HB9GZE/PhasorRadio/Hilbert Filter Calculator/IowaHills/RunTime Files/Hilbert Filter Help.rtf

Note: This program has many Up Down Arrow buttons to modify the various input values, such as Omega and BandWidth. To increase the speed of these buttons, hold down the Control button.

This program uses the root solver code from www.akiti.ca who translated it to C from the Fortran code on www.netlib.org/toms/493. Thanks to both!

Introduction
The Hilbert filter program is essentially a program for designing specialty band pass filters. Band pass filters are different from low pass, high pass, and notch filters, in that the phase of a band pass isn't predetermined at zero and pi. The phase must be zero at 0 Hz for a low pass and notch, and the phase must be zero at pi for a high pass and notch (180 deg if these filters invert the signal). Only the band pass, which has a magnitude of zero at DC and pi, allows us to set its phase to any value in the pass band.

The key to using this program is to understand the phase plots. This program displays phase in two ways, the traditional phase, and Hilbert phase. Hilbert phase is discussed in more detail below, but the diagram here shows the essence of it. Hilbert Phase is the phase of the filter's output as compared to the output of a shift register with the same delay as the filter. For a constant group delay filter, the Hilbert phase will always be a flat line in the filter's pass band.

The Hilbert Phase of a Hilbert Transform filter will be a flat 90 degrees because it has 90 degrees more phase shift than the shift register at all frequencies within its pass band.

The types of band pass filters synthesized by this program are as follows:

Standard BPF
These are the same band pass filters as generated by the Iowa Hills FIR program. Note that the Hilbert phase of these filters is zero.

The user should take note of the zeros in the coefficients for odd tap counts when the center frequency is 0.125, 0.25, 0.5, 0.75 and similar such values. Note the zeros for even tap counts when the center frequency is 0.2 and 0.6.

Phase Added Band Pass
These filters are standard band pass filters, with additional phase added. When the user selects this filter type, the program automatically switches the phase display in the Options menu to Hilbert Phase. Use the Phase Adder to set the phase to the desired value.

If the user sets the Added Phase to 90 degrees, the filter is essentially a Hilbert Transform filter. The Classic Hilbert Transform filter is a full bandwidth filter, but these filters can be any bandwidth.

For example, to create a narrow band single side band filter, set the number of taps to an odd number, and the added phase to 90 degrees. Go to the Test Bench and select Single 90 Degree SSB. The filter will suppress a narrow band in the negative frequency spectrum.

Alternatively, the user can select Matched Pair SSB on the test bench. Then the filter is used as shown here. The program is automatically generating two filters when this test is run. One with the phase shown on the main screen, and another with 90 degrees less phase. The filters used in this scheme can have any absolute phase, as long as they have a 90 degree phase difference.

You should also notice that, because the filter gains are matched, the gain of the filter (or its pass band ripple) doesn't affect the SSB performance.

Classic Hilbert Filters
The Classic Hilbert transforms synthesized by this program are the usual full bandwidth filters with a 90 degree phase shift (Hilbert Phase = 90). This filter uses a rectangular window as its prototype, where as the rest of the filters use the Raised Cosine prototype.

Differentiator Filters
The Differentiator filter also has a 90 degree phase shift, but the slope of the filter increases with frequency at 6 dB per octave. If the user wants to see the linearity of this slope, go to the options menu and select Linear Magnitude.

Mixed Band Pass Filters
An easy way to generate a dual band pass response is to simply mix a set of band pass coefficients with a local oscillator. Use the Mixer Frequency to set the separation of the two responses.

Half and 3/4 Zeros Band Pass Filters.
Another way to generate multiple band pass responses is to simply insert zeros into the coefficients. As the name implies, Half Zeros makes every other coefficient zero to generate a dual response centered at pi/2.

Frequency Domain Prototype
Like all FIR filters, these filters are based on a frequency domain prototype. This program uses the Raised Cosine prototype for all filters except the Classic Hilbert, which uses a rectangular window.

Time Domain Windows
This program has two time domain windows, the Sinc and Kaiser. The Kaiser is well documented and well known to engineers. Surprisingly however, little is said in textbooks of the Sinc window. The Sinc function would, at least intuitively, seem like the perfect window shape, and you will see that it works very well.

Hilbert Phase
This program has two ways to display phase, the traditional phase, and Hilbert Phase. Hilbert phase has nothing to do with the Hilbert Transform. It is the phase, adjusted for delay, which is the method typically used to display the phase characteristics of a Hilbert transform filter.

We have all seen the usual phase plots, and then ignored them, simply because it is virtually impossible to glean any useful information from them. As a result, we have been paying more attention to group delay plots which tell us how linear the phase is, and how long it takes for a signal to get through the device. Unfortunately however, group delay has units of time, not phase.

The Hilbert phase has units of phase. It is useful for showing us how many degrees the phase is varying from perfect linear phase across the band of interest. Like the gain of a device, we typically want the Hilbert phase to be flat in the pass band. It needs to be stressed that the Hilbert phase is not an absolute value, it is a relative value referenced to a specific phase at some point in the pass band. Then, any change in the linearity of the phase can be readily seen, and the deviation from perfect linearity is measured in units of phase.

When working with a traditional FIR filter, which is to say, a filter with a constant group delay, the Hilbert Phase will be a flat line at 0 degrees, indicating zero deviation from linear phase.

Hilbert filters also have linear phase, which explains why their Hilbert Phase is a flat line. Hilbert filters however, have an additional amount of phase shift in their pass band. Which is to say, they have more or less phase shift than a shift register of length equal to the filter's group delay. This additional amount of phase shift explains the level of Hilbert Phase.

To calculate Hilbert Phase we multiply H(s) by a time delay, as defined by this Laplace transform.

We set '-a' to the minimum group delay value in the filter's pass band. For a low pass filter, this is the group delay at 0. For a band pass filter, it is typically the group delay at band center. Removing this amount of delay has the effect of moving the filter's impulse backwards in time, and flattening the phase, as shown here. Or said a bit differently, it sets the filter's group delay to zero in the pass band.

In this first example, we show the impulse response and phase for an FIR filter. Applying the Laplace time delay to H(z) with '-a' equal to the filters group delay centers the impulse response around t = 0. Since this filter's phase is linear, the filter's Hilbert phase is a flat line.

In this example we use an Inverse Chebyshev low pass filter. Its group delay is much less than the FIR filter shown above, so the impulse response moves backwards in time less. The original phase is not linear and the Hilbert phase shows us the amount of non linearity.

As an alternative to the Hilbert phase, we can show this filter's unwrapped phase and draw a straight line to determine the amount of non linearity. The difference between the straight line and the unwrapped phase is the same as the Hilbert Phase plot.

Markers and Limit Lines
Frequency markers can be added to the plot by using the right mouse or by entering the frequency value under "Plot Options | Marker Menu" The marker can also be dragged to a new location with the mouse.

Limit Lines can also be plotted. Each line segment requires 4 values to be plotted. As such, the line segment may be defined in any order, and the upper and lower frequency values may be reversed.

The dB levels are restricted to the range of the plot; -90 dB to +10 dB.

The Marker and Limit Line definitions are saved with the design file. Also note that these definitions are swapped when doing an "Exchange Reference".
