HB9GZE/PhasorRadio/CustomSTM32H735Board/KiCADFiles/CustomSTM32H735_V2_1_Board/CustomSTM32H735_V2_1_Board/NetReport.csv

Net Code | Net Name | Pad Count | Via Count | Via Length (mm) | Track Length (mm) | Die Length (mm) | Net Length (mm) | F.Cu (mm) | In1.Cu (mm) | In2.Cu (mm) | In3.Cu (mm) | In4.Cu (mm) | B.Cu (mm)
001 | Net-(PS1-REF) | 2 | 0 | 0.0000 | 6.7280 | 0.0000 | 6.7280 | 6.7280 | 0.0000 | 0.0000 | 0.0000 | 0.0000 | 0.0000
002 | Net-(PS1-COMP) | 2 | 0 | 0.0000 | 4.4959 | 0.0000 | 4.4959 | 4.4959 | 0.0000 | 0.0000 | 0.0000 | 0.0000 | 0.0000
003 | /PG6 | 3 | 2 | 1.6290 | 26.3761 | 0.0000 | 28.0051 | 0.0000 | 0.0000 | 15.8914 | 0.0000 | 0.0000 | 10.4847
004 | Net-(IC1-BYP) | 2 | 0 | 0.0000 | 3.0452 | 0.0000 | 3.0452 | 3.0452 | 0.0000 | 0.0000 | 0.0000 | 0.0000 | 0.0000
005 | Net-(C23-Pad2) | 2 | 0 | 0.0000 | 5.9836 | 0.0000 | 5.9836 | 5.9836 | 0.0000 | 0.0000 | 0.0000 | 0.0000 | 0.0000
006 | Net-(U2A-OUT) | 4 | 0 | 0.0000 | 19.4786 | 0.0000 | 19.4786 | 19.4786 | 0.0000 | 0.0000 | 0.0000 | 0.0000 | 0.0000
007 | Net-(JDAC1-Pin_2) | 2 | 0 | 0.0000 | 9.3643 | 0.0000 | 9.3643 | 9.3643 | 0.0000 | 0.0000 | 0.0000 | 0.0000 | 0.0000
008 | /NRST | 10 | 5 | 3.8025 | 181.3871 | 0.0000 | 185.1896 | 1.0272 | 0.0000 | 22.6133 | 23.9160 | 62.2607 | 71.5699
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
