HB9GZE/PhasorRadio/CustomSTM32H735Board/CustomSTM32H735TestCode/CustomBoardSTM32H735Test/STM32H735G-DK.pdf

13/08/2024

STM32H735G-DK Project
Configuration Report

## 1. Description

### 1.1. Project

Project Name | STM32H735G-DK
Board Name | custom
Generated with: | STM32CubeMX 6.12.0
Date | 08/13/2024

### 1.2. MCU

MCU Series | STM32H7
MCU Line | STM32H725/735
MCU name | STM32H735IGKx
MCU Package | UFBGA176
MCU Pin number | 201

### 1.3. Core(s) information

Core(s) | Arm Cortex-M7

## 2. Pinout Configuration

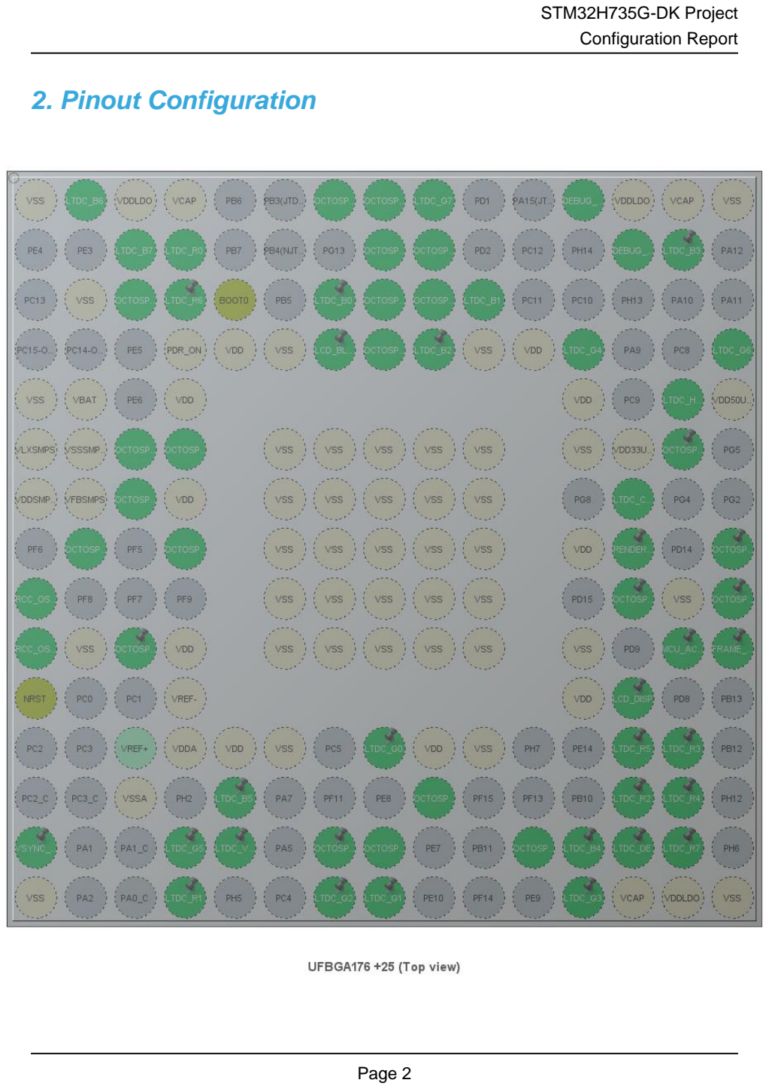
[picture p6: page 3]

## 3. Pins Configuration

Pin Number UFBGA176 | Pin Name (function after reset) | Pin Type | Alternate Function(s) | Label
A1 | VSS | Power
A2 | PB8 | I/O | LTDC_B6
A3 | VDDLDO | Power
A4 | VCAP | Power
A7 | PG11 | I/O | OCTOSPIM_P2_IO7
A8 | PG9 | I/O | OCTOSPIM_P1_IO6
A9 | PD3 | I/O | LTDC_G7
A12 | PA14(JTCK/SWCLK) | I/O | DEBUG_JTCK-SWCLK
A13 | VDDLDO | Power
A14 | VCAP | Power
A15 | VSS | Power
B3 | PB9 | I/O | LTDC_B7
B4 | PE0 | I/O | LTDC_R0
B8 | PD7 | I/O | OCTOSPIM_P1_IO7
B9 | PD5 | I/O | OCTOSPIM_P1_IO5
B13 | PA13(JTMS/SWDIO) | I/O | DEBUG_JTMS-SWDIO
B14 | PA8 | I/O | LTDC_B3
C2 | VSS | Power
C3 | PE2 | I/O | OCTOSPIM_P1_IO2
C4 | PE1 | I/O | LTDC_R6
C5 | BOOT0 | Boot
C7 | PG14 | I/O | LTDC_B0
C8 | PG10 | I/O | OCTOSPIM_P2_IO6
C9 | PD4 | I/O | OCTOSPIM_P1_IO4
C10 | PD0 | I/O | LTDC_B1
D4 | PDR_ON | Power
D5 | VDD | Power
D6 | VSS | Power
D7 | PG15 * | I/O | GPIO_Output | LCD_BL_CTRL
D8 | PG12 | I/O | OCTOSPIM_P2_NCS
D9 | PD6 | I/O | LTDC_B2
D10 | VSS | Power
D11 | VDD | Power
D12 | PH15 | I/O | LTDC_G4
D15 | PC7 | I/O | LTDC_G6
E1 | VSS | Power

Pin Number UFBGA176 | Pin Name (function after reset) | Pin Type | Alternate Function(s) | Label
E2 | VBAT | Power
E4 | VDD | Power
E12 | VDD | Power
E14 | PC6 | I/O | LTDC_HSYNC
E15 | VDD50USB | Power
F1 | VLXSMPS | Power
F2 | VSSSMPS | Power
F3 | PF1 | I/O | OCTOSPIM_P2_IO1
F4 | PF0 | I/O | OCTOSPIM_P2_IO0
F6 | VSS | Power
F7 | VSS | Power
F8 | VSS | Power
F9 | VSS | Power
F10 | VSS | Power
F12 | VSS | Power
F13 | VDD33USB | Power
F14 | PG6 | I/O | OCTOSPIM_P1_NCS
G1 | VDDSMPS | Power
G2 | VFBSMPS | Power
G3 | PF2 | I/O | OCTOSPIM_P2_IO2
G4 | VDD | Power
G6 | VSS | Power
G7 | VSS | Power
G8 | VSS | Power
G9 | VSS | Power
G10 | VSS | Power
G13 | PG7 | I/O | LTDC_CLK
H2 | PF4 | I/O | OCTOSPIM_P2_CLK
H4 | PF3 | I/O | OCTOSPIM_P2_IO3
H6 | VSS | Power
H7 | VSS | Power
H8 | VSS | Power
H9 | VSS | Power
H10 | VSS | Power
H12 | VDD | Power
H13 | PG3 * | I/O | GPIO_Output | RENDER_TIME
H15 | PD13 | I/O | OCTOSPIM_P1_IO3
J1 | PH0-OSC_IN | I/O | RCC_OSC_IN
J6 | VSS | Power

Pin Number UFBGA176 | Pin Name (function after reset) | Pin Type | Alternate Function(s) | Label
J7 | VSS | Power
J8 | VSS | Power
J9 | VSS | Power
J10 | VSS | Power
J13 | PD11 | I/O | OCTOSPIM_P1_IO0
J14 | VSS | Power
J15 | PD12 | I/O | OCTOSPIM_P1_IO1
K1 | PH1-OSC_OUT | I/O | RCC_OSC_OUT
K2 | VSS | Power
K3 | PF10 | I/O | OCTOSPIM_P1_CLK
K4 | VDD | Power
K6 | VSS | Power
K7 | VSS | Power
K8 | VSS | Power
K9 | VSS | Power
K10 | VSS | Power
K12 | VSS | Power
K14 | PB15 * | I/O | GPIO_Output | MCU_ACTIVE
K15 | PB14 * | I/O | GPIO_Output | FRAME_RATE
L1 | NRST | Reset
L4 | VREF- | Power
L12 | VDD | Power
L13 | PD10 * | I/O | GPIO_Output | LCD_DISP
M4 | VDDA | Power
M5 | VDD | Power
M6 | VSS | Power
M8 | PB1 | I/O | LTDC_G0
M9 | VDD | Power
M10 | VSS | Power
M13 | PH11 | I/O | LTDC_R5
M14 | PH9 | I/O | LTDC_R3
N3 | VSSA | Power
N5 | PA3 | I/O | LTDC_B5
N9 | PG1 | I/O | OCTOSPIM_P2_IO5
N13 | PH8 | I/O | LTDC_R2
N14 | PH10 | I/O | LTDC_R4
P1 | PA0 * | I/O | GPIO_Output | VSYNC_FREQ
P4 | PH4 | I/O | LTDC_G5
P5 | PA4 | I/O | LTDC_VSYNC

Pin Number UFBGA176 | Pin Name (function after reset) | Pin Type | Alternate Function(s) | Label
P7 | PB2 | I/O | OCTOSPIM_P1_DQS
P8 | PG0 | I/O | OCTOSPIM_P2_IO4
P11 | PF12 | I/O | OCTOSPIM_P2_DQS
P12 | PE12 | I/O | LTDC_B4
P13 | PE13 | I/O | LTDC_DE
P14 | PE15 | I/O | LTDC_R7
R1 | VSS | Power
R4 | PH3 | I/O | LTDC_R1
R7 | PA6 | I/O | LTDC_G2
R8 | PB0 | I/O | LTDC_G1
R12 | PE11 | I/O | LTDC_G3
R13 | VCAP | Power
R14 | VDDLDO | Power
R15 | VSS | Power

* The pin is affected with an I/O function

## 4. Clock Tree Configuration

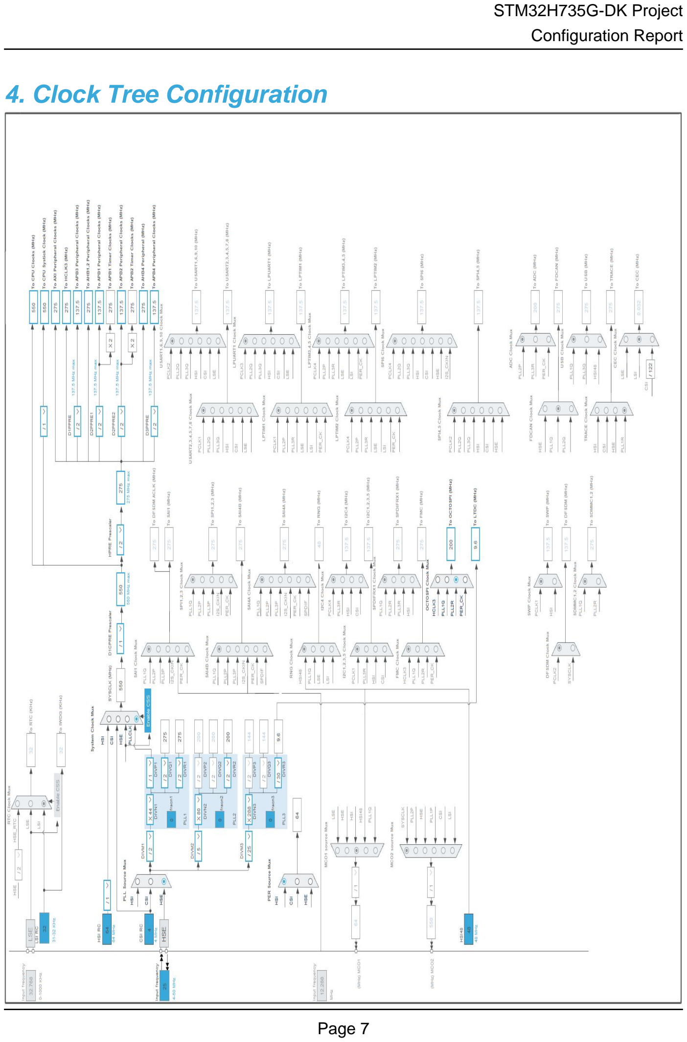
[picture p7: page 8]

## 1. Power Consumption Calculator report

### 1.1. Microcontroller Selection

Series | STM32H7
Line | STM32H725/735
MCU | STM32H735IGKx
Datasheet | DS13312_Rev1

### 1.2. Parameter Selection

Temperature | 25
Vdd | 3.0

### 1.3. Battery Selection

Battery | Alkaline(9V)
Capacity | 625.0 mAh
Self Discharge | 0.3 %/month
Nominal Voltage | 9.0 V
Max Cont Current | 200.0 mA
Max Pulse Current | 0.0 mA
Cells in series | 1
Cells in parallel | 1

### 1.4. Sequence

Step | Step1 | Step2
Mode | RUN | STOP
Vdd | 3.0 | 3.0
Voltage Source | Battery | Battery
Range | VOS0: Scale0/Boost | SVOS3: System-Scale3/SMPS-LDO
D1 Mode | DRUN | DSTANDBY
D2 Mode | DRUN | DSTANDBY
D3 Mode | DRUN | DSTOP
Fetch Type | SRAM1/FlashMode-ON/Cache | NA
CPU Frequency | 550 MHz | 0 Hz
Clock Configuration | HSE BYP PLL | LSE LowDrive RTC
Clock Source Frequency | 8 MHz | 32.768 kHz
Peripherals
Additional Cons. | 0 mA | 0 mA
Average Current | 150 mA | 2.5 µA
Duration | 0.1 ms | 0.9 ms
DMIPS | 1177.0 | 0.0
Ta Max | 107.9 | 125
Category | In DS Table | In DS Table

### 1.5. Results

Sequence Time | 1 ms | Average Current | 15 mA
Battery Life | 1 day, 17 hours | Average DMIPS | 1177.0 DMIPS

### 1.6. Chart


## 2. Software Project

### 2.1. Project Settings

Name | Value
Project Name | STM32H735G-DK
Project Folder | C:\ProjectsOnC\PhasorRadio\CustomSTM32H735Board\CustomSTM32H735Tes
Toolchain / IDE | STM32CubeIDE
Firmware Package Name and Version | STM32Cube FW_H7 V1.11.2
Application Structure | Advanced
Generate Under Root | No
Do not generate the main() | No
Minimum Heap Size | 0x1000
Minimum Stack Size | 0x1000

### 2.2. Code Generation Settings

Name | Value
STM32Cube MCU packages and embedded software | Copy only the necessary library files
Generate peripheral initialization as a pair of '.c/.h' files | No
Backup previously generated files when re-generating | No
Keep User Code when re-generating | Yes
Delete previously generated files when not re-generated | Yes
Set all free pins as analog (to optimize the power consumption) | No
Enable Full Assert | No

### 2.3. Advanced Settings - Generated Function Calls

Rank | Function Name | Peripheral Instance Name
1 | MX_GPIO_Init | GPIO
2 | SystemClock_Config | RCC
3 | MX_CRC_Init | CRC
4 | MX_DMA2D_Init | DMA2D
5 | MX_LTDC_Init | LTDC
6 | MX_OCTOSPI1_Init | OCTOSPI1
7 | MX_OCTOSPI2_Init | OCTOSPI2
8 | MX_LIBJPEG_Init | LIBJPEG
10 | MX_TouchGFX_Init | STMicroelectronics.X-CUBE-TOUCHGFX.4.23.0
11 | MX_TouchGFX_Process | STMicroelectronics.X-CUBE-TOUCHGFX.4.23.0

## 3. Peripherals and Middlewares Configuration

### 3.1. CORTEX_M7

3.1.1. Parameter Settings:

Speculation default mode Settings:

Speculation default mode | Disabled
Cortex Interface Settings:
CPU ICache | Enabled *
CPU DCache | Enabled *
Cortex Memory Protection Unit Control Settings:
MPU Control Mode | Background Region Privileged accesses only + MPU Disabled during hard fault, NMI and FAULTMASK handlers *

Cortex Memory Protection Unit Region 0 Settings:

MPU Region | Enabled *
MPU Region Base Address | 0x24000000 *
MPU Region Size | 512KB *
MPU SubRegion Disable | 0x0 *
MPU TEX field level | level 0
MPU Access Permission | ALL ACCESS PERMITTED *
MPU Instruction Access | DISABLE *
MPU Shareability Permission | DISABLE
MPU Cacheable Permission | ENABLE *
MPU Bufferable Permission | ENABLE *
Cortex Memory Protection Unit Region 1 Settings:
MPU Region | Enabled *
MPU Region Base Address | 0x70000000 *
MPU Region Size | 512MB *
MPU SubRegion Disable | 0x0 *
MPU TEX field level | level 0
MPU Access Permission | ALL ACCESS NOT PERMITTED
MPU Instruction Access | DISABLE *
MPU Shareability Permission | DISABLE
MPU Cacheable Permission | DISABLE
MPU Bufferable Permission | DISABLE
Cortex Memory Protection Unit Region 2 Settings:
MPU Region | Enabled *
MPU Region Base Address | 0x70000000 *

MPU Region Size | 8MB *
MPU SubRegion Disable | 0x0 *
MPU TEX field level | level 0
MPU Access Permission | ALL ACCESS PERMITTED *
MPU Instruction Access | DISABLE *
MPU Shareability Permission | DISABLE
MPU Cacheable Permission | ENABLE *
MPU Bufferable Permission | ENABLE *
Cortex Memory Protection Unit Region 3 Settings:
MPU Region | Enabled *
MPU Region Base Address | 0x90000000 *
MPU Region Size | 512MB *
MPU SubRegion Disable | 0x0 *
MPU TEX field level | level 0
MPU Access Permission | ALL ACCESS NOT PERMITTED
MPU Instruction Access | DISABLE *
MPU Shareability Permission | DISABLE
MPU Cacheable Permission | DISABLE
MPU Bufferable Permission | DISABLE
Cortex Memory Protection Unit Region 4 Settings:
MPU Region | Enabled *
MPU Region Base Address | 0x90000000 *
MPU Region Size | 64MB *
MPU SubRegion Disable | 0x0 *
MPU TEX field level | level 0
MPU Access Permission | ALL ACCESS PERMITTED *
MPU Instruction Access | DISABLE *
MPU Shareability Permission | DISABLE
MPU Cacheable Permission | ENABLE *
MPU Bufferable Permission | DISABLE
Cortex Memory Protection Unit Region 5 Settings:
MPU Region | Disabled
Cortex Memory Protection Unit Region 6 Settings:
MPU Region | Disabled
Cortex Memory Protection Unit Region 7 Settings:
MPU Region | Disabled
Cortex Memory Protection Unit Region 8 Settings:
MPU Region | Disabled

Cortex Memory Protection Unit Region 9 Settings:

MPU Region | Disabled
Cortex Memory Protection Unit Region 10 Settings:
MPU Region | Disabled
Cortex Memory Protection Unit Region 11 Settings:
MPU Region | Disabled
Cortex Memory Protection Unit Region 12 Settings:
MPU Region | Disabled
Cortex Memory Protection Unit Region 13 Settings:
MPU Region | Disabled
Cortex Memory Protection Unit Region 14 Settings:
MPU Region | Disabled
Cortex Memory Protection Unit Region 15 Settings:
MPU Region | Disabled

### 3.2. CRC

mode: Activated
3.2.1. Parameter Settings:

Basic Parameters:

Default Polynomial State | Enable
Default Init Value State | Enable
Advanced Parameters:
Input Data Inversion Mode | None
Output Data Inversion Mode | Disable
Input Data Format | Bytes

### 3.3. DEBUG

Debug: Serial Wire

### 3.4. DMA2D

mode: Activated
3.4.1. Parameter Settings:

Basic Parameters:
Transfer Mode | Register to Memory *

Color Mode | RGB888 *
Output Offset | 0

### 3.5. LTDC

Display Type: RGB888 (24 bits)
3.5.1. Parameter Settings:

Synchronization for Width:

Horizontal Synchronization Width | 41 *
Horizontal Back Porch | 13 *
Active Width | 480 *
Horizontal Front Porch | 32 *
HSync Width | 40
Accumulated Horizontal Back Porch Width | 53
Accumulated Active Width | 533
Total Width | 565
Synchronization for Height:
Vertical Synchronization Height | 10 *
Vertical Back Porch | 2
Active Height | 272 *
Vertical Front Porch | 2
VSync Height | 9
Accumulated Vertical Back Porch Height | 11
Accumulated Active Height | 283
Total Height | 285
Signal Polarity:
Horizontal Synchronization Polarity | Active Low
Vertical Synchronization Polarity | Active Low
Data Enable Polarity | Active Low
Pixel Clock Polarity | Normal Input
Layer Default Color:
Red | 0
Green | 0
Blue | 0
3.5.2. Layer Settings:

Layer Default Color:

Layer 0 - Alpha | 0
Layer 0 - Blue | 0
Layer 0 - Green | 0
Layer 0 - Red | 0
Number of Layers:
Number of Layers | 1 layer *
Windows Position:
Layer 0 - Window Horizontal Start | 0
Layer 0 - Window Horizontal Stop | 480 *
Layer 0 - Window Vertical Start | 0
Layer 0 - Window Vertical Stop | 272 *
Pixel Parameters:
Layer 0 - Pixel Format | RGB888 *
Blending:
Layer 0 - Alpha constant for blending | 255 *
Layer 0 - Blending Factor1 | Alpha constant
Layer 0 - Blending Factor2 | Alpha constant
Frame Buffer:
Layer 0 - Color Frame Buffer Start Adress | 0x70000000 *
Layer 0 - Color Frame Buffer Line Length (Image Width) | 480 *
Layer 0 - Color Frame Buffer Number of Lines (Image Height) | 272 *

### 3.6. MEMORYMAP

mode: Activated

### 3.7. OCTOSPI1

Mode: Octo SPI
Clock: Port1 CLK
Chip Select: Port1 NCS
Data Strobe: Port1 DQS (RWDS) Data [3:0]: Port1 IO[3:0]
Data [7:4]: Port1 IO[7:4]
3.7.1. Parameter Settings:

Generic:

Fifo Threshold | 4 *
Dual Quad mode | Disable
Memory Type | Macronix *
Device Size | 32
Device Type | Not defined
Chip Select High Time | 2 *
Free Running Clock | Disable
Clock Mode | Low
Wrap Size | Not Supported
Clock Prescaler | 2 *
Sample Shifting | None
Delay Hold Quarter Cycle | Disable
Chip Select Boundary | 0
Delay Block | Disable
Maximum Transfer | 0
Refresh Rate | 0

### 3.8. OCTOSPI2

Mode: HyperBus(TM)
Clock: Port2 CLK
Chip Select: Port2 NCS
Data Strobe: Port2 DQS (RWDS) Data [3:0]: Port2 IO[3:0]
Data [7:4]: Port2 IO[7:4]
3.8.1. Parameter Settings:

Generic:

Fifo Threshold | 4 *
Dual Quad mode | Disable
Memory Type | HyperBus(TM)
Device Size | 24 *
Device Type | Not defined
Chip Select High Time | 4 *
Free Running Clock | Disable
Clock Mode | Low
Wrap Size | Not Supported
Clock Prescaler | 2 *
Sample Shifting | None

Delay Hold Quarter Cycle | Enable *
Chip Select Boundary | 23 *
Delay Block | Enable *
Maximum Transfer | 0
Refresh Rate | 400 *
HyperBus(TM):
RW Recovery Time | 3 *
Access Time | 6 *
Write Access Latency | Enable *
Latency Mode | Fixed *

### 3.9. RCC

High Speed Clock (HSE): Crystal/Ceramic Resonator
3.9.1. Parameter Settings:

Power Parameters:

SupplySource | PWR_DIRECT_SMPS_SUPPLY
Power Regulator Voltage Scale | Power Regulator Voltage Scale 0
RCC Parameters:
TIM Prescaler Selection | Disabled
HSE Startup Timout Value (ms) | 100
LSE Startup Timout Value (ms) | 5000
CSI Calibration Value | 16
HSI Calibration Value | 64
System Parameters:
VDD voltage (V) | 3.3
Flash Latency(WS) | 3 WS (4 CPU cycle)
PLL range Parameters:
PLL1 input frequency range | Between 8 and 16 MHz
PLL2 input frequency range | Between 4 and 8 MHz
PLL3 input frequency range | Between 1 and 2 MHz
PLL1 clock Output range | Wide VCO range
PLL2 clock Output range | Wide VCO range
PLL3 clock Output range | MEDIUM VCO range

### 3.10. SYS

Timebase Source: TIM6

### 3.11. FREERTOS

Interface: CMSIS_V2
3.11.1. Config parameters:

API:

FreeRTOS API | CMSIS v2
Versions:
FreeRTOS version | 10.3.1
CMSIS-RTOS version | 2.00
MPU/FPU:
ENABLE_MPU | Disabled
ENABLE_FPU | Disabled
Kernel settings:
USE_PREEMPTION | Enabled
CPU_CLOCK_HZ | SystemCoreClock
TICK_RATE_HZ | 1000
MAX_PRIORITIES | 56
MINIMAL_STACK_SIZE | 128
MAX_TASK_NAME_LEN | 16
USE_16_BIT_TICKS | Disabled
IDLE_SHOULD_YIELD | Enabled
USE_MUTEXES | Enabled
USE_RECURSIVE_MUTEXES | Enabled
USE_COUNTING_SEMAPHORES | Enabled
QUEUE_REGISTRY_SIZE | 8
USE_APPLICATION_TASK_TAG | Enabled *
ENABLE_BACKWARD_COMPATIBILITY | Enabled
USE_PORT_OPTIMISED_TASK_SELECTION | Disabled
USE_TICKLESS_IDLE | Disabled
USE_TASK_NOTIFICATIONS | Enabled
RECORD_STACK_HIGH_ADDRESS | Disabled
Memory management settings:
Memory Allocation | Dynamic / Static
TOTAL_HEAP_SIZE | 75000 *
Memory Management scheme | heap_4
Hook function related definitions:
USE_IDLE_HOOK | Enabled *

USE_TICK_HOOK | Disabled
USE_MALLOC_FAILED_HOOK | Disabled
USE_DAEMON_TASK_STARTUP_HOOK | Disabled
CHECK_FOR_STACK_OVERFLOW | Disabled
Run time and task stats gathering related definitions:
GENERATE_RUN_TIME_STATS | Disabled
USE_TRACE_FACILITY | Enabled
USE_STATS_FORMATTING_FUNCTIONS | Disabled
Co-routine related definitions:
USE_CO_ROUTINES | Disabled
MAX_CO_ROUTINE_PRIORITIES | 2
Software timer definitions:
USE_TIMERS | Enabled
TIMER_TASK_PRIORITY | 2
TIMER_QUEUE_LENGTH | 10
TIMER_TASK_STACK_DEPTH | 256
Interrupt nesting behaviour configuration:
LIBRARY_LOWEST_INTERRUPT_PRIORITY | 15
LIBRARY_MAX_SYSCALL_INTERRUPT_PRIORITY | 5
Added with 10.2.1 support:
MESSAGE_BUFFER_LENGTH_TYPE | size_t
USE_POSIX_ERRNO | Disabled
CMSIS-RTOS V2 flags:
USE_OS2_THREAD_SUSPEND_RESUME | Enabled
USE_OS2_THREAD_ENUMERATE | Enabled
USE_OS2_EVENTFLAGS_FROM_ISR | Enabled
USE_OS2_THREAD_FLAGS | Enabled
USE_OS2_TIMER | Enabled
USE_OS2_MUTEX | Enabled
3.11.2. Include parameters:

Include definitions:

vTaskPrioritySet | Enabled
uxTaskPriorityGet | Enabled
vTaskDelete | Enabled
vTaskCleanUpResources | Disabled
vTaskSuspend | Enabled
vTaskDelayUntil | Enabled
vTaskDelay | Enabled
xTaskGetSchedulerState | Enabled

xTaskResumeFromISR | Enabled
xQueueGetMutexHolder | Enabled
xSemaphoreGetMutexHolder | Disabled
pcTaskGetTaskName | Disabled
uxTaskGetStackHighWaterMark | Enabled
xTaskGetCurrentTaskHandle | Enabled
eTaskGetState | Enabled
xEventGroupSetBitFromISR | Disabled
xTimerPendFunctionCall | Enabled
xTaskAbortDelay | Disabled
xTaskGetHandle | Disabled
uxTaskGetStackHighWaterMark2 | Disabled
3.11.3. Advanced settings:

Newlib settings (see parameter description first):

USE_NEWLIB_REENTRANT | Enabled *
Project settings (see parameter description first):
Use FW pack heap file | Enabled

### 3.12. LIBJPEG

mode: Enabled
3.12.1. Config parameters:

Version:

LIBJPEG version | 8d
MW configuration:
Data Stream management type | Stdio
FREERTOS | Enabled
HAVE_BOOLEAN | Undefined
General Settings:
Use FREERTOS Memory Allocator | Enabled
RGB scanline format:
RGB_ORDERING | BGR *

### 3.13. STMicroelectronics.X-CUBE-TOUCHGFX.4.23.0

mode: GraphicsJjApplication
3.13.1. TouchGFX Generator:

Display:
Interface | Parallel RGB (LTDC) *
Framebuffer Pixel Format (LTDC) | RGB888
Width (LTDC) | 480
Height (LTDC) | 272
Framebuffer Strategy | Double Buffer *
Buffer Location | By Allocation
Driver:
Application Tick Source | LTDC *
Use DMA2D Accelerator (ChromART) | Yes *
Real-Time Operating System | CMSIS_RTOS_V2
Additional Features:
Vector Rendering | Software *
Vector Font Rendering | Enabled *
Video Decoding:
Type | Software *
Concurrent videos | 1
Strategy | Single buffer *
Decode Format | RGB888 *
Buffer Width | 480 *
Buffer Height | 272 *

* User modified value

## 4. System Configuration

### 4.1. GPIO configuration

IP | Pin | Signal | GPIO mode | GPIO pull/up pull down | Max Speed | User Label
DEBUG | PA14(JTCK/ SWCLK) | DEBUG_JTCK-SWCLK | n/a | n/a | n/a
| PA13(JTMS/ SWDIO) | DEBUG_JTMS-SWDIO | n/a | n/a | n/a
| | | | | *
| PD3 | LTDC_G7 | Alternate Function Push Pull | No pull-up and no pull-down | Very High *
| PB9 | LTDC_B7 | Alternate Function Push Pull | No pull-up and no pull-down | Very High *
| PE0 | LTDC_R0 | Alternate Function Push Pull | No pull-up and no pull-down | Very High *
| PA8 | LTDC_B3 | Alternate Function Push Pull | No pull-up and no pull-down | Very High *
| PE1 | LTDC_R6 | Alternate Function Push Pull | No pull-up and no pull-down | Very High *
| PG14 | LTDC_B0 | Alternate Function Push Pull | No pull-up and no pull-down | Very High *
| PD0 | LTDC_B1 | Alternate Function Push Pull | No pull-up and no pull-down | Very High *
| PD6 | LTDC_B2 | Alternate Function Push Pull | No pull-up and no pull-down | Very High *
| PH15 | LTDC_G4 | Alternate Function Push Pull | No pull-up and no pull-down | Very High *
| PC7 | LTDC_G6 | Alternate Function Push Pull | No pull-up and no pull-down | Very High *
| PC6 | LTDC_HSYNC | Alternate Function Push Pull | No pull-up and no pull-down | Very High *
| PG7 | LTDC_CLK | Alternate Function Push Pull | No pull-up and no pull-down | Very High *
| PB1 | LTDC_G0 | Alternate Function Push Pull | No pull-up and no pull-down | Very High *
| PH11 | LTDC_R5 | Alternate Function Push Pull | No pull-up and no pull-down | Very High *
LTDC | PB8 | LTDC_B6 | Alternate Function Push Pull | No pull-up and no pull-down | Very High

IP | Pin | Signal | GPIO mode | GPIO pull/up pull down

Max
Speed

User Label

PH9 | LTDC_R3 | Alternate Function Push Pull | No pull-up and no pull-down | Very High
*
PA3 | LTDC_B5 | Alternate Function Push Pull | No pull-up and no pull-down | Very High
*
PH8 | LTDC_R2 | Alternate Function Push Pull | No pull-up and no pull-down | Very High
*
PH10 | LTDC_R4 | Alternate Function Push Pull | No pull-up and no pull-down | Very High
*
PH4 | LTDC_G5 | Alternate Function Push Pull | No pull-up and no pull-down | Very High
*
PA4 | LTDC_VSYNC Alternate Function Push Pull | No pull-up and no pull-down | Very High
*
PE12 | LTDC_B4 | Alternate Function Push Pull | No pull-up and no pull-down | Very High
*
PE13 | LTDC_DE | Alternate Function Push Pull | No pull-up and no pull-down | Very High
*
PE15 | LTDC_R7 | Alternate Function Push Pull | No pull-up and no pull-down | Very High
*
PH3 | LTDC_R1 | Alternate Function Push Pull | No pull-up and no pull-down | Very High
*
PA6 | LTDC_G2 | Alternate Function Push Pull | No pull-up and no pull-down | Very High
*
PB0 | LTDC_G1 | Alternate Function Push Pull | No pull-up and no pull-down | Very High
*
PE11 | LTDC_G3 | Alternate Function Push Pull | No pull-up and no pull-down | Very High
*
OCTOSPI1 | PG9 | OCTOSPIM_P1_
| IO6 | Alternate Function Push Pull | No pull-up and no pull-down | Very High
PD7 | OCTOSPIM_P1_ IO7 | Alternate Function Push Pull | No pull-up and no pull-down | Very High
PD5 | OCTOSPIM_P1_ IO5 | Alternate Function Push Pull | No pull-up and no pull-down | Very High
PE2 | OCTOSPIM_P1_ IO2 | Alternate Function Push Pull | No pull-up and no pull-down | Very High
PD4 | OCTOSPIM_P1_ IO4 | Alternate Function Push Pull | No pull-up and no pull-down | Very High
PG6 | OCTOSPIM_P1_ NCS | Alternate Function Push Pull | No pull-up and no pull-down | Very High
PD13 | OCTOSPIM_P1_ | Alternate Function Push Pull | No pull-up and no pull-down | Very High

IP | Pin | Signal | GPIO mode | GPIO pull/up pull down

Max
Speed

User Label

IO3
| PD11 | OCTOSPIM_P1_ IO0 | Alternate Function Push Pull | No pull-up and no pull-down | Very High
| PD12 | OCTOSPIM_P1_ IO1 | Alternate Function Push Pull | No pull-up and no pull-down | Very High
| PF10 | OCTOSPIM_P1_ CLK | Alternate Function Push Pull | No pull-up and no pull-down | Very High
| PB2 | OCTOSPIM_P1_ DQS | Alternate Function Push Pull | No pull-up and no pull-down | Very High
OCTOSPI2 | PG11 | OCTOSPIM_P2_ IO7 | Alternate Function Push Pull | No pull-up and no pull-down | Very High
| PG10 | OCTOSPIM_P2_ IO6 | Alternate Function Push Pull | No pull-up and no pull-down | Very High
| PG12 | OCTOSPIM_P2_ NCS | Alternate Function Push Pull | No pull-up and no pull-down | Very High
| PF1 | OCTOSPIM_P2_ IO1 | Alternate Function Push Pull | No pull-up and no pull-down | Very High
| PF0 | OCTOSPIM_P2_ IO0 | Alternate Function Push Pull | No pull-up and no pull-down | Very High
| PF2 | OCTOSPIM_P2_ IO2 | Alternate Function Push Pull | No pull-up and no pull-down | Very High
| PF4 | OCTOSPIM_P2_ CLK | Alternate Function Push Pull | No pull-up and no pull-down | Very High
| PF3 | OCTOSPIM_P2_ IO3 | Alternate Function Push Pull | No pull-up and no pull-down | Very High
| PG1 | OCTOSPIM_P2_ IO5 | Alternate Function Push Pull | No pull-up and no pull-down | Very High
| PG0 | OCTOSPIM_P2_ IO4 | Alternate Function Push Pull | No pull-up and no pull-down | Very High
| PF12 | OCTOSPIM_P2_ DQS | Alternate Function Push Pull | No pull-up and no pull-down | Very High
RCC | PH0- OSC_IN | RCC_OSC_IN | n/a | n/a | n/a
| PH1- OSC_OUT | RCC_OSC_OUT | n/a | n/a | n/a
GPIO | PG15 | GPIO_Output | Output Push Pull | No pull-up and no pull-down | Low | LCD_BL_CTRL
| PG3 | GPIO_Output | Output Push Pull | No pull-up and no pull-down | Very High
*
| | | | | | RENDER_TIME
| PB15 | GPIO_Output | Output Push Pull | No pull-up and no pull-down | Very High
*
| | | | | | MCU_ACTIVE
| PB14 | GPIO_Output | Output Push Pull | No pull-up and no pull-down | Very High
*
| | | | | | FRAME_RATE
| PD10 | GPIO_Output | Output Push Pull | No pull-up and no pull-down | Low | LCD_DISP

IP | Pin | Signal | GPIO mode | GPIO pull/up pull down | Max Speed | User Label
| PA0 | GPIO_Output | Output Push Pull | No pull-up and no pull-down | Very High * | VSYNC_FREQ

### 4.2. DMA configuration

nothing configured in DMA service

### 4.3. BDMA configuration

nothing configured in DMA service

### 4.4. MDMA configuration

nothing configured in DMA service

### 4.5. NVIC configuration

4.5.1. NVIC
Interrupt Table | Enable | Preenmption Priority | SubPriority
Non maskable interrupt | true | 0 | 0
Hard fault interrupt | true | 0 | 0
Memory management fault | true | 0 | 0
Pre-fetch fault, memory access fault | true | 0 | 0
Undefined instruction or illegal state | true | 0 | 0
System service call via SWI instruction | true | 0 | 0
Debug monitor | true | 0 | 0
Pendable request for system service | true | 15 | 0
System tick timer | true | 15 | 0
TIM6 global interrupt, DAC1_CH1 and DAC1_CH2 underrun error interrupts | true | 0 | 0
LTDC global interrupt | true | 5 | 0
DMA2D global interrupt | true | 5 | 0
PVD/AVD through EXTI Line detection Interrupt | | unused
Flash global interrupt | | unused
RCC global interrupt | | unused
FPU global interrupt | | unused
LTDC Error global Interrupt | | unused
OCTOSPI1 global interrupt | | unused
HSEM1 global interrupt | | unused
OCTOSPI2 global interrupt | | unused
4.5.2. NVIC Code generation

Enabled interrupt Table Select for init
sequence ordering
| | Generate IRQ
| | handler | Call HAL handler
Non maskable interrupt | false | true | false
Hard fault interrupt | false | true | false
Memory management fault | false | true | false
Pre-fetch fault, memory access fault | false | true | false
Undefined instruction or illegal state | false | true | false
System service call via SWI instruction | false | false | false
Debug monitor | false | true | false
Pendable request for system service | false | false | false
System tick timer | false | false | true
TIM6 global interrupt, DAC1_CH1 and DAC1_CH2 underrun error interrupts | false | true | true
LTDC global interrupt | false | true | true

Enabled interrupt Table | Select for init sequence ordering | Generate IRQ handler | Call HAL handler
DMA2D global interrupt | false | true | true

* User modified value

## 5. System Views

5.1. Category view
5.1.1. Current

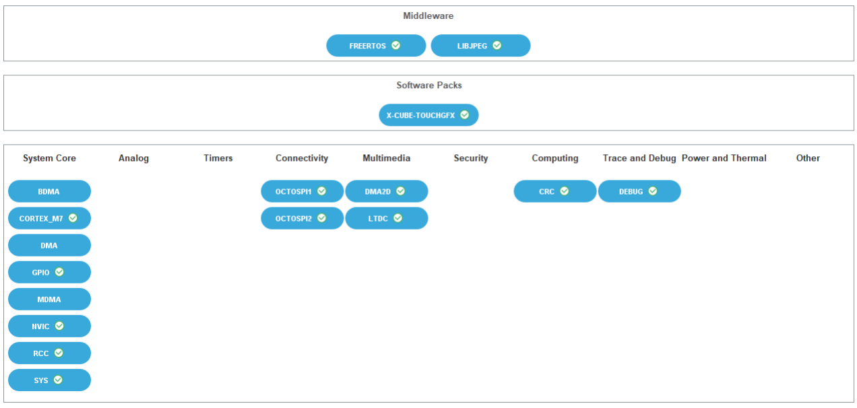
[picture p8: figure]

## 6. Software Pack Report

### 6.1. Software Pack selected

Vendor | Name | Version | Component
STMicroelectronic s | X-CUBE-TOUCHGFX | 4.23.0 | Class : Graphics Group : Application Variant : TouchGFX Generator Version : 4.23.0

## 7. Docs & Resources

Type | Link
BSDL files | https://www.st.com/resource/en/bsdl_model/stm32h7_bsdl.zip
IBIS models | https://www.st.com/resource/en/ibis_model/stm32h7_ibis.zip
System View Description | https://www.st.com/resource/en/svd/stm32h7-svd.zip
System View Description | https://www.st.com/resource/en/svd/stm32h7rs-svd.zip
Presentations | https://www.st.com/resource/en/product_presentation/microcontrollers_stm32h7_series_product_overview.pdf
Presentations | https://www.st.com/resource/en/product_presentation/stm32-stm8_embedded_software_solutions.pdf
Presentations | https://www.st.com/resource/en/product_presentation/stm32_eval-tools_portfolio.pdf
Presentations | https://www.st.com/resource/en/product_presentation/stm32_stm8_functi onal-safety-packages.pdf
Presentations | https://www.st.com/resource/en/product_presentation/stm32-stm8_software_development_tools.pdf
Presentations | https://www.st.com/resource/en/product_presentation/microcontrollers_stm32h72x-3x_line_product-overview.pdf
Presentations | https://www.st.com/resource/en/product_presentation/microcontrollers-stm32-family-overview.pdf
Presentations | https://www.st.com/resource/en/product_presentation/microcontrollers-stm32h7rs-lines-overview.pdf
Brochures | https://www.st.com/resource/en/brochure/brstm32h7.pdf
Brochures | https://www.st.com/resource/en/brochure/products-and-solutions-for-plcs-and-smart-i-os.pdf
Flyers | https://www.st.com/resource/en/flyer/flstm32nucleo.pdf
Flyers | https://www.st.com/resource/en/flyer/flstm32trust.pdf
Flyers | https://www.st.com/resource/en/flyer/flstm32h7rs.pdf
Application Notes | https://www.st.com/resource/en/application_note/an1709-emc-design-

| guide-for-stm8-stm32-and-legacy-mcus-stmicroelectronics.pdf
Application Notes | https://www.st.com/resource/en/application_note/an2606-stm32-microcontroller-system-memory-boot-mode-stmicroelectronics.pdf
Application Notes | https://www.st.com/resource/en/application_note/an2639-soldering-recommendations-and-package-information-for-leadfree-ecopack-mcus-and-mpus-stmicroelectronics.pdf
Application Notes | https://www.st.com/resource/en/application_note/an3126-audio-and-waveform-generation-using-the-dac-in-stm32-products-stmicroelectronics.pdf
Application Notes | https://www.st.com/resource/en/application_note/an3155-usart-protocol-used-in-the-stm32-bootloader-stmicroelectronics.pdf
Application Notes | https://www.st.com/resource/en/application_note/an3156-usb-dfu-protocol-used-in-the-stm32-bootloader-stmicroelectronics.pdf
Application Notes | https://www.st.com/resource/en/application_note/an4221-i2c-protocol-used-in-the-stm32-bootloader-stmicroelectronics.pdf
Application Notes | https://www.st.com/resource/en/application_note/an4229-how-to-implement-a-vocoder-solution-using-stm32-microcontrollers-stmicroelectronics.pdf
Application Notes | https://www.st.com/resource/en/application_note/an4286-spi-protocol-used-in-the-stm32-bootloader-stmicroelectronics.pdf
Application Notes | https://www.st.com/resource/en/application_note/an4566-extending-the-dac-performance-of-stm32-microcontrollers-stmicroelectronics.pdf
Application Notes | https://www.st.com/resource/en/application_note/an4655-virtually-increasing-the-number-of-serial-communication-peripherals-in-stm32-applications-stmicroelectronics.p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
Application Notes | https://www.st.com/resource/en/application_note/an4750-handling-of-soft-errors-in-stm32-applications-stmicroelectronics.pdf
Application Notes | https://www.st.com/resource/en/application_note/an4776-generalpurpose-timer-cookbook-for-stm32-microcontrollers-stmicroelectronics.pdf
Application Notes | https://www.st.com/resource/en/application_note/an4803-highspeed-si-simulations-using-ibis-and-boardlevel-simulations-using-hyperlynx-si-on-stm32-mcus-and-mpus-stmic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
Application Notes | https://www.st.com/resource/en/application_note/an4839-level-1-cache-

| on-stm32f7-series-and-stm32h7-series-stmicroelectronics.pdf
Application Notes | https://www.st.com/resource/en/application_note/an4891-stm32h72x-stm32h73x-and-singlecore-stm32h74x75x-system-architecture-and-performance-stmicroelectronics.pdf
Application Notes | https://www.st.com/resource/en/application_note/an4989-stm32-microcontroller-debug-toolbox-stmicroelectronics.pdf
Application Notes | https://www.st.com/resource/en/application_note/an4990-getting-started-with-sigmadelta-digital-interface-on-applicable-stm32-microcontrollers-stmicroelectronics.pdf
Application Notes | https://www.st.com/resource/en/application_note/an5020-digital-camera-interface-dcmi-on-stm32-mcus-stmicroelectronics.pdf
Application Notes | https://www.st.com/resource/en/application_note/an5027-interfacing-pdm-digital-microphones-using-stm32-mcus-and-mpus-stmicroelectronics.pdf
Application Notes | https://www.st.com/resource/en/application_note/an5033-stm32cube-mcu-package-examples-for-stm32h7-series-stmicroelectronics.pdf
Application Notes | https://www.st.com/resource/en/application_note/an5073-receiving-spdif-audio-stream-with-the-stm32f4f7h7-series-stmicroelectronics.pdf
Application Notes | https://www.st.com/resource/en/application_note/an5281-how-to-use-otfdec-for-encryptiondecryption-in-trusted-environment-on-stm32h7bxxx-and-stm32h73xx-microcontrolle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
Application Notes | https://www.st.com/resource/en/application_note/an5337-stm32h7-series-lifetime-estimates-stmicroelectronics.pdf
Application Notes | https://www.st.com/resource/en/application_note/an5419-getting-started-with-stm32h723733-stm32h725735-and-stm32h730-value-line-hardware-development-stmicroelectronic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
Application Notes | https://www.st.com/resource/en/application_note/an4899-stm32-microcontroller-gpio-hardware-settings-and-lowpower-consumption-stmicroelectronics.pdf
Application Notes | https://www.st.com/resource/en/application_note/an5612-esd-protection-of-stm32-mcus-and-mpus-stmicroelectronics.pdf
Application Notes | https://www.st.com/resource/en/application_note/an5293-migration-guide-from-stm32f7-series-to-stmh74x75x-stm32h72x73x-and-stmh7a37bx-devices-stmicroelectronics.pdf

Application Notes | https://www.st.com/resource/en/application_note/an4838-introduction-to-memory-protection-unit-management-on-stm32-mcus-stmicroelectronics.pdf
Application Notes | https://www.st.com/resource/en/application_note/an5325-how-to-use-the-cordic-to-perform-mathematical-functions-on-stm32-mcus-stmicroelectronics.pdf
Application Notes | https://www.st.com/resource/en/application_note/an5348-introduction-to-fdcan-peripherals-for-stm32-product-classes-stmicroelectronics.pdf
Application Notes | https://www.st.com/resource/en/application_note/an5927-i3c-protocol-used-in-the-stm32-bootloader-stmicroelectronics.pdf
Application Notes | https://www.st.com/resource/en/application_note/an5225-introduction-to-usb-typec-power-delivery-for-stm32-mcus-and-mpus-stmicroelectronics.pdf
Application Notes | https://www.st.com/resource/en/application_note/an5342--how-to-use-error-correction-code-ecc-management-for-internal-memories-protection-on-stm32-mcus-stmicroelectro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
Application Notes | https://www.st.com/resource/en/application_note/an2834-how-to-optimize-the-adc-accuracy-in-the-stm32-mcus-stmicroelectronics.pdf
Application Notes | https://www.st.com/resource/en/application_note/an5537-how-to-use-adc-oversampling-techniques-to-improve-signaltonoise-ratio-on-stm32-mcus-stmicroelectronics.pdf
Application Notes | https://www.st.com/resource/en/application_note/an5036-guidelines-for-thermal-management-on-stm32-applications-stmicroelectronics.pdf
Application Notes | https://www.st.com/resource/en/application_note/an4992-introduction-to-secure-firmware-install-sfi-for-stm32-mcus-stmicroelectronics.pdf
Application Notes | https://www.st.com/resource/en/application_note/an5405-how-to-use-fdcan-bootloader-protocol-on-stm32-mcus-stmicroelectronics.pdf
Application Notes | https://www.st.com/resource/en/application_note/an5690-how-to-use-vrefbuf-peripheral-on-stm32-mcus-and-mpus-stmicroelectronics.pdf
Application Notes | https://www.st.com/resource/en/application_note/an4230-introduction-to-random-number-generation-validation-using-the-nist-statistical-test-suite-for-stm32-mcus-and-m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
Application Notes | https://www.st.com/resource/en/application_note/an2867-guidelines-for-

| oscillator-design-on-stm8afals-and-stm32-mcusmpus-stmicroelectronics.pdf
Application Notes | https://www.st.com/resource/en/application_note/an4013-introduction-to-timers-for-stm32-mcus-stmicroelectronics.pdf
Application Notes | https://www.st.com/resource/en/application_note/an4277-how-to-use-pwm-shutdown-for-motor-control-and-digital-power-conversion-on-stm32-mcus-stmicroelectronics.pdf
Application Notes | https://www.st.com/resource/en/application_note/an4635-how-to-optimize-lpuart-power-consumption-on-stm32-mcus-stmicroelectronics.pdf
Application Notes | https://www.st.com/resource/en/application_note/an4759-introduction-to-using-the-hardware-realtime-clock-rtc-and-the-tamper-management-unit-tamp-with-stm32-mcus-stmi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
Application Notes | https://www.st.com/resource/en/application_note/an4861-introduction-to-lcdtft-display-controller-ltdc-on-stm32-mcus-stmicroelectronics.pdf
Application Notes | https://www.st.com/resource/en/application_note/an4908-getting-started-with-usart-automatic-baud-rater-detection-for-stm32-mcus-stmicroelectronics.pdf
Application Notes | https://www.st.com/resource/en/application_note/an4943-how-to-use-chromart-accelerator-to-refresh-an-lcdtft-display-on-stm32-mcus-stmicroelectronics.pdf
Application Notes | https://www.st.com/resource/en/application_note/an5156-introduction-to-security-for-stm32-mcus-stmicroelectronics.pdf
Application Notes | https://www.st.com/resource/en/application_note/an5200-getting-started-with-stm32h7-mcus-sdmmc-host-controller-stmicroelectronics.pdf
Application Notes | https://www.st.com/resource/en/application_note/an5224-introduction-to-dmamux-for-stm32-mcus-stmicroelectronics.pdf
Application Notes | https://www.st.com/resource/en/application_note/an5507-how-to-use-crc-to-check-the-integrity-of-the-internal-flash-memory-on-stm32h7-mcus-stmicroelectronics.pdf
Application Notes | https://www.st.com/resource/en/application_note/an5543-guidelines-for-enhanced-spi-communication-on-stm32-mcus-and-mpus-stmicroelectronics.pdf

Application Notes | https://www.st.com/resource/en/application_note/an5050-getting-started-with-octospi-hexadecaspi-and-xspi-interface-on-stm32-mcus-stmicroelectronics.pdf
Application Notes for related Tools & Software | https://www.st.com/resource/en/application_note/an1202_freertos_guide-freertos-guide-stmicroelectronics.pdf
Application Notes for related Tools & Software | https://www.st.com/resource/en/application_note/an1602_semihosting_in_truestudio-how-to-do-semihosting-in-truestudio-stmicroelectronics.pdf
Application Notes for related Tools & Software | https://www.st.com/resource/en/application_note/an1801_stm32cubeprogrammer_in_truestudio-installing-stm32cubeprogrammer-in-truestudio-stmicroelectronics.pdf
Application Notes for related Tools & Software | https://www.st.com/resource/en/application_note/atollic_editing_keyboard_shortcuts-atollic-editing-keyboard-shortcuts-stmicroelectronics.pdf
Application Notes for related Tools & Software | https://www.st.com/resource/en/application_note/iar_to_atollic_truestudio_migration_guide-truestudio-for-arm-migration-guide-iar-embedded-workbench-to-truestudio-stm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
Application Notes for related Tools & Software | https://www.st.com/resource/en/application_note/stm32cubemx_installation_in_truestudio-stm32cubemx-installation-in-truestudio-stmicroelectronics.pdf
Application Notes for related Tools & Software | https://www.st.com/resource/en/application_note/an4323-getting-started-with-stemwin-library-stmicroelectronics.pdf
Application Notes for related Tools & Software | https://www.st.com/resource/en/application_note/an4435-guidelines-for-obtaining-ulcsaiec-607301603351-class-b-certification-in-any-stm32-application-stmicroelectroni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
Application Notes for related Tools & Software | https://www.st.com/resource/en/application_note/an4657-stm32-inapplication-programming-iap-using-the-usart-stmicroelectronics.pdf
Application Notes for related Tools & Software | https://www.st.com/resource/en/application_note/an4841-digital-signal-processing-for-stm32-microcontrollers-using-cmsis-stmicroelectronics.pdf
Application Notes | https://www.st.com/resource/en/application_note/an4891-stm32h72x-

for related Tools & Software | stm32h73x-and-singlecore-stm32h74x75x-system-architecture-and-performance-stmicroelectronics.pdf
Application Notes for related Tools & Software | https://www.st.com/resource/en/application_note/an5001-stm32cube-expansion-package-for-stm32h7-series-mdma-stmicroelectronics.pdf
Application Notes for related Tools & Software | https://www.st.com/resource/en/application_note/an5014-stm32h7x3-smart-power-management-expansion-package-for-stm32cube-stmicroelectronics.pdf
Application Notes for related Tools & Software | https://www.st.com/resource/en/application_note/an5033-stm32cube-mcu-package-examples-for-stm32h7-series-stmicroelectronics.pdf
Application Notes for related Tools & Software | https://www.st.com/resource/en/application_note/an5056-integration-guide-for-the-xcubesbsfu-stm32cube-expansion-package-stmicroelectronics.pdf
Application Notes for related Tools & Software | https://www.st.com/resource/en/application_note/an5360-getting-started-with-projects-based-on-the-stm32mp1-series-in-stm32cubeide-stmicroelectronics.pdf
Application Notes for related Tools & Software | https://www.st.com/resource/en/application_note/an5361-getting-started-with-projects-based-on-dualcore-stm32h7-microcontrollers-in-stm32cubeide-stmicroelectronics.pd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
Application Notes for related Tools & Software | https://www.st.com/resource/en/application_note/an5394-getting-started-with-projects-based-on-the-stm32l5-series-in-stm32cubeide-stmicroelectronics.pdf
Application Notes for related Tools & Software | https://www.st.com/resource/en/application_note/an5418-how-to-build-a-simple-usbpd-sink-application-with-stm32cubemx-stmicroelectronics.pdf
Application Notes for related Tools & Software | https://www.st.com/resource/en/application_note/an5426-migrating-graphics-middleware-projects-from-stm32cubemx-540-to-stm32cubemx-550-stmicroelectronics.pdf
Application Notes for related Tools & Software | https://www.st.com/resource/en/application_note/an5534-stm32h735gdk-firmware-upgrade-for-atbased-emw3080-wifi-module-stmicroelectronics.pdf

Application Notes
for related Tools

https://www.st.com/resource/en/application_note/an5564-getting-startedwith-projects-based-on-dualcore-stm32wl-microcontrollers-in-

& Software | stm32cubeide-stmicroelectronics.pdf
Application Notes for related Tools & Software | https://www.st.com/resource/en/application_note/an4865-lowpower-timer-lptim-applicative-use-cases-on-stm32-mcus-and-mpus-stmicroelectronics.pdf
Application Notes for related Tools & Software | https://www.st.com/resource/en/application_note/an5698-adapting-the-xcubestl-functional-safety-package-for-stm32-iec-61508-compliant-to-other-safety-standards-stmicr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
Application Notes for related Tools & Software | https://www.st.com/resource/en/application_note/an5731-stm32cubemx-and-stm32cubeide-threadsafe-solution-stmicroelectronics.pdf
Application Notes for related Tools & Software | https://www.st.com/resource/en/application_note/an5450-stm32h7a37b3-lines-and-stm32h7b0-value-line-smart-power-management-expansion-package-for-stm32cube-stmicroelec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
Application Notes for related Tools & Software | https://www.st.com/resource/en/application_note/an4502-stm32-smbuspmbus-expansion-package-for-stm32cube-stmicroelectronics.pdf
Application Notes for related Tools & Software | https://www.st.com/resource/en/application_note/an5952-how-to-use-cmake-in-stm32cubeide-stmicroelectronics.pdf
Application Notes for related Tools & Software | https://www.st.com/resource/en/application_note/an4635-how-to-optimize-lpuart-power-consumption-on-stm32-mcus-stmicroelectronics.pdf
Application Notes for related Tools & Software | https://www.st.com/resource/en/application_note/an5054-how-to-perform-secure-programming-using-stm32cubeprogrammer-stmicroelectronics.pdf
Application Notes for related Tools & Software | https://www.st.com/resource/en/application_note/an6088-how-to-use-mce-for-encryptiondecryption-on-stm32-mcus-stmicroelectronics.pdf
Design Notes & Tips | https://www.st.com/resource/en/design_tip/dt0117-microphone-array-beamforming-in-the-pcm-and-pdm-domain-stmicroelectronics.pdf
Errata Sheets | https://www.st.com/resource/en/errata_sheet/es0491-stm32h72xx73xx-device-errata-stmicroelectronics.pdf
Datasheet | https://www.st.com/resource/en/datasheet/dm00701023.pdf

Programming Manuals | https://www.st.com/resource/en/programming_manual/pm0253-stm32f7-series-and-stm32h7-series-cortexm7-processor-programming-manual-stmicroelectronics.pdf
Reference Manuals | https://www.st.com/resource/en/reference_manual/rm0468-stm32h723733-stm32h725735-and-stm32h730-value-line-advanced-armbased-32bit-mcus-stmicroelectronics.pdf
Technical Notes & Articles | https://www.st.com/resource/en/technical_note/tn1163-description-of-wlcsp-for-microcontrollers-and-recommendations-for-its-use-stmicroelectronics.pdf
Technical Notes & Articles | https://www.st.com/resource/en/technical_note/tn1204-tape-and-reel-shipping-media-for-stm32-microcontrollers-in-bga-packages-stmicroelectronics.pdf
Technical Notes & Articles | https://www.st.com/resource/en/technical_note/tn1205-tape-and-reel-shipping-media-for-stm8-and-stm32-microcontrollers-in-fpn-packages-stmicroelectronics.pdf
Technical Notes & Articles | https://www.st.com/resource/en/technical_note/tn1206-tape-and-reel-shipping-media-for-stm8-and-stm32-microcontrollers-in-qfp-packages-stmicroelectronics.pdf
Technical Notes & Articles | https://www.st.com/resource/en/technical_note/tn1207-tape-and-reel-shipping-media-for-stm8-and-stm32-microcontrollers-in-so-packages-stmicroelectronics.pdf
Technical Notes & Articles | https://www.st.com/resource/en/technical_note/tn1208-tape-and-reel-shipping-media-for-stm8-and-stm32-microcontrollers-in-tssop-and-ssop-packages-stmicroelectronics.p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
Technical Notes & Articles | https://www.st.com/resource/en/technical_note/tn1433-reference-device-marking-schematics-for-stm32-microcontrollers-and-microprocessors-stmicroelectronics.pdf
Technical Notes & Articles | https://www.st.com/resource/en/technical_note/tn1489-security-bulletin-tn1489stpsirt-physical-attacks-on-stm32-and-stm32cube-firmware-stmicroelectronics.pdf
User Manuals | https://www.st.com/resource/en/user_manual/um2840-stm32h7-dualcore-series-safety-manual-stmicroelectronics.pdf
User Manuals | https://www.st.com/resource/en/user_manual/um2331-stm32h7-singlecore-series-safety-manual-stmicroelectronics.pdf

User Manuals https://www.st.com/resource/en/user_manual/um3252-stm32h7-series- ulcsaiec-607301603351-selftest-library-user-guide-stmicroelectronics.pdf
