HB9GZE/PhasorRadio/SM32H735Discovery/Schematic/en.MB1520-H735I-B02_Schematic.pdf

Title: Project overview

Size:

Reference:
A4 | Sheet: | of

Revision:

Project: STM32H735G-DK

B 02 | MB1520
02-APR-20

H735I

Date:

Variant:

Table of contents | Legend

General comment such as function title, configuration, ...

Sheet 2: TOP | Text to be added to silkscreen.

Sheet 1: Project overview (this page)

# STM32H735G-DK

MB1520

Sheet 4: STM32 microcontroller Power

Sheet 6: PoE

Sheet 5: Ethernet

Sheet 3: STM32 microcontroller IOs | Warning text.

# OPEN PLATFORM LICENSE AGREEMENT

Top
TOP.SchDoc

The Open Platform License Agreement (“Agreement”) is a binding legal contract between you ("You")

and STMicroelectronics International N.V. (“ST”), a company incorporated under the laws of the

Netherlands acting for the purpose of this Agreement through its Swiss branch 39, Chemin du

Champ des Filles, 1228 Plan-les-Ouates, Geneva, Switzerland.

By using the enclosed reference designs, schematics, PC board layouts, and documentation, in hardcopy

or CAD tool file format (collectively, the “Reference Material”), You are agreeing to be bound by

the terms and conditions of this Agreement. Do not use the Reference Material until You have read

and agreed to this Agreement terms and conditions. The use of the Reference Material automatically

implies the acceptance of the Agreement terms and conditions.

The complete Open Platform License Agreement can be found on www.st.com/opla.

Sheet 8: FDCAN

Sheet 7: USB OTG FS

Sheet 10: HyperRAM

Sheet 12: LCD

Sheet 11: microSD CARD

Sheet 9: OCSPI

Sheet 14: STMod+

Sheet 13: Audio

Sheet 16: Arduino Connector

Sheet 18: STLINK-V3E Power

Sheet 17: STLINK-V3E SWD Module

Sheet 15: TAG

Notes to generate the
board layout.

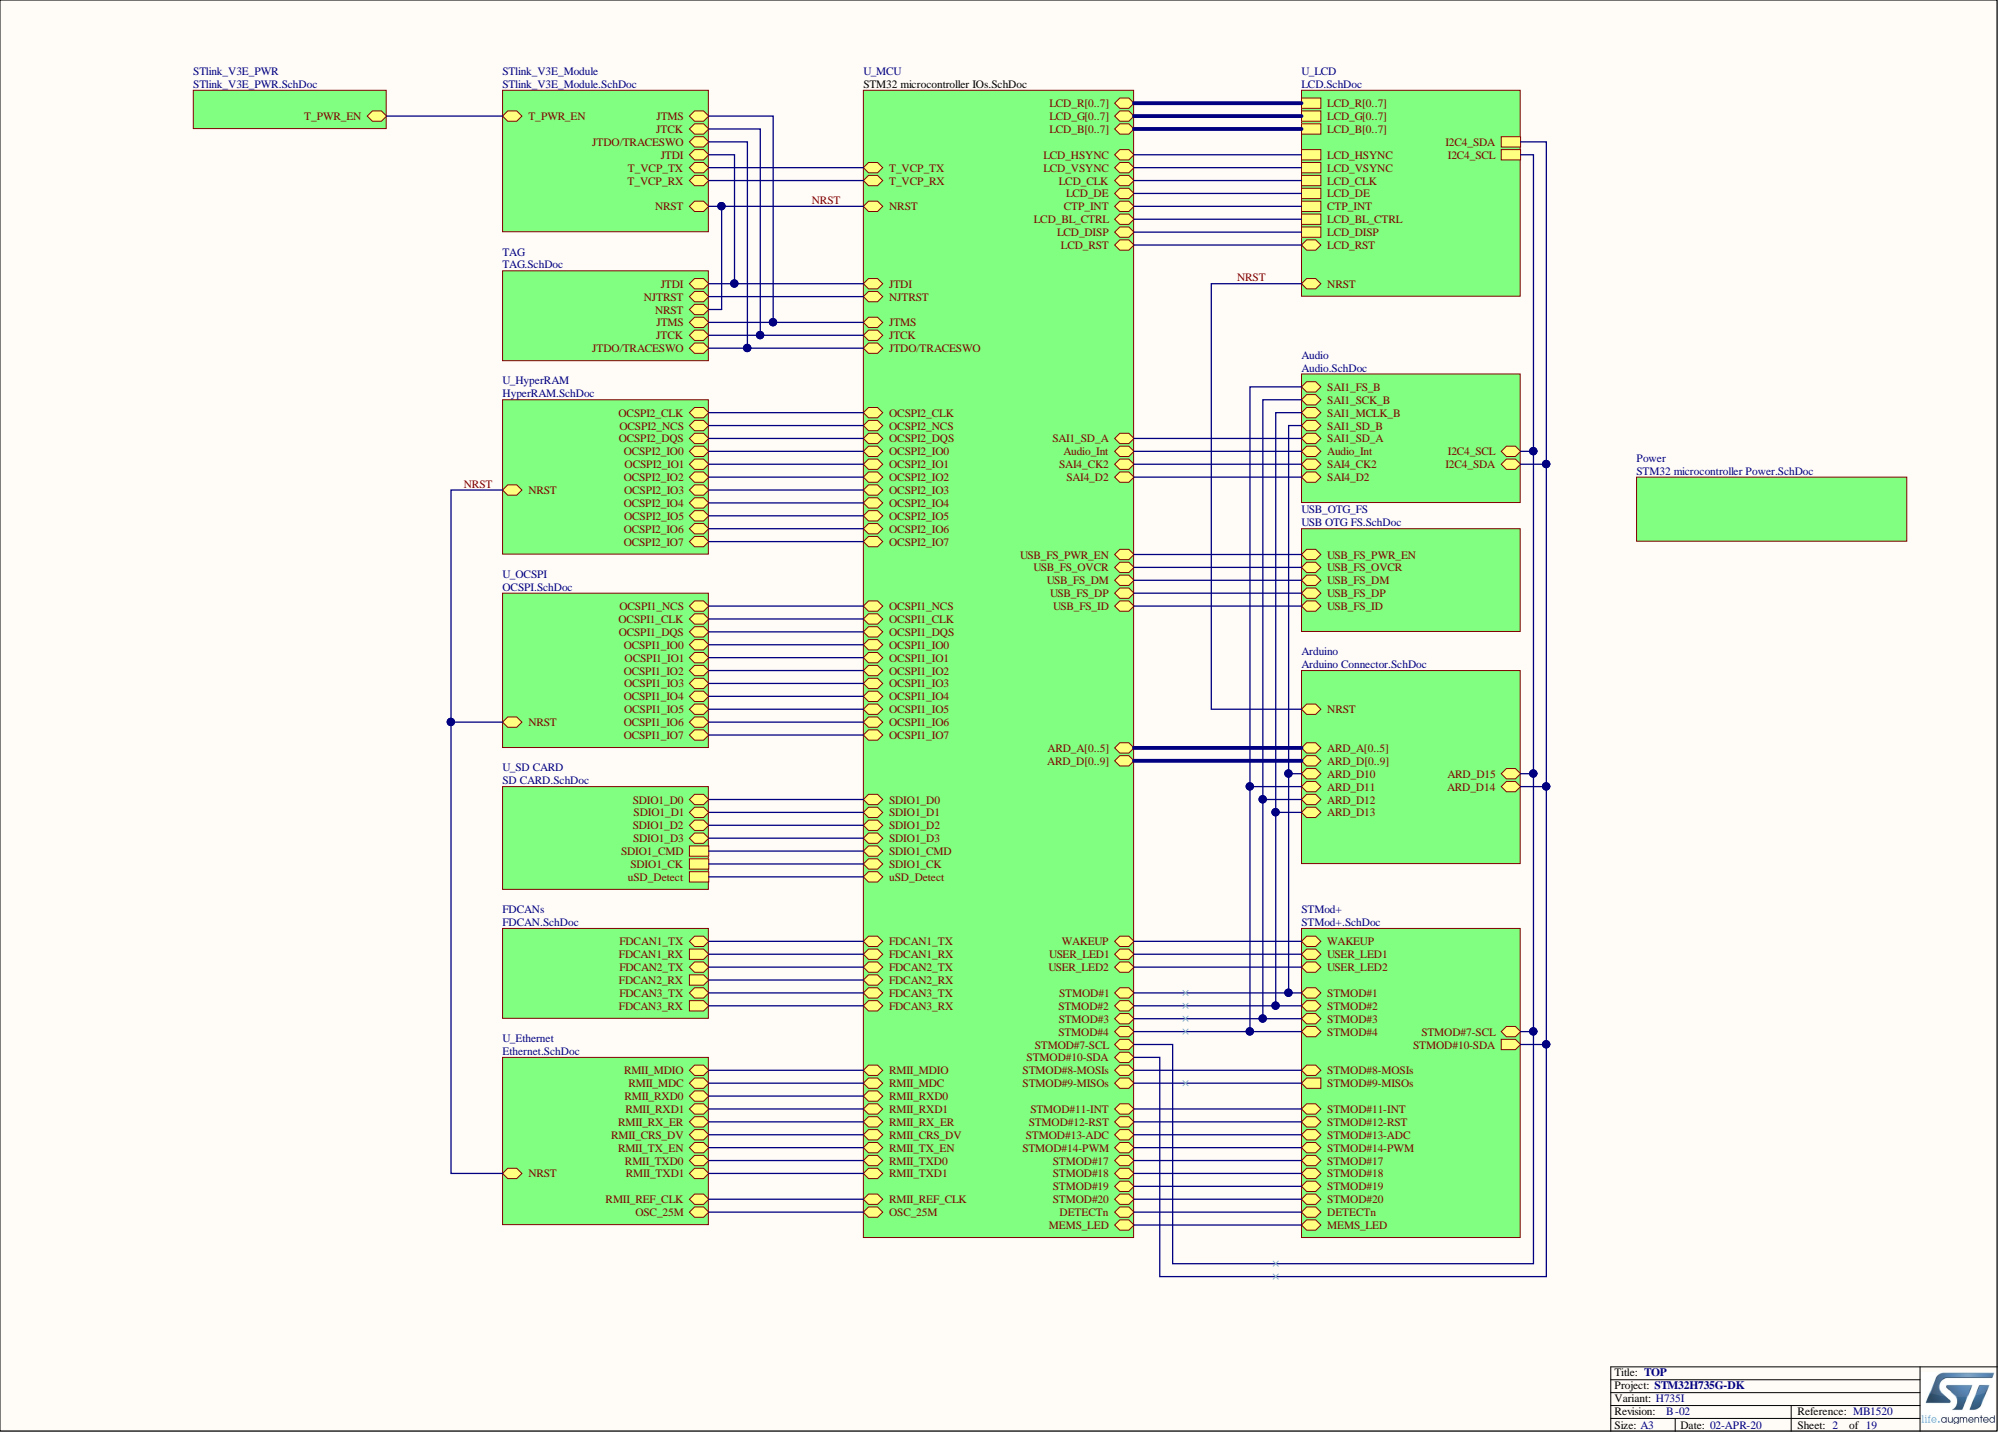
[picture p9: page 2]

USB_OTG_FS
USB OTG FS.SchDoc

STMOD#10-SDA

STMOD#8-MOSIs STMOD#9-MISOs STMOD#11-INT STMOD#12-RST STMOD#13-ADC STMOD#14-PWM STMOD#17 STMOD#18 STMOD#19 STMOD#20 DETECTn MEMS_LED

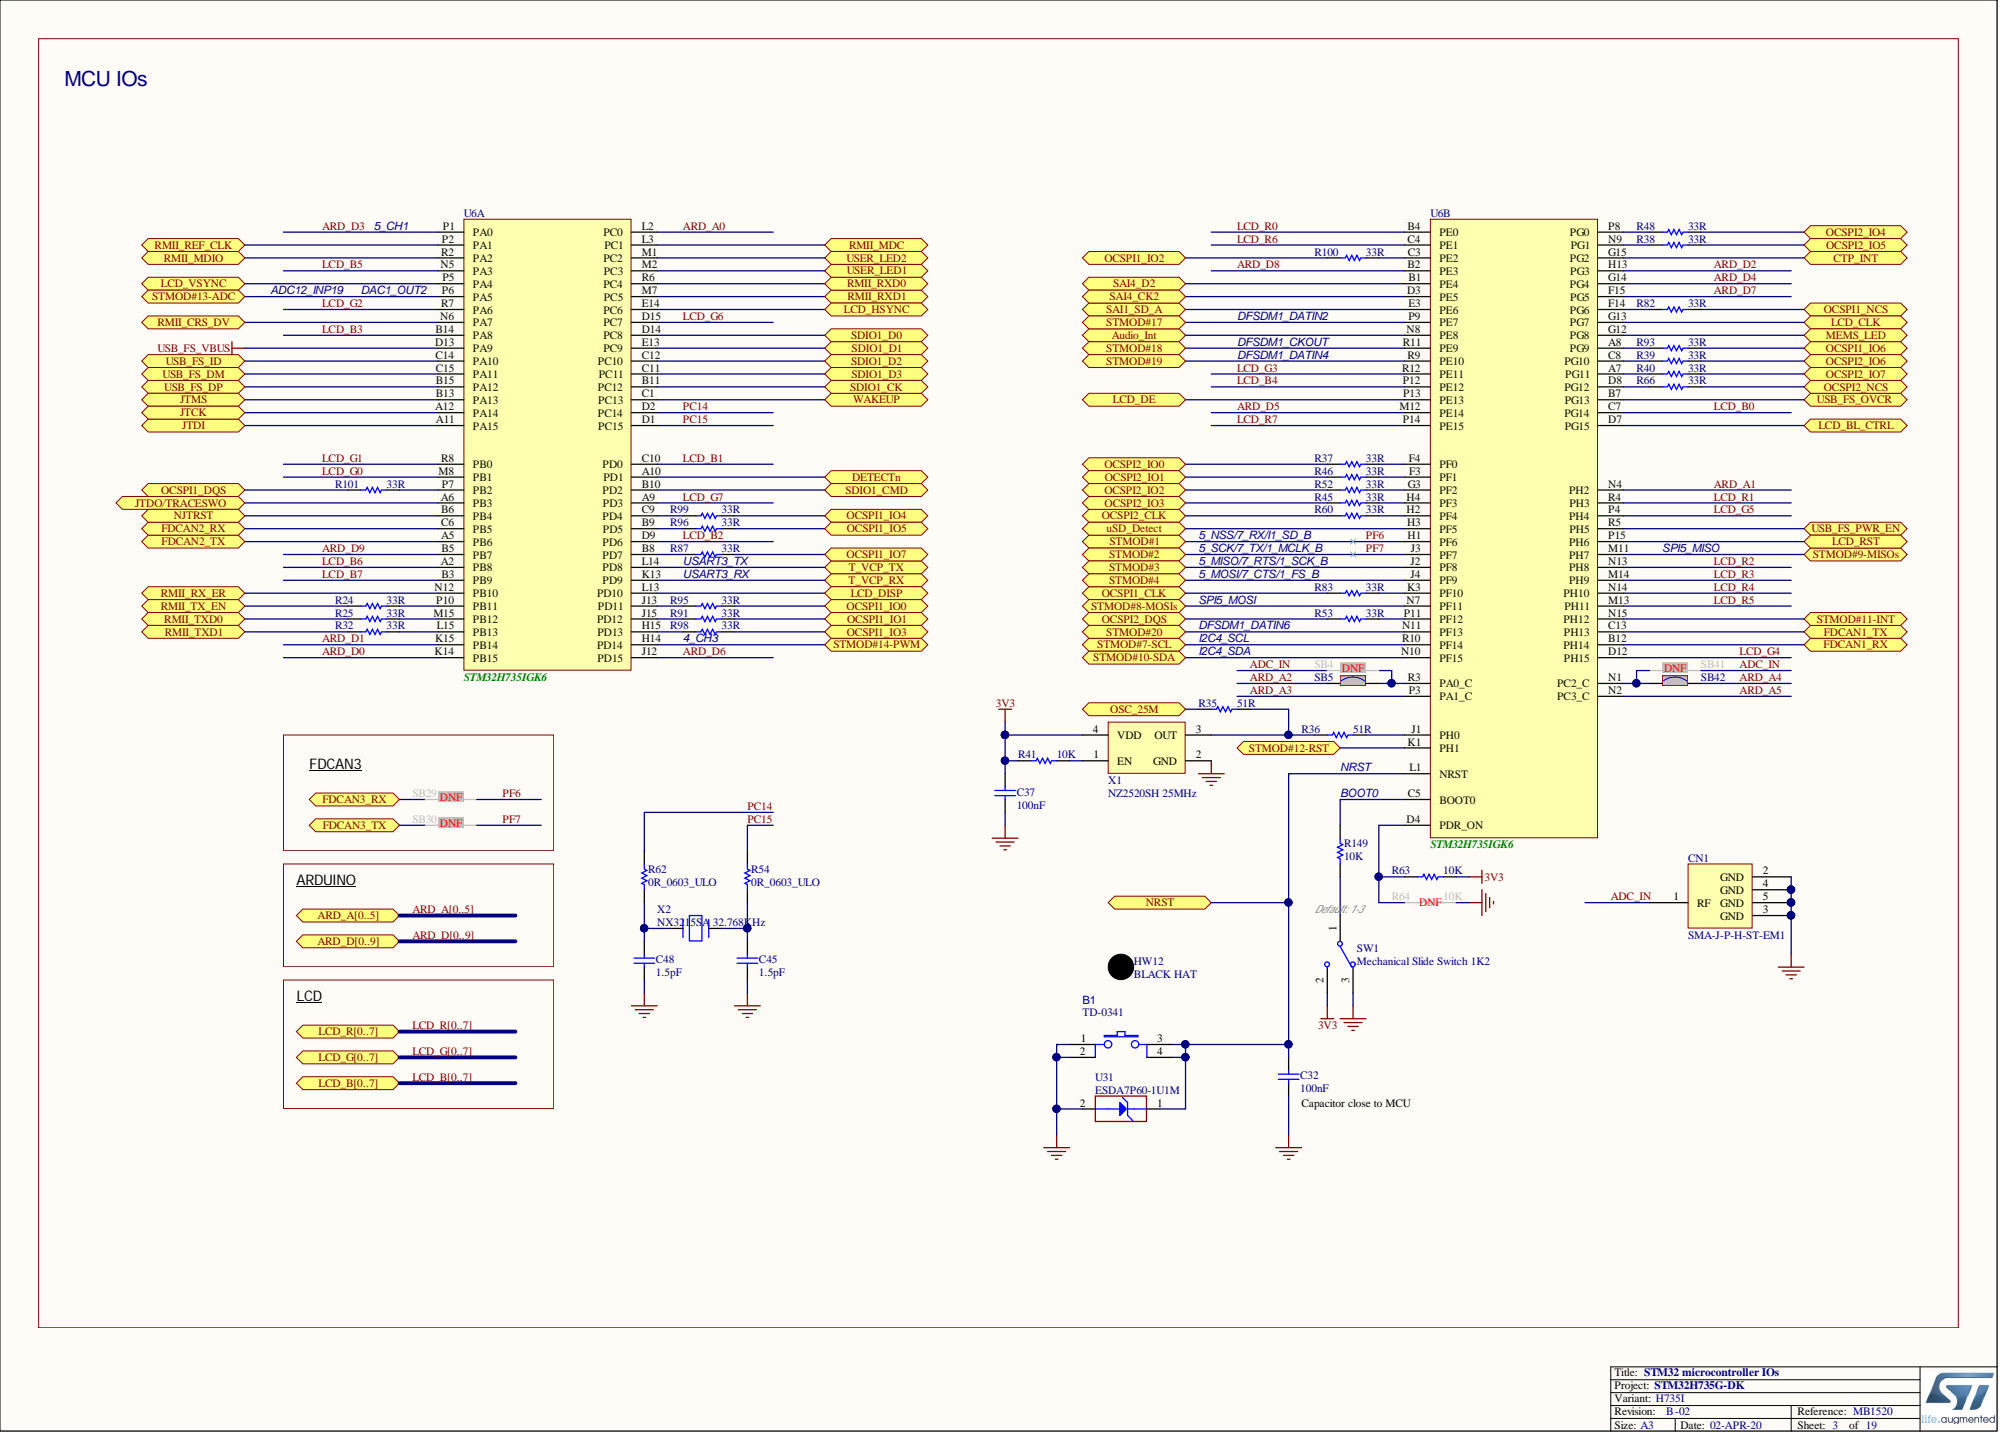
[picture p10: page 3]

STMOD#1 STMOD#2 STMOD#3 STMOD#4

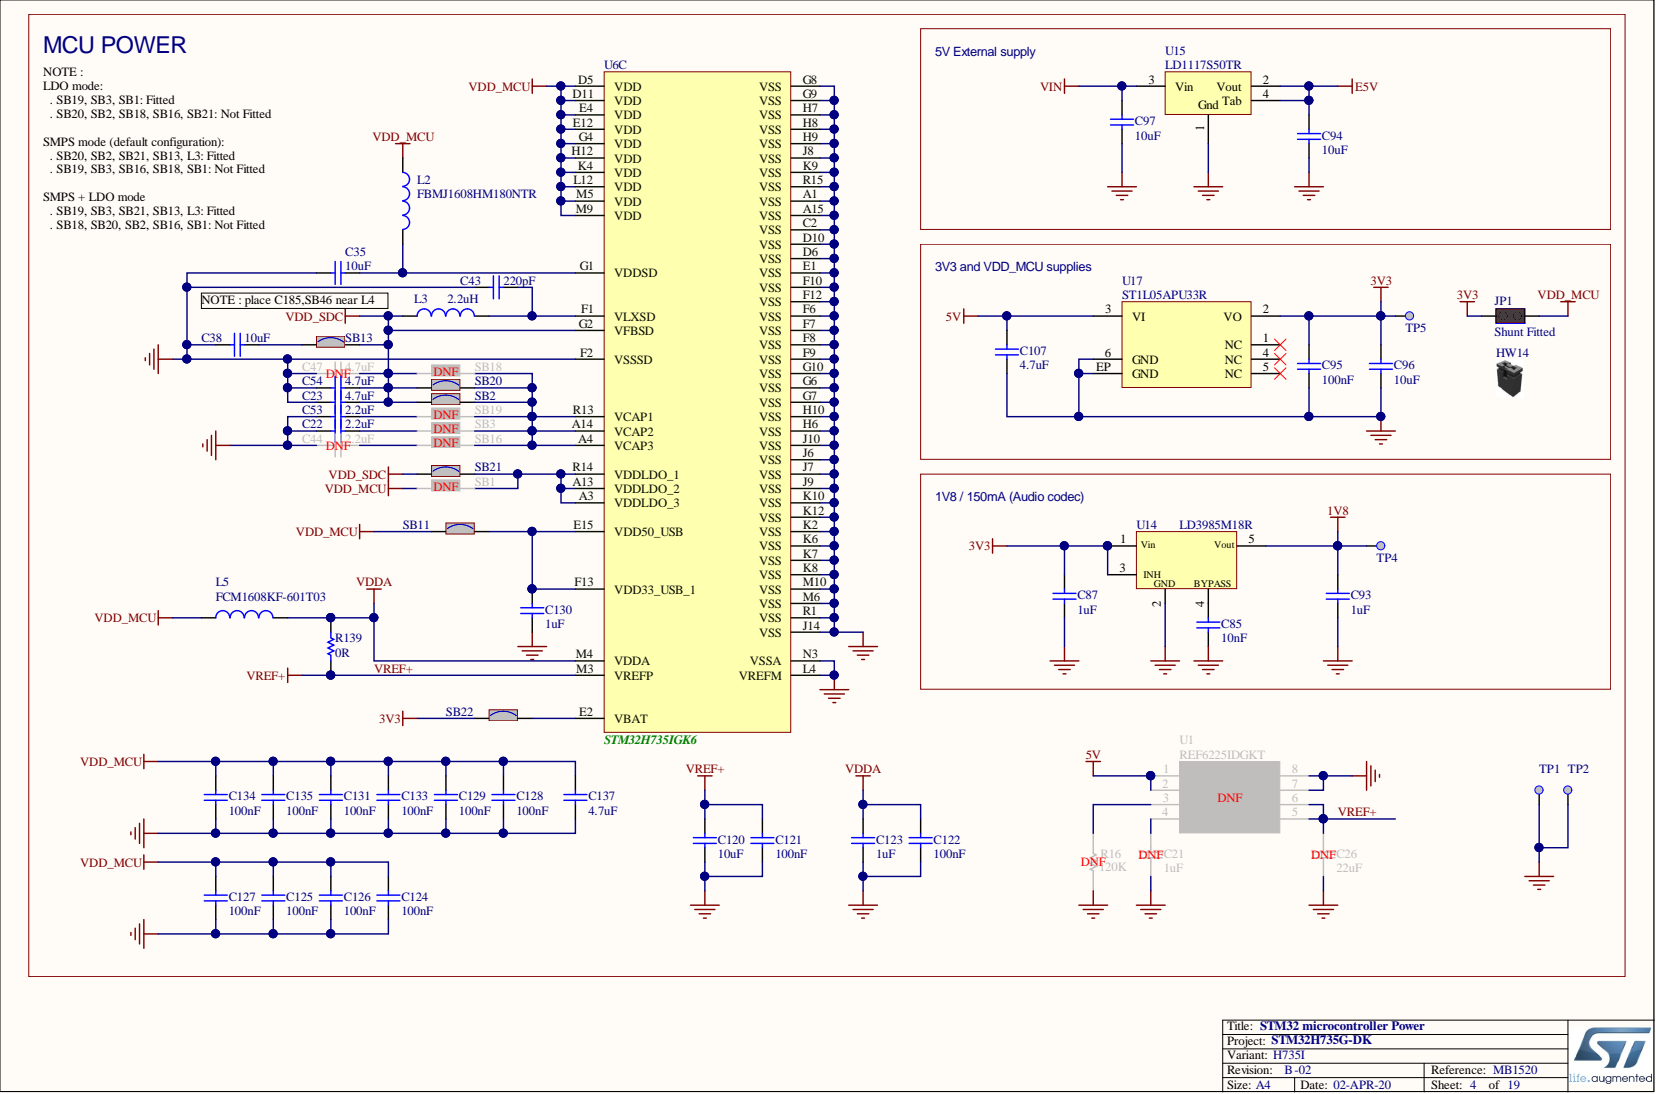
[picture p11: page 4]

SMPS mode (default configuration):
. SB20, SB2, SB21, SB13, L3: Fitted
. SB19, SB3, SB16, SB18, SB1: Not Fitted

C43 | 220pF | VLXSD F1

NOTE : place C185,SB46 near L4

VSSSD F2

SB18 DNF | VCAP1 R13

C23 | 4.7uF | SB2
C22 | 2.2uF | SB19 DNF SB3 DNF SB16 DNF | VCAP2 A14

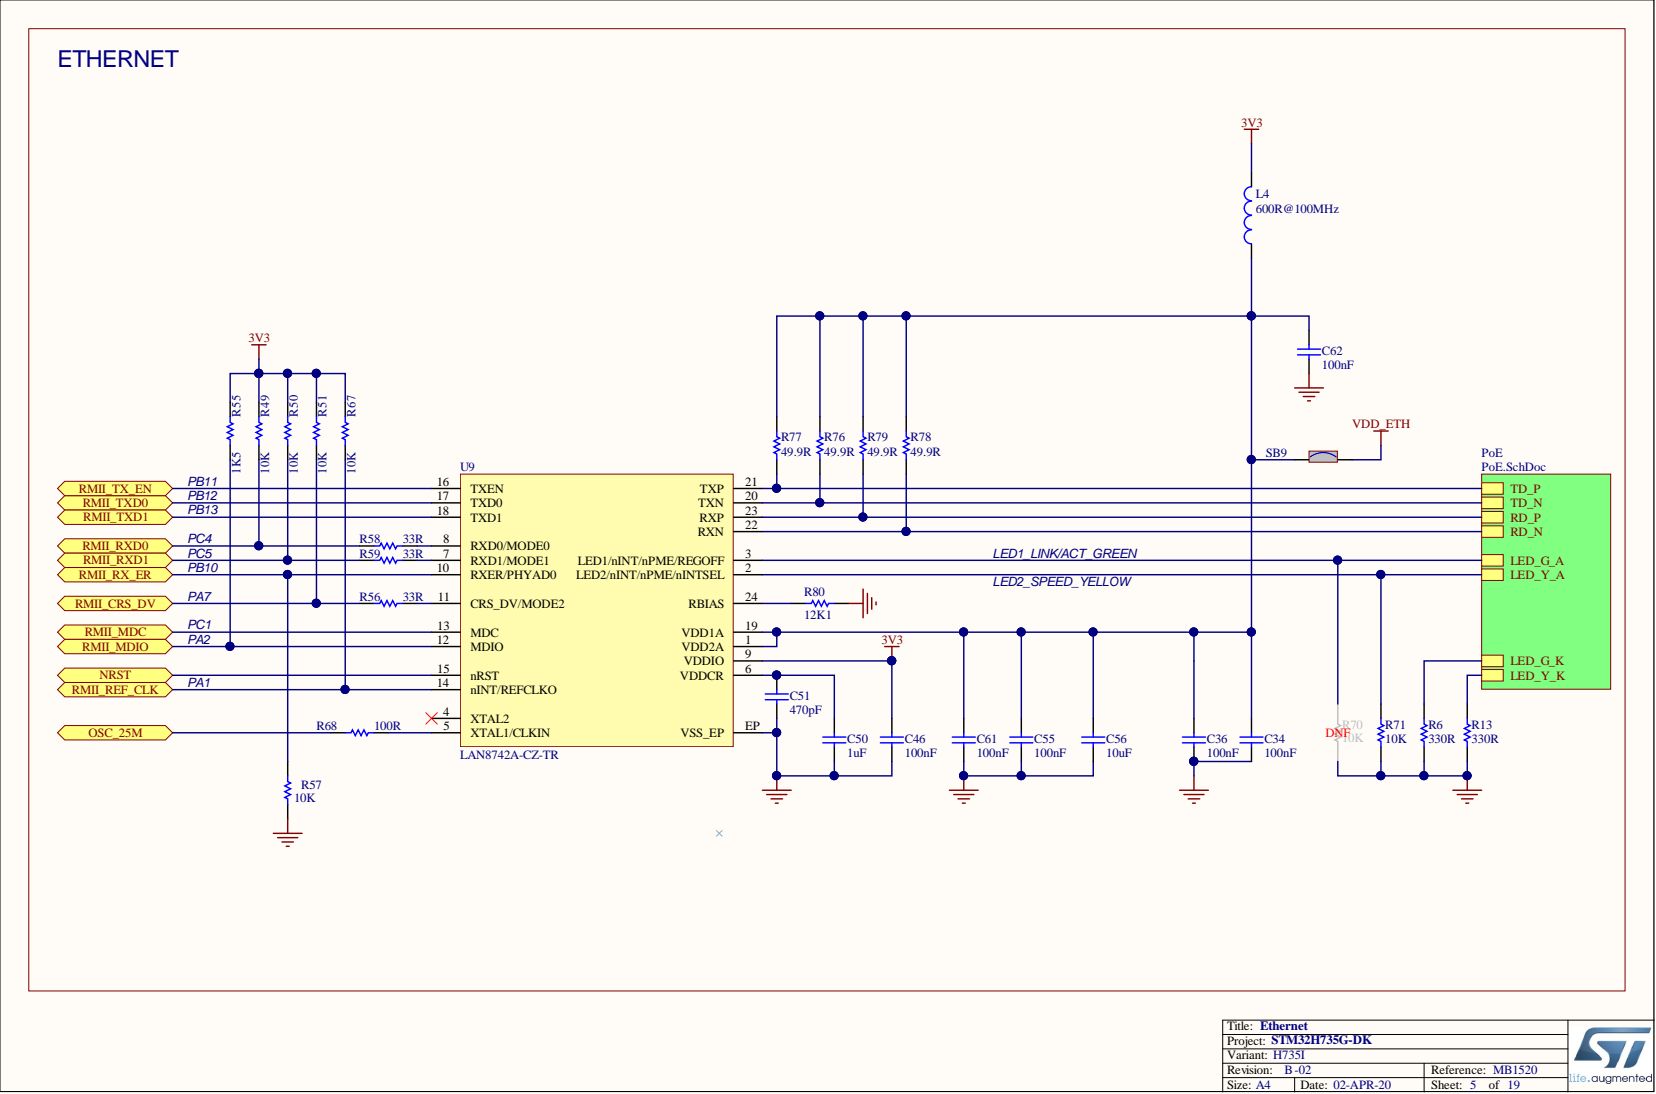
[picture p12: page 5]

2 3
2 2

3 L ED1 _ L INK/A C T_ G R EEN
1 9 | L ED2_ S PEED_ YEL L O W

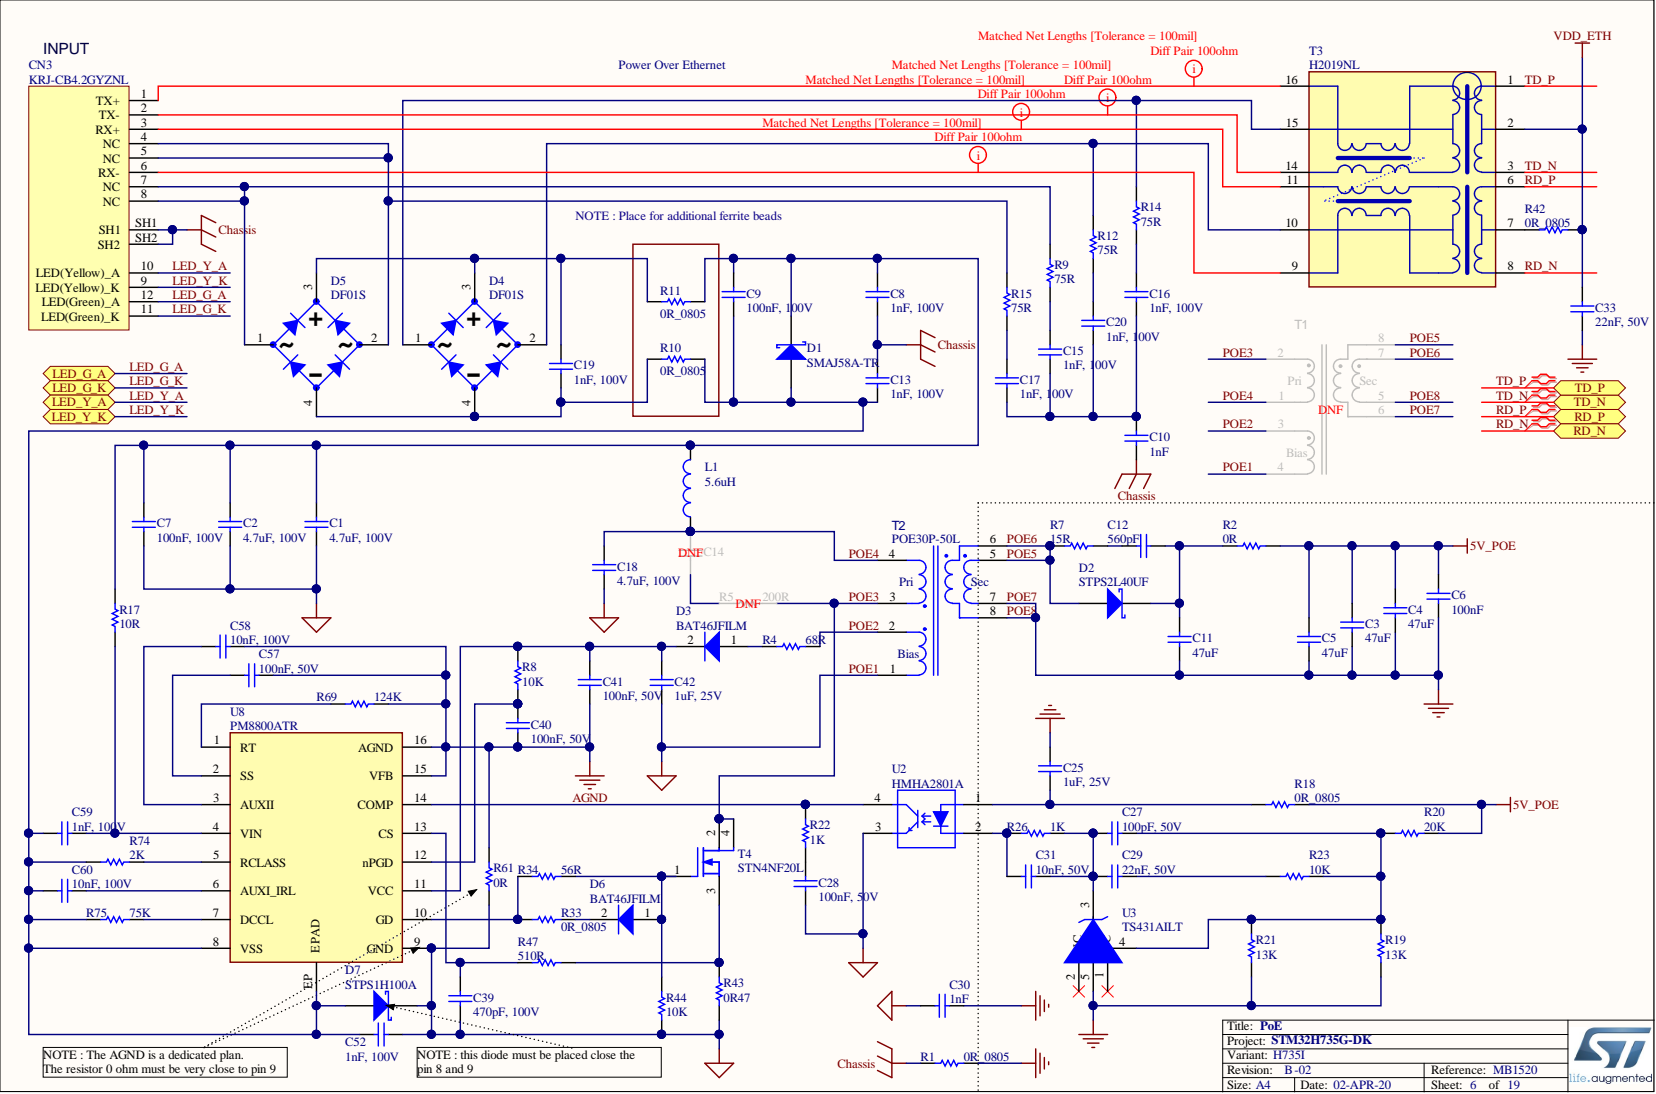
[picture p13: page 6]

Matched Net Lengths [Tolerance = 100mil]

NOTE : Place for additional ferrite beads

NOTE : The AGND is a dedicated plan.
The resistor 0 ohm must be very close to pin 9

NOTE : this diode must be placed close the
pin 8 and 9

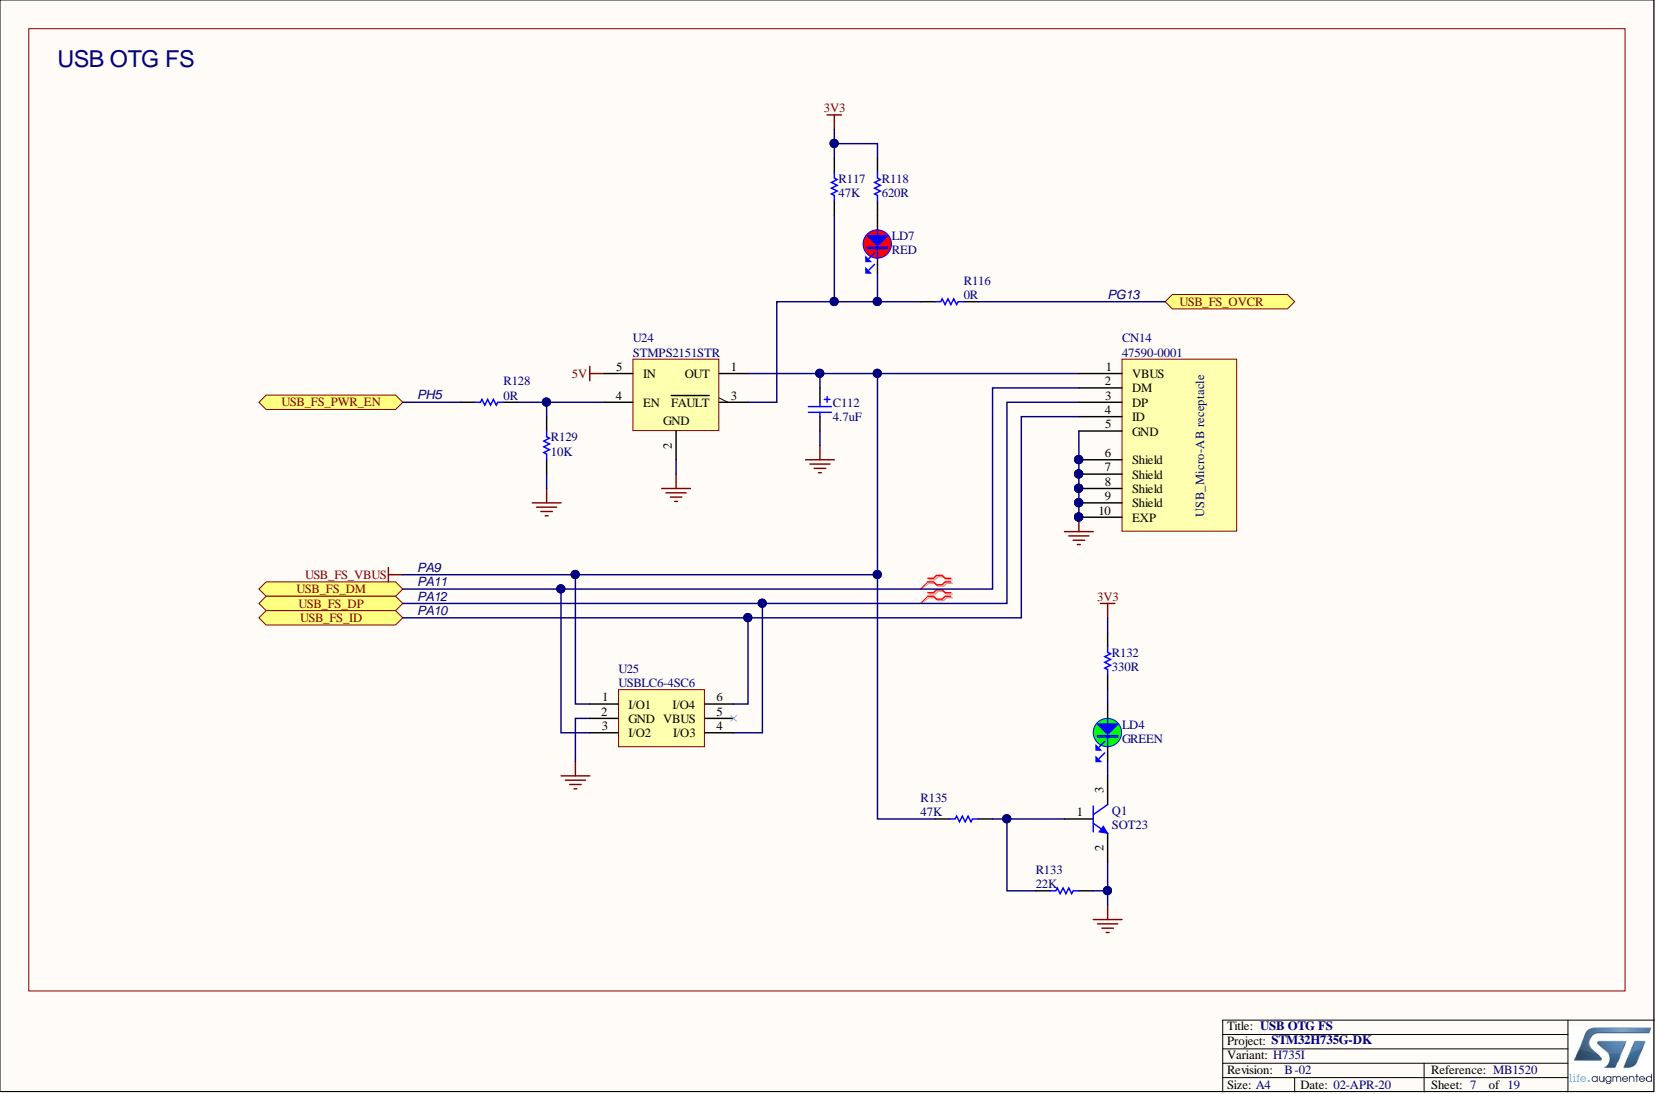
[picture p14: page 7]

PA9 | GND | GND 5

U25 USBLC6-4SC6

Title: USB OTG FS

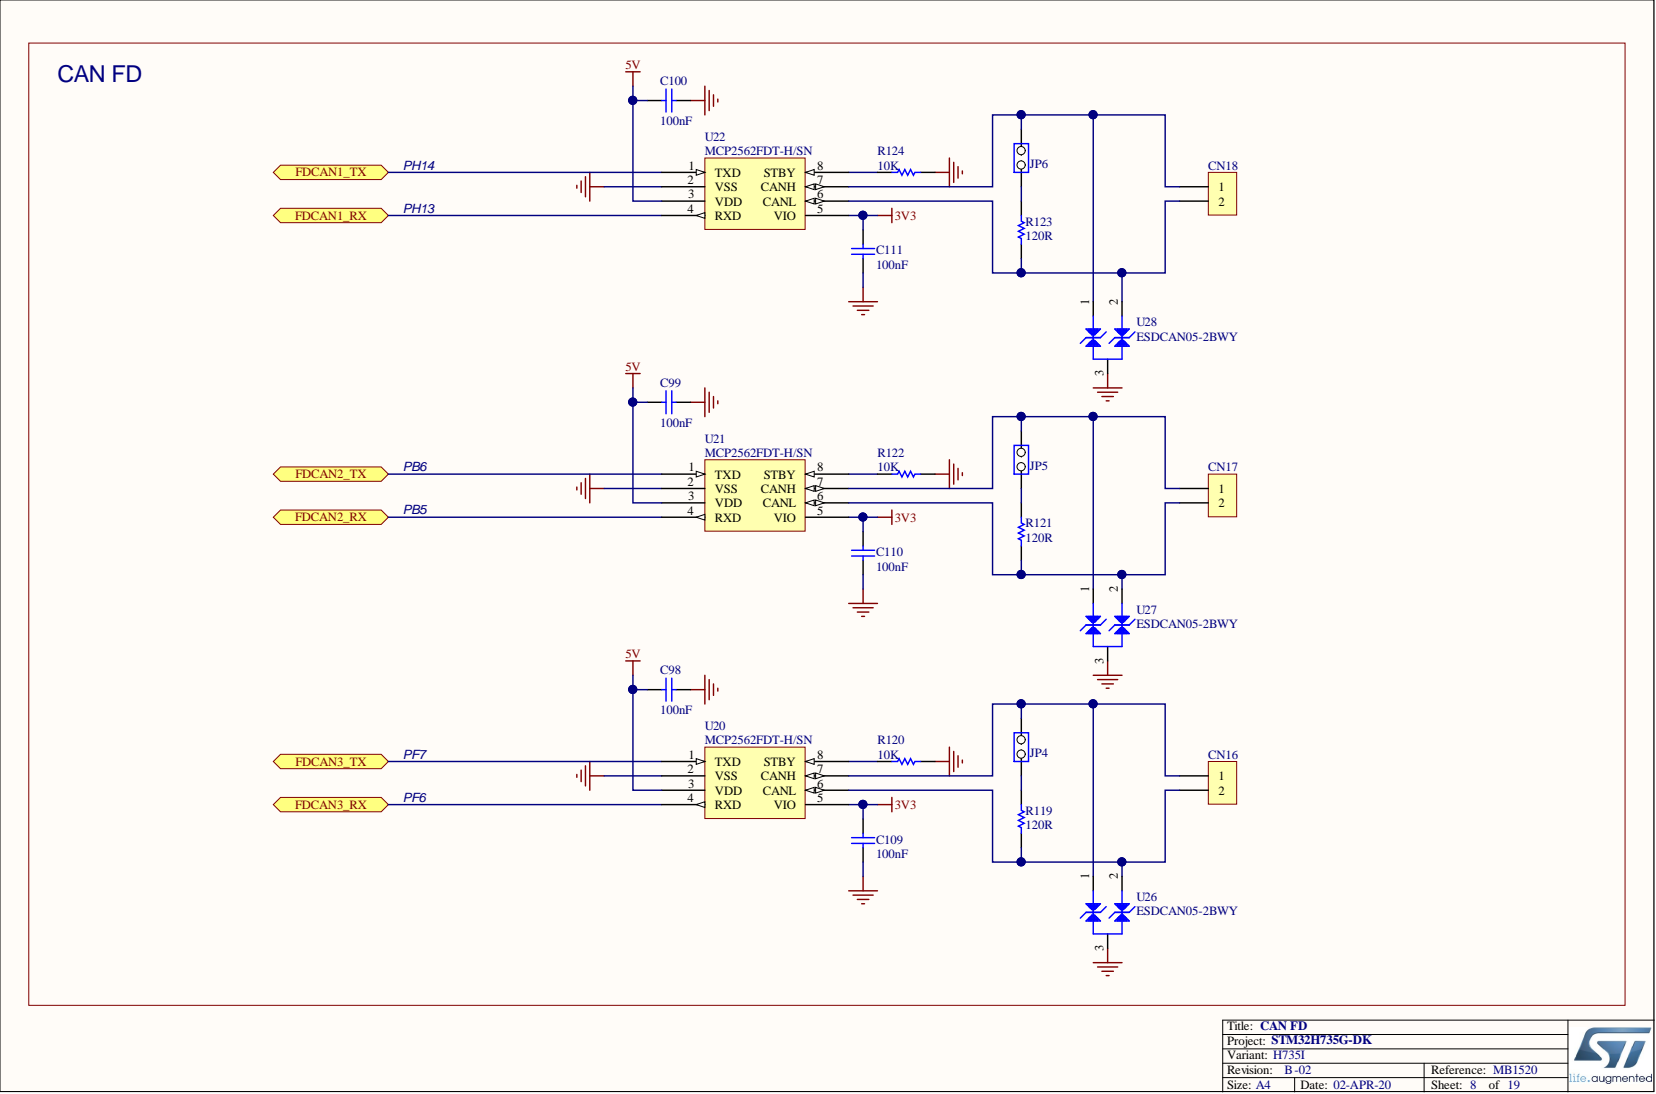
[picture p15: page 8]

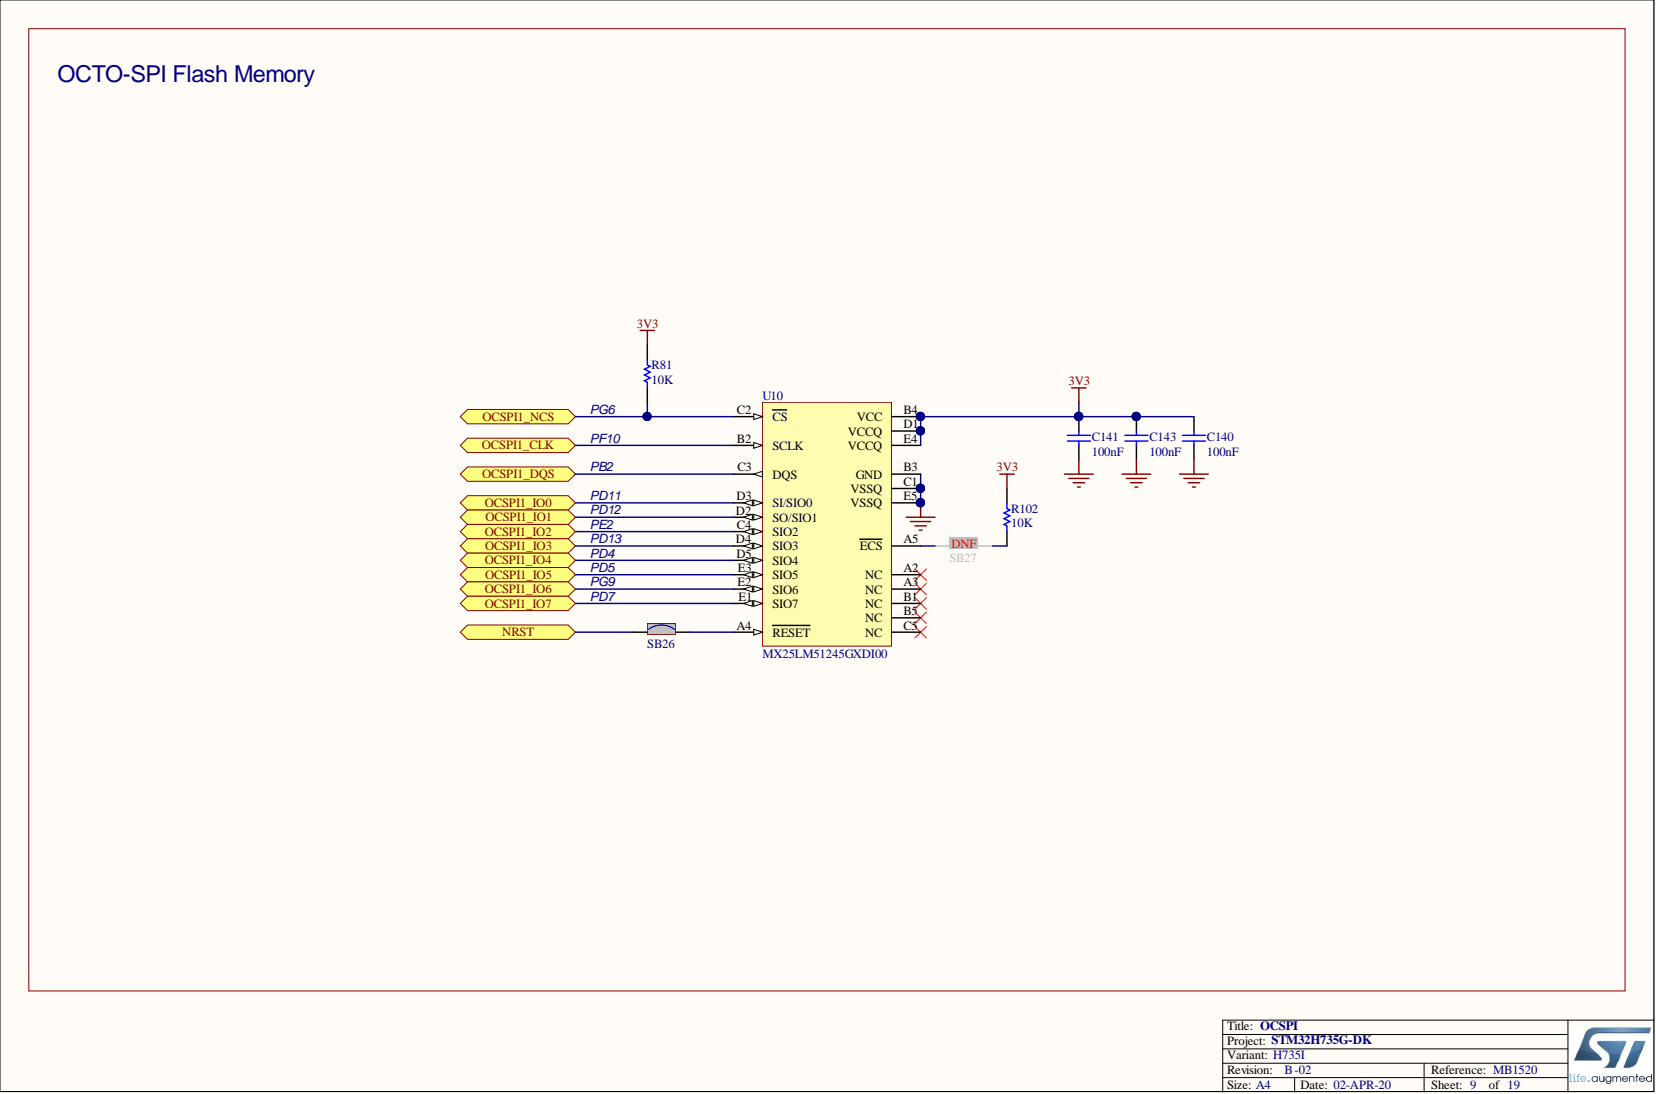
[picture p16: page 9]

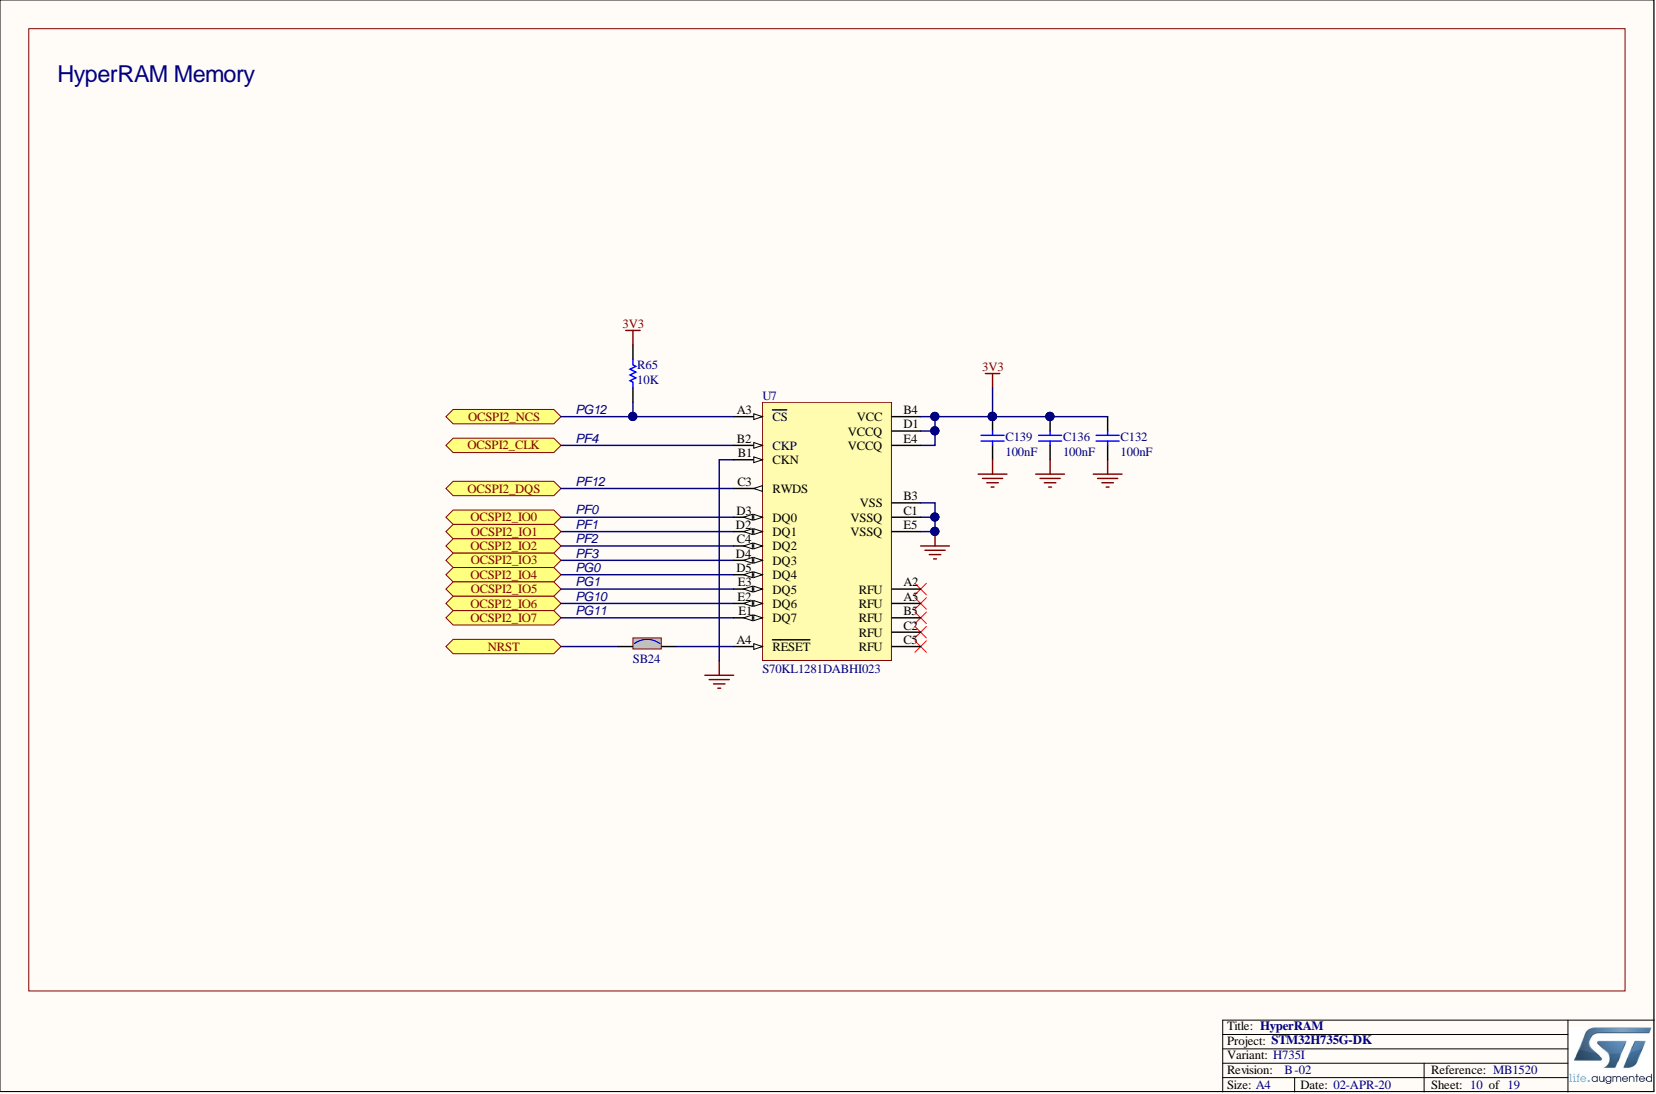
[picture p17: page 10]

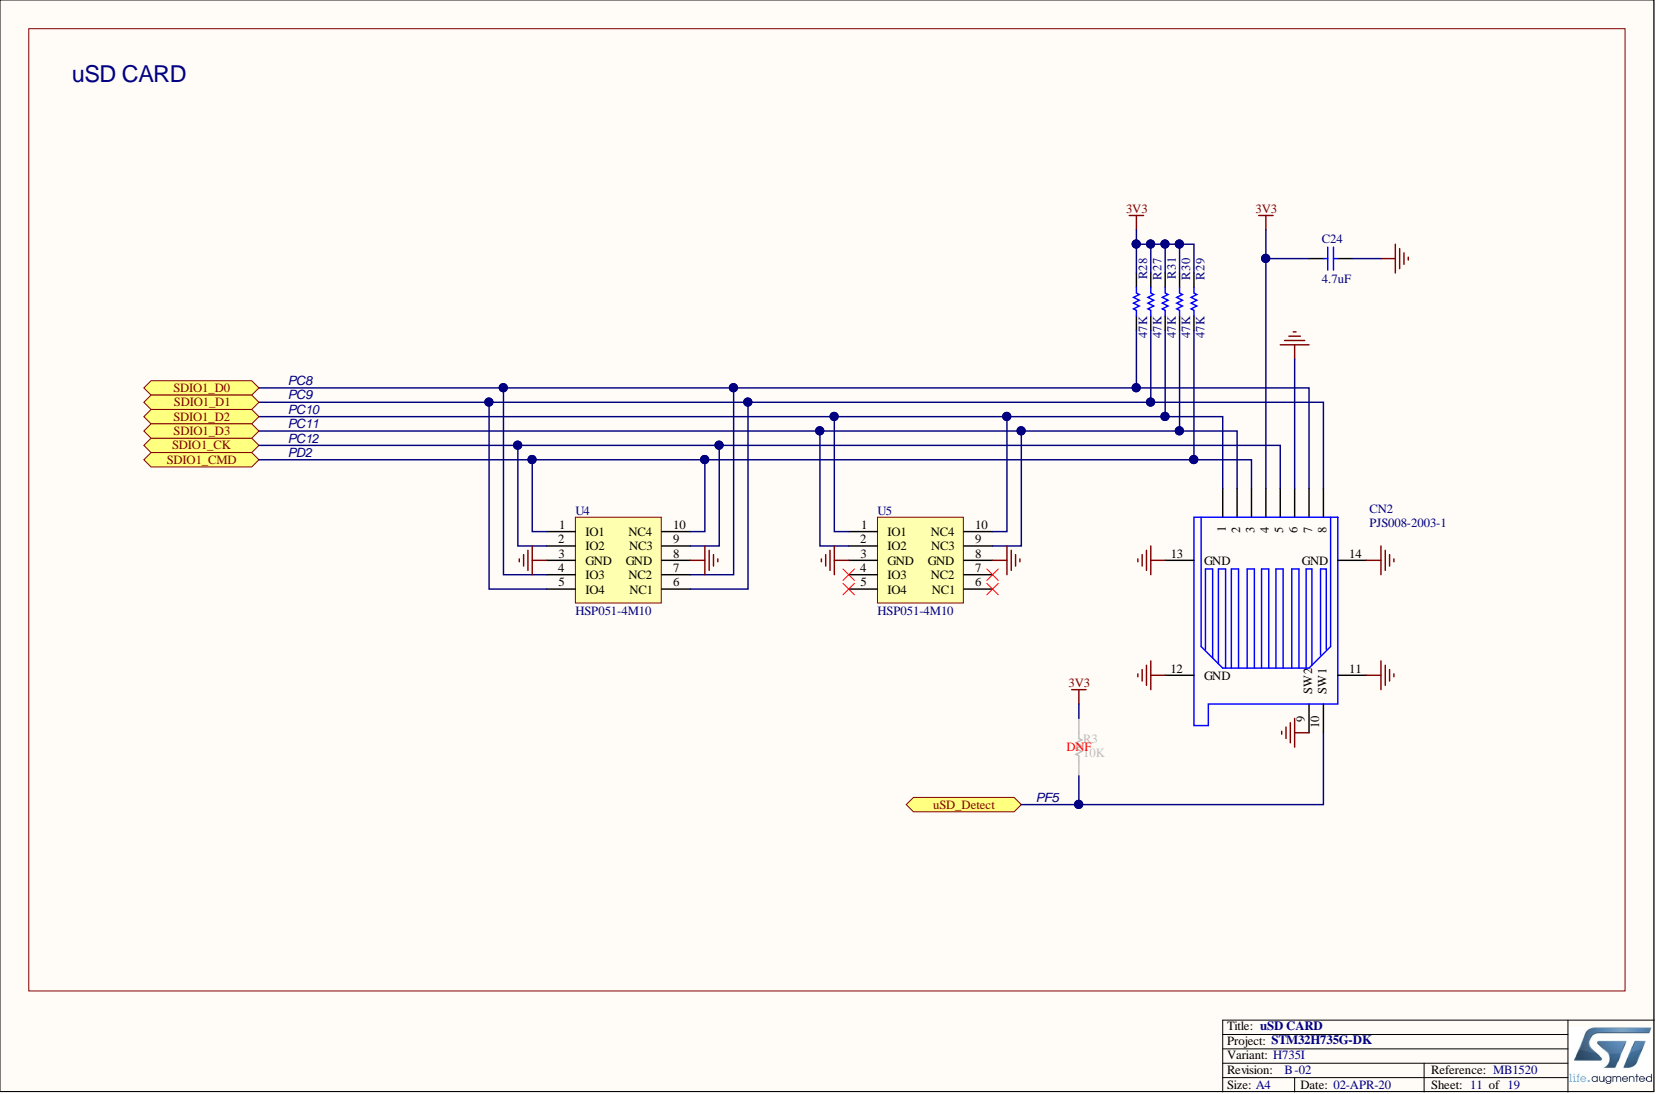
[picture p18: page 11]

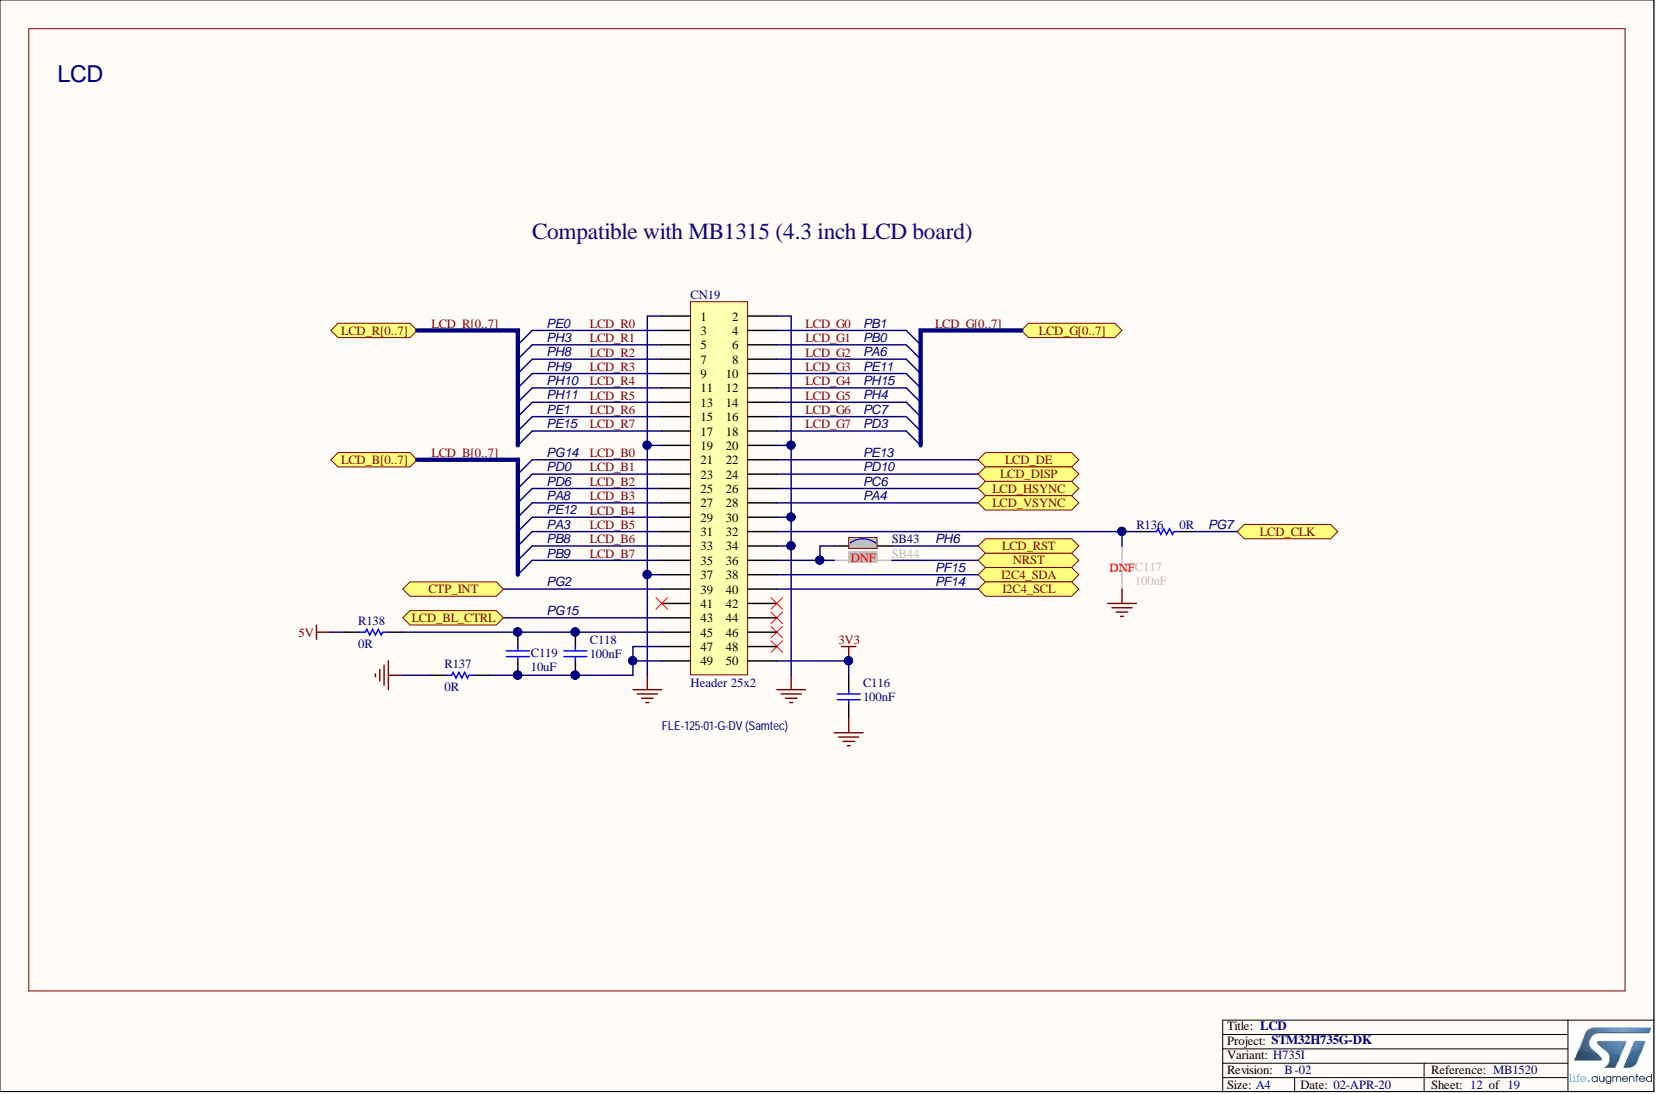
[picture p19: page 12]

Compatible with MB1315 (4.3 inch LCD board)

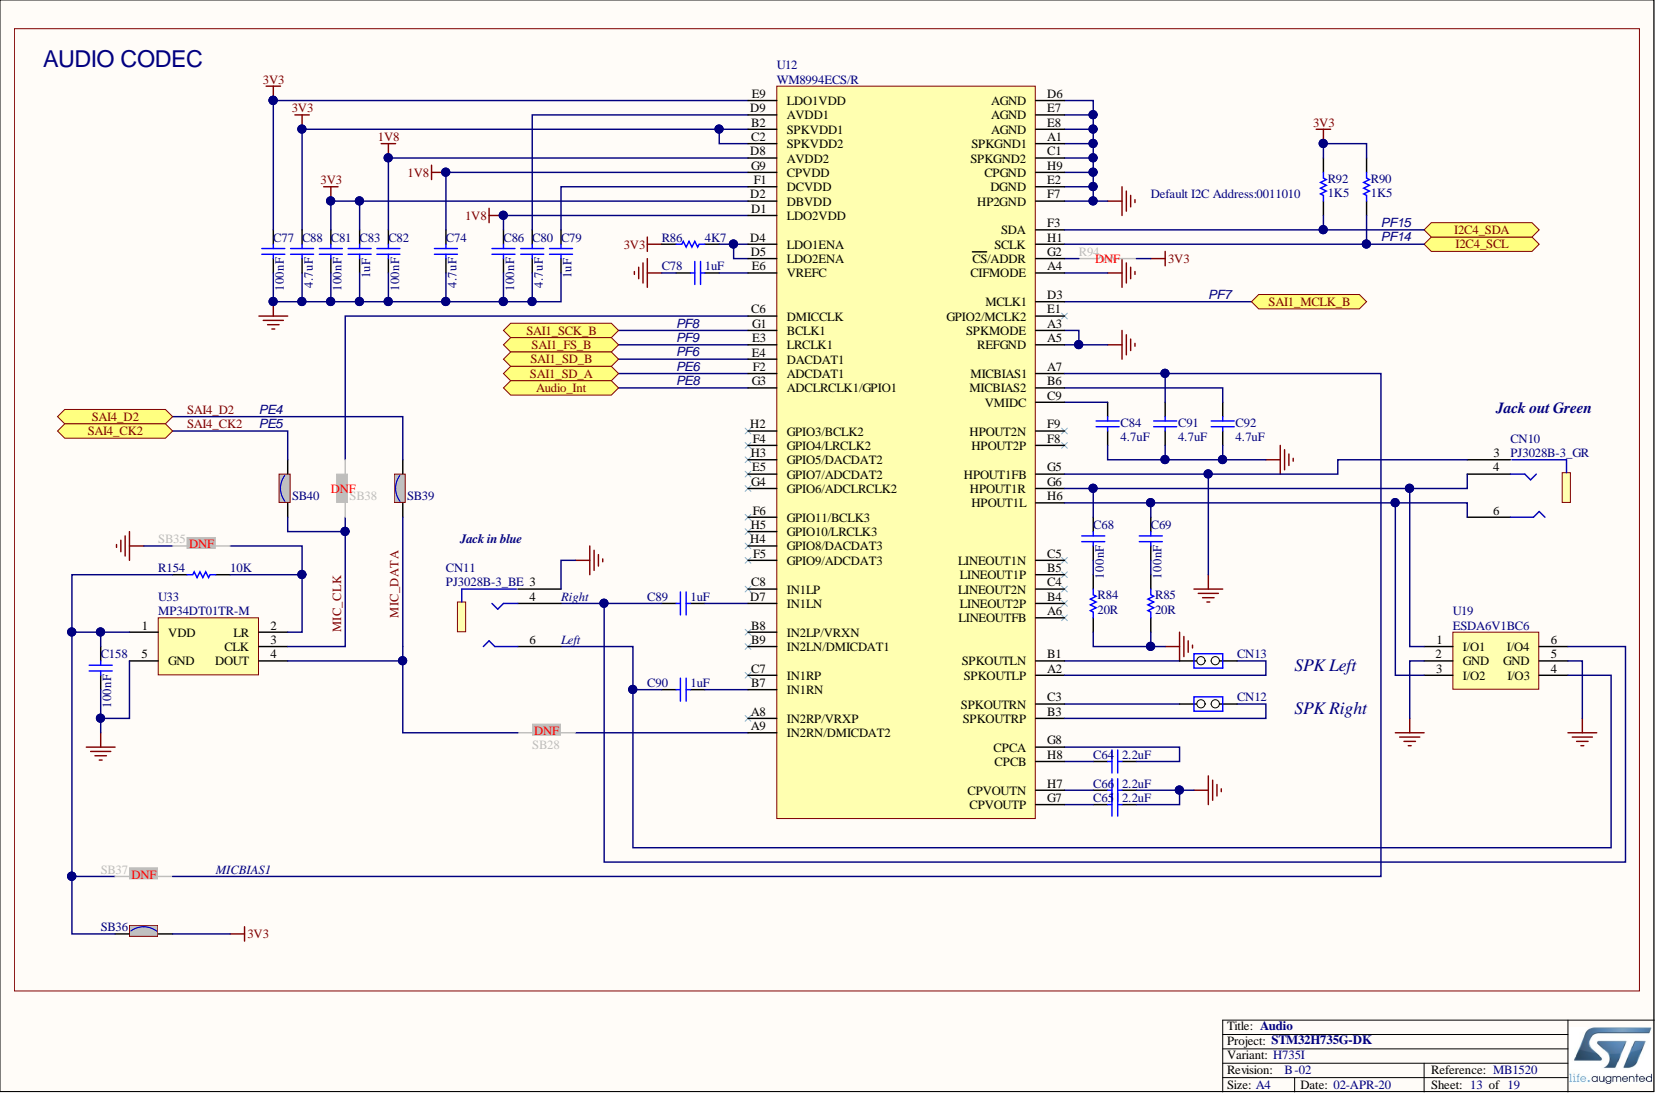
[picture p20: page 13]

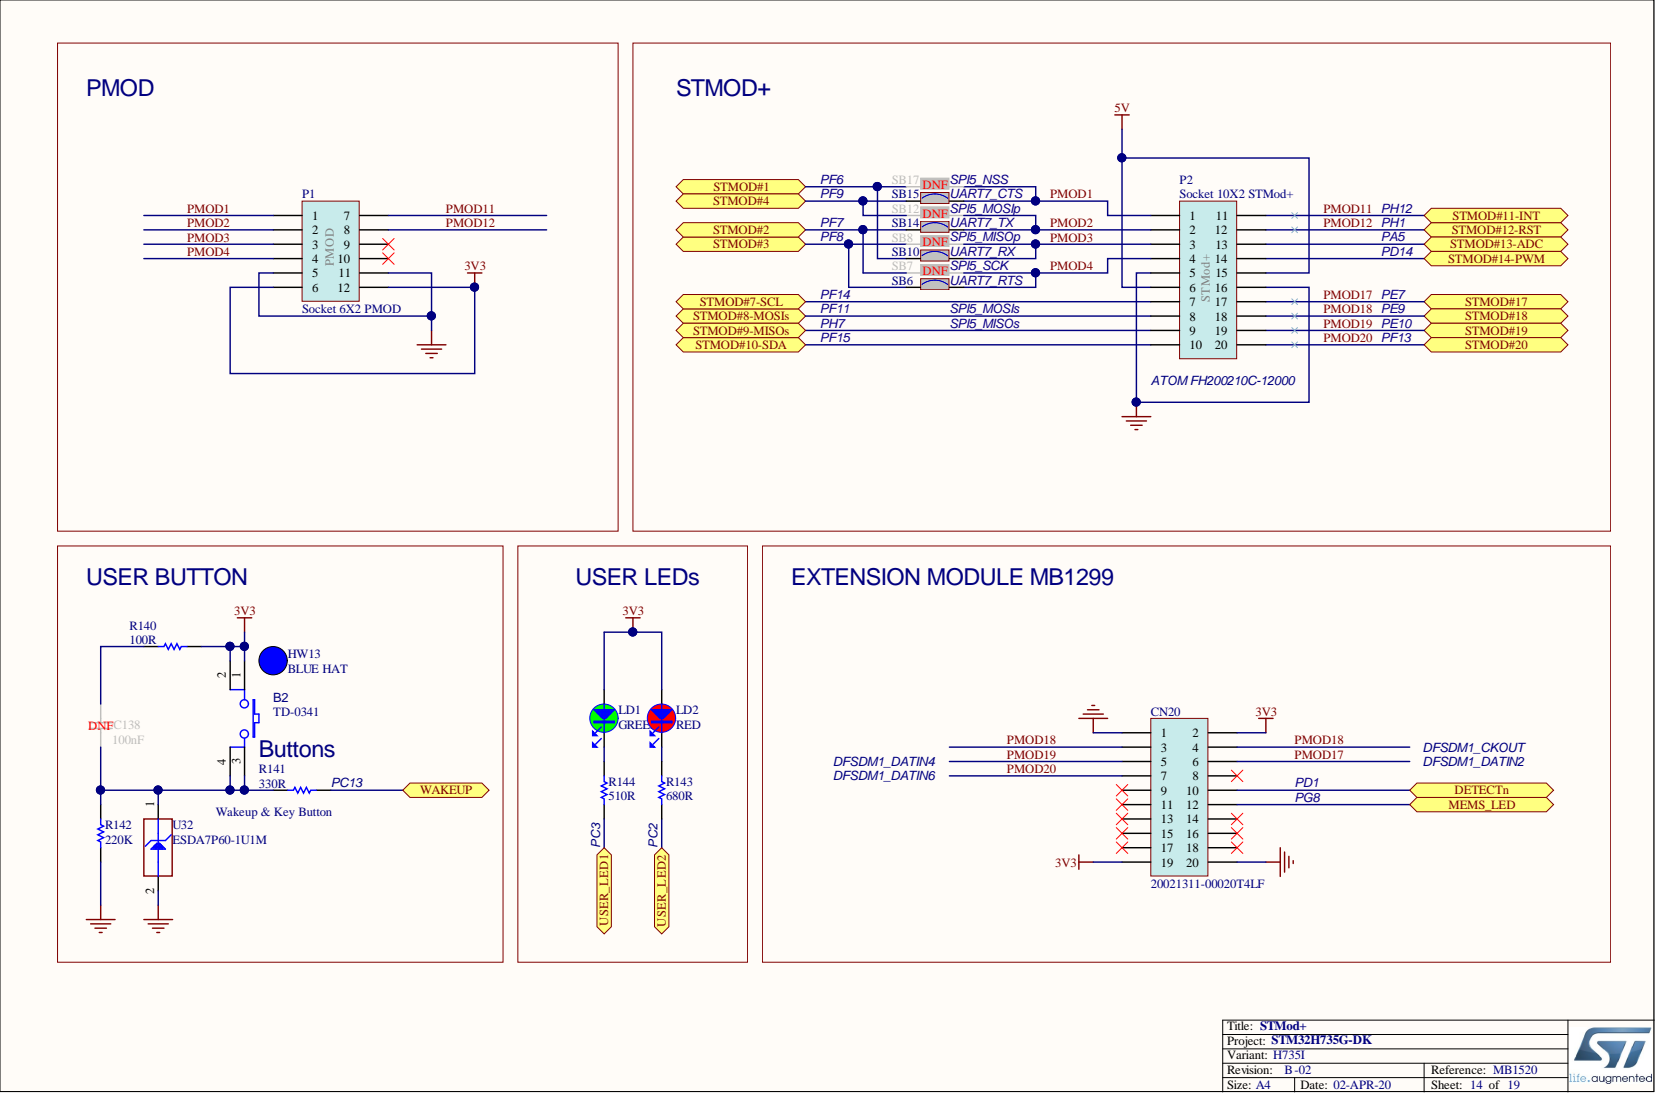
[picture p21: page 14]

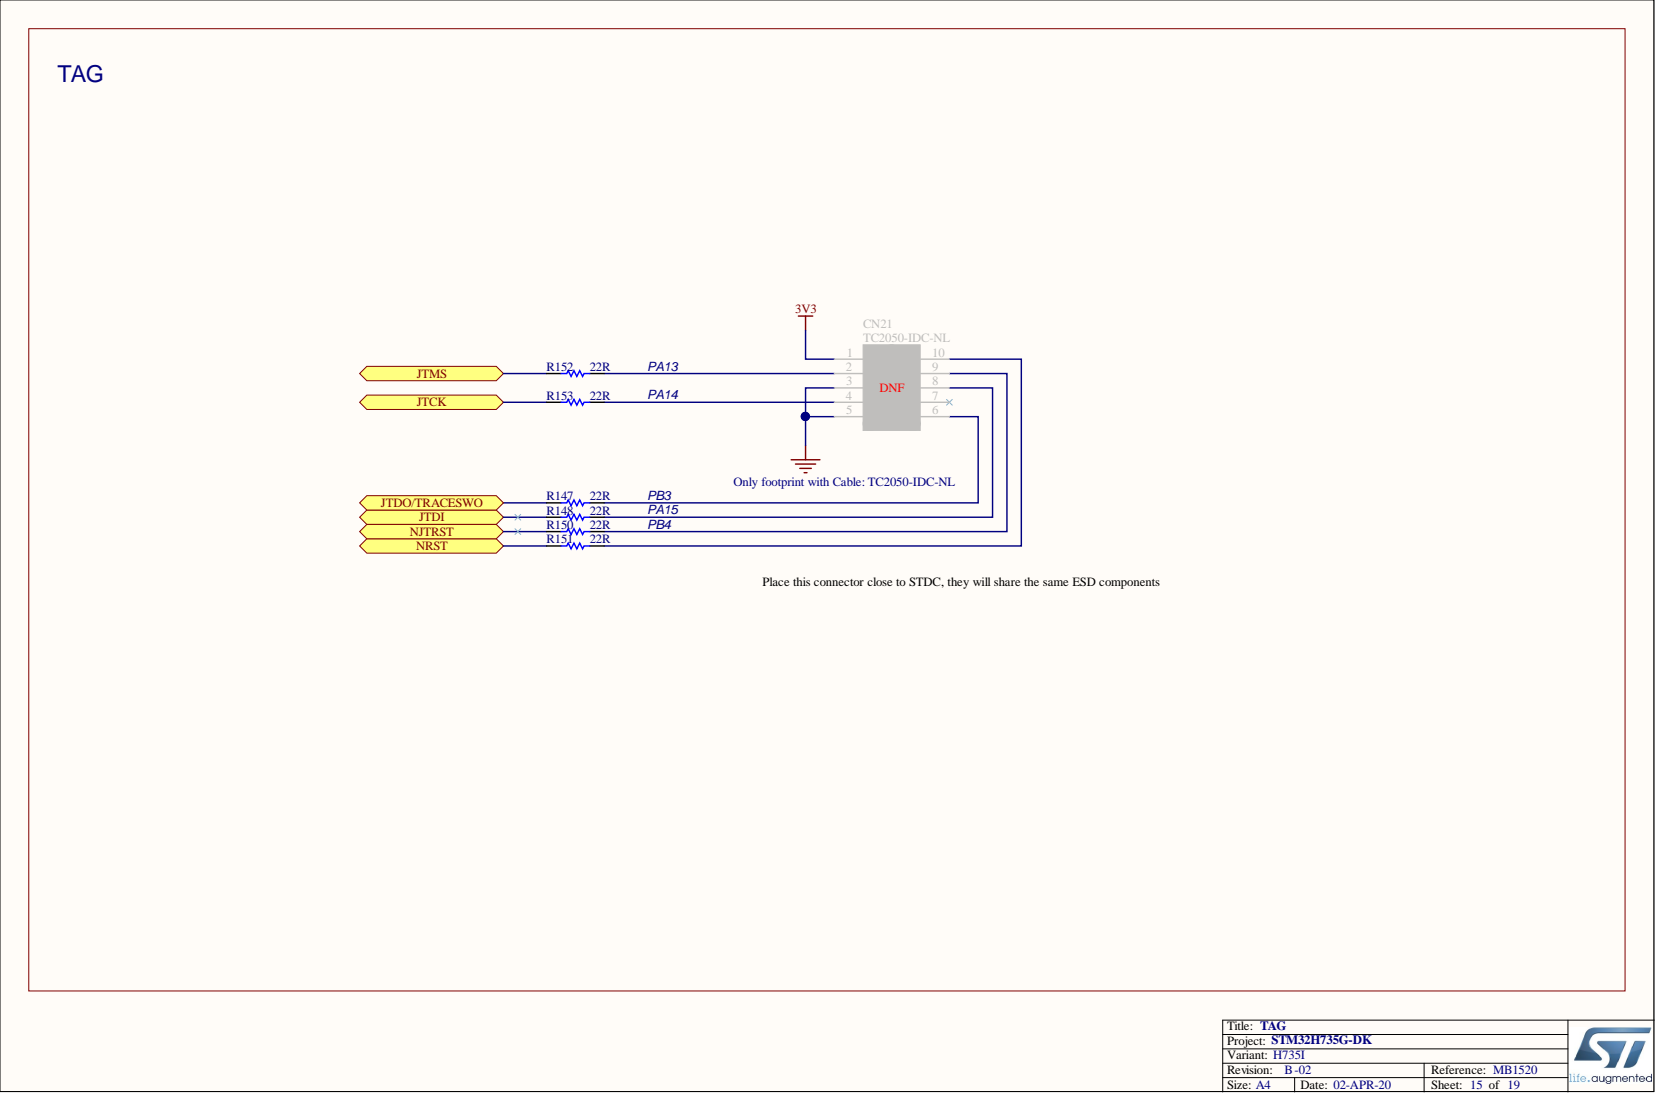
[picture p22: page 15]

PA13 2 | DNF | 9

Only footprint with Cable: TC2050-IDC-NL

Place this connector close to STDC, they will share the same ESD components

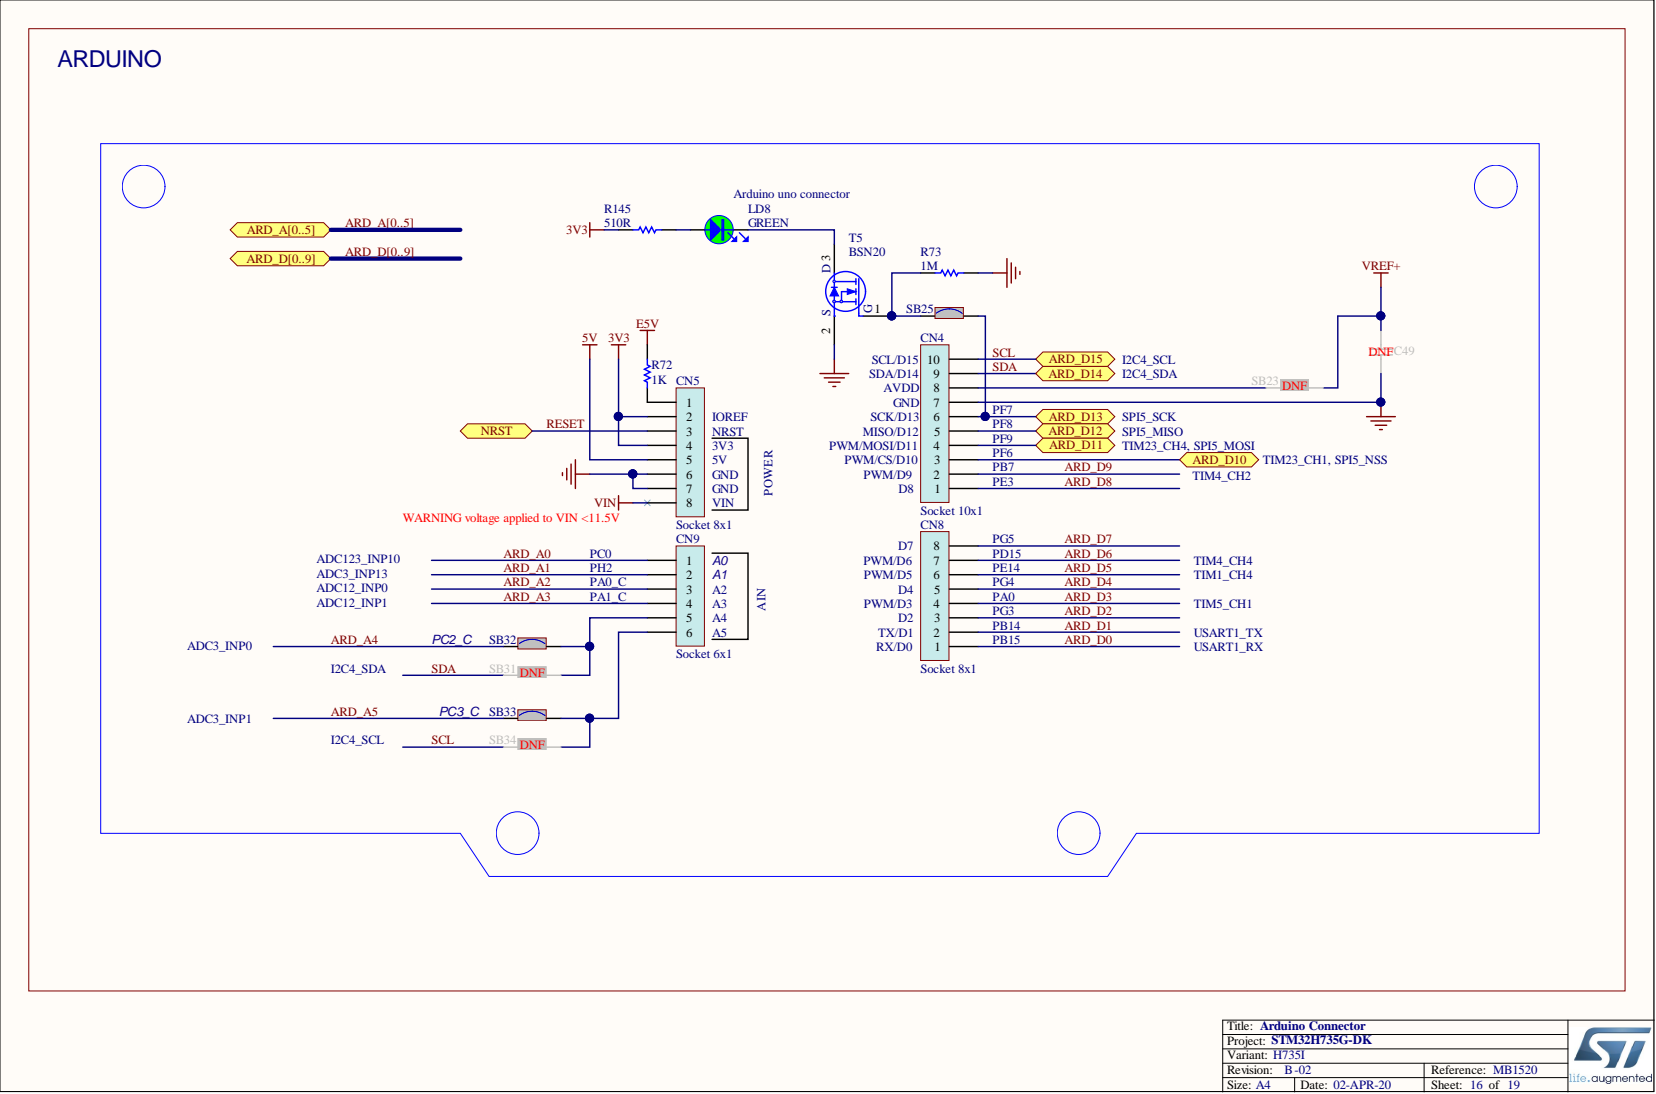
[picture p23: page 16]

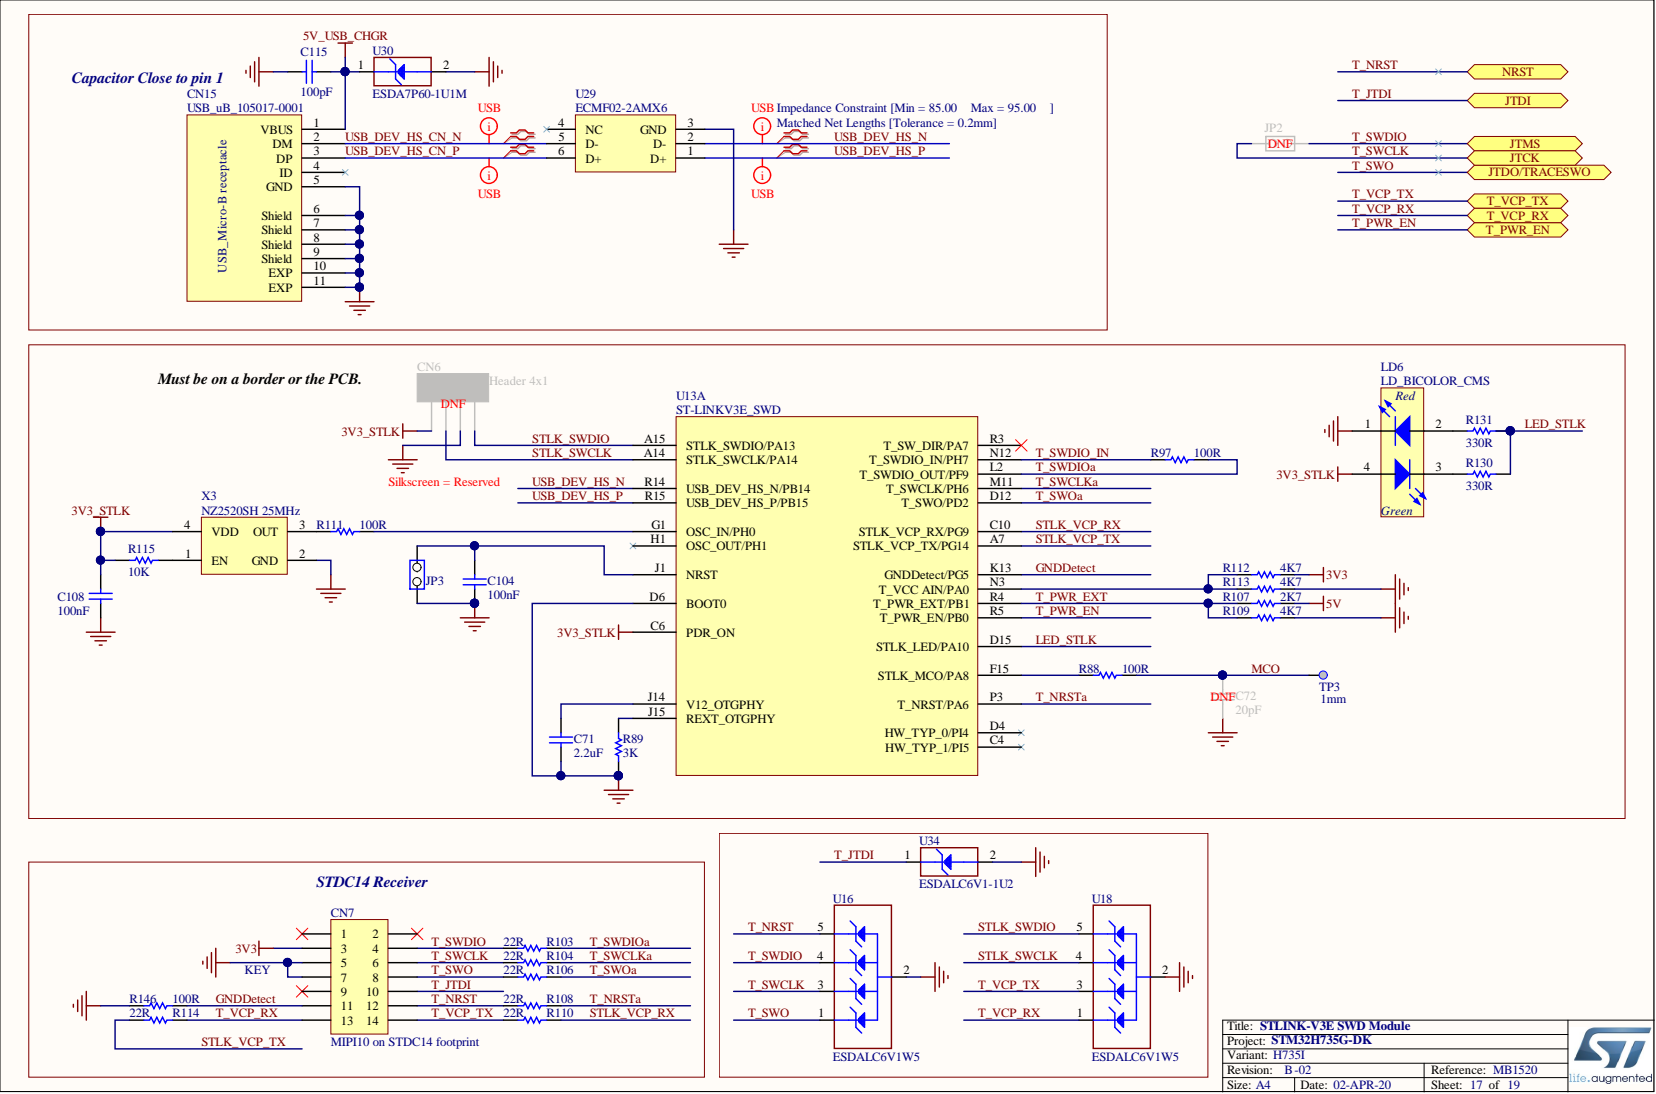
[picture p24: page 17]

Impedance Constraint [Min = 85.00 Max = 95.00 ]

Must be on a border or the PCB.

DNF

STLK_SWDIO

Title: STLINK-V3E SWD Module

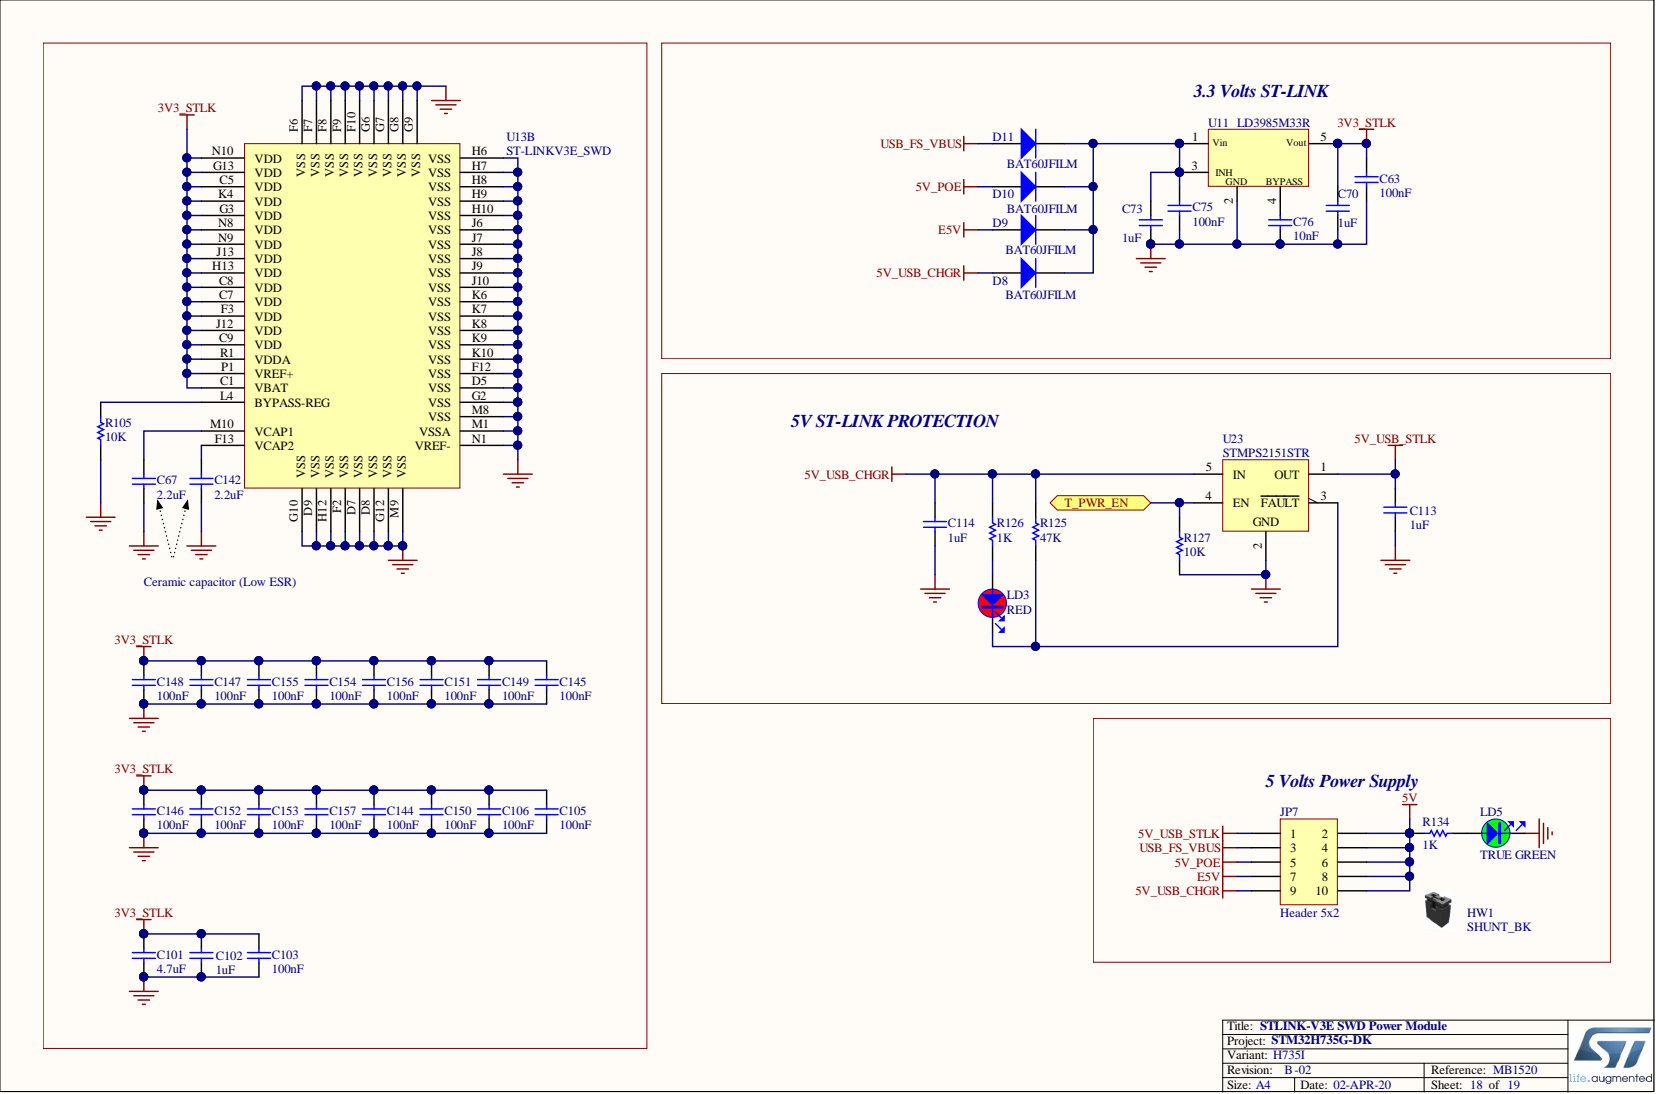
[picture p25: page 18]

VSS M9 VSS G12 VSS D8 VSS D7 VSS F2 VSS H12 VSS D9 VSS F6

VDD C9

VREF+ P1

Ceramic capacitor (Low ESR)

Title: STLINK-V3E SWD Power Module
