HB9GZE/PhasorRadio/KiCAD Files/BandpassFilter/BandpassFilter/plots/BandpassFilter__Assembly.pdf

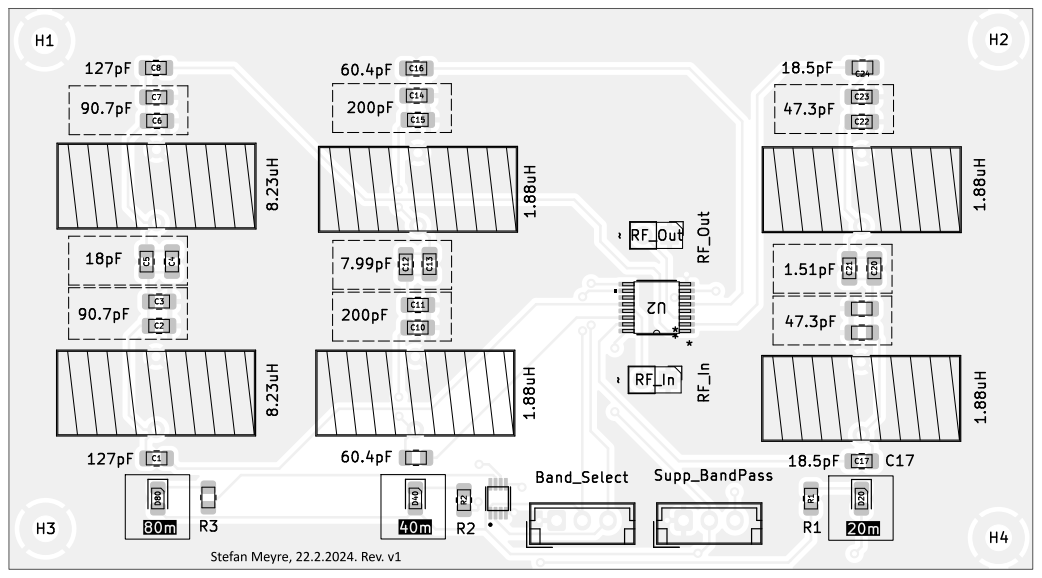
[picture p26: page 1]

Id: 1/1 Title: File: BandpassFilter.kicad_pcb Sheet:

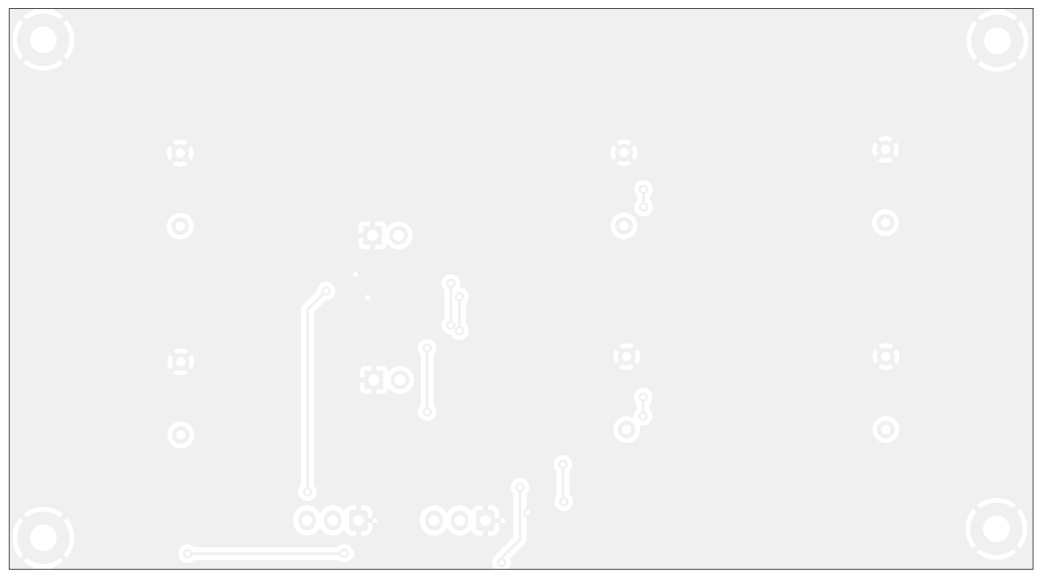
[picture p27: page 2]
D Date: KiCad; kicad; 7.0.9 Size: A4; Rev:

Id: 1/1 Title: File: BandpassFilter.kicad_pcb Sheet:
