HB9GZE/PhasorRadio/CustomSTM32H735Board/KiCADFiles/CustomSTM32H735_V2_Board/CustomSTM32H735_V2_Board/CustomSTM32H735_V2_Board.pdf

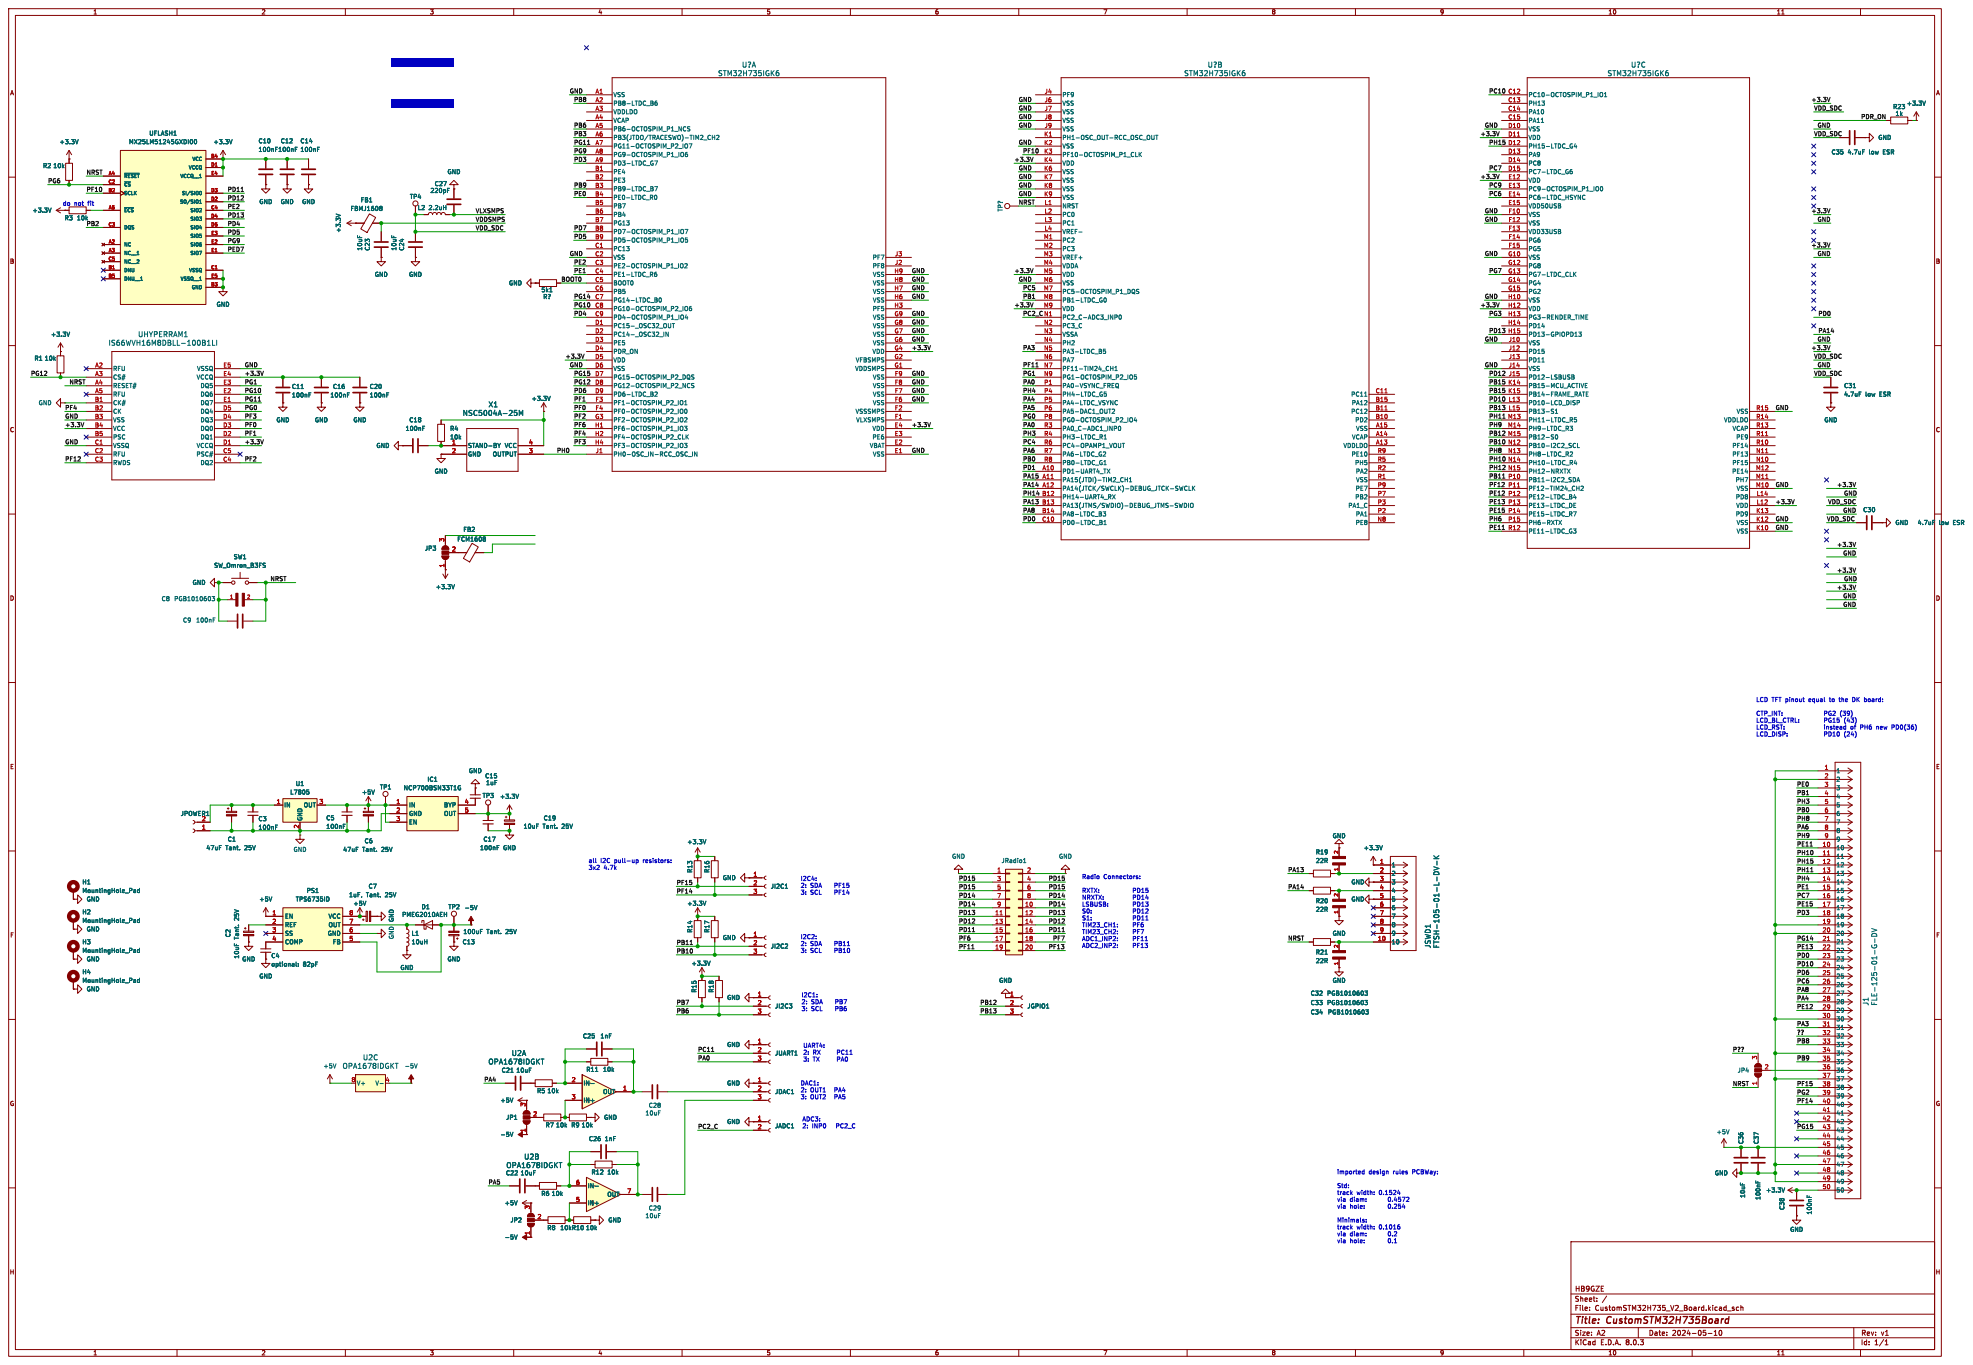
[picture p28: page 1]

Radio Connectors: RXTX: PD15 NRXTX: PD14

1 2 GND GND JSWD1 FTSH-105-01-L-DV-K

imported design rules PCBWay: Std:
