HB9GZE/PhasorRadio/(list of files, drawings)

Other design files:
CustomSTM32H735Board/KiCADFiles/CustomSTM32H735_V2_Board/CustomSTM32H735_V2_Board/freerouting.dsn
CustomSTM32H735Board/KiCADFiles/CustomSTM32H735_V2_Board/CustomSTM32H735_V2_Board/temp-freerouting.dsn
KiCAD Files/PhaseShifter/PhaseShifter/freerouting.dsn
KiCAD Files/PhaseShifter/PhaseShifter/temp-freerouting.dsn
