HB9GZE/PhasorRadio/KiCAD Files/Mixer/Mixer/Mixer.kicad_pcb

## KiCad design KiCAD Files/Mixer/Mixer/Mixer.kicad_pcb (2024-11-11)

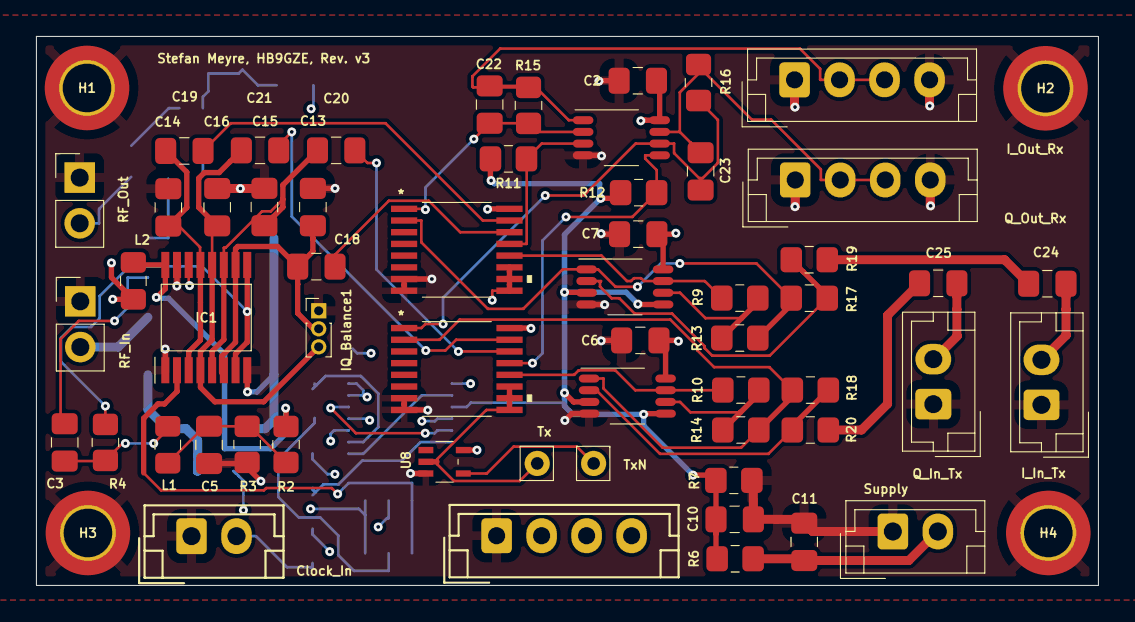
[picture p29: board Mixer.kicad_pcb from above]

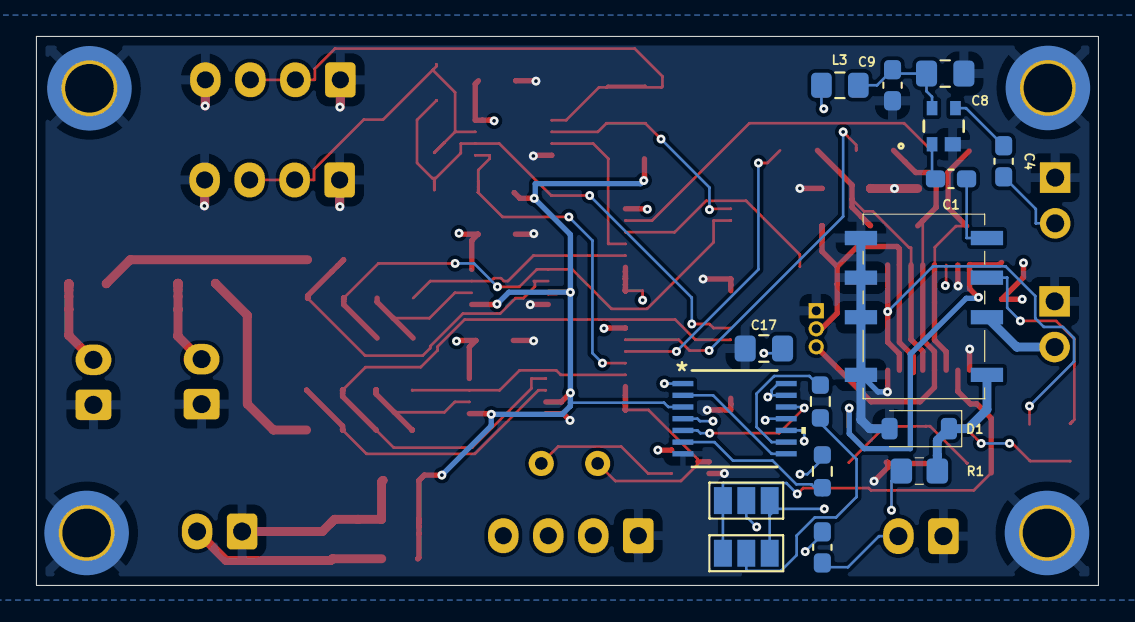
[picture p30: board Mixer.kicad_pcb from below]

Board: 4 copper layers, 59.0 x 30.5 mm, 77 parts (16 on the bottom side), 52 nets.

Parts:
C1, C4, C9, C12: 100nF; C_0603_1608Metric_Pad1.08x0.95mm_HandSolder
C2, C3, C5, C6, C7, C10, C11: 100nF; C_0805_2012Metric_Pad1.18x1.45mm_HandSolder
C8, C18, C19, C20, C21, C24, C25: 1uF; C_0805_2012Metric_Pad1.18x1.45mm_HandSolder
C13, C14, C15, C16: 47nF; C_0805_2012Metric_Pad1.18x1.45mm_HandSolder
C17: 10uF; C_0805_2012Metric_Pad1.18x1.45mm_HandSolder
C22, C23: 1.5nF; C_0805_2012Metric_Pad1.18x1.45mm_HandSolder
Clock_In: Conn_01x02_Socket; JST_EH_B2B-EH-A_1x02_P2.50mm_Vertical
D1: 1N4148W; D_SOD-123
H1, H2, H3, H4: MountingHole_Pad; MountingHole_2.7mm_M2.5_DIN965_Pad_TopBottom
IC1: FST3253MTCX; SOP65P640X110-16N
IQ_Balance1: Conn_01x03; PinHeader_1x03_P1.00mm_Vertical
I_In_Tx: Conn_01x02; JST_EH_B2B-EH-A_1x02_P2.50mm_Vertical
I_Out_Rx: Conn_01x04_Socket; JST_EH_B4B-EH-A_1x04_P2.50mm_Vertical
J1: Conn_01x04_Socket; JST_EH_B4B-EH-A_1x04_P2.50mm_Vertical
JP1, JP2: SolderJumper_3_Open; SolderJumper-3_P1.3mm_Open_Pad1.0x1.5mm_NumberLabels
K1: G6K-2F-Y DC3; G6K-2F-Y DC3_OMR
L1, L2, L3: 100u; L_0805_2012Metric_Pad1.15x1.40mm_HandSolder
Q_In_Tx: Conn_01x02; JST_EH_B2B-EH-A_1x02_P2.50mm_Vertical
Q_Out_Rx: Conn_01x04_Socket; JST_EH_B4B-EH-A_1x04_P2.50mm_Vertical
R1: 0R; R_0805_2012Metric_Pad1.20x1.40mm_HandSolder
R2, R3: 10k; R_0805_2012Metric_Pad1.20x1.40mm_HandSolder
R4: 47R; R_0805_2012Metric_Pad1.20x1.40mm_HandSolder
R5, R8: 100R; R_0603_1608Metric_Pad0.98x0.95mm_HandSolder
R6, R7: 1k; R_0805_2012Metric_Pad1.20x1.40mm_HandSolder
R9, R10, R11, R12, R13, R14, R15, R16, R17, R18, R19, R20: 10k 1%; R_0805_2012Metric_Pad1.20x1.40mm_HandSolder
RF_In: Conn_01x02; PinHeader_1x02_P2.54mm_Vertical
RF_Out: Conn_01x02; PinHeader_1x02_P2.54mm_Vertical
Supply: Conn_01x02_Socket; JST_EH_B2B-EH-A_1x02_P2.50mm_Vertical
Tx: TestPoint; Pin_D0.7mm_L6.5mm_W1.8mm_FlatFork
TxN: TestPoint; Pin_D0.7mm_L6.5mm_W1.8mm_FlatFork
U1: BGA420H6327XTSA1; PG-SOT343-4-1_INF
U2, U3, U4: OPA1678IDGKT; OPA1678_L
U5: SN74AC74PWR; 74AC74-L
U6, U7: 4053; TSSOP16_5P1X4P5_NEX
U8: NC7SZ04P5X; SC-88A-5_1P35X2P2_ONS

Connections:
+5V: C2.2, C6.2, C7.2, C11.2, C17.2, L2.1, L3.1, R6.2, Supply.2, U2.8 (V+), U3.8 (V+), U4.8 (V+), U5.1 (*1CLR), U5.4 (*1PRE), U5.10 (*2PRE), U5.13 (*2CLR), U5.14 (VCC), U6.16 (VDD), U7.16 (VDD), U8.5 (VCC)
/1: C13.2, C18.2, IC1.6 (1B1), IC1.10 (2B1), IQ_Balance1.2
/2: C15.2, C20.2, IC1.5 (1B2), IC1.11 (2B2)
/3: C16.2, C21.2, IC1.4 (1B3), IC1.12 (2B3), IQ_Balance1.3
/4: C14.2, C19.2, IC1.3 (1B4), IC1.13 (2B4)
/+2.5V: C10.2, C12.2, R6.1, R7.1, R11.2, R12.2, U3.3 (IN+), U3.5 (IN+), U4.3 (IN+), U4.5 (IN+), U5.3 (1CLK), U5.11 (2CLK)
/Clk_S0: JP2.2 (C), R8.1
/Clk_S1: JP1.2 (C), R5.2
/RF_IN_OUT: C3.1, K1.3
/RF_In: K1.2, RF_In.2
/RF_Out: C4.2, RF_Out.2
/S0: IC1.14 (S0), JP1.1 (A), JP2.1 (A)
/S1: IC1.2 (S1), JP1.3 (B), JP2.3 (B)
/Tx: J1.2, J1.3, Tx.1, U6.9 (C), U6.10 (B), U6.11 (A), U7.9 (C), U7.10 (B), U7.11 (A), U8.2 (A)
/TxN: J1.4, R1.2, TxN.1, U8.4 (Y)
GND: C2.1, C5.1, C6.1, C7.1, C8.1, C9.1, C10.1, C11.1, C13.1, C14.1, C15.1, C16.1, C17.1, Clock_In.1, D1.2 (A), H1.1, H2.1, H3.1, H4.1, IC1.1 (~OE1), IC1.8 (GND), IC1.15 (~OE2), IQ_Balance1.1, I_In_Tx.1, I_Out_Rx.1, I_Out_Rx.4, J1.1, K1.5, K1.6, K1.7, K1.8, Q_In_Tx.1, Q_Out_Rx.1, Q_Out_Rx.4, R3.2, R7.2, RF_In.1, RF_Out.1, Supply.1, U1.2 (GND), U2.4 (V-), U3.4 (V-), U4.4 (V-), U5.7 (GND), U6.7 (VEE), U6.8 (VSS), U7.7 (VEE), U7.8 (VSS), U8.3 (GND)
unnamed: C1.1, K1.4
unnamed: C3.2, L1.2, R4.1
unnamed: C5.2, L1.1, R2.2, R3.1
unnamed: C24.2, R19.2
unnamed: C25.2, R20.2
unnamed: C12.1, Clock_In.2
unnamed: D1.1 (K), K1.1, R1.1
unnamed: IC1.7 (1A), IC1.9 (2A), R4.2
unnamed: IC1.16 (VCC), L2.2, R2.1
unnamed: C24.1, I_In_Tx.2
unnamed: C22.1, I_Out_Rx.2, I_Out_Rx.3, R15.2, U2.1 (OUT)
unnamed: C25.1, Q_In_Tx.2
unnamed: C23.1, Q_Out_Rx.2, Q_Out_Rx.3, R16.2, U2.7 (OUT)
unnamed: C1.2, U1.1 (IN)
unnamed: C4.1, U1.3 (OUT)
unnamed: C8.2, C9.2, L3.2, U1.4 (VD)
unnamed: R11.1, U2.3 (IN+), U6.13 (X1)
unnamed: C22.2, R15.1, U2.2 (IN-), U6.1 (Y1)
unnamed: R12.1, U2.5 (IN+), U7.13 (X1)
unnamed: C23.2, R16.1, U2.6 (IN-), U7.1 (Y1)
unnamed: R17.2, R19.1, U3.2 (IN-)
unnamed: R13.2, R17.1, U3.1 (OUT), U6.2 (Y0)
unnamed: R9.2, R13.1, U3.6 (IN-)
unnamed: R9.1, U3.7 (OUT), U6.12 (X0)
unnamed: R18.2, R20.1, U4.2 (IN-)
unnamed: R14.2, R18.1, U4.1 (OUT), U7.2 (Y0)
unnamed: R10.2, R14.1, U4.6 (IN-)
unnamed: R10.1, U4.7 (OUT), U7.12 (X0)
unnamed: U5.5 (1Q), U5.12 (2D)
unnamed: R8.2, U5.9 (2Q)
unnamed: R5.1, U5.6 (*1Q)
unnamed: U5.2 (1D), U5.8 (*2Q)
unnamed: C18.1, U6.14 (X)
unnamed: C19.1, U6.15 (Y)
unnamed: C20.1, U7.14 (X)
unnamed: C21.1, U7.15 (Y)
