HB9GZE/PhasorRadio/KiCAD Files/Mixer2/Mixer2/Mixer2.kicad_pcb

## KiCad design KiCAD Files/Mixer2/Mixer2/Mixer2.kicad_pcb (2024-11-22)

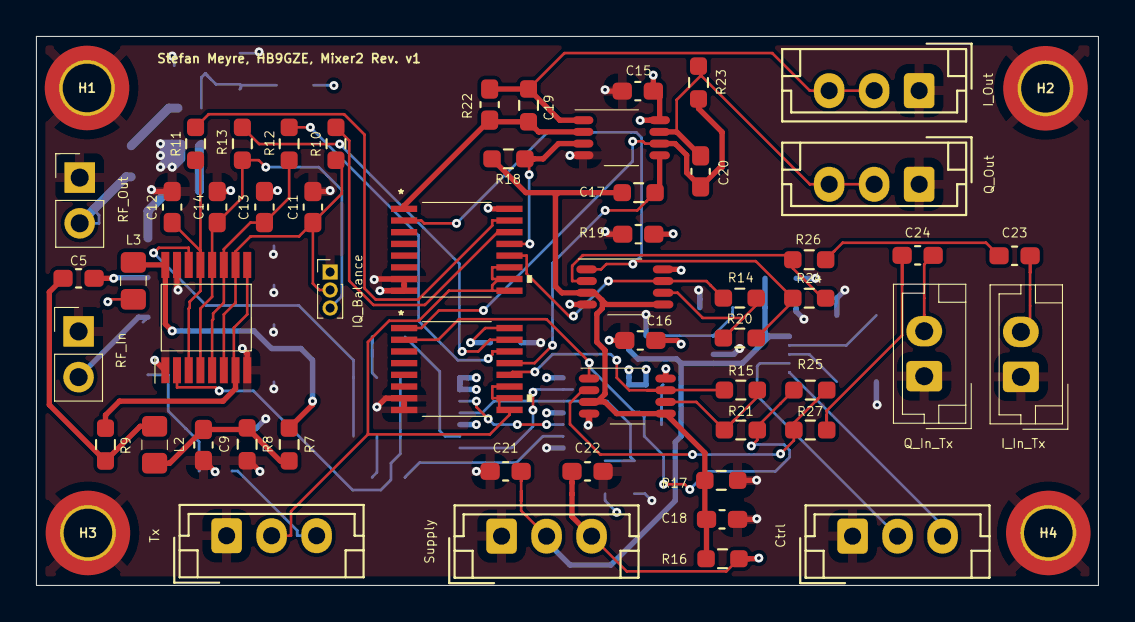
[picture p31: board Mixer2.kicad_pcb from above]

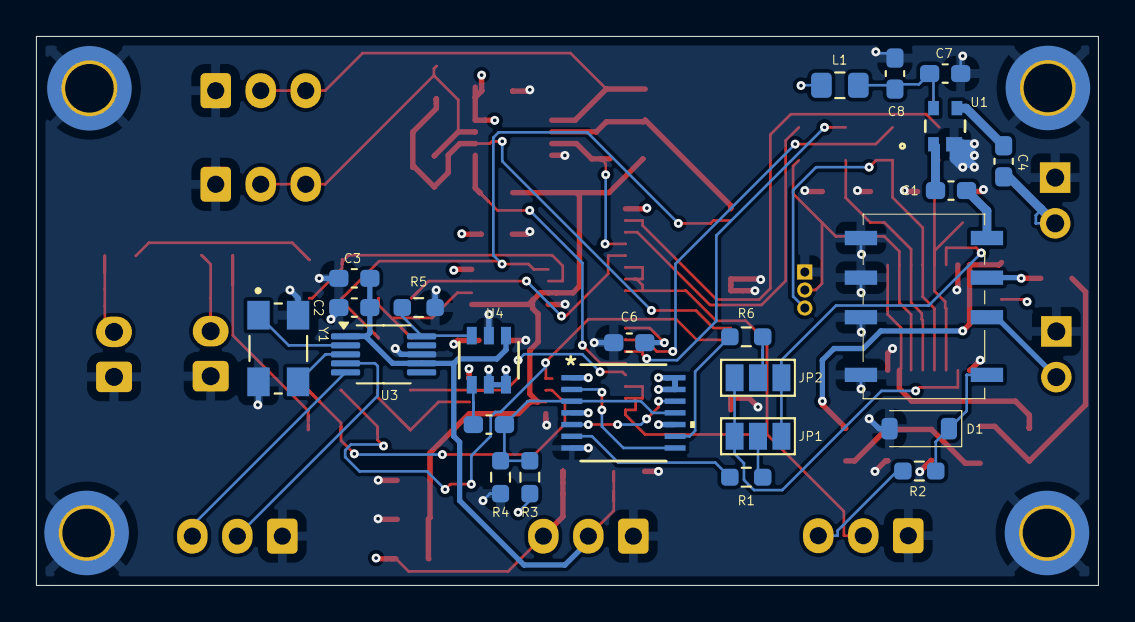
[picture p32: board Mixer2.kicad_pcb from below]

Board: 4 copper layers, 59.0 x 30.5 mm, 83 parts (24 on the bottom side), 59 nets.

Parts:
C1, C2, C3, C4, C5, C8, C9, C10, C15, C16, C17, C18, C21, C22: 100nF; C_0603_1608Metric_Pad1.08x0.95mm_HandSolder
C6: 10uF; C_0603_1608Metric_Pad1.08x0.95mm_HandSolder
C7, C23, C24: 1uF; C_0603_1608Metric_Pad1.08x0.95mm_HandSolder
C11, C12, C13, C14: 47nF; C_0603_1608Metric_Pad1.08x0.95mm_HandSolder
C19, C20: 1.5nF; C_0603_1608Metric_Pad1.08x0.95mm_HandSolder
Ctrl: Conn_01x03_Socket; JST_EH_B3B-EH-A_1x03_P2.50mm_Vertical
D1: 1N4148W; D_SOD-123
H1, H2, H3, H4: MountingHole_Pad; MountingHole_2.7mm_M2.5_DIN965_Pad_TopBottom
IC1: FST3253MTCX; SOP65P640X110-16N
IQ_Balance: Conn_01x03; PinHeader_1x03_P1.00mm_Vertical
I_In_Tx: Conn_01x02; JST_EH_B2B-EH-A_1x02_P2.50mm_Vertical
I_Out: I_Out; JST_EH_B3B-EH-A_1x03_P2.50mm_Vertical
JP1, JP2: SolderJumper_3_Open; SolderJumper-3_P1.3mm_Open_Pad1.0x1.5mm_NumberLabels
K1: G6K-2F-Y DC3; G6K-2F-Y DC3_OMR
L1, L2, L3: 100u; L_0805_2012Metric_Pad1.15x1.40mm_HandSolder
Q_In_Tx: Conn_01x02; JST_EH_B2B-EH-A_1x02_P2.50mm_Vertical
Q_Out: Q_Out; JST_EH_B3B-EH-A_1x03_P2.50mm_Vertical
R1, R6: 100R; R_0603_1608Metric_Pad0.98x0.95mm_HandSolder
R2: 0R; R_0603_1608Metric_Pad0.98x0.95mm_HandSolder
R3, R4, R7, R8, R16, R17: 10k; R_0603_1608Metric_Pad0.98x0.95mm_HandSolder
R5: DNF; R_0603_1608Metric_Pad0.98x0.95mm_HandSolder
R9, R10, R11, R12, R13: 47R; R_0603_1608Metric_Pad0.98x0.95mm_HandSolder
R14, R15, R18, R19, R20, R21, R22, R23, R24, R25, R26, R27: 10k 1%; R_0603_1608Metric_Pad0.98x0.95mm_HandSolder
RF_In: Conn_01x02; PinHeader_1x02_P2.54mm_Vertical
RF_Out: Conn_01x02; PinHeader_1x02_P2.54mm_Vertical
Supply: Supply; JST_EH_B3B-EH-A_1x03_P2.50mm_Vertical
Tx: Q_Out; JST_EH_B3B-EH-A_1x03_P2.50mm_Vertical
U1: BGA420H6327XTSA1; PG-SOT343-4-1_INF
U2: SN74AC74PWR; 74AC74-L
U3: Si5351A-B-GT; MSOP-10_3x3mm_P0.5mm
U4: TXU0101DBVR; SOT-23-6-DBV_TEX
U5, U6: 4053; TSSOP16_5P1X4P5_NEX
U7, U8, U9: OPA1678IDGKT; OPA1678_L
Y1: ECS-250-8-30B-CKM; XTAL_ECS-250-8-30B-CKM

Connections:
+3.3V: C2.2, C3.2, C21.2, Supply.2, U3.1 (VDD), U3.7 (VDDO), U4.1 (VCCA)
+5V: C6.2, C15.2, C16.2, C17.2, C22.2, L1.1, L3.1, R4.1, R16.2, Supply.3, U2.1 (*1CLR), U2.4 (*1PRE), U2.10 (*2PRE), U2.13 (*2CLR), U2.14 (VCC), U4.5 (OE), U4.6 (VCCB), U5.16 (VDD), U6.16 (VDD), U7.8 (V+), U8.8 (V+), U9.8 (V+)
/1: C11.2, IC1.6 (1B1), IC1.10 (2B1), IQ_Balance.2, R10.1
/2: C13.2, IC1.5 (1B2), IC1.11 (2B2), R12.1
/3: C14.2, IC1.4 (1B3), IC1.12 (2B3), IQ_Balance.3, R13.1
/4: C12.2, IC1.3 (1B4), IC1.13 (2B4), R11.1
/+2.5V: C18.2, R16.1, R17.1, R18.2, R19.2, U8.3 (IN+), U8.5 (IN+), U9.3 (IN+), U9.5 (IN+)
/Clk_S0: JP2.2 (C), R6.1
/Clk_S1: JP1.2 (C), R1.2
/RF_IN_OUT: C5.1, K1.3
/RF_In: K1.2, RF_In.2
/RF_Out: C4.2, RF_Out.2
/RawClk: R5.1, U3.10 (CLK0), U4.3 (A)
/S0: IC1.14 (S0), JP1.1 (A), JP2.1 (A)
/S1: IC1.2 (S1), JP1.3 (B), JP2.3 (B)
/SCL: Ctrl.2, U3.4 (SCL)
/SDA: Ctrl.3, U3.5 (SDA)
/SI5351CLK: C10.2, R3.1, R4.2, U2.3 (1CLK), U2.11 (2CLK)
/Tx: Tx.2, U5.9 (C), U5.10 (B), U5.11 (A), U6.9 (C), U6.10 (B), U6.11 (A)
/TxN: R2.2, Tx.3
GND: C2.1, C3.1, C6.1, C7.1, C8.1, C9.1, C11.1, C12.1, C13.1, C14.1, C15.1, C16.1, C17.1, C18.1, C21.1, C22.1, Ctrl.1, D1.2 (A), H1.1, H2.1, H3.1, H4.1, IC1.1 (~OE1), IC1.8 (GND), IC1.15 (~OE2), IQ_Balance.1, I_In_Tx.1, I_Out.1, K1.5, K1.6, K1.7, K1.8, Q_In_Tx.1, Q_Out.1, R3.2, R5.2, R8.2, R17.2, RF_In.1, RF_Out.1, Supply.1, Tx.1, U1.2 (GND), U2.7 (GND), U3.8 (GND), U4.2 (GND), U5.7 (VEE), U5.8 (VSS), U6.7 (VEE), U6.8 (VSS), U7.4 (V-), U8.4 (V-), U9.4 (V-), Y1.2 (GND), Y1.4 (GND__1)
unnamed: C1.1, K1.4
unnamed: C5.2, L2.2, R9.1
unnamed: C9.2, L2.1, R7.2, R8.1
unnamed: C23.2, R26.2
unnamed: C24.2, R27.2
unnamed: D1.1 (K), K1.1, R2.1
unnamed: IC1.7 (1A), IC1.9 (2A), R9.2
unnamed: IC1.16 (VCC), L3.2, R7.1
unnamed: C23.1, I_In_Tx.2
unnamed: C19.1, I_Out.2, I_Out.3, R22.2, U7.1 (OUT)
unnamed: C24.1, Q_In_Tx.2
unnamed: C20.1, Q_Out.2, Q_Out.3, R23.2, U7.7 (OUT)
unnamed: C1.2, U1.1 (IN)
unnamed: C4.1, U1.3 (OUT)
unnamed: C7.2, C8.2, L1.2, U1.4 (VD)
unnamed: U2.5 (1Q), U2.12 (2D)
unnamed: R6.2, U2.9 (2Q)
unnamed: R1.1, U2.6 (*1Q)
unnamed: U2.2 (1D), U2.8 (*2Q)
unnamed: U3.2 (XA), Y1.1 (IN/OUT)
unnamed: U3.3 (XB), Y1.3 (OUT/IN)
unnamed: C10.1, U4.4 (BY)
unnamed: R14.1, U5.12 (X0), U8.7 (OUT)
unnamed: R18.1, U5.13 (X1), U7.3 (IN+)
unnamed: R10.2, U5.14 (X)
unnamed: R20.2, R24.1, U5.2 (Y0), U8.1 (OUT)
unnamed: C19.2, R22.1, U5.1 (Y1), U7.2 (IN-)
unnamed: R11.2, U5.15 (Y)
unnamed: R15.1, U6.12 (X0), U9.7 (OUT)
unnamed: R19.1, U6.13 (X1), U7.5 (IN+)
unnamed: R12.2, U6.14 (X)
unnamed: R21.2, R25.1, U6.2 (Y0), U9.1 (OUT)
unnamed: C20.2, R23.1, U6.1 (Y1), U7.6 (IN-)
unnamed: R13.2, U6.15 (Y)
unnamed: R24.2, R26.1, U8.2 (IN-)
unnamed: R14.2, R20.1, U8.6 (IN-)
unnamed: R25.2, R27.1, U9.2 (IN-)
unnamed: R15.2, R21.1, U9.6 (IN-)
