HB9GZE/PhasorRadio/KiCAD Files/DigiAudio/DigiAudio.kicad_pcb

## KiCad design KiCAD Files/DigiAudio/DigiAudio.kicad_pcb (2024-05-30)

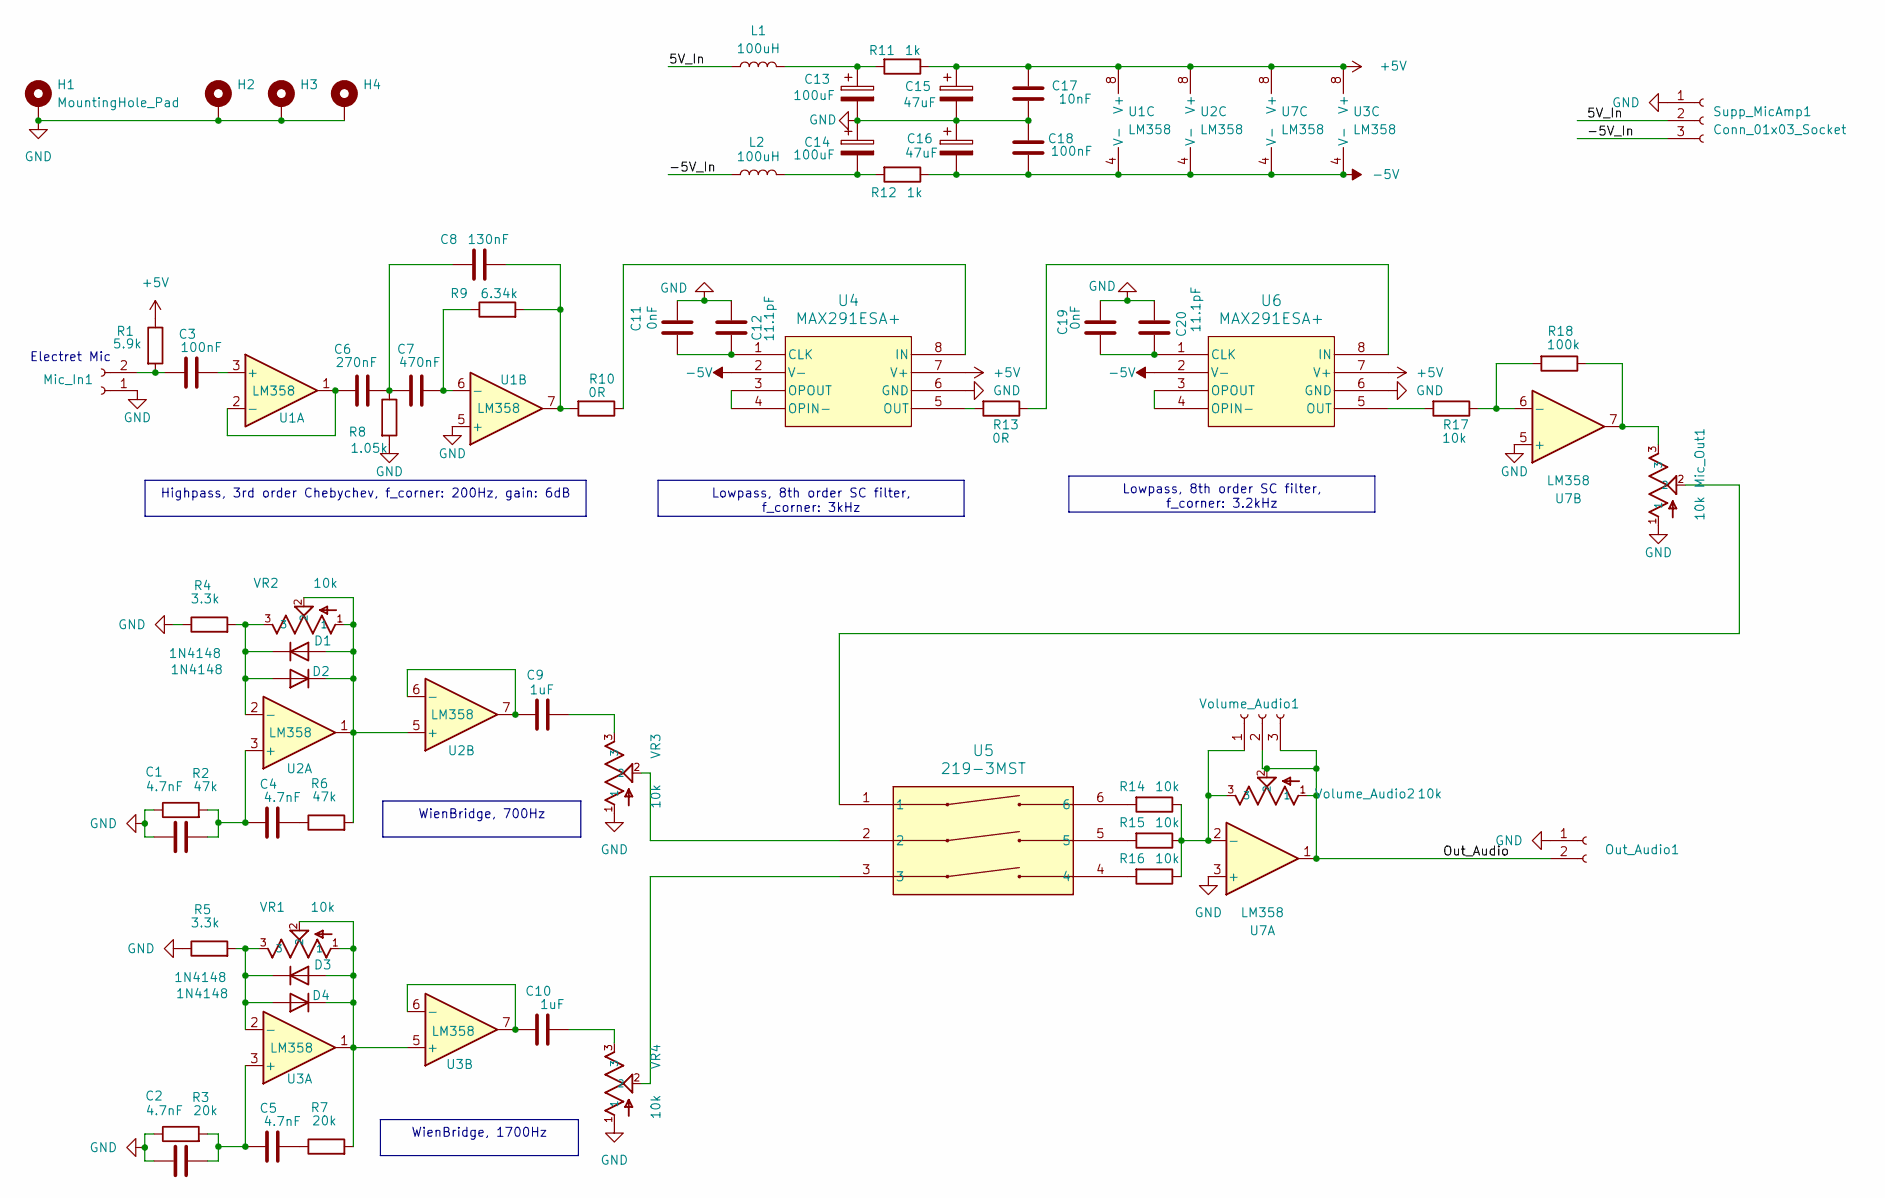
[picture p33: schematic DigiAudio.kicad_sch, Phasor Radio: Digital Audio]

Parts:
C1, C2, C4, C5: 4.7nF; C_0805_2012Metric_Pad1.18x1.45mm_HandSolder
C3, C18: 100nF; C_0805_2012Metric_Pad1.18x1.45mm_HandSolder
C6: 270nF; C_0805_2012Metric_Pad1.18x1.45mm_HandSolder
C7: 470nF; C_0805_2012Metric_Pad1.18x1.45mm_HandSolder
C8: 130nF; C_0805_2012Metric_Pad1.18x1.45mm_HandSolder
C9, C10: 1uF; C_0805_2012Metric_Pad1.18x1.45mm_HandSolder
C11, C19: 0nF; C_0805_2012Metric_Pad1.18x1.45mm_HandSolder
C12, C20: 11.1pF; C_0805_2012Metric_Pad1.18x1.45mm_HandSolder
C13, C14: 100uF; CP_EIA-3216-12_Kemet-S_Pad1.58x1.35mm_HandSolder
C15, C16: 47uF; CP_EIA-3216-12_Kemet-S_Pad1.58x1.35mm_HandSolder
C17: 10nF; C_0805_2012Metric_Pad1.18x1.45mm_HandSolder
D1, D2, D3, D4: 1N4148; D_SOD-123
H1, H2, H3, H4: MountingHole_Pad; MountingHole_2.5mm_Pad_TopBottom
L1, L2: 100uH; L_0805_2012Metric_Pad1.15x1.40mm_HandSolder
Mic_In1: Conn_01x02_Socket; JST_EH_B2B-EH-A_1x02_P2.50mm_Vertical
Mic_Out1: 10k; TRIM_35WR10KLFTR
Out_Audio1: Conn_01x02_Socket; JST_EH_B2B-EH-A_1x02_P2.50mm_Vertical
R1: 5.9k; R_0805_2012Metric_Pad1.20x1.40mm_HandSolder
R2, R6: 47k; R_0805_2012Metric_Pad1.20x1.40mm_HandSolder
R3, R7: 20k; R_0805_2012Metric_Pad1.20x1.40mm_HandSolder
R4, R5: 3.3k; R_0805_2012Metric_Pad1.20x1.40mm_HandSolder
R8: 1.05k; R_0805_2012Metric_Pad1.20x1.40mm_HandSolder
R9: 6.34k; R_0805_2012Metric_Pad1.20x1.40mm_HandSolder
R10, R13: 0R; R_0805_2012Metric_Pad1.20x1.40mm_HandSolder
R11, R12: 1k; R_0805_2012Metric_Pad1.20x1.40mm_HandSolder
R14, R15, R16, R17: 10k; R_0805_2012Metric_Pad1.20x1.40mm_HandSolder
R18: 100k; R_0805_2012Metric_Pad1.20x1.40mm_HandSolder
Supp_MicAmp1: Conn_01x03_Socket; JST_EH_B3B-EH-A_1x03_P2.50mm_Vertical
U1, U2, U3, U7: LM358; SOIC-8_3.9x4.9mm_P1.27mm
U4, U6: MAX291ESA+; MAX291
U5: 219-3MST; SW3_219-3MST_CTS
VR1, VR2, VR3, VR4: 10k; TRIM_35WR10KLFTR
Volume_Audio1: Conn_01x03_Socket; JST_EH_B3B-EH-A_1x03_P2.50mm_Vertical
Volume_Audio2: 10k; TRIM_35WR10KLFTR

Connections:
+5V: C15.1, C17.2, R1.1, R11.1, U1.8 (V+), U2.8 (V+), U3.8 (V+), U4.7 (V+), U6.7 (V+), U7.8 (V+)
-5V: C16.2, C18.1, R12.1, U1.4 (V-), U2.4 (V-), U3.4 (V-), U4.2 (V-), U6.2 (V-), U7.4 (V-)
/5V_In: L1.1, Supp_MicAmp1.2
/-5V_In: L2.1, Supp_MicAmp1.3
/Out_Audio: Out_Audio1.2, U7.1, Volume_Audio1.2, Volume_Audio1.3, Volume_Audio2.1, Volume_Audio2.2; also elsewhere on the board
GND: C1.1, C2.1, C11.2, C12.2, C13.2, C14.1, C15.2, C16.1, C17.1, C18.2, C19.2, C20.2, H1.1, H2.1, H3.1, H4.1, Mic_In1.1, Mic_Out1.1, Out_Audio1.1, R2.1, R3.1, R4.1, R5.1, R8.2, Supp_MicAmp1.1, U1.5 (+), U4.6 (GND), U6.6 (GND), U7.3 (+), U7.5 (+), VR3.1, VR4.1; also elsewhere on the board
unnamed: C4.2, R6.1
unnamed: C5.2, R7.1
unnamed: C6.2, C7.1, C8.1, R8.1
unnamed: C8.2, R9.2, R10.2, U1.7
unnamed: C9.2, VR3.3
unnamed: C10.2, VR4.3
unnamed: C13.1, L1.2, R11.2
unnamed: C14.2, L2.2, R12.2
unnamed: D1.2 (A), D2.1 (K), R6.2, U2.1, U2.5 (+), VR2.1, VR2.2
unnamed: D1.1 (K), D2.2 (A), R4.2, U2.2 (-), VR2.3
unnamed: D3.2 (A), D4.1 (K), R7.2, U3.1, U3.5 (+), VR1.1, VR1.2
unnamed: D3.1 (K), D4.2 (A), R5.2, U3.2 (-), VR1.3
unnamed 18: C3.1, Mic_In1.2, R1.2; also elsewhere on the board
unnamed 19: Mic_Out1.2, U5.1; also elsewhere on the board
unnamed 20: Mic_Out1.3, R18.1, U7.7; also elsewhere on the board
unnamed: R14.2, U5.6
unnamed: R15.2, U5.5
unnamed: R16.2, U5.4
unnamed: C3.2, U1.3 (+)
unnamed: C6.1, U1.1, U1.2 (-)
unnamed: C7.2, R9.1, U1.6 (-)
unnamed: C1.2, C4.1, R2.2, U2.3 (+)
unnamed: C9.1, U2.6 (-), U2.7
unnamed: C2.2, C5.1, R3.2, U3.3 (+)
unnamed: C10.1, U3.6 (-), U3.7
unnamed: C11.1, C12.1, U4.1 (CLK)
unnamed: R10.1, U4.8 (IN)
unnamed: U4.3 (OPOUT), U4.4 (OPIN-)
unnamed: R13.2, U4.5 (OUT)
unnamed: U5.2, VR3.2
unnamed: U5.3, VR4.2
unnamed: C19.1, C20.1, U6.1 (CLK)
unnamed: R13.1, U6.8 (IN)
unnamed: U6.3 (OPOUT), U6.4 (OPIN-)
unnamed: R17.2, U6.5 (OUT)
unnamed 41: R14.1, R15.1, R16.1, U7.2 (-), Volume_Audio1.1, Volume_Audio2.3; also elsewhere on the board
unnamed: R17.1, R18.2, U7.6 (-)

Notes on the sheet:
Lowpass, 8th order SC filter, f_corner: 3kHz
WienBridge, 1700Hz
Highpass, 3rd order Chebychev, f_corner: 200Hz, gain: 6dB
WienBridge, 700Hz
Lowpass, 8th order SC filter, f_corner: 3.2kHz
Electret Mic

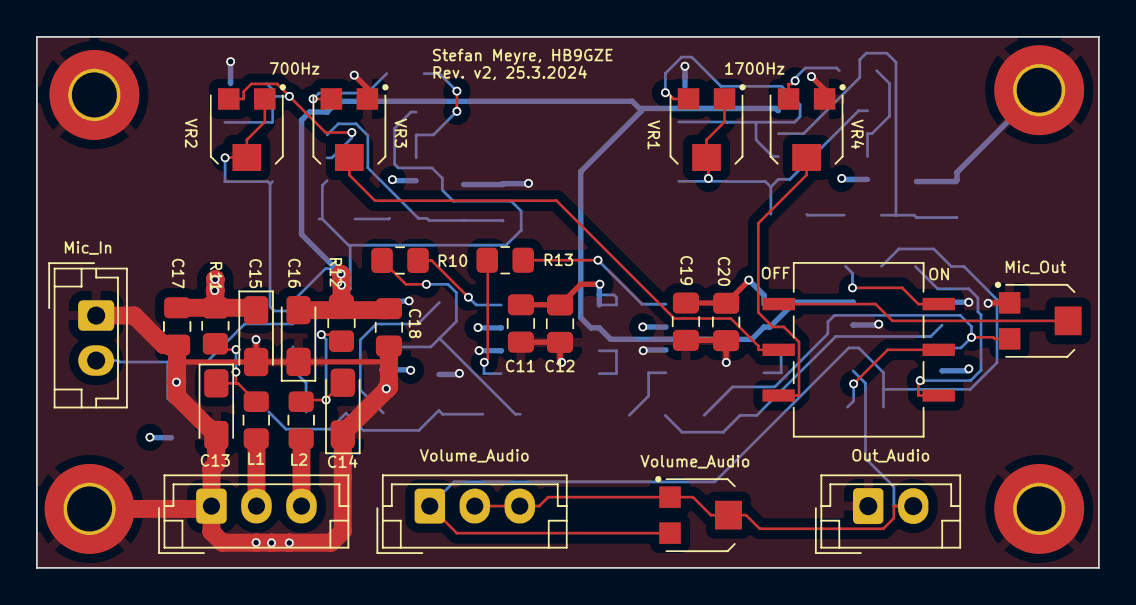
[picture p34: board DigiAudio.kicad_pcb from above]

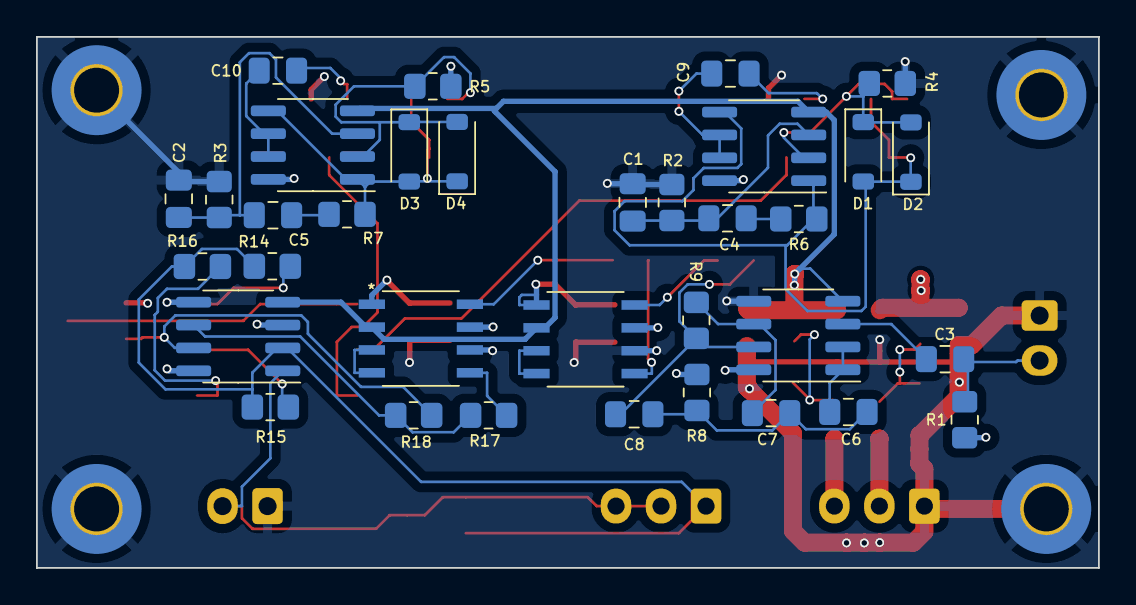
[picture p35: board DigiAudio.kicad_pcb from below]

Board: 4 copper layers, 59.0 x 29.5 mm, 65 parts (34 on the bottom side), 43 nets.

Other parts of the board:
Mic_In: Conn_01x02_Socket; JST_EH_B2B-EH-A_1x02_P2.50mm_Vertical
Mic_Out: 10k; TRIM_35WR10KLFTR
Out_Audio: Conn_01x02_Socket; JST_EH_B2B-EH-A_1x02_P2.50mm_Vertical
Volume_Audio: 10k; TRIM_35WR10KLFTR
Volume_Audio#2: Conn_01x03_Socket; JST_EH_B3B-EH-A_1x03_P2.50mm_Vertical

Their connections:
/Out_Audio: Out_Audio.2, Volume_Audio.1, Volume_Audio.2, Volume_Audio#2.2, Volume_Audio#2.3; also elsewhere on the board
GND: Mic_In.1, Mic_Out.1, Out_Audio.1; also elsewhere on the board
unnamed 18: Mic_In.2; also elsewhere on the board
unnamed 19: Mic_Out.2; also elsewhere on the board
unnamed 20: Mic_Out.3; also elsewhere on the board
unnamed 41: Volume_Audio.3, Volume_Audio#2.1; also elsewhere on the board
