HB9GZE/PhasorRadio/CustomSTM32H735Board/KiCADFiles/CustomSTM32H735_V2_Board/CustomSTM32H735_V2_Board/CustomSTM32H735_V2_Board.kicad_pcb

## KiCad design CustomSTM32H735Board/KiCADFiles/CustomSTM32H735_V2_Board/CustomSTM32H735_V2_Board/CustomSTM32H735_V2_Board.kicad_pcb (2024-11-03, an earlier design)

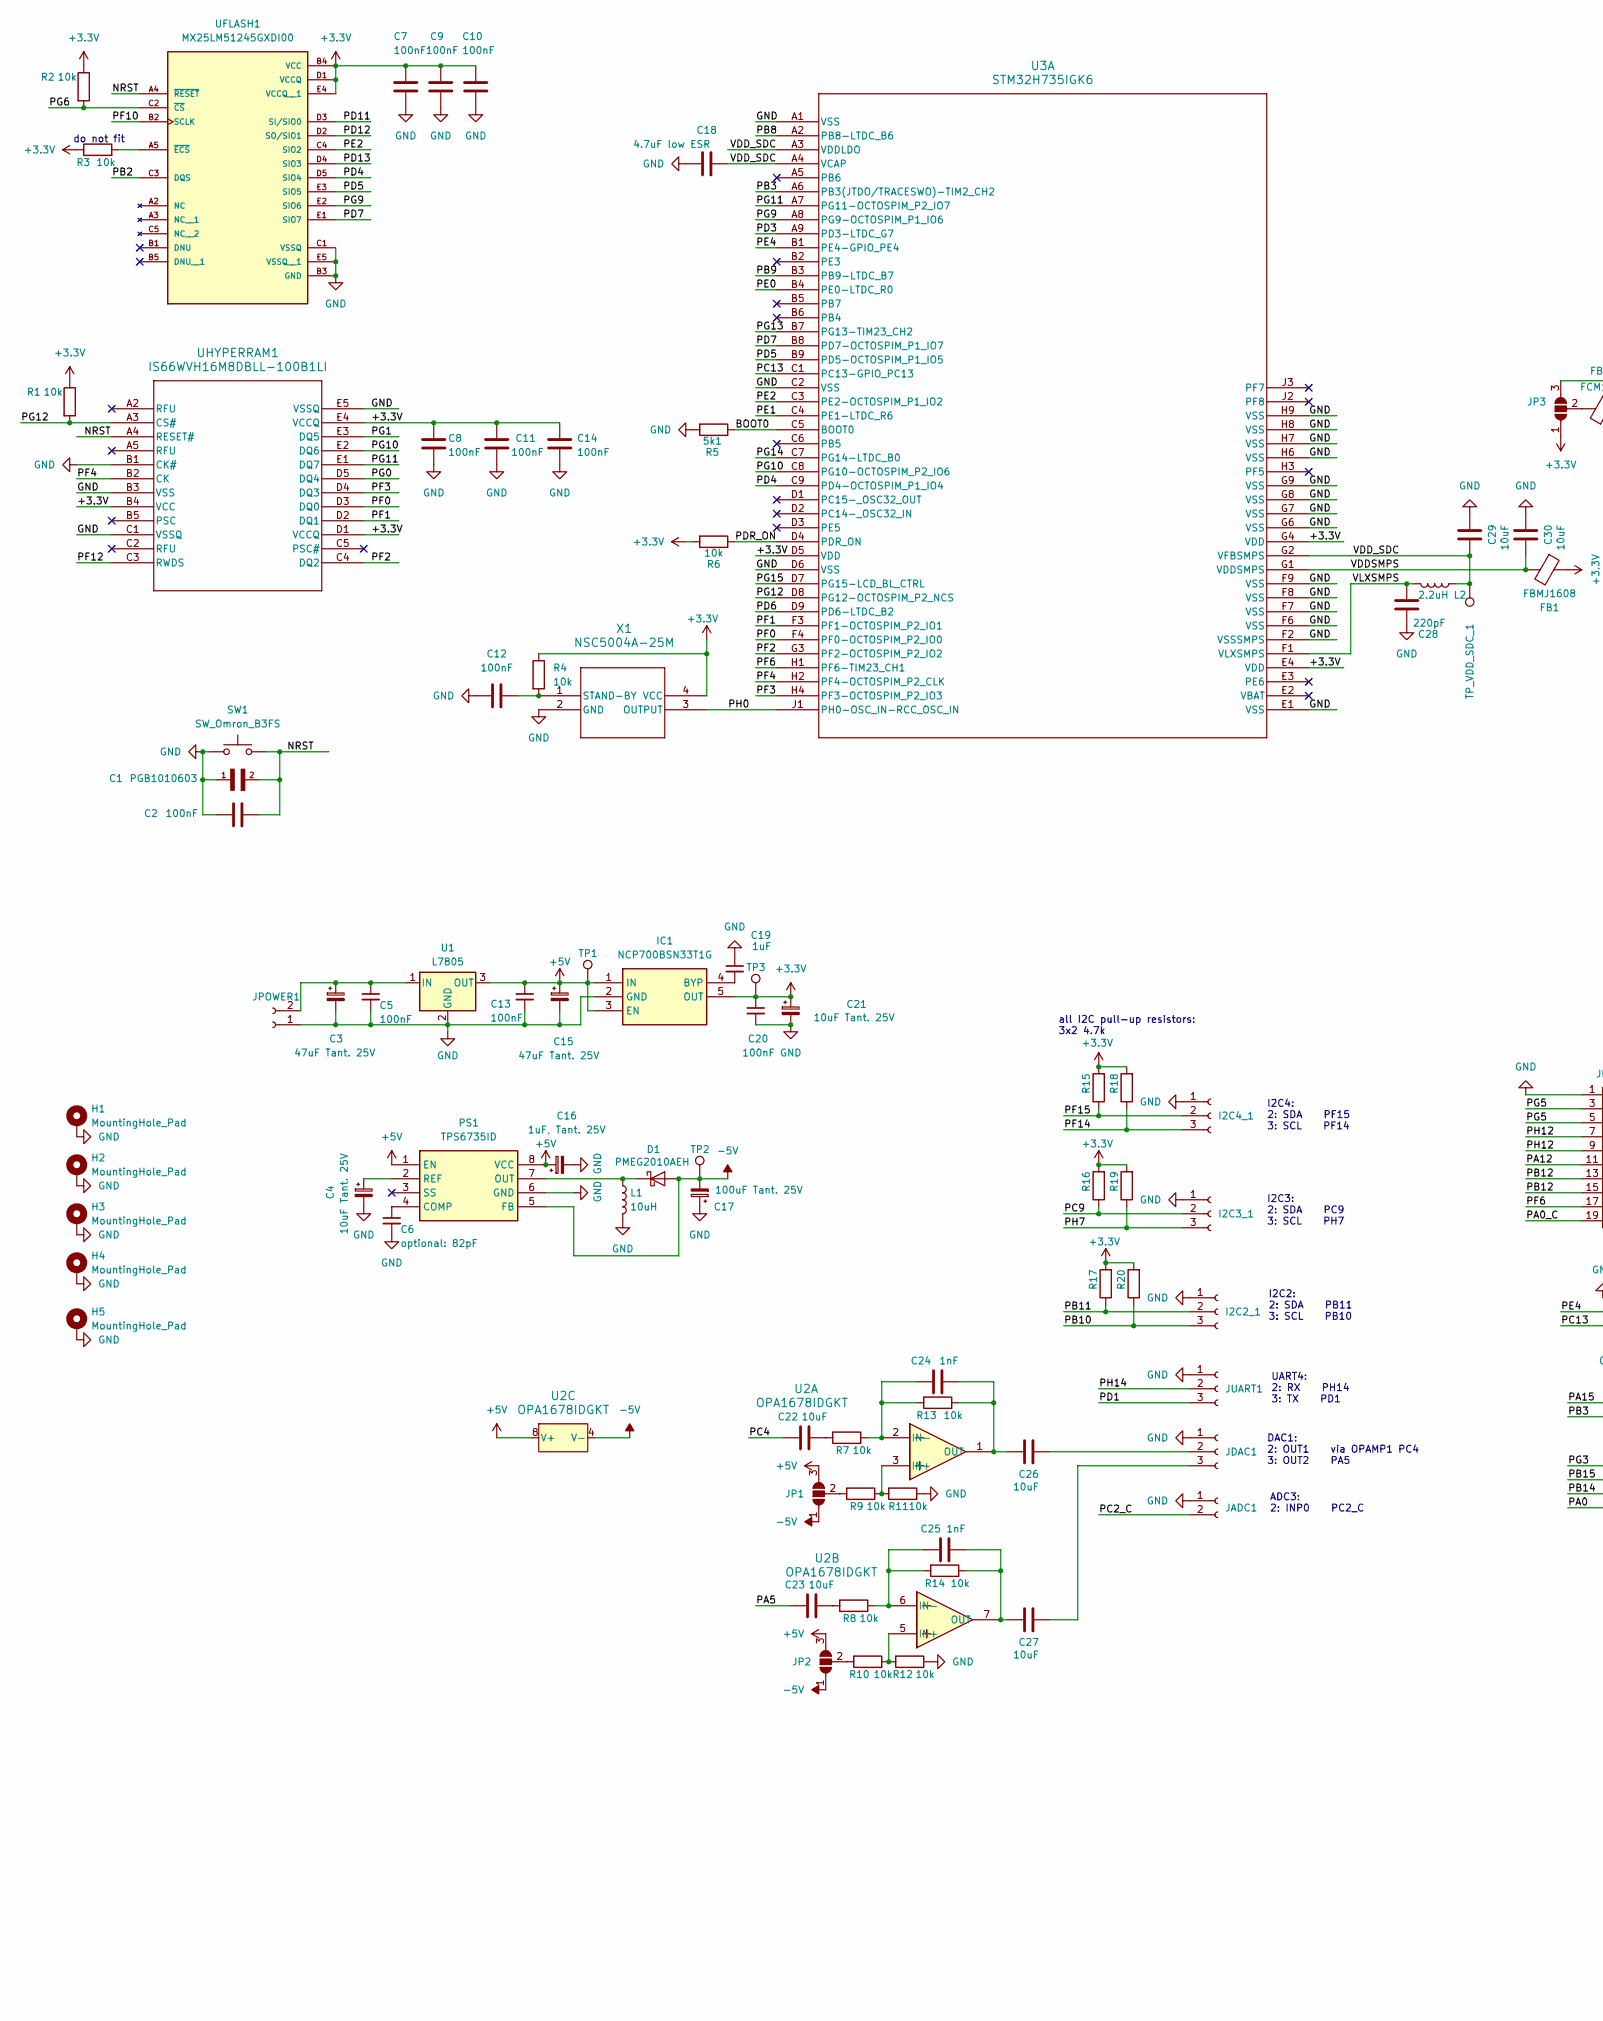
[picture p36: schematic CustomSTM32H735_V2_Board.kicad_sch, CustomSTM32H735Board, part in row 1, column 1]

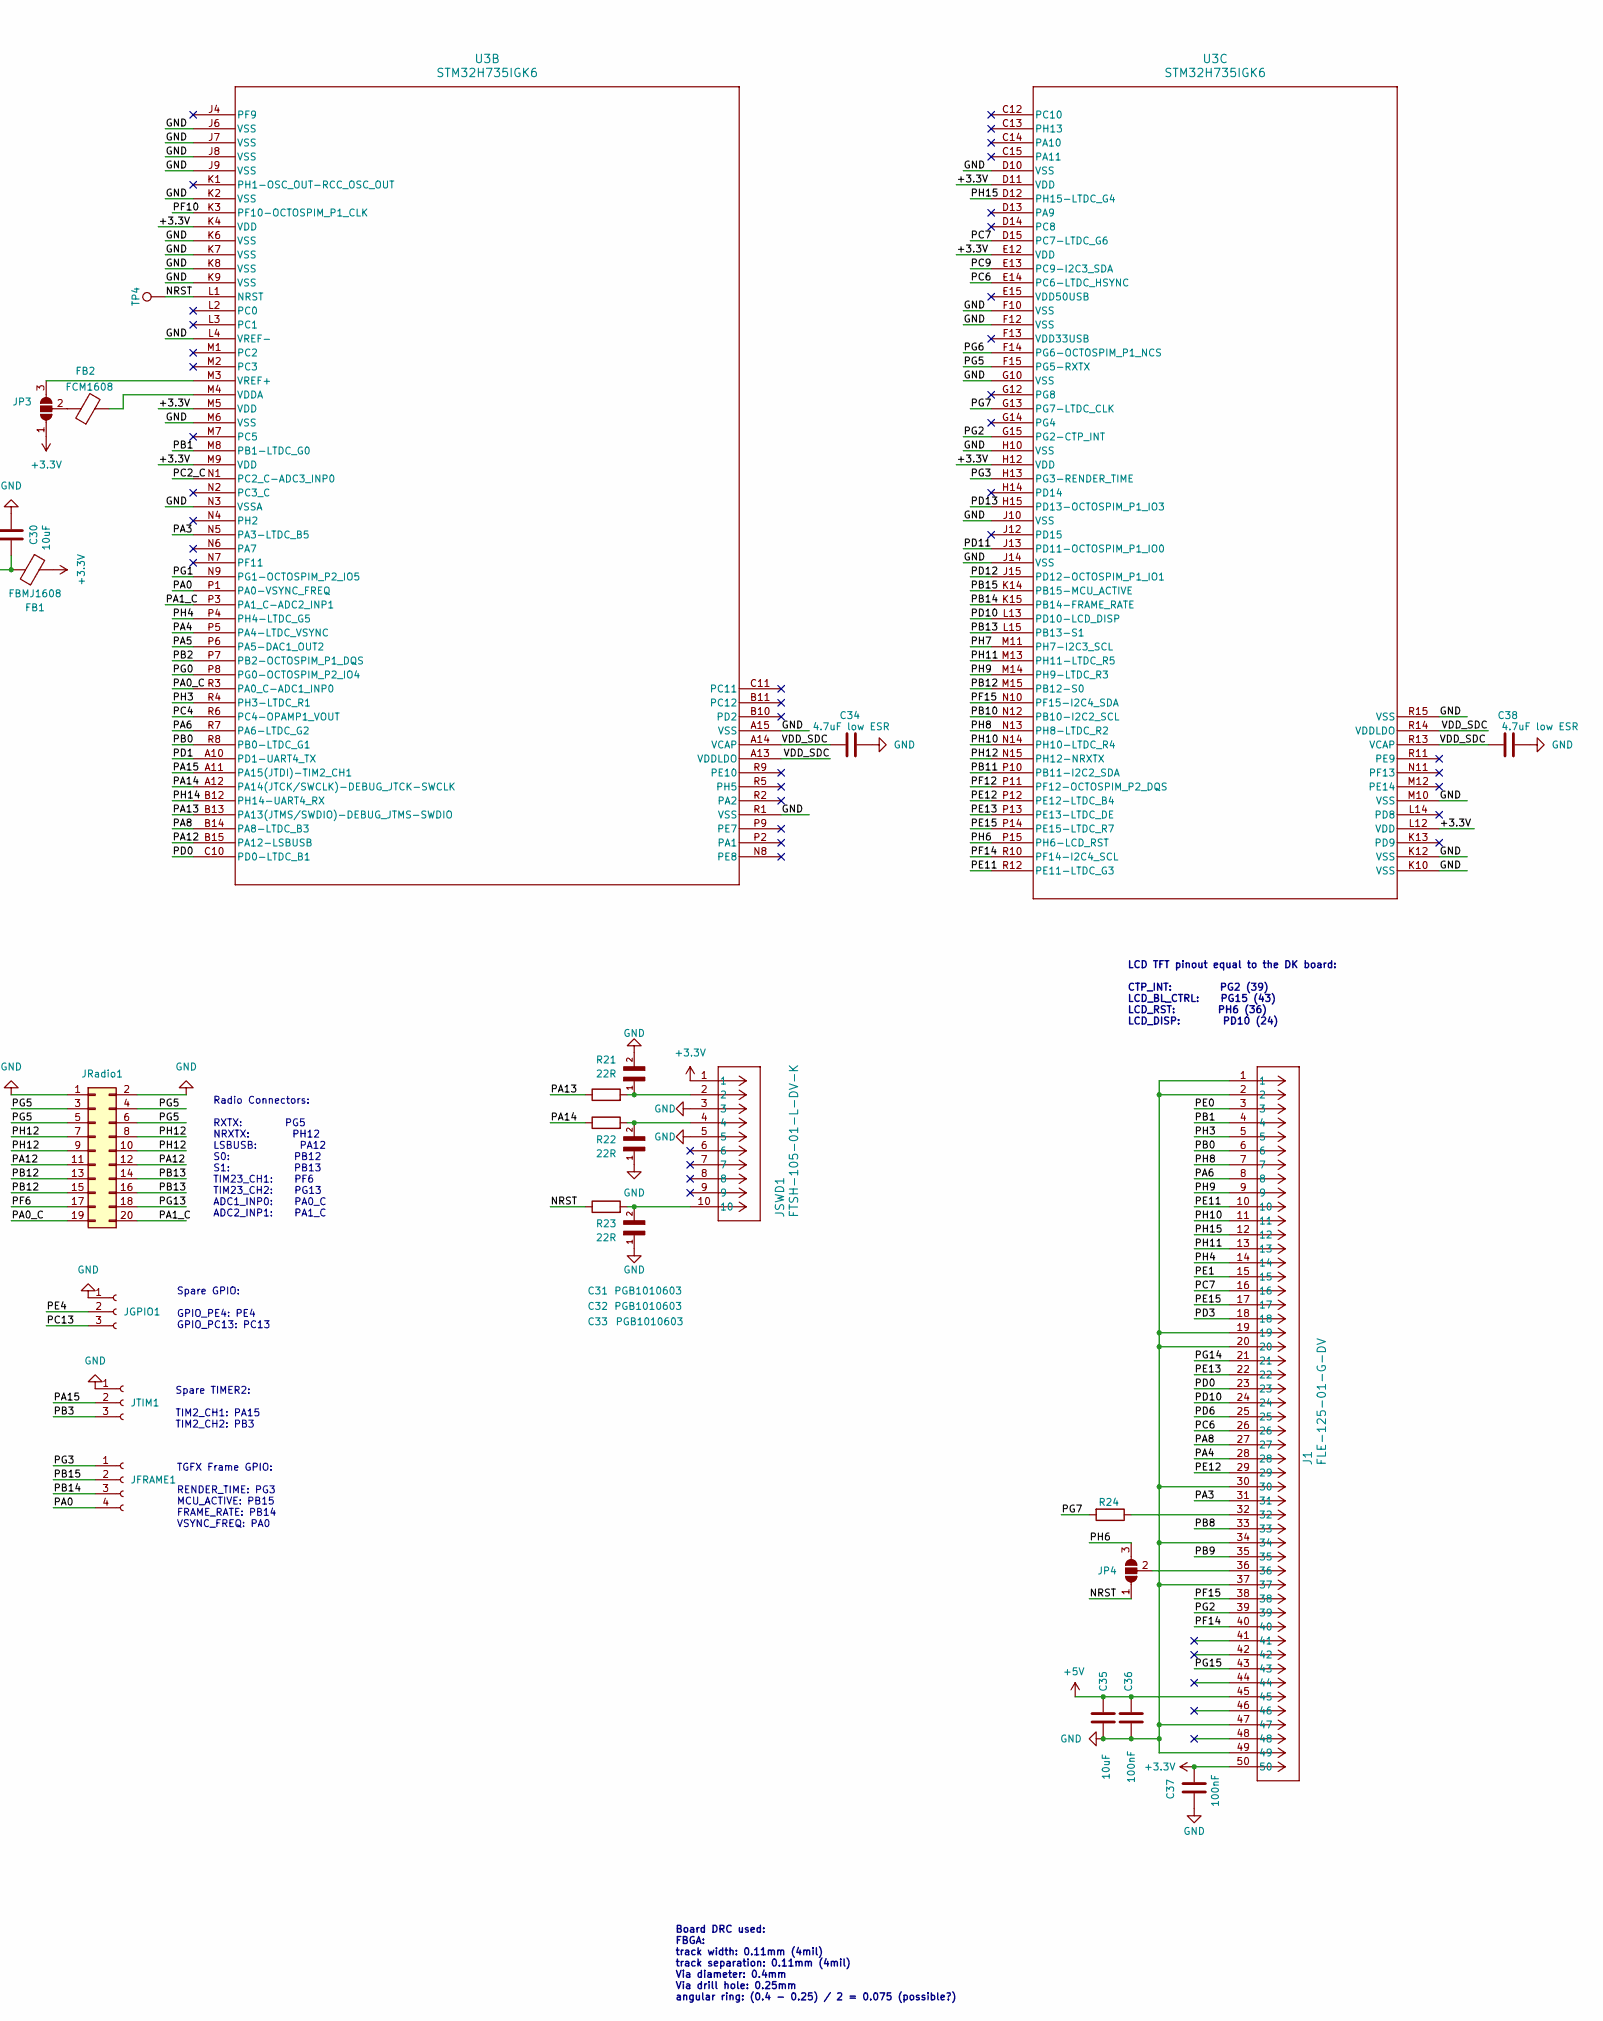
[picture p37: schematic CustomSTM32H735_V2_Board.kicad_sch, CustomSTM32H735Board, part in row 1, column 2]

Parts:
C1, C31, C32, C33: PGB1010603; C_0603_1608Metric
C2, C5, C7, C8, C9, C10, C11, C12, C13, C14, C20, C36, C37: 100nF; C_0805_2012Metric_Pad1.18x1.45mm_HandSolder
C3, C15: 47uF Tant. 25V; CP_EIA-6032-20_AVX-F_Pad2.25x2.35mm_HandSolder
C4, C21: 10uF Tant. 25V; CP_EIA-6032-20_AVX-F_Pad2.25x2.35mm_HandSolder
C6: optional: 82pF; C_0805_2012Metric_Pad1.18x1.45mm_HandSolder
C16: 1uF, Tant. 25V; CP_EIA-6032-20_AVX-F_Pad2.25x2.35mm_HandSolder
C17: 100uF Tant. 25V; CP_EIA-6032-20_AVX-F_Pad2.25x2.35mm_HandSolder
C18, C34, C38: 4.7uF low ESR; C_0805_2012Metric_Pad1.18x1.45mm_HandSolder
C19: 1uF; C_0805_2012Metric_Pad1.18x1.45mm_HandSolder
C22, C23, C26, C27, C29, C30, C35: 10uF; C_0805_2012Metric_Pad1.18x1.45mm_HandSolder
C24, C25: 1nF; C_0805_2012Metric_Pad1.18x1.45mm_HandSolder
C28: 220pF; C_0805_2012Metric_Pad1.18x1.45mm_HandSolder
D1: PMEG2010AEH; D_SOD-123F
FB1: FBMJ1608; L_0603_1608Metric_Pad1.05x0.95mm_HandSolder
FB2: FCM1608; L_0603_1608Metric_Pad1.05x0.95mm_HandSolder
H1, H2, H3, H4, H5: MountingHole_Pad; MountingHole_3.2mm_M3_Pad_TopBottom
I2C2_1, I2C3_1, I2C4_1: Conn_01x03_Socket; JST_XH_B3B-XH-A_1x03_P2.50mm_Vertical
IC1: NCP700BSN33T1G; SOT95P275X120-5N; Manufacturer_Part_Number NCP700BSN33T1G; Mouser Part Number 863-NCP700BSN33T1G
J1: FLE-125-01-G-DV; CON50_2X25_UF_FLE_SAI
JADC1: Conn_01x02_Socket; JST_XH_B2B-XH-A_1x02_P2.50mm_Vertical
JDAC1: Conn_01x03_Socket; JST_XH_B3B-XH-A_1x03_P2.50mm_Vertical
JFRAME1: Conn_01x04_Socket; JST_XH_B4B-XH-A_1x04_P2.50mm_Vertical
JGPIO1: Conn_01x03_Socket; JST_XH_B3B-XH-A_1x03_P2.50mm_Vertical
JP1, JP2, JP3, JP4: SolderJumper_3_Open; SolderJumper-3_P1.3mm_Open_Pad1.0x1.5mm_NumberLabels
JPOWER1: Conn_01x02_Socket; JST_XH_B2B-XH-A_1x02_P2.50mm_Vertical
JRadio1: Conn_02x10_Odd_Even; IDC-Header_2x10_P2.54mm_Vertical
JSWD1: FTSH-105-01-L-DV-K; CON10_2X5_DUK_FTSH_SAI-M
JTIM1: Conn_01x03_Socket; JST_XH_B3B-XH-A_1x03_P2.50mm_Vertical
JUART1: Conn_01x03_Socket; JST_XH_B3B-XH-A_1x03_P2.50mm_Vertical
L1: 10uH; L_1812_4532Metric_Pad1.30x3.40mm_HandSolder
L2: 2.2uH; L_Murata_DFE201610P
PS1: TPS6735ID; SOIC127P600X175-8N; Manufacturer_Part_Number TPS6735ID; Mouser Part Number 595-TPS6735ID
R1, R2, R3, R4, R6, R7, R8, R9, R10, R11, R12, R13, R14: 10k; R_0805_2012Metric_Pad1.20x1.40mm_HandSolder
R5: 5k1; R_0805_2012Metric_Pad1.20x1.40mm_HandSolder
R15, R16, R17, R18, R19, R20: 4.7k; R_0805_2012Metric_Pad1.20x1.40mm_HandSolder
R21, R22, R23: 22R; R_0805_2012Metric_Pad1.20x1.40mm_HandSolder
R24: 0R; R_0805_2012Metric_Pad1.20x1.40mm_HandSolder
SW1: SW_Omron_B3FS; SW_SPST_Omron_B3FS-100xP
TP1, TP2, TP3, TP4: TestPoint; Pin_D0.7mm_L6.5mm_W1.8mm_FlatFork
TP_VDD_SDC_1: TestPoint; Pin_D0.7mm_L6.5mm_W1.8mm_FlatFork
U1: L7805; TO-220-3_Horizontal_TabDown_GND_Pad
U2: OPA1678IDGKT; OPA1678_L
U3: STM32H735IGK6; BGA_735IGK6_STM
UFLASH1: MX25LM51245GXDI00; BGA24C100P5X5_600X800X120; PARTREV 1.1
UHYPERRAM1: IS66WVH16M8DBLL-100B1LI; TFBGA24_6X8_ISI
X1: NSC5004A-25M; NSC5004_NDK

Connections:
+3.3V: C7.1, C8.1, C9.1, C10.1, C11.1, C14.1, C20.1, C21.1, C37.1, FB1.1, IC1.5 (OUT), J1.50, JP3.1 (A), JSWD1.1, R1.1, R2.1, R3.1, R4.1, R6.2, R15.2, R16.2, R17.2, R18.2, R19.2, R20.2, TP3.1, U3.D5 (VDD), U3.D11 (VDD), U3.E4 (VDD), U3.E12 (VDD), U3.G4 (VDD), U3.H12 (VDD), U3.K4 (VDD), U3.L12 (VDD), U3.M5 (VDD), U3.M9 (VDD), UFLASH1.B4 (VCC), UFLASH1.D1 (VCCQ), UFLASH1.E4 (VCCQ__1), UHYPERRAM1.B4 (VCC), UHYPERRAM1.D1 (VCCQ), UHYPERRAM1.E4 (VCCQ), X1.4 (VCC)
+5V: C13.1, C15.1, C16.1, C35.1, C36.1, IC1.1 (IN), IC1.3 (EN), J1.45, JP1.3 (B), JP2.3 (B), PS1.1 (EN), PS1.8 (VCC), TP1.1, U1.3 (OUT), U2.8 (V+)
-5V: C17.2, D1.2 (A), JP1.1 (A), JP2.1 (A), PS1.5 (FB), TP2.1, U2.4 (V-)
/BOOT0: R5.1, U3.C5 (BOOT0)
/NRST: C1.2, C2.1, JP4.1 (A), R23.1, SW1.2, TP4.1, U3.L1 (NRST), UFLASH1.A4 (~RESET), UHYPERRAM1.A4 (RESET#)
/PA0: JFRAME1.4, U3.P1 (PA0-VSYNC_FREQ)
/PA0_C: JRadio1.19, U3.R3 (PA0_C-ADC1_INP0)
/PA1_C: JRadio1.20, U3.P3 (PA1_C-ADC2_INP1)
/PA3: J1.31, U3.N5 (PA3-LTDC_B5)
/PA4: J1.28, U3.P5 (PA4-LTDC_VSYNC)
/PA5: C23.1, U3.P6 (PA5-DAC1_OUT2)
/PA6: J1.8, U3.R7 (PA6-LTDC_G2)
/PA8: J1.27, U3.B14 (PA8-LTDC_B3)
/PA12: JRadio1.11, JRadio1.12, U3.B15 (PA12-LSBUSB)
/PA13: R21.1, U3.B13 (PA13(JTMS/SWDIO)-DEBUG_JTMS-SWDIO)
/PA14: R22.1, U3.A12 (PA14(JTCK/SWCLK)-DEBUG_JTCK-SWCLK)
/PA15: JTIM1.2, U3.A11 (PA15(JTDI)-TIM2_CH1)
/PB0: J1.6, U3.R8 (PB0-LTDC_G1)
/PB1: J1.4, U3.M8 (PB1-LTDC_G0)
/PB2: U3.P7 (PB2-OCTOSPIM_P1_DQS), UFLASH1.C3 (DQS)
/PB3: JTIM1.3, U3.A6 (PB3(JTDO/TRACESWO)-TIM2_CH2)
/PB8: J1.33, U3.A2 (PB8-LTDC_B6)
/PB9: J1.35, U3.B3 (PB9-LTDC_B7)
/PB10: I2C2_1.3, R20.1, U3.N12 (PB10-I2C2_SCL)
/PB11: I2C2_1.2, R17.1, U3.P10 (PB11-I2C2_SDA)
/PB12: JRadio1.13, JRadio1.15, U3.M15 (PB12-S0)
/PB13: JRadio1.14, JRadio1.16, U3.L15 (PB13-S1)
/PB14: JFRAME1.3, U3.K15 (PB14-FRAME_RATE)
/PB15: JFRAME1.2, U3.K14 (PB15-MCU_ACTIVE)
/PC2_C: JADC1.2, U3.N1 (PC2_C-ADC3_INP0)
/PC4: C22.1, U3.R6 (PC4-OPAMP1_VOUT)
/PC6: J1.26, U3.E14 (PC6-LTDC_HSYNC)
/PC7: J1.16, U3.D15 (PC7-LTDC_G6)
/PC9: I2C3_1.2, R16.1, U3.E13 (PC9-I2C3_SDA)
/PC13: JGPIO1.3, U3.C1 (PC13-GPIO_PC13)
/PD0: J1.23, U3.C10 (PD0-LTDC_B1)
/PD1: JUART1.3, U3.A10 (PD1-UART4_TX)
/PD3: J1.18, U3.A9 (PD3-LTDC_G7)
/PD4: U3.C9 (PD4-OCTOSPIM_P1_IO4), UFLASH1.D5 (SIO4)
/PD5: U3.B9 (PD5-OCTOSPIM_P1_IO5), UFLASH1.E3 (SIO5)
/PD6: J1.25, U3.D9 (PD6-LTDC_B2)
/PD7: U3.B8 (PD7-OCTOSPIM_P1_IO7), UFLASH1.E1 (SIO7)
/PD10: J1.24, U3.L13 (PD10-LCD_DISP)
/PD11: U3.J13 (PD11-OCTOSPIM_P1_IO0), UFLASH1.D3 (SI/SIO0)
/PD12: U3.J15 (PD12-OCTOSPIM_P1_IO1), UFLASH1.D2 (SO/SIO1)
/PD13: U3.H15 (PD13-OCTOSPIM_P1_IO3), UFLASH1.D4 (SIO3)
/PDR_ON: R6.1, U3.D4 (PDR_ON)
/PE0: J1.3, U3.B4 (PE0-LTDC_R0)
/PE1: J1.15, U3.C4 (PE1-LTDC_R6)
/PE2: U3.C3 (PE2-OCTOSPIM_P1_IO2), UFLASH1.C4 (SIO2)
/PE4: JGPIO1.2, U3.B1 (PE4-GPIO_PE4)
/PE11: J1.10, U3.R12 (PE11-LTDC_G3)
/PE12: J1.29, U3.P12 (PE12-LTDC_B4)
/PE13: J1.22, U3.P13 (PE13-LTDC_DE)
/PE15: J1.17, U3.P14 (PE15-LTDC_R7)
/PF0: U3.F4 (PF0-OCTOSPIM_P2_IO0), UHYPERRAM1.D3 (DQ0)
/PF1: U3.F3 (PF1-OCTOSPIM_P2_IO1), UHYPERRAM1.D2 (DQ1)
/PF2: U3.G3 (PF2-OCTOSPIM_P2_IO2), UHYPERRAM1.C4 (DQ2)
/PF3: U3.H4 (PF3-OCTOSPIM_P2_IO3), UHYPERRAM1.D4 (DQ3)
/PF4: U3.H2 (PF4-OCTOSPIM_P2_CLK), UHYPERRAM1.B2 (CK)
/PF6: JRadio1.17, U3.H1 (PF6-TIM23_CH1)
/PF10: U3.K3 (PF10-OCTOSPIM_P1_CLK), UFLASH1.B2 (SCLK)
/PF12: U3.P11 (PF12-OCTOSPIM_P2_DQS), UHYPERRAM1.C3 (RWDS)
/PF14: I2C4_1.3, J1.40, R18.1, U3.R10 (PF14-I2C4_SCL)
/PF15: I2C4_1.2, J1.38, R15.1, U3.N10 (PF15-I2C4_SDA)
/PG0: U3.P8 (PG0-OCTOSPIM_P2_IO4), UHYPERRAM1.D5 (DQ4)
/PG1: U3.N9 (PG1-OCTOSPIM_P2_IO5), UHYPERRAM1.E3 (DQ5)
/PG2: J1.39, U3.G15 (PG2-CTP_INT)
/PG3: JFRAME1.1, U3.H13 (PG3-RENDER_TIME)
/PG5: JRadio1.3, JRadio1.4, JRadio1.5, JRadio1.6, U3.F15 (PG5-RXTX)
/PG6: R2.2, U3.F14 (PG6-OCTOSPIM_P1_NCS), UFLASH1.C2 (~CS)
/PG7: R24.2, U3.G13 (PG7-LTDC_CLK)
/PG9: U3.A8 (PG9-OCTOSPIM_P1_IO6), UFLASH1.E2 (SIO6)
/PG10: U3.C8 (PG10-OCTOSPIM_P2_IO6), UHYPERRAM1.E2 (DQ6)
/PG11: U3.A7 (PG11-OCTOSPIM_P2_IO7), UHYPERRAM1.E1 (DQ7)
/PG12: R1.2, U3.D8 (PG12-OCTOSPIM_P2_NCS), UHYPERRAM1.A3 (CS#)
/PG13: JRadio1.18, U3.B7 (PG13-TIM23_CH2)
/PG14: J1.21, U3.C7 (PG14-LTDC_B0)
/PG15: J1.43, U3.D7 (PG15-LCD_BL_CTRL)
/PH0: U3.J1 (PH0-OSC_IN-RCC_OSC_IN), X1.3 (OUTPUT)
/PH3: J1.5, U3.R4 (PH3-LTDC_R1)
/PH4: J1.14, U3.P4 (PH4-LTDC_G5)
/PH6: JP4.3 (B), U3.P15 (PH6-LCD_RST)
/PH7: I2C3_1.3, R19.1, U3.M11 (PH7-I2C3_SCL)
/PH8: J1.7, U3.N13 (PH8-LTDC_R2)
/PH9: J1.9, U3.M14 (PH9-LTDC_R3)
/PH10: J1.11, U3.N14 (PH10-LTDC_R4)
/PH11: J1.13, U3.M13 (PH11-LTDC_R5)
/PH12: JRadio1.7, JRadio1.8, JRadio1.9, JRadio1.10, U3.N15 (PH12-NRXTX)
/PH14: JUART1.2, U3.B12 (PH14-UART4_RX)
/PH15: J1.12, U3.D12 (PH15-LTDC_G4)
/VDDSMPS: C30.1, FB1.2, U3.G1 (VDDSMPS)
/VDD_SDC: C18.2, C29.1, C34.2, C38.2, L2.1, TP_VDD_SDC_1.1, U3.A3 (VDDLDO), U3.A4 (VCAP), U3.A13 (VDDLDO), U3.A14 (VCAP), U3.G2 (VFBSMPS), U3.R13 (VCAP), U3.R14 (VDDLDO)
/VLXSMPS: C28.2, L2.2, U3.F1 (VLXSMPS)
GND: C1.1, C2.2, C3.2, C4.2, C5.2, C6.2, C7.2, C8.2, C9.2, C10.2, C11.2, C12.1, C13.2, C14.2, C15.2, C16.2, C17.1, C18.1, C19.1, C20.2, C21.2, C28.1, C29.2, C30.2, C31.2, C32.1, C33.1, C34.1, C35.2, C36.2, C37.2, C38.1, H1.1, H2.1, H3.1, H4.1, H5.1, I2C2_1.1, I2C3_1.1, I2C4_1.1, IC1.2 (GND), J1.1, J1.2, J1.19, J1.20, J1.30, J1.34, J1.37, J1.47, J1.49, JADC1.1, JDAC1.1, JGPIO1.1, JPOWER1.1, JRadio1.1, JRadio1.2, JSWD1.3, JSWD1.5, JTIM1.1, JUART1.1, L1.2, PS1.6 (GND), R5.2, R11.1, R12.1, SW1.1, U1.2 (GND), U1.4, U3.A1 (VSS), U3.A15 (VSS), U3.C2 (VSS), U3.D6 (VSS), U3.D10 (VSS), U3.E1 (VSS), U3.F2 (VSSSMPS), U3.F6 (VSS), U3.F7 (VSS), U3.F8 (VSS), U3.F9 (VSS), U3.F10 (VSS), U3.F12 (VSS), U3.G6 (VSS), U3.G7 (VSS), U3.G8 (VSS), U3.G9 (VSS), U3.G10 (VSS), U3.H6 (VSS), U3.H7 (VSS), U3.H8 (VSS), U3.H9 (VSS), U3.H10 (VSS), U3.J6 (VSS), U3.J7 (VSS), U3.J8 (VSS), U3.J9 (VSS), U3.J10 (VSS), U3.J14 (VSS), U3.K2 (VSS), U3.K6 (VSS), U3.K7 (VSS), U3.K8 (VSS), U3.K9 (VSS), U3.K10 (VSS), U3.K12 (VSS), U3.L4 (VREF-), U3.M6 (VSS), U3.M10 (VSS), U3.N3 (VSSA), U3.R1 (VSS), U3.R15 (VSS), UFLASH1.B3 (GND), UFLASH1.C1 (VSSQ), UFLASH1.E5 (VSSQ__1), UHYPERRAM1.B1 (CK#), UHYPERRAM1.B3 (VSS), UHYPERRAM1.C1 (VSSQ), UHYPERRAM1.E5 (VSSQ), X1.2 (GND)
unnamed: C22.2, R7.2
unnamed: C23.2, R8.2
unnamed: C31.1, JSWD1.2, R21.2
unnamed: C32.2, JSWD1.4, R22.2
unnamed: C33.2, JSWD1.10, R23.2
unnamed: D1.1 (K), L1.1, PS1.7 (OUT)
unnamed: C19.2, IC1.4 (BYP)
unnamed: J1.32, R24.1
unnamed: C26.2, JDAC1.2
unnamed: C27.2, JDAC1.3
unnamed: JP1.2 (C), R9.2
unnamed: JP2.2 (C), R10.2
unnamed: JP3.3 (B), U3.M3 (VREF+)
unnamed: FB2.1, JP3.2 (C)
unnamed: J1.36, JP4.2 (C)
unnamed: C3.1, C5.1, JPOWER1.2, U1.1 (IN)
unnamed: C6.1, PS1.4 (COMP)
unnamed: C4.1, PS1.2 (REF)
unnamed: R9.1, R11.2, U2.3 (IN+)
unnamed: C24.1, R7.1, R13.2, U2.2 (IN-)
unnamed: C24.2, C26.1, R13.1, U2.1 (OUT)
unnamed: R10.1, R12.2, U2.5 (IN+)
unnamed: C25.1, R8.1, R14.2, U2.6 (IN-)
unnamed: C25.2, C27.1, R14.1, U2.7 (OUT)
unnamed: FB2.2, U3.M4 (VDDA)
unnamed: R3.2, UFLASH1.A5 (~ECS)
unnamed: C12.2, R4.2, X1.1 (STAND-BY)

Notes on the sheet:
TGFX Frame GPIO: RENDER_TIME: PG3 MCU_ACTIVE: PB15 FRAME_RATE: PB14 VSYNC_FREQ: PA0
Spare TIMER2: TIM2_CH1: PA15 TIM2_CH2: PB3
DAC1: 2: OUT1 via OPAMP1 PC4 3: OUT2 PA5
Radio Connectors: RXTX: PG5 NRXTX: PH12 LSBUSB: PA12 S0: PB12 S1: PB13 TIM23_CH1: PF6 TIM23_CH2: PG13 ADC1_INP0: PA0_C ADC2_INP1: PA1_C
LCD TFT pinout equal to the DK board: CTP_INT: PG2 (39) LCD_BL_CTRL: PG15 (43) LCD_RST: PH6 (36) LCD_DISP: PD10 (24)
I2C2: 2: SDA PB11 3: SCL PB10
Spare GPIO: GPIO_PE4: PE4 GPIO_PC13: PC13
do not fit
UART4: 2: RX PH14 3: TX PD1
ADC3: 2: INP0 PC2_C
Board DRC used: FBGA: track width: 0.11mm (4mil) track separation: 0.11mm (4mil) Via diameter: 0.4mm Via drill hole: 0.25mm angular ring: (0.4 - 0.25) / 2 = 0.075 (possible?)
I2C3: 2: SDA PC9 3: SCL PH7
all I2C pull-up resistors: 3x2 4.7k
I2C4: 2: SDA PF15 3: SCL PF14

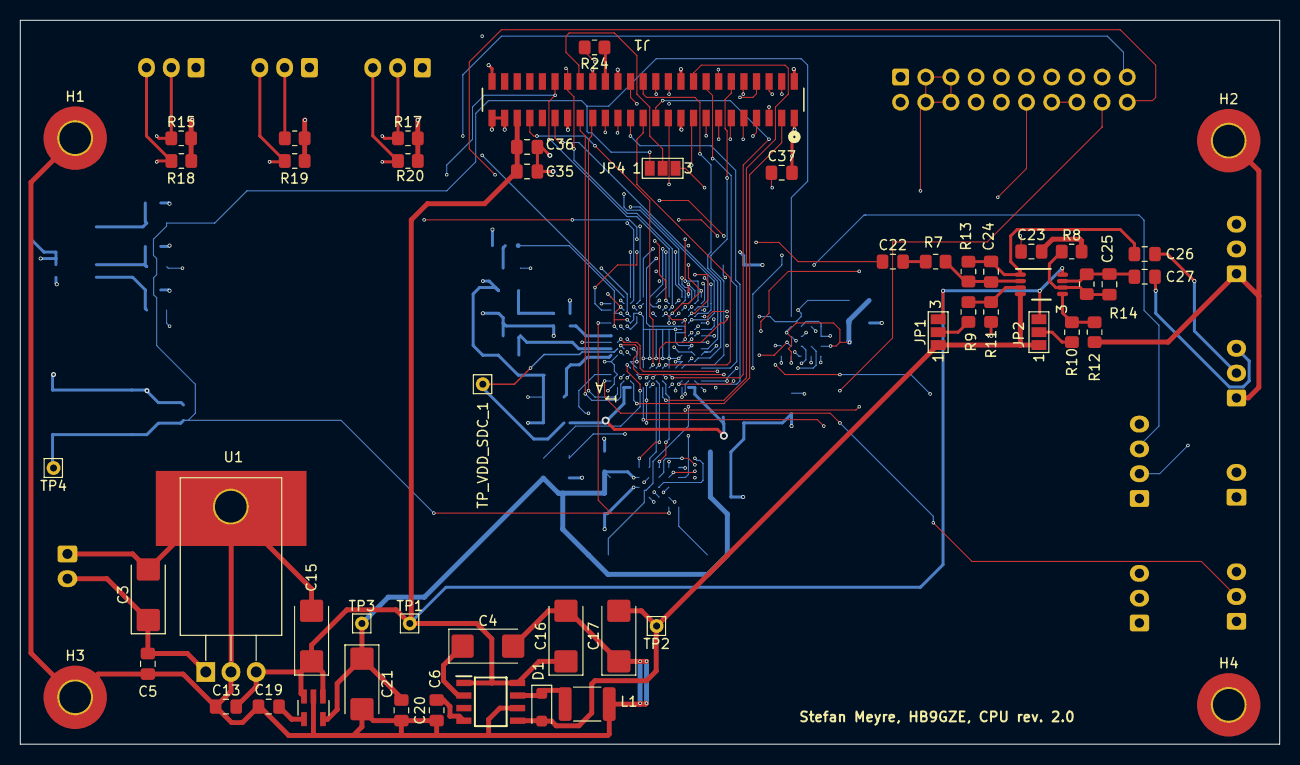
[picture p38: board CustomSTM32H735_V2_Board.kicad_pcb from above]

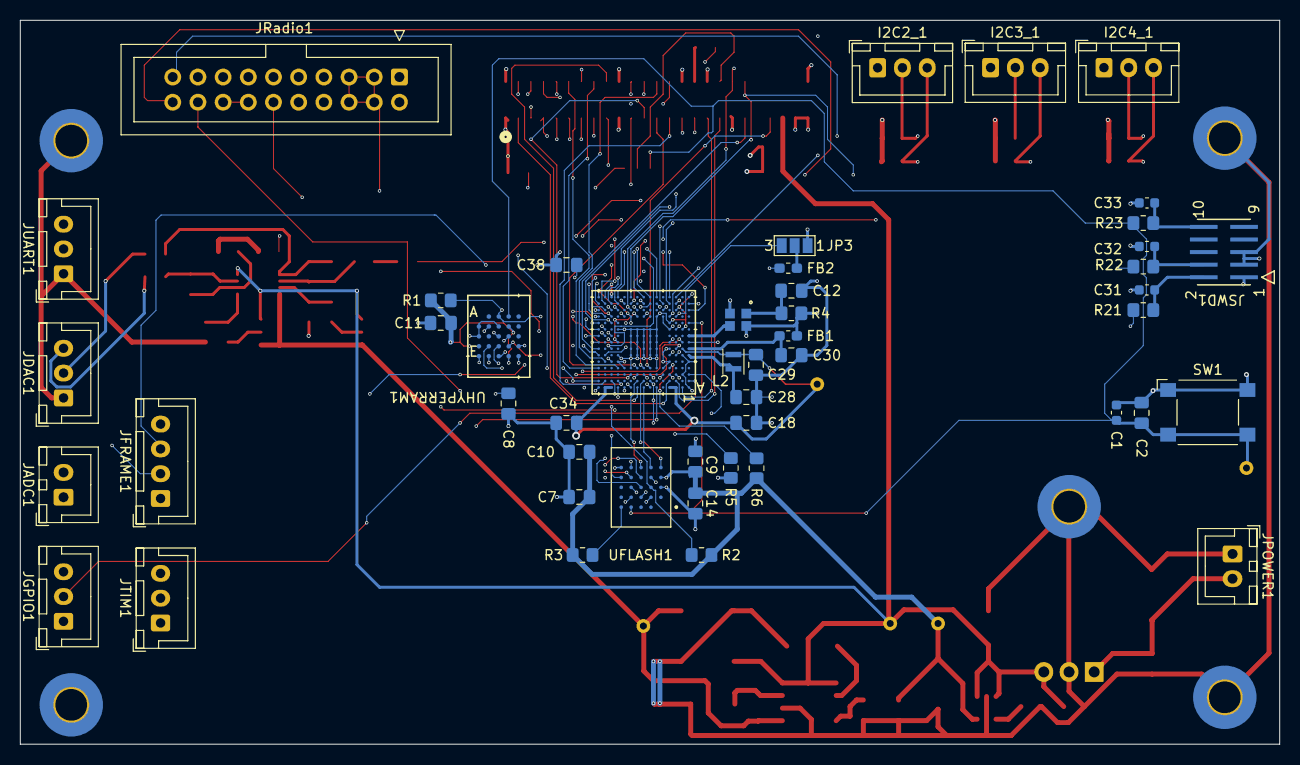
[picture p39: board CustomSTM32H735_V2_Board.kicad_pcb from below]

Board: 4 copper layers, 127.0 x 73.0 mm, 103 parts (48 on the bottom side), 122 nets.
