HB9GZE/PhasorRadio/KiCAD Files/FreqSynth/FreqSynth5351/FreqSynth5351.kicad_pcb

## KiCad design KiCAD Files/FreqSynth/FreqSynth5351/FreqSynth5351.kicad_pcb (2024-05-30)

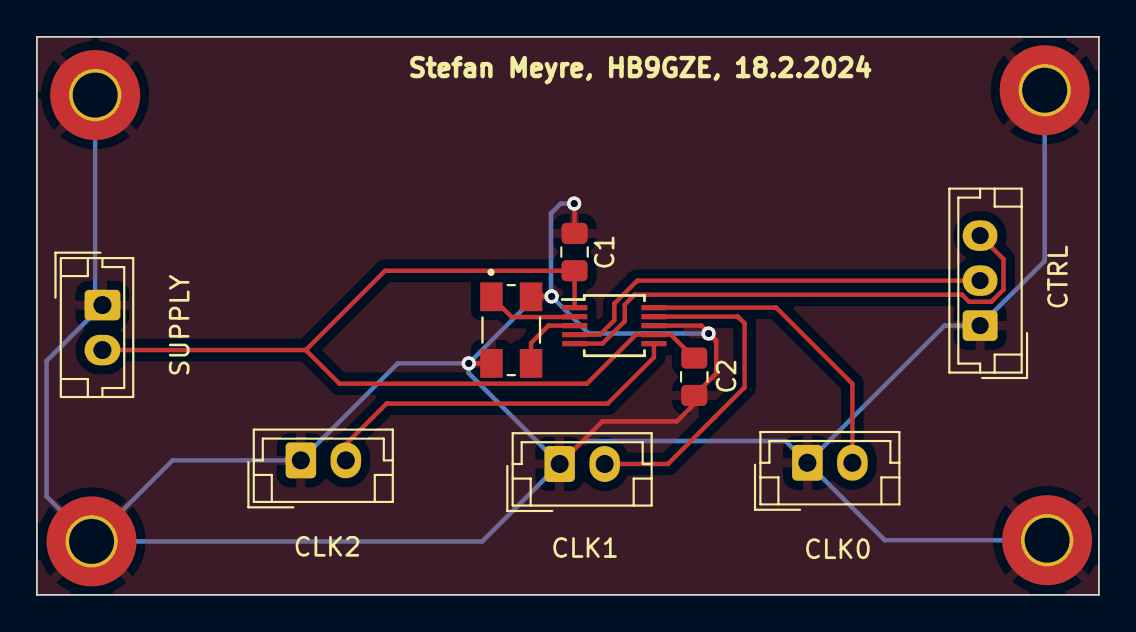
[picture p40: board FreqSynth5351.kicad_pcb from above]

Board: 2 copper layers, 59.0 x 31.0 mm, 13 parts (0 on the bottom side), 9 nets.

Parts:
C1, C2: 100nF; C_0805_2012Metric_Pad1.18x1.45mm_HandSolder
CLK0, CLK1, CLK2: Conn_01x02_Socket; JST_EH_B2B-EH-A_1x02_P2.50mm_Vertical
CTRL: Conn_01x03_Socket; JST_EH_B3B-EH-A_1x03_P2.50mm_Vertical
H1, H2, H3, H4: MountingHole_Pad; MountingHole_2.5mm_Pad_TopBottom
SUPPLY: Conn_01x02_Socket; JST_EH_B2B-EH-A_1x02_P2.50mm_Vertical
U1: Si5351A-B-GT; MSOP-10_3x3mm_P0.5mm
Y1: ECS-250-8-30B-CKM; XTAL_ECS-250-8-30B-CKM

Connections:
+3.3V: C1.2, C2.2, SUPPLY.2, U1.1 (VDD), U1.7 (VDDO)
/SCL: CTRL.2, U1.4 (SCL)
/SDA: CTRL.3, U1.5 (SDA)
GND: C1.1, C2.1, CLK0.1, CLK1.1, CLK2.1, CTRL.1, H1.1, H2.1, H3.1, H4.1, SUPPLY.1, U1.8 (GND), Y1.2 (GND), Y1.4 (GND__1)
unnamed: CLK0.2, U1.10 (CLK0)
unnamed: CLK1.2, U1.9 (CLK1)
unnamed: CLK2.2, U1.6 (CLK2)
unnamed: U1.2 (XA), Y1.1 (IN/OUT)
unnamed: U1.3 (XB), Y1.3 (OUT/IN)
