HB9GZE/PhasorRadio/KiCAD Files/MixerTest/MixerTest/MixerTest.kicad_pcb

## KiCad design KiCAD Files/MixerTest/MixerTest/MixerTest.kicad_pcb (2024-05-30)

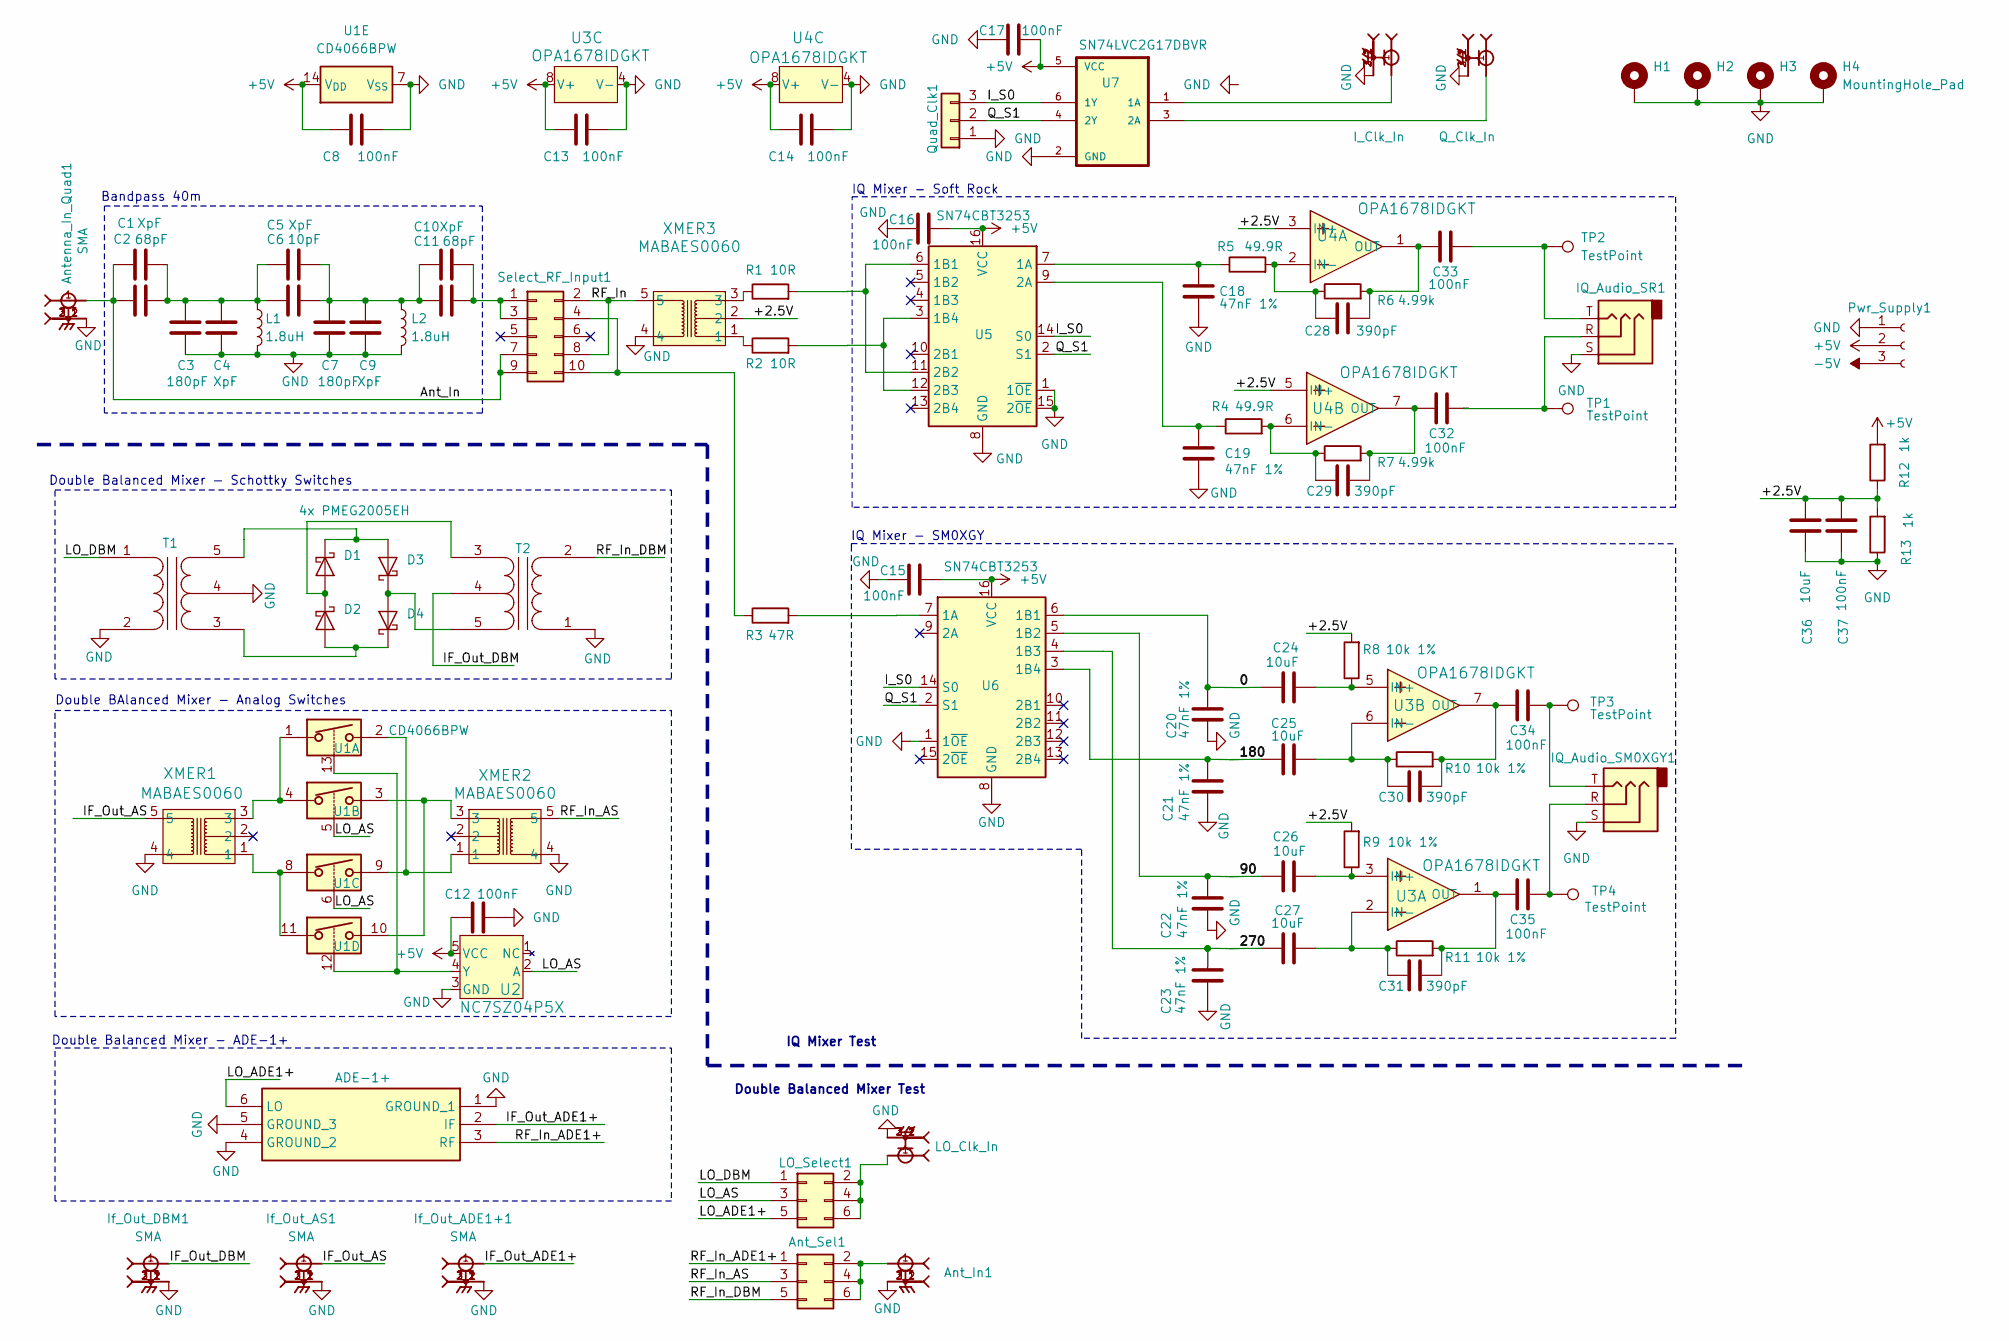
[picture p41: schematic MixerTest.kicad_sch, Phasor Radio: MixerTest]

Parts:
Ant_In1: SMA; SAMTEC_SMA-J-P-H-ST-EM1
Ant_Sel1: Conn_02x03_Odd_Even; PinHeader_2x03_P2.54mm_Vertical
Antenna_In_Quad1: SMA; SAMTEC_SMA-J-P-H-ST-EM1
C1, C4, C5, C9, C10: XpF; C_0805_2012Metric_Pad1.18x1.45mm_HandSolder
C2, C11: 68pF; C_0805_2012Metric_Pad1.18x1.45mm_HandSolder
C3, C7: 180pF; C_0805_2012Metric_Pad1.18x1.45mm_HandSolder
C6: 10pF; C_0805_2012Metric_Pad1.18x1.45mm_HandSolder
C8, C12, C13, C14, C15, C16, C17, C32, C33, C34, C35, C37: 100nF; C_0805_2012Metric_Pad1.18x1.45mm_HandSolder
C18, C19, C20, C21, C22, C23: 47nF 1%; C_0805_2012Metric_Pad1.18x1.45mm_HandSolder
C24, C25, C26, C27, C36: 10uF; C_0805_2012Metric_Pad1.18x1.45mm_HandSolder
C28, C29, C30, C31: 390pF; C_0805_2012Metric_Pad1.18x1.45mm_HandSolder
D1: 4x PMEG2005EH; D_SOD-123F
D2, D3, D4: PMEG2005EH; D_SOD-123F
H1, H2, H3, H4: MountingHole_Pad; MountingHole_2.5mm_Pad_TopBottom
IC1: ADE-1+; ADE1Mix; Manufacturer_Part_Number ADE-1+; Mouser Part Number 139-ADE-1
IQ_Audio_SM0XGY1: AudioJack3; Jack_3.5mm_CUI_SJ-3523-SMT_Horizontal
IQ_Audio_SR1: AudioJack3; Jack_3.5mm_CUI_SJ-3523-SMT_Horizontal
I_Clk_In: SMA; SAMTEC_SMA-J-P-H-ST-EM1
If_Out_ADE1+1: SMA; SAMTEC_SMA-J-P-H-ST-EM1
If_Out_AS1: SMA; SAMTEC_SMA-J-P-H-ST-EM1
If_Out_DBM1: SMA; SAMTEC_SMA-J-P-H-ST-EM1
L1, L2: 1.8uH; L_Toroid_Vertical_L19.1mm_W8.1mm_P7.10mm_Bourns_5700
LO_Clk_In: SMA; SAMTEC_SMA-J-P-H-ST-EM1
LO_Select1: Conn_02x03_Odd_Even; PinSocket_2x03_P2.54mm_Vertical
Pwr_Supply1: Conn_01x03_Socket; JST_EH_B3B-EH-A_1x03_P2.50mm_Vertical
Q_Clk_In: SMA; SAMTEC_SMA-J-P-H-ST-EM1
Quad_Clk1: Conn_01x03; PinHeader_1x03_P2.54mm_Vertical
R1, R2: 10R; R_0805_2012Metric_Pad1.20x1.40mm_HandSolder
R3: 47R; R_0805_2012Metric_Pad1.20x1.40mm_HandSolder
R4, R5: 49.9R; R_0805_2012Metric_Pad1.20x1.40mm_HandSolder
R6, R7: 4.99k; R_0805_2012Metric_Pad1.20x1.40mm_HandSolder
R8, R9, R10, R11: 10k 1%; R_0805_2012Metric_Pad1.20x1.40mm_HandSolder
R12, R13: 1k; R_0805_2012Metric_Pad1.20x1.40mm_HandSolder
Select_RF_Input1: Conn_02x05_Odd_Even; PinHeader_2x05_P2.54mm_Vertical
T1, T2: Transformer_1P_SS_SNM
TP1, TP2, TP3, TP4: TestPoint; TestPoint_Loop_D1.80mm_Drill1.0mm_Beaded
U1: CD4066BPW; TSSOP-14_4.4x5mm_P0.65mm
U2: NC7SZ04P5X; SC-88A-5_1P35X2P2_ONS
U3, U4: OPA1678IDGKT; OPA1678_L
U5, U6: SN74CBT3253; SOP65P640X110-16N
U7: SN74LVC2G17DBVR; SOT95P280X145-6N
XMER1, XMER2, XMER3: MABAES0060; MABAES0060_MCM

Connections:
+5V: C8.1, C12.2, C13.1, C14.1, C15.2, C16.2, C17.2, Pwr_Supply1.2, R12.2, U1.14 (V_{DD}), U2.5 (VCC), U3.8 (V+), U4.8 (V+), U5.16 (VCC), U6.16 (VCC), U7.5 (VCC)
-5V: Pwr_Supply1.3
/0: C20.1, C24.1, U6.6 (1B1)
/90: C22.1, C26.1, U6.5 (1B2)
/180: C21.1, C25.1, U6.3 (1B4)
/270: C23.1, C27.1, U6.4 (1B3)
/Ant_In: Antenna_In_Quad1.1, C1.1, C2.1, Select_RF_Input1.7, Select_RF_Input1.9
/IF_Out_ADE1+: IC1.2 (IF), If_Out_ADE1+1.1
/IF_Out_AS: If_Out_AS1.1, XMER1.5
/IF_Out_DBM: If_Out_DBM1.1, T2.4 (SC)
/I_S0: Quad_Clk1.3, U5.14 (S0), U6.14 (S0), U7.6 (1Y)
/LO_ADE1+: IC1.6 (LO), LO_Select1.5
/LO_AS: LO_Select1.3, U1.5, U1.6, U2.2 (A)
/LO_DBM: LO_Select1.1, T1.1 (AA)
/Q_S1: Quad_Clk1.2, U5.2 (S1), U6.2 (S1), U7.4 (2Y)
/RF_In: Select_RF_Input1.2, Select_RF_Input1.8, XMER3.5
/RF_In_ADE1+: Ant_Sel1.1, IC1.3 (RF)
/RF_In_AS: Ant_Sel1.3, XMER2.5
/RF_In_DBM: Ant_Sel1.5, T2.2 (AB)
unnamed: Ant_In1.1, Ant_Sel1.2, Ant_Sel1.4, Ant_Sel1.6
unnamed: C1.2, C2.2, C3.2, C4.2, C5.1, C6.2, L1.1
unnamed: C5.2, C6.1, C7.2, C9.1, C10.1, C11.1, L2.1
unnamed: C32.2, IQ_Audio_SR1.R, TP1.1
unnamed: C33.2, IQ_Audio_SR1.T, TP2.1
unnamed: C34.2, IQ_Audio_SM0XGY1.T, TP3.1
unnamed: C35.2, IQ_Audio_SM0XGY1.R, TP4.1
unnamed: D1.2 (A), D2.1 (K), T2.3 (SA)
unnamed: D1.1 (K), D3.2 (A), T1.5 (SB)
unnamed: D2.2 (A), D4.1 (K), T1.3 (SA)
unnamed: D3.1 (K), D4.2 (A), T2.5 (SB)
unnamed 30: LO_Clk_In.1, LO_Select1.2, LO_Select1.4, LO_Select1.6; also elsewhere on the board
unnamed 31: I_Clk_In.1, U7.1 (1A); also elsewhere on the board
unnamed 32: Q_Clk_In.1, U7.3 (2A); also elsewhere on the board
unnamed: R1.1, XMER3.3
unnamed: R2.1, XMER3.1
unnamed: C10.2, C11.2, Select_RF_Input1.1, Select_RF_Input1.3
unnamed: R3.1, Select_RF_Input1.4, Select_RF_Input1.10
unnamed: U1.1, U1.4, XMER1.3
unnamed: U1.2, U1.9, XMER2.1
unnamed: U1.3, U1.10, XMER2.3
unnamed: U1.8, U1.11, XMER1.1
unnamed: U1.12, U1.13, U2.4 (Y)
unnamed: C26.2, R9.1, U3.3 (IN+)
unnamed: C27.2, C31.1, R11.1, U3.2 (IN-)
unnamed: C31.2, C35.1, R11.2, U3.1 (OUT)
unnamed: C24.2, R8.1, U3.5 (IN+)
unnamed: C25.2, C30.1, R10.1, U3.6 (IN-)
unnamed: C30.2, C34.1, R10.2, U3.7 (OUT)
unnamed: C28.1, R5.2, R6.1, U4.2 (IN-)
unnamed: C29.1, R4.2, R7.1, U4.6 (IN-)
unnamed: C29.2, C32.1, R7.2, U4.7 (OUT)
unnamed: C18.1, R5.1, U5.7 (1A)
unnamed: R1.2, U5.6 (1B1), U5.11 (2B2)
unnamed: R2.2, U5.3 (1B4), U5.12 (2B3)
unnamed: C19.1, R4.1, U5.9 (2A)
unnamed: R3.2, U6.7 (1A)

Notes on the sheet:
IQ Mixer - Soft Rock
Bandpass 40m
Double Balanced Mixer - ADE-1+
Double Balanced Mixer Test
IQ Mixer Test
Double BAlanced Mixer - Analog Switches
Double Balanced Mixer - Schottky Switches
IQ Mixer - SM0XGY

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
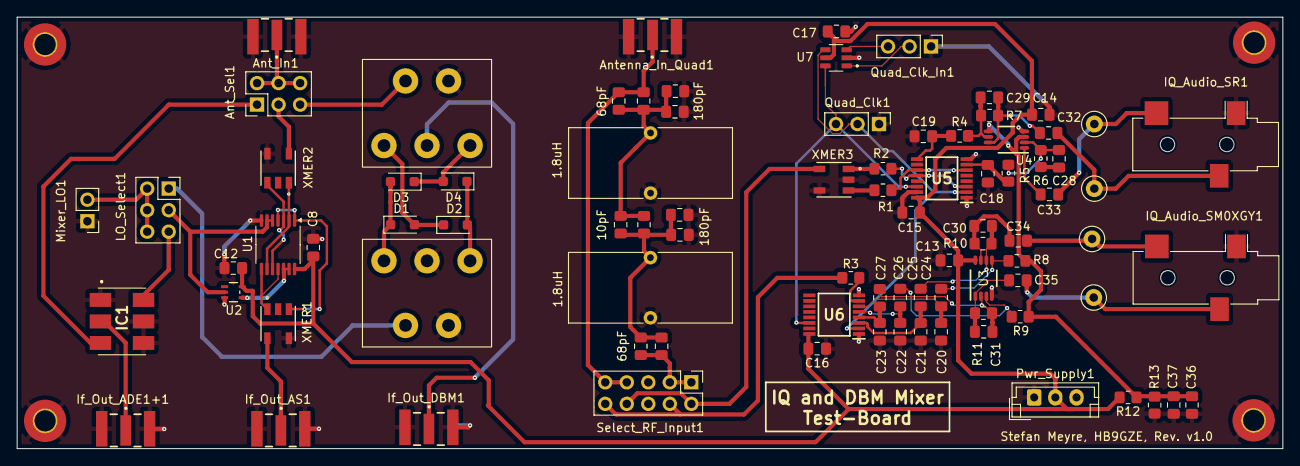
[picture p42: board MixerTest.kicad_pcb from above]

Board: 2 copper layers, 149.4 x 50.9 mm, 91 parts (0 on the bottom side), 59 nets.

Other parts of the board:
Mixer_LO1: Conn_01x02_Socket; PinHeader_1x02_P2.54mm_Vertical
Quad_Clk_In1: Conn_01x03; PinHeader_1x03_P2.54mm_Vertical

Their connections:
unnamed 30: Mixer_LO1.2; also elsewhere on the board
unnamed 31: Quad_Clk_In1.2; also elsewhere on the board
unnamed 32: Quad_Clk_In1.3; also elsewhere on the board
