HB9GZE/PhasorRadio/KiCAD Files/PowerAmp/PowerAmp/PowerAmp.kicad_pcb

## KiCad design KiCAD Files/PowerAmp/PowerAmp/PowerAmp.kicad_pcb (2024-05-30)

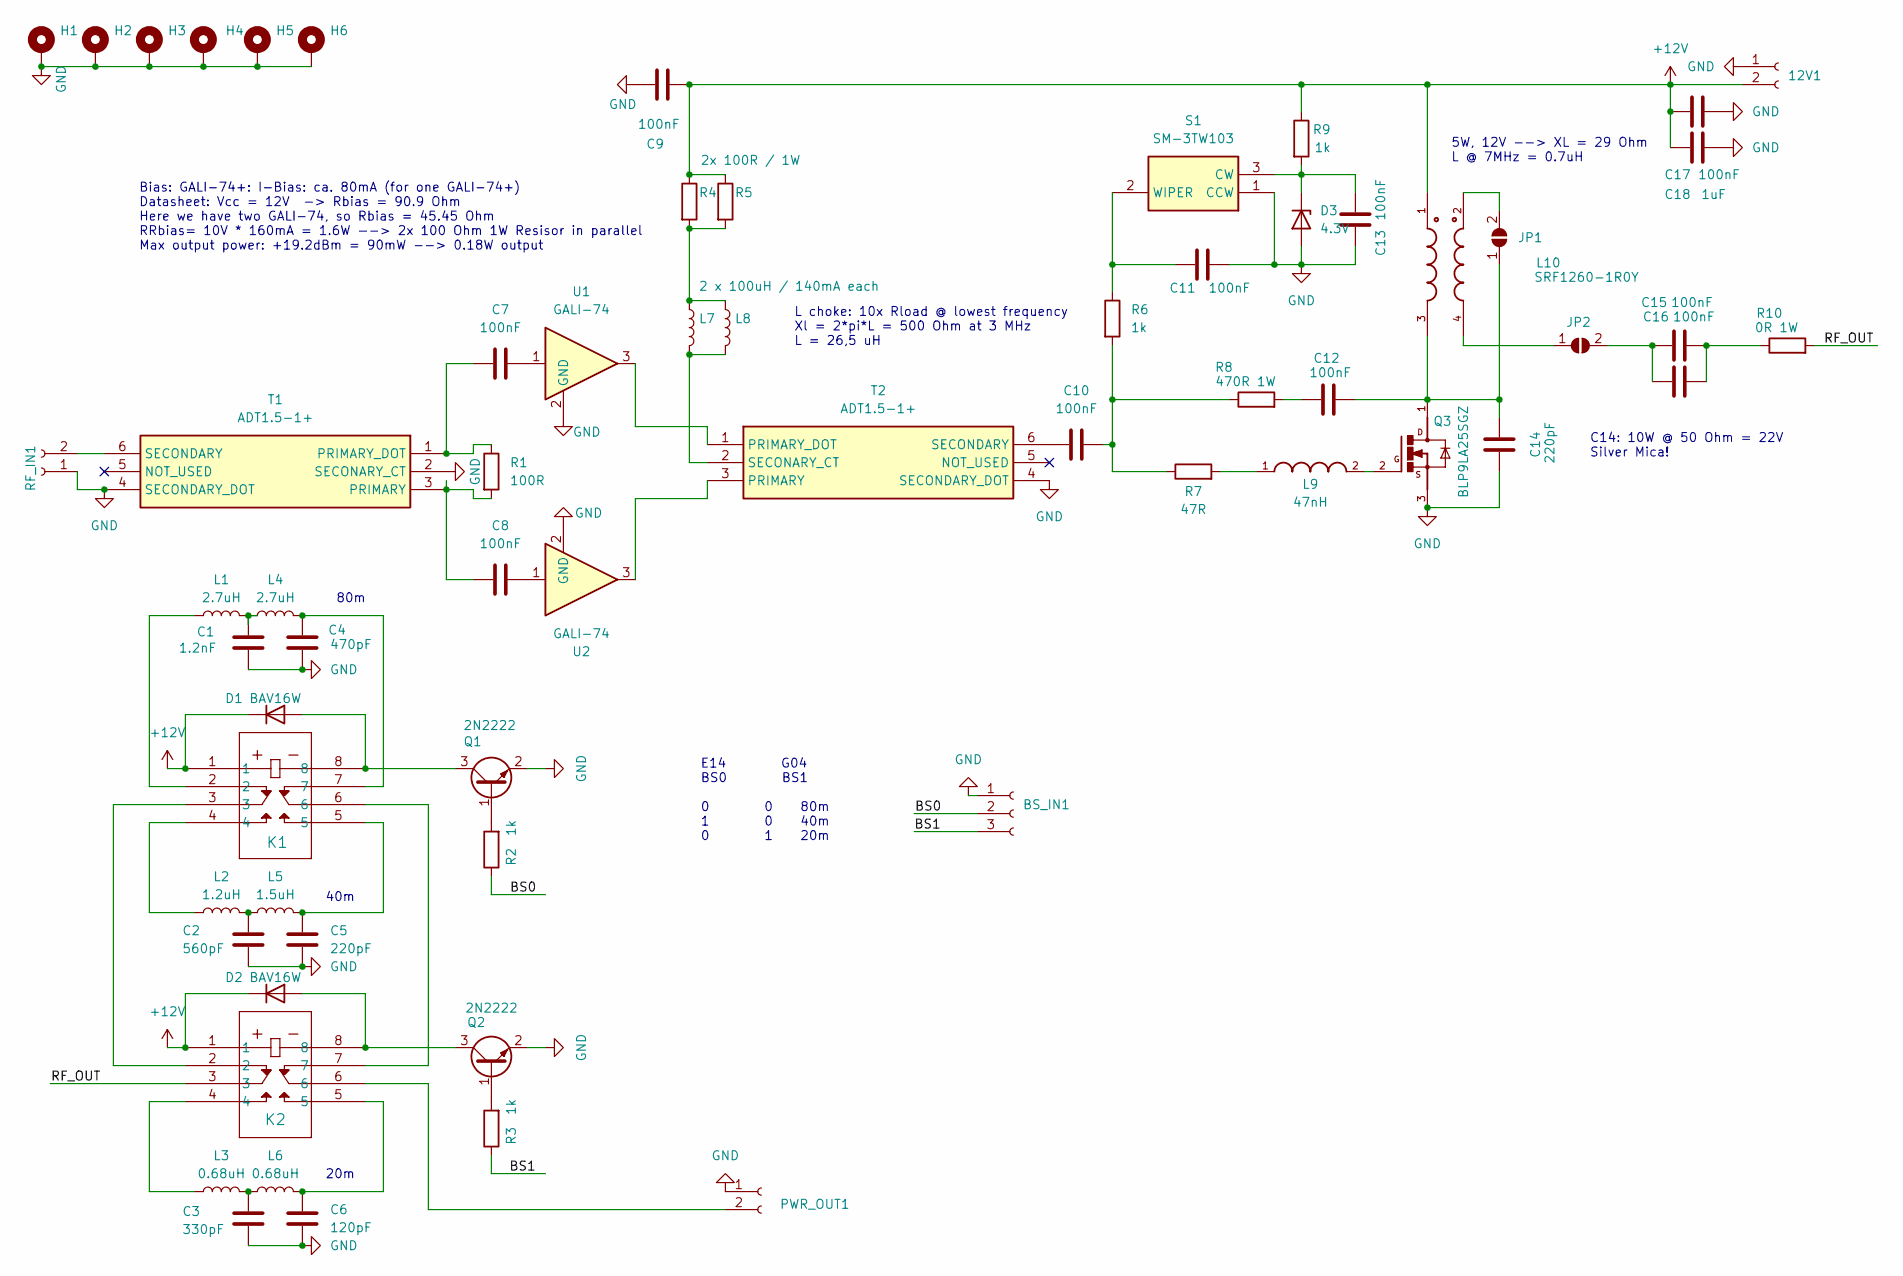
[picture p43: schematic PowerAmp.kicad_sch, Phasor Radio: 5W Power Amplifier]

Parts:
12V1: Conn_01x02_Socket; PinHeader_1x02_P1.00mm_Vertical_SMD
BS_IN1: Conn_01x03_Socket; PinHeader_1x03_P1.00mm_Vertical_SMD
C1: 1.2nF; C_0805_2012Metric_Pad1.18x1.45mm_HandSolder
C2: 560pF; C_0805_2012Metric_Pad1.18x1.45mm_HandSolder
C3: 330pF; C_0805_2012Metric_Pad1.18x1.45mm_HandSolder
C4: 470pF; C_0805_2012Metric_Pad1.18x1.45mm_HandSolder
C5: 220pF; C_0805_2012Metric_Pad1.18x1.45mm_HandSolder
C6: 120pF; C_0805_2012Metric_Pad1.18x1.45mm_HandSolder
C7, C8, C9, C10, C11, C12, C13, C15, C16, C17: 100nF; C_0805_2012Metric_Pad1.18x1.45mm_HandSolder
C14: 220pF; C_2220_5750Metric_Pad1.97x5.40mm_HandSolder
C18: 1uF; C_0805_2012Metric_Pad1.18x1.45mm_HandSolder
D1, D2: BAV16W; D_SOD-123
D3: 4.3V; D_SOD-123
H1, H2, H3, H4, H5, H6: MountingHole_Pad; MountingHole_2.7mm_M2.5_DIN965_Pad_TopBottom
JP1, JP2: SolderJumper_2_Open; SolderJumper-2_P1.3mm_Open_Pad1.0x1.5mm
K1, K2: G6K-2F-Y DC3; G6K-2F-Y DC3_OMR
L1, L4: 2.7uH; L_Toroid_Vertical_L16.3mm_W7.1mm_P7.11mm_SMD
L2: 1.2uH; L_Toroid_Vertical_L16.3mm_W7.1mm_P7.11mm_SMD
L3, L6: 0.68uH; L_Toroid_Vertical_L16.3mm_W7.1mm_P7.11mm_SMD
L5: 1.5uH; L_Toroid_Vertical_L16.3mm_W7.1mm_P7.11mm_SMD
L7: 2 x 100uH / 140mA each; L_0805_2012Metric_Pad1.15x1.40mm_HandSolder
L8: 30uH / 200mA; L_0805_2012Metric_Pad1.15x1.40mm_HandSolder
L9: 47nH; INDC2624X203N
L10: SRF1260-1R0Y; IND_SRF1260-1R0Y; DigiKey_Part_Number SRF1260-1R0YTR-ND
PWR_OUT1: Conn_01x02_Socket; PinHeader_1x02_P1.00mm_Vertical_SMD
Q1, Q2: 2N2222; SOT-23
Q3: BLP9LA25SGZ; BLP9LA25SGZ_SOT1483-1_TO270
R1: 100R; R_0805_2012Metric_Pad1.20x1.40mm_HandSolder
R2, R3, R6, R9: 1k; R_0805_2012Metric_Pad1.20x1.40mm_HandSolder
R4: 2x 100R / 1W; R_2512_6332Metric_Pad1.40x3.35mm_HandSolder
R5: 100R 1W; R_2512_6332Metric_Pad1.40x3.35mm_HandSolder
R7: 47R; R_0805_2012Metric_Pad1.20x1.40mm_HandSolder
R8: 470R 1W; R_2512_6332Metric_Pad1.40x3.35mm_HandSolder
R10: 0R 1W; R_2512_6332Metric_Pad1.40x3.35mm_HandSolder
RF_IN1: Conn_01x02_Socket; PinHeader_1x02_P1.00mm_Vertical_SMD
S1: SM-3TW103; SM3TW103; Manufacturer_Part_Number SM-3TW103; Mouser Part Number 229-SM-3TW103
T1, T2: ADT1.5-1+; ADT151; Manufacturer_Part_Number ADT1.5-1+; Mouser Part Number 139-ADT1.5-1
U1, U2: GALI-74; SOT-89-3

Connections:
+12V: 12V1.2, C9.1, C17.2, C18.2, D1.1 (K), D2.1 (K), K1.1, K2.1, L10.1, R4.1, R5.1, R9.1; also elsewhere on the board
/BS0: BS_IN1.2, R2.1; also elsewhere on the board
/BS1: BS_IN1.3, R3.1; also elsewhere on the board
/RF_OUT: K2.3, R10.2
GND: 12V1.1, BS_IN1.1, C1.2, C2.2, C3.2, C4.2, C5.2, C6.2, C9.2, C11.2, C13.1, C14.1, C17.1, C18.1, D3.2 (A), H1.1, H2.1, H3.1, H4.1, H5.1, H6.1, PWR_OUT1.1, Q1.2 (E), Q2.2 (E), Q3.3, RF_IN1.1, S1.1 (CCW), T1.2 (SECONARY_CT), T1.4 (SECONDARY_DOT), T2.4 (SECONDARY_DOT), U1.2 (GND), U2.2 (GND); also elsewhere on the board
unnamed: C1.1, L1.2, L4.1
unnamed: C2.1, L2.2, L5.1
unnamed: C3.1, L3.2, L6.1
unnamed: C4.1, K1.7, L4.2
unnamed: C5.1, K1.5, L5.2
unnamed: C6.1, K2.5, L6.2
unnamed: C7.2, U1.1
unnamed: C8.2, U2.1
unnamed: C10.2, R6.2, R7.1, R8.1
unnamed: C12.1, R8.2
unnamed: C15.2, C16.2, R10.1
unnamed: D1.2 (A), K1.8, Q1.3 (C)
unnamed: D2.2 (A), K2.8, Q2.3 (C)
unnamed: C13.2, D3.1 (K), R9.2, S1.3 (CW)
unnamed: C12.2, C14.2, JP1.1 (A), L10.3, Q3.1
unnamed: JP1.2 (B), L10.2
unnamed: JP2.1 (A), L10.4
unnamed: C15.1, C16.1, JP2.2 (B)
unnamed: K1.2, L1.1
unnamed: K1.3, K2.2
unnamed: K1.4, L2.1
unnamed: K1.6, K2.7
unnamed: K2.4, L3.1
unnamed: L7.1, L8.1, R4.2, R5.2
unnamed: L9.1, R7.2
unnamed: L9.2, Q3.2
unnamed 31: K2.6, PWR_OUT1.2; also elsewhere on the board
unnamed: Q1.1 (B), R2.2
unnamed: Q2.1 (B), R3.2
unnamed 34: RF_IN1.2, T1.6 (SECONDARY); also elsewhere on the board
unnamed: C11.1, R6.1, S1.2 (WIPER)
unnamed: C8.1, R1.2, T1.3 (PRIMARY)
unnamed: C7.1, R1.1, T1.1 (PRIMARY_DOT)
unnamed: T2.3 (PRIMARY), U2.3
unnamed: T2.1 (PRIMARY_DOT), U1.3
unnamed: L7.2, L8.2, T2.2 (SECONARY_CT)
unnamed: C10.1, T2.6 (SECONDARY)

Notes on the sheet:
40m
20m
L choke: 10x Rload @ lowest frequency Xl = 2*pi*L = 500 Ohm at 3 MHz L = 26,5 uH
80m
5W, 12V --> XL = 29 Ohm L @ 7MHz = 0.7uH
Bias: GALI-74+: I-Bias: ca. 80mA (for one GALI-74+) Datasheet: Vcc = 12V -> Rbias = 90.9 Ohm Here we have two GALI-74, so Rbias = 45.45 Ohm RRbias= 10V * 160mA = 1.6W --> 2x 100 Ohm 1W Resisor in parallel Max output power: +19.2dBm = 90mW --> 0.18W output
E14 G04 BS0 BS1 0 0 80m 1 0 40m 0 1 20m
C14: 10W @ 50 Ohm = 22V Silver Mica!

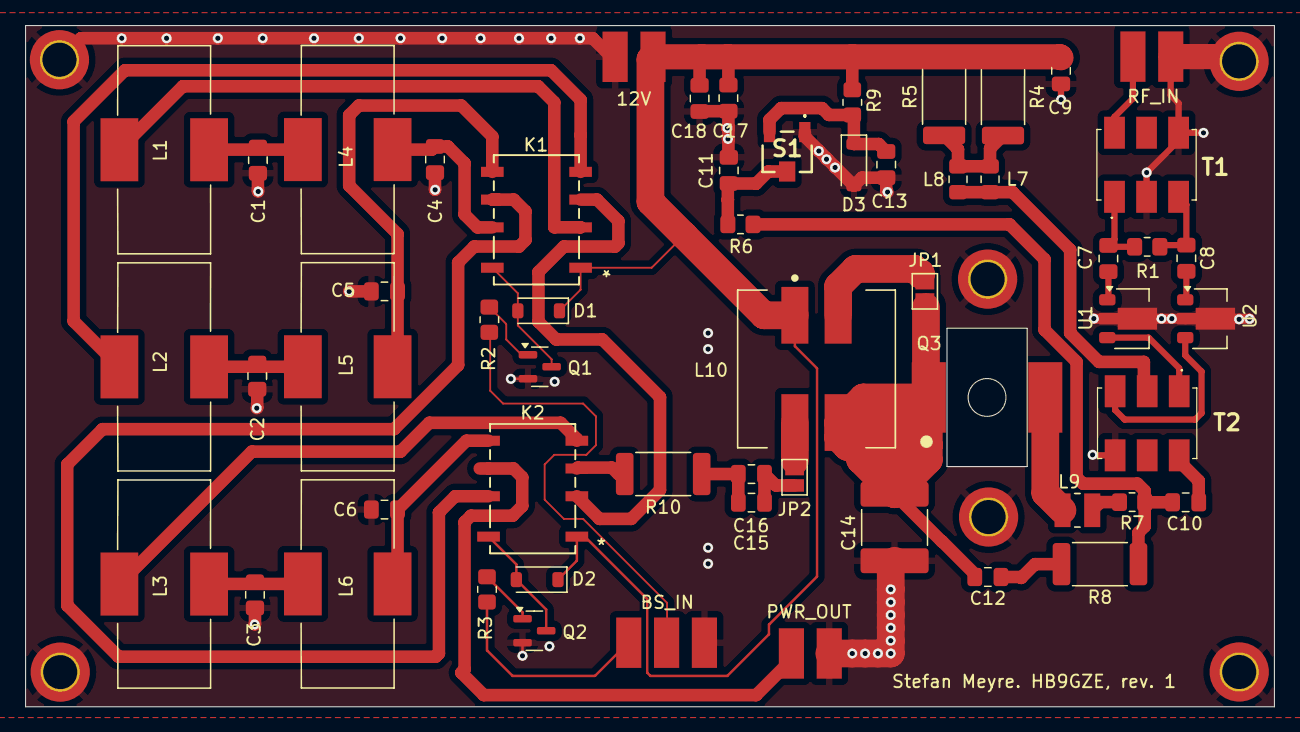
[picture p44: board PowerAmp.kicad_pcb from above]

Board: 2 copper layers, 99.0 x 54.0 mm, 63 parts (0 on the bottom side), 42 nets.

Other parts of the board:
12V: Conn_01x02_Socket; PinHeader_1x02_P1.00mm_Vertical_SMD
BS_IN: Conn_01x03_Socket; PinHeader_1x03_P1.00mm_Vertical_SMD
PWR_OUT: Conn_01x02_Socket; PinHeader_1x02_P1.00mm_Vertical_SMD
RF_IN: Conn_01x02_Socket; PinHeader_1x02_P1.00mm_Vertical_SMD

Their connections:
+12V: 12V.2; also elsewhere on the board
/BS0: BS_IN.2; also elsewhere on the board
/BS1: BS_IN.3; also elsewhere on the board
GND: 12V.1, BS_IN.1, PWR_OUT.1, RF_IN.1; also elsewhere on the board
unnamed 31: PWR_OUT.2; also elsewhere on the board
unnamed 34: RF_IN.2; also elsewhere on the board
