HB9GZE/PhasorRadio/KiCAD Files/AntennaAmp/AntennaAmp.kicad_pcb

## KiCad design KiCAD Files/AntennaAmp/AntennaAmp.kicad_pcb (2024-05-30)

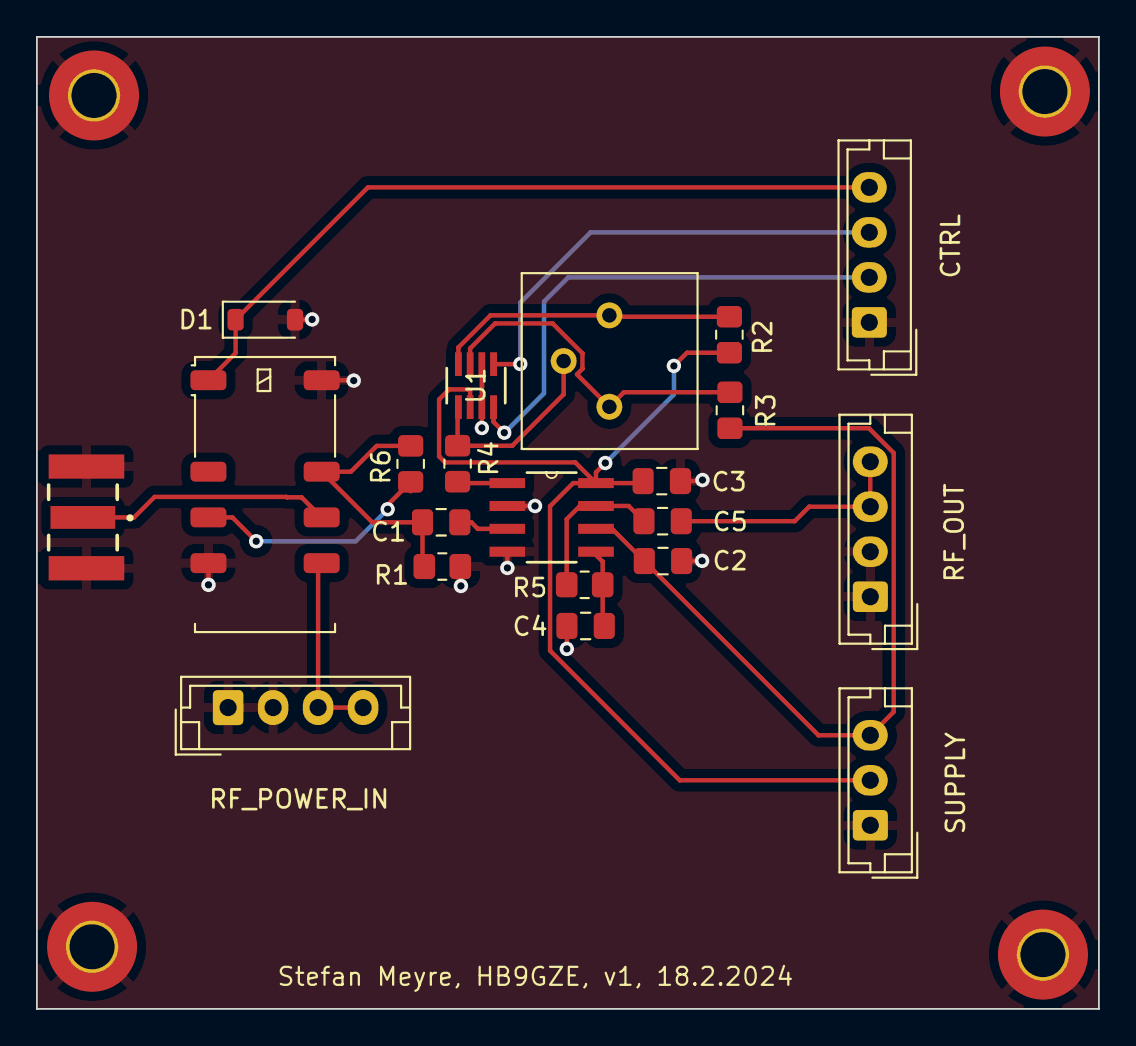
[picture p45: board AntennaAmp.kicad_pcb from above]

Board: 2 copper layers, 59.0 x 54.0 mm, 25 parts (0 on the bottom side), 18 nets.

Parts:
C1, C2, C3, C5: 100nF; C_0805_2012Metric_Pad1.18x1.45mm_HandSolder
C4: 5.6pF; C_0805_2012Metric_Pad1.18x1.45mm_HandSolder
CTRL: CTRL; JST_EH_B4B-EH-A_1x04_P2.50mm_Vertical
D1: 1N4148W; D_SOD-123
H1, H2, H3, H4: MountingHole_Pad; MountingHole_2.5mm_Pad_TopBottom
J1: SMA; SAMTEC_SMA-J-P-H-ST-EM1
K1: EE2-3NUH; Relay_DPDT_Kemet_EE2_NUH
R1, R4: 100R; R_0805_2012Metric_Pad1.20x1.40mm_HandSolder
R2, R3: 10k; R_0805_2012Metric_Pad1.20x1.40mm_HandSolder
R5, R6: 0R; R_0805_2012Metric_Pad1.20x1.40mm_HandSolder
RF_OUT: RF_OUT; JST_EH_B4B-EH-A_1x04_P2.50mm_Vertical
RF_POWER_IN: RF_POWER_IN; JST_EH_B4B-EH-A_1x04_P2.50mm_Vertical
RV1: 5k; Potentiometer_Bourns_3386P_Vertical
SUPPLY: SUPPLY; JST_EH_B3B-EH-A_1x03_P2.50mm_Vertical
U1: AD5245BRJZ5-RL7; AD5245
U2: AD603ARZ; AD603

Connections:
+5V: C3.2, R2.1, SUPPLY.2, U1.2 (VDD), U2.8 (VPOS)
-5V: C2.1, R3.1, SUPPLY.3, U2.6 (VNEG)
/A: R2.2, RV1.1, U1.8 (A)
/B: R3.2, RV1.3, U1.7 (B)
/PTT: CTRL.4, D1.1 (K), K1.1
/RF1: J1.1, K1.9
/RF2: C1.1, K1.10, R1.1, R6.1
/RF3: C1.2, U2.3 (VINP)
/RF_PWR_IN: K1.8, RF_POWER_IN.3, RF_POWER_IN.4
/SCL: CTRL.2, U1.4 (SCL)
/SDA: CTRL.3, U1.5 (SDA)
/W: R4.1, RV1.2, U1.1 (W)
GND: C2.2, C3.1, C4.1, CTRL.1, D1.2 (A), H1.1, H2.1, H3.1, H4.1, J1.2_1, J1.2_2, J1.3_1, J1.3_2, K1.5, K1.12, R1.2, RF_OUT.1, RF_OUT.2, RF_POWER_IN.1, RF_POWER_IN.2, SUPPLY.1, U1.3 (GND), U1.6 (AD0), U2.2 (GNEG), U2.4 (COMM)
unnamed: K1.4, R6.2
unnamed: C5.2, RF_OUT.3, RF_OUT.4
unnamed: C4.2, R5.1, U2.5 (FDBK)
unnamed: R4.2, U2.1 (GPOS)
unnamed: C5.1, R5.2, U2.7 (VOUT)
