HB9GZE/PhasorRadio/KiCAD Files/PwrSupply/PwrSupply/PwrSupply.kicad_pcb

## KiCad design KiCAD Files/PwrSupply/PwrSupply/PwrSupply.kicad_pcb (2024-05-30)

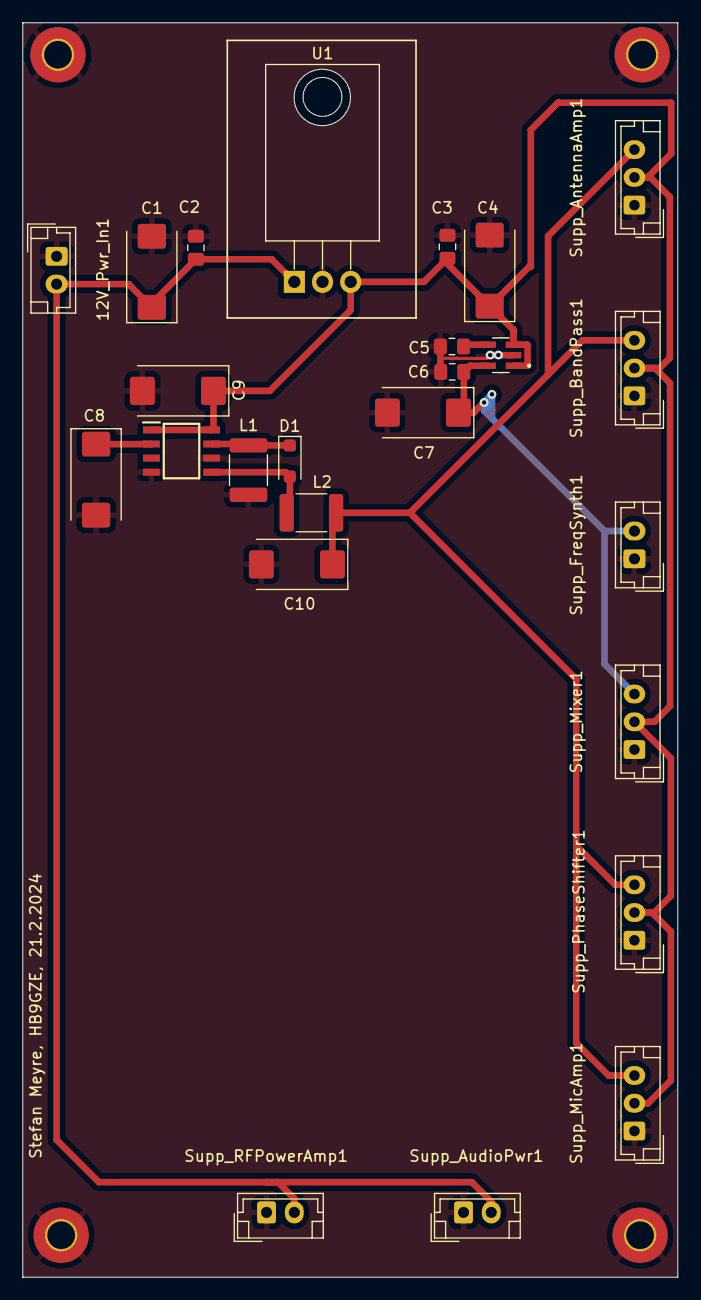
[picture p46: board PwrSupply.kicad_pcb from above]

Board: 2 copper layers, 59.0 x 113.0 mm, 28 parts (0 on the bottom side), 8 nets.

Parts:
12V_Pwr_In1: 12V_Pwr_In; JST_EH_B2B-EH-A_1x02_P2.50mm_Vertical
C1, C4: 47uF Tant. 25V; CP_EIA-7343-30_AVX-N_Pad2.25x2.55mm_HandSolder
C2, C3, C6: 100nF; C_0805_2012Metric_Pad1.18x1.45mm_HandSolder
C5: 1uF; C_0805_2012Metric_Pad1.18x1.45mm_HandSolder
C7, C8: 10uF Tant. 25V; CP_EIA-7343-30_AVX-N_Pad2.25x2.55mm_HandSolder
C9: 1uF, Tant. 25V; CP_EIA-7343-30_AVX-N_Pad2.25x2.55mm_HandSolder
C10: 100uF Tant. 25V; CP_EIA-7343-30_AVX-N_Pad2.25x2.55mm_HandSolder
D1: PMEG2010AEH; D_SOD-123F
H1, H2, H3, H4: MountingHole_Pad; MountingHole_2.5mm_Pad_TopBottom
IC1: NCP700BSN33T1G; SOT95P275X120-5N
L1, L2: 10uH; L_1812_4532Metric_Pad1.30x3.40mm_HandSolder
Supp_AntennaAmp1: Supp_AntennaAmp; JST_EH_B3B-EH-A_1x03_P2.50mm_Vertical
Supp_AudioPwr1: Supp_FreqSynth; JST_EH_B2B-EH-A_1x02_P2.50mm_Vertical
Supp_BandPass1: Supp_BandPass; JST_EH_B3B-EH-A_1x03_P2.50mm_Vertical
Supp_FreqSynth1: Supp_FreqSynth; JST_EH_B2B-EH-A_1x02_P2.50mm_Vertical
Supp_MicAmp1: Supp_MicAmp; JST_EH_B3B-EH-A_1x03_P2.50mm_Vertical
Supp_Mixer1: Supp_Mixer; JST_EH_B3B-EH-A_1x03_P2.50mm_Vertical
Supp_PhaseShifter1: Supp_PhaseShifter; JST_EH_B3B-EH-A_1x03_P2.50mm_Vertical
Supp_RFPowerAmp1: Supp_FreqSynth; JST_EH_B2B-EH-A_1x02_P2.50mm_Vertical
U1: L7805; TO-220-3_Horizontal_TabDown

Connections:
+3.3V: C6.1, C7.1, IC1.5 (OUT), Supp_FreqSynth1.2, Supp_Mixer1.3
+5V: C3.1, C4.1, C9.1, IC1.1 (IN), IC1.3 (EN), Supp_AntennaAmp1.2, Supp_BandPass1.2, Supp_MicAmp1.2, Supp_Mixer1.2, Supp_PhaseShifter1.2, U1.3 (OUT)
+12V: 12V_Pwr_In1.2, C1.1, C2.1, Supp_AudioPwr1.2, Supp_RFPowerAmp1.2, U1.1 (IN)
-5V: C10.1, L2.2, Supp_AntennaAmp1.3, Supp_BandPass1.3, Supp_MicAmp1.3, Supp_PhaseShifter1.3
GND: 12V_Pwr_In1.1, C1.2, C2.2, C3.2, C4.2, C5.1, C6.2, C7.2, C8.2, C9.2, C10.2, H1.1, H2.1, H3.1, H4.1, IC1.2 (GND), L1.2, Supp_AntennaAmp1.1, Supp_AudioPwr1.1, Supp_BandPass1.1, Supp_FreqSynth1.1, Supp_MicAmp1.1, Supp_Mixer1.1, Supp_PhaseShifter1.1, Supp_RFPowerAmp1.1, U1.2 (GND)
unnamed: D1.2 (A), L2.1
unnamed: D1.1 (K), L1.1
unnamed: C5.2, IC1.4 (BYP)
