HB9GZE/PhasorRadio/KiCAD Files/BandpassFilter/BandpassFilter/BandpassFilter.kicad_pcb

## KiCad design KiCAD Files/BandpassFilter/BandpassFilter/BandpassFilter.kicad_pcb (2024-05-30)

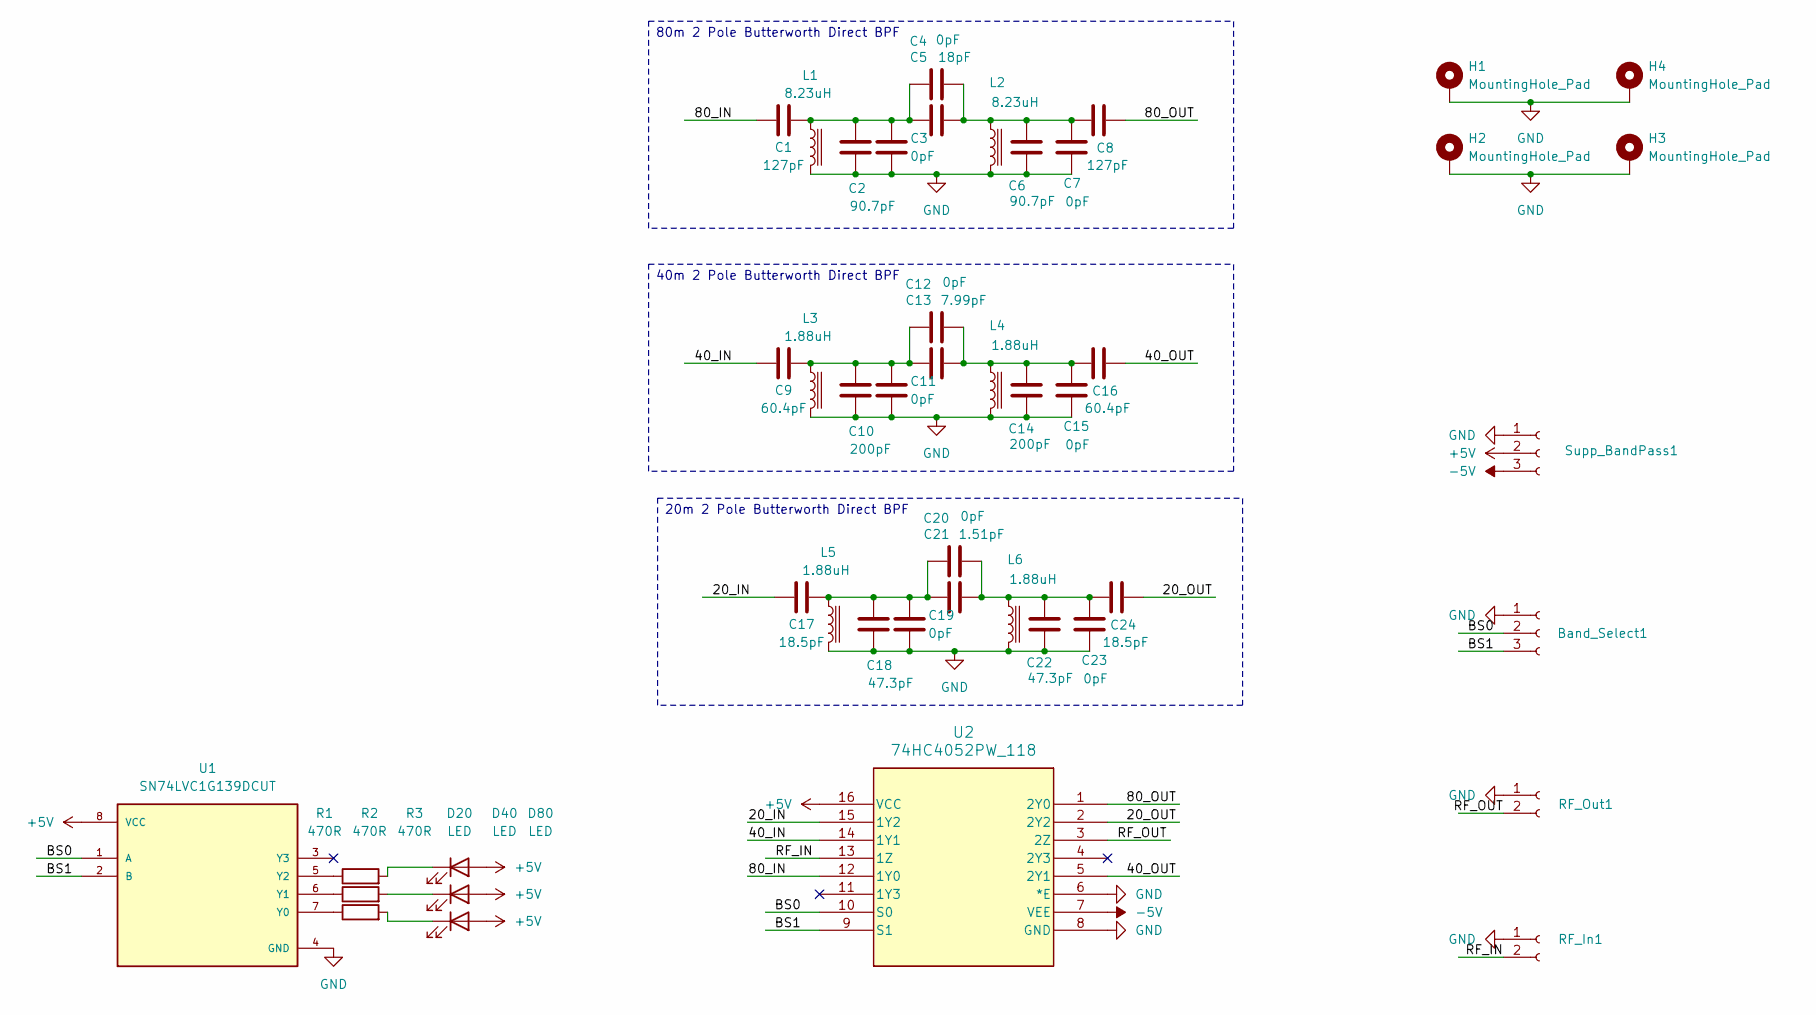
[picture p47: schematic BandpassFilter.kicad_sch, Phasor Radio: Bandpass-Filter]

Parts:
Band_Select1: JST_EH_B3B-EH-A_1x03_P2.50mm_Vertical
C1, C8: 127pF; C_0805_2012Metric_Pad1.18x1.45mm_HandSolder
C2, C6: 90.7pF; C_0805_2012Metric_Pad1.18x1.45mm_HandSolder
C3, C4, C7, C11, C12, C15, C19, C20, C23: 0pF; C_0805_2012Metric_Pad1.18x1.45mm_HandSolder
C5: 18pF; C_0805_2012Metric_Pad1.18x1.45mm_HandSolder
C9, C16: 60.4pF; C_0805_2012Metric_Pad1.18x1.45mm_HandSolder
C10, C14: 200pF; C_0805_2012Metric_Pad1.18x1.45mm_HandSolder
C13: 7.99pF; C_0805_2012Metric_Pad1.18x1.45mm_HandSolder
C17, C24: 18.5pF; C_0805_2012Metric_Pad1.18x1.45mm_HandSolder
C18, C22: 47.3pF; C_0805_2012Metric_Pad1.18x1.45mm_HandSolder
C21: 1.51pF; C_0805_2012Metric_Pad1.18x1.45mm_HandSolder
D20, D40, D80: LED; LED_0805_2012Metric_Pad1.15x1.40mm_HandSolder
H1, H2, H3, H4: MountingHole_Pad; MountingHole_2.5mm_Pad_TopBottom
L1, L2: 8.23uH; L_Toroid_Vertical_L19.1mm_W8.1mm_P7.10mm_Bourns_5700
L3, L4, L5, L6: 1.88uH; L_Toroid_Vertical_L19.1mm_W8.1mm_P7.10mm_Bourns_5700
R1, R2, R3: 470R; R_0805_2012Metric_Pad1.20x1.40mm_HandSolder
RF_In1: PinHeader_1x02_P2.54mm_Vertical
RF_Out1: PinHeader_1x02_P2.54mm_Vertical
Supp_BandPass1: JST_EH_B3B-EH-A_1x03_P2.50mm_Vertical
U1: SN74LVC1G139DCUT; SOP50P310X90-8N; PARTREV E
U2: 74HC4052PW_118; TSSOP16_5P1X4P5_NEX

Connections:
+5V: D20.2 (A), D40.2 (A), D80.2 (A), Supp_BandPass1.2, U1.8 (VCC), U2.16 (VCC); also elsewhere on the board
-5V: Supp_BandPass1.3, U2.7 (VEE); also elsewhere on the board
/20_IN: C17.1, U2.15 (1Y2)
/20_OUT: C24.2, U2.2 (2Y2)
/40_IN: C9.1, U2.14 (1Y1)
/40_OUT: C16.2, U2.5 (2Y1)
/80_IN: C1.1, U2.12 (1Y0)
/80_OUT: C8.2, U2.1 (2Y0)
/BS0: Band_Select1.2, U1.1 (A), U2.10 (S0); also elsewhere on the board
/BS1: Band_Select1.3, U1.2 (B), U2.9 (S1); also elsewhere on the board
/RF_IN: RF_In1.2, U2.13 (1Z); also elsewhere on the board
/RF_OUT: RF_Out1.2, U2.3 (2Z); also elsewhere on the board
GND: Band_Select1.1, C2.1, C3.1, C6.1, C7.1, C10.1, C11.1, C14.1, C15.1, C18.1, C19.1, C22.1, C23.1, H1.1, H2.1, H3.1, H4.1, L1.2, L2.2, L3.2, L4.2, L5.2, L6.2, RF_In1.1, RF_Out1.1, Supp_BandPass1.1, U1.4 (GND), U2.6 (*E), U2.8 (GND); also elsewhere on the board
unnamed: C1.2, C2.2, C3.2, C4.2, C5.2, L1.1
unnamed: C4.1, C5.1, C6.2, C7.2, C8.1, L2.1
unnamed: C9.2, C10.2, C11.2, C12.2, C13.2, L3.1
unnamed: C12.1, C13.1, C14.2, C15.2, C16.1, L4.1
unnamed: C17.2, C18.2, C19.2, C20.2, C21.2, L5.1
unnamed: C20.1, C21.1, C22.2, C23.2, C24.1, L6.1
unnamed: D20.1 (K), R1.2
unnamed: D40.1 (K), R2.2
unnamed: D80.1 (K), R3.2
unnamed: R3.1, U1.7 (Y0)
unnamed: R2.1, U1.6 (Y1)
unnamed: R1.1, U1.5 (Y2)

Notes on the sheet:
40m 2 Pole Butterworth Direct BPF
20m 2 Pole Butterworth Direct BPF
80m 2 Pole Butterworth Direct BPF

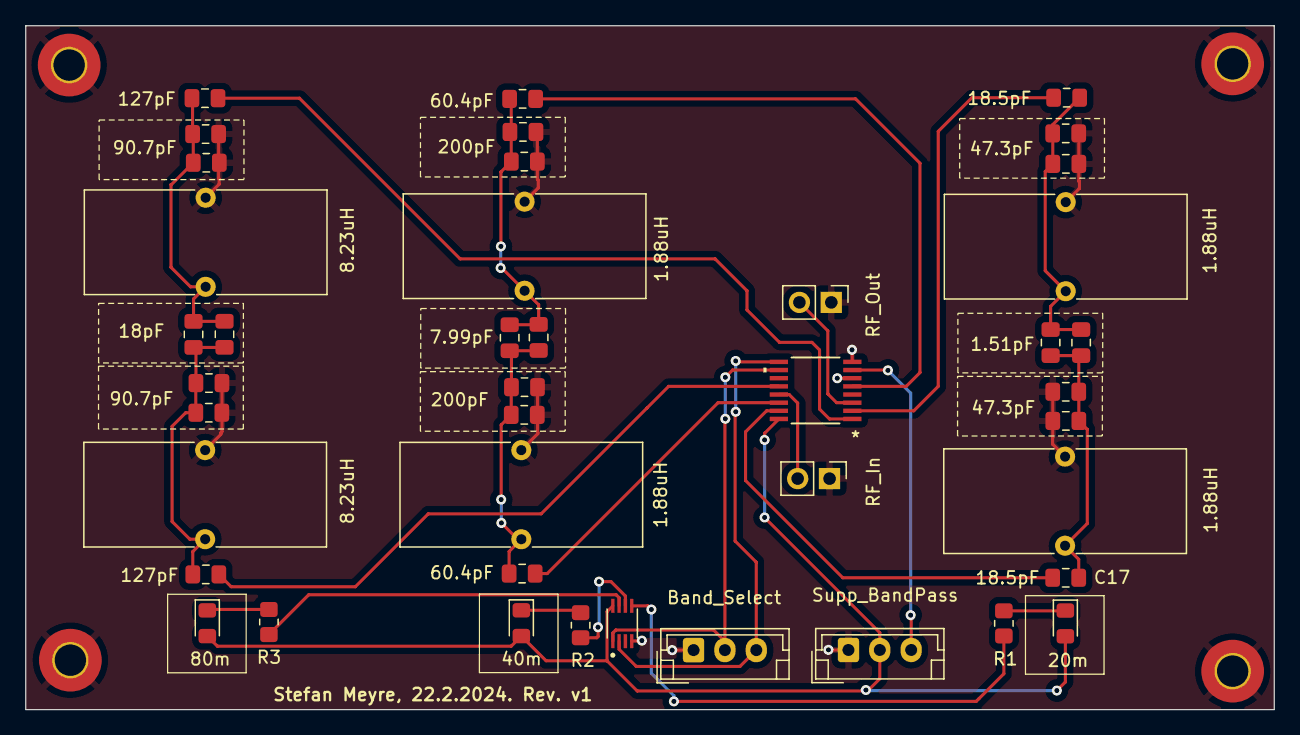
[picture p48: board BandpassFilter.kicad_pcb from above]

Board: 2 copper layers, 99.5 x 54.5 mm, 46 parts (0 on the bottom side), 25 nets.

Other parts of the board:
Band_Select: JST_EH_B3B-EH-A_1x03_P2.50mm_Vertical
RF_In: PinHeader_1x02_P2.54mm_Vertical
RF_Out: PinHeader_1x02_P2.54mm_Vertical
Supp_BandPass: JST_EH_B3B-EH-A_1x03_P2.50mm_Vertical

Their connections:
+5V: Supp_BandPass.2; also elsewhere on the board
-5V: Supp_BandPass.3; also elsewhere on the board
/BS0: Band_Select.2; also elsewhere on the board
/BS1: Band_Select.3; also elsewhere on the board
/RF_IN: RF_In.2; also elsewhere on the board
/RF_OUT: RF_Out.2; also elsewhere on the board
GND: Band_Select.1, RF_In.1, RF_Out.1, Supp_BandPass.1; also elsewhere on the board
