HB9GZE/PhasorRadio/KiCAD Files/AudioPower/AudioPower/AudioPower.kicad_pcb

## KiCad design KiCAD Files/AudioPower/AudioPower/AudioPower.kicad_pcb (2024-05-30)

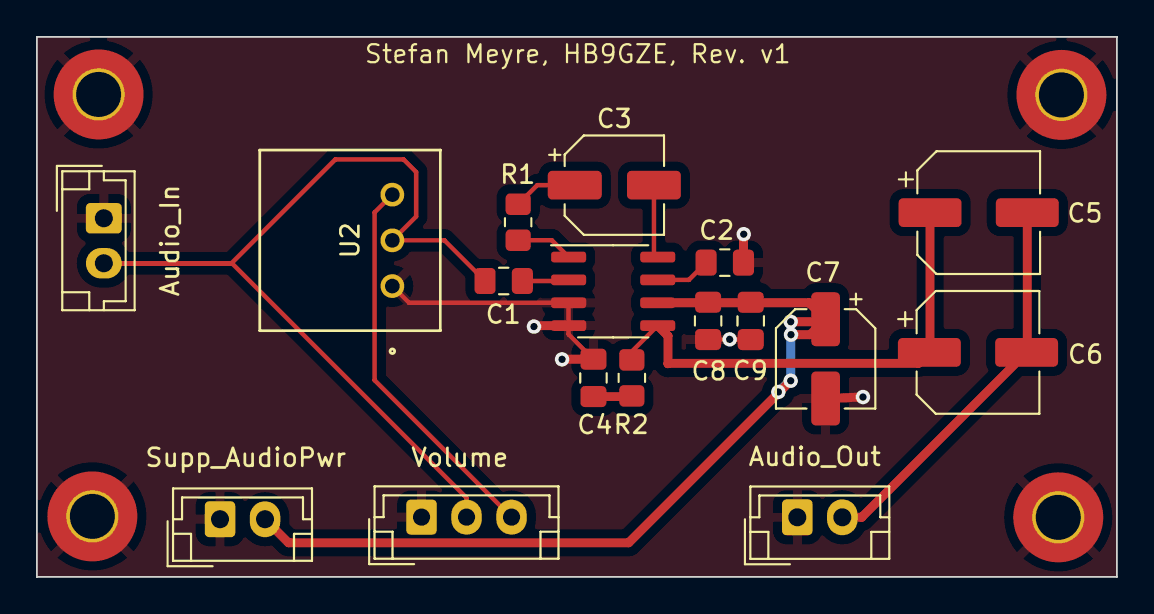
[picture p49: board AudioPower.kicad_pcb from above]

Board: 2 copper layers, 60.0 x 30.0 mm, 21 parts (0 on the bottom side), 12 nets.

Parts:
Audio_In: Conn_01x02_Socket; JST_EH_B2B-EH-A_1x02_P2.50mm_Vertical
Audio_Out: Conn_01x02_Socket; JST_EH_B2B-EH-A_1x02_P2.50mm_Vertical
C1, C2, C8: 1uF; C_0805_2012Metric_Pad1.18x1.45mm_HandSolder
C3, C7: 10uF; CP_Elec_5x3.9
C4: 50nF; C_0805_2012Metric_Pad1.18x1.45mm_HandSolder
C5, C6: 100uF; CP_Elec_6.3x5.7
C9: 100nF; C_0805_2012Metric_Pad1.18x1.45mm_HandSolder
H1, H2, H3, H4: MountingHole_Pad; MountingHole_2.5mm_Pad_TopBottom
R1: 1.2k; R_0805_2012Metric_Pad1.20x1.40mm_HandSolder
R2: 10R; R_0805_2012Metric_Pad1.20x1.40mm_HandSolder
Supp_AudioPwr: Supp_AudioPwr; JST_EH_B2B-EH-A_1x02_P2.50mm_Vertical
U1: LM386; SOIC-8_3.9x4.9mm_P1.27mm
U2: 3310R-125-103L
Volume: Volume; JST_EH_B3B-EH-A_1x03_P2.50mm_Vertical

Connections:
+12V: C7.1, C8.1, C9.1, Supp_AudioPwr.2, U1.6 (V+)
/Audio_In: Audio_In.2, C1.1, U2.2, Volume.2
/Audio_Out: Audio_Out.2, C5.2, C6.2
GND: Audio_In.1, Audio_Out.1, C2.2, C4.1, C7.2, C8.2, C9.2, H1.1, H2.1, H3.1, H4.1, Supp_AudioPwr.1, U1.3 (+), U1.4 (GND), U2.1, Volume.1
unnamed: C3.1, R1.1
unnamed: C3.2, U1.8 (GAIN)
unnamed: C4.2, R2.1
unnamed: C5.1, C6.1, R2.2, U1.5
unnamed: R1.2, U1.1 (GAIN)
unnamed: C1.2, U1.2 (-)
unnamed: C2.1, U1.7 (BYPASS)
unnamed: U2.3, Volume.3
