HB9GZE/PhasorRadio/KiCAD Files/PhaseShifter/PhaseShifter/PhaseShifter.kicad_pcb

## KiCad design KiCAD Files/PhaseShifter/PhaseShifter/PhaseShifter.kicad_pcb (2024-05-30)

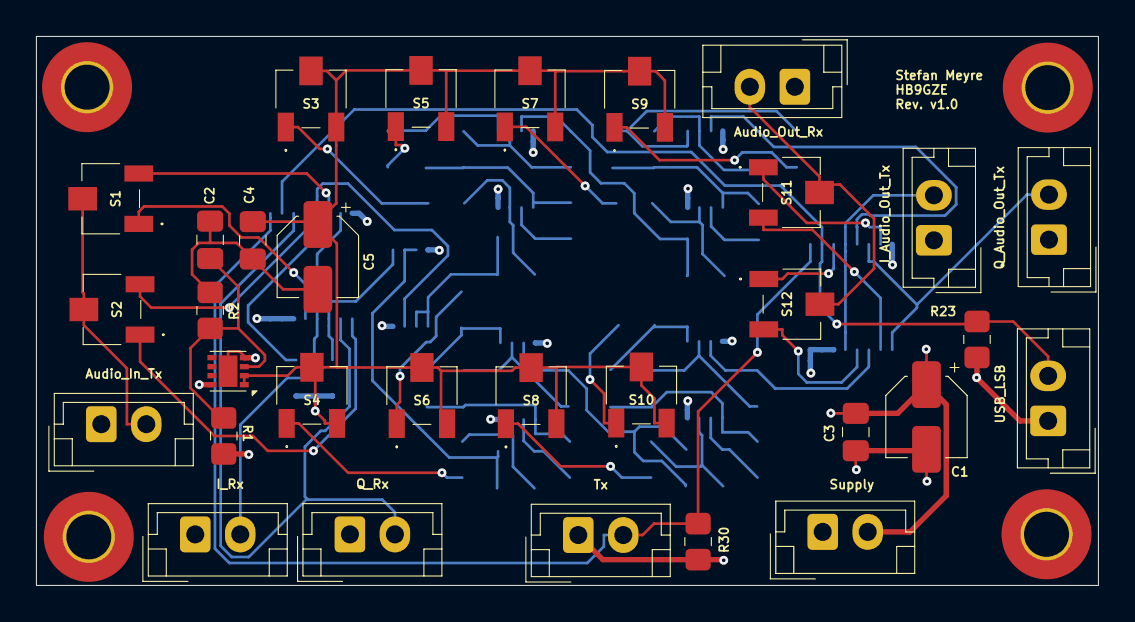
[picture p50: board PhaseShifter.kicad_pcb from above]

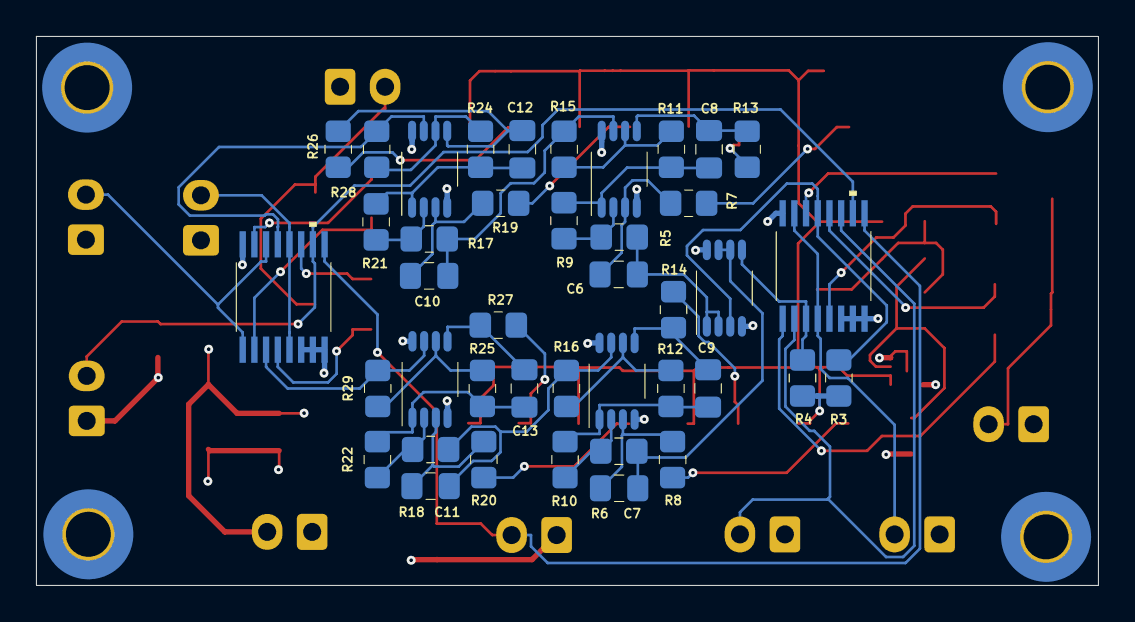
[picture p51: board PhaseShifter.kicad_pcb from below]

Board: 4 copper layers, 59.0 x 30.5 mm, 76 parts (41 on the bottom side), 57 nets.

Parts:
Audio_In_Tx: Conn_01x02_Socket; JST_EH_B2B-EH-A_1x02_P2.50mm_Vertical
Audio_Out_Rx: Conn_01x02_Socket; JST_EH_B2B-EH-A_1x02_P2.50mm_Vertical
C1: 100uF; CP_Elec_4x3.9
C2, C4, C6, C7, C8, C9, C10, C11, C12, C13: 10nF; C_0805_2012Metric_Pad1.18x1.45mm_HandSolder
C3: 100nF; C_0805_2012Metric_Pad1.18x1.45mm_HandSolder
C5: 10uF; CP_Elec_4x3.9
H1, H2, H3, H4: MountingHole_Pad; MountingHole_2.5mm_Pad_TopBottom
I_Audio_Out_Tx: Conn_01x02_Socket; JST_EH_B2B-EH-A_1x02_P2.50mm_Vertical
I_Rx: Conn_01x02_Socket; JST_EH_B2B-EH-A_1x02_P2.50mm_Vertical
Q_Audio_Out_Tx: Conn_01x02_Socket; JST_EH_B2B-EH-A_1x02_P2.50mm_Vertical
Q_Rx: Conn_01x02_Socket; JST_EH_B2B-EH-A_1x02_P2.50mm_Vertical
R1, R2: R; R_0805_2012Metric_Pad1.20x1.40mm_HandSolder
R3, R4, R5, R6, R7, R8, R9, R10, R11, R12, R13, R14, R15, R16, R17, R18, R19, R20, R21, R22, R23, R24, R25, R26, R27, R28, R29, R30: 10k; R_0805_2012Metric_Pad1.20x1.40mm_HandSolder
S1, S2, S3, S5, S6, S7, S8, S9, S10, S11, S12: SM-3TW103; SM3TW103
S4: 8x SM-3TW103; SM3TW103
Supply: Conn_01x02_Socket; JST_EH_B2B-EH-A_1x02_P2.50mm_Vertical
Tx: Conn_01x02_Socket; JST_EH_B2B-EH-A_1x02_P2.50mm_Vertical
U1: 5x OPA1678IDGKT; OPA1678_L
U2: LM358_DFN; DFN-8-1EP_2x2mm_P0.5mm_EP1.05x1.75mm
U3: 2x 74HC4052_SNM; TSSOP16_5P1X4P5_NEX
U4, U5, U6, U7: OPA1678IDGKT; OPA1678_L
U8: 74HC4052_SNM; TSSOP16_5P1X4P5_NEX
USB_LSB: Conn_01x02_Socket; JST_EH_B2B-EH-A_1x02_P2.50mm_Vertical

Connections:
+5V: C1.1, C3.2, R1.1, Supply.2, U1.8 (V+), U2.8 (V+), U3.16 (VDD), U4.8 (V+), U5.8 (V+), U6.8 (V+), U7.8 (V+), U8.16 (VDD)
/Tx: R30.2, Tx.2, U3.9 (B), U8.9 (B)
/USB_LSB: R23.2, U3.10 (A), U8.10 (A), USB_LSB.2
/Vref: C4.2, C5.1, R3.2, R4.2, S3.2 (WIPER), S3.3 (CW), S4.2 (WIPER), S4.3 (CW), S5.2 (WIPER), S5.3 (CW), S6.2 (WIPER), S6.3 (CW), S7.2 (WIPER), S7.3 (CW), S8.2 (WIPER), S8.3 (CW), S9.2 (WIPER), S9.3 (CW), S10.2 (WIPER), S10.3 (CW), U2.1, U2.2 (-)
GND: Audio_In_Tx.1, Audio_Out_Rx.1, C1.2, C3.1, H1.1, H2.1, H3.1, H4.1, I_Audio_Out_Tx.1, I_Rx.1, Q_Audio_Out_Tx.1, Q_Rx.1, R23.1, R30.1, Supply.1, Tx.1, U1.4 (V-), U2.4 (V-), U2.9 (PAD), U3.6 (INH), U3.7 (VEE), U3.8 (VSS), U4.4 (V-), U5.4 (V-), U6.4 (V-), U7.4 (V-), U8.6 (INH), U8.7 (VEE), U8.8 (VSS), USB_LSB.1
unnamed: Audio_In_Tx.2, S1.2 (WIPER), S2.2 (WIPER)
unnamed: Audio_Out_Rx.2, S11.2 (WIPER), S12.2 (WIPER)
unnamed: C2.1, C4.1, C5.2, R2.2
unnamed: I_Audio_Out_Tx.2, U8.5 (Y1), U8.12 (X0)
unnamed: I_Rx.2, U3.4 (Y3), U3.15 (X2)
unnamed: Q_Audio_Out_Tx.2, U8.1 (Y0), U8.14 (X1)
unnamed: Q_Rx.2, U3.2 (Y2), U3.11 (X3)
unnamed: S1.1 (CCW), U3.5 (Y1)
unnamed: S1.3 (CW), U3.14 (X1)
unnamed: S2.1 (CCW), U3.1 (Y0)
unnamed: S2.3 (CW), U3.12 (X0)
unnamed: R7.2, S3.1 (CCW)
unnamed: R8.2, S4.1 (CCW)
unnamed: R13.2, S5.1 (CCW)
unnamed: R14.2, S6.1 (CCW)
unnamed: R19.2, S7.1 (CCW)
unnamed: R20.2, S8.1 (CCW)
unnamed: R26.2, S9.1 (CCW)
unnamed: R27.2, S10.1 (CCW)
unnamed: S11.1 (CCW), U8.15 (X2)
unnamed: S11.3 (CW), U8.2 (Y2)
unnamed: S12.1 (CCW), U8.11 (X3)
unnamed: S12.3 (CW), U8.4 (Y3)
unnamed: R3.1, U1.3 (IN+), U3.13 (X)
unnamed: C6.1, R5.1, U1.1 (OUT), U1.2 (IN-)
unnamed: R4.1, U1.5 (IN+), U3.3 (Y)
unnamed: C7.1, R6.1, U1.6 (IN-), U1.7 (OUT)
unnamed: C2.2, R1.2, R2.1, U2.3 (+)
unnamed: C6.2, R7.1, U4.3 (IN+)
unnamed: R5.2, R9.1, U4.2 (IN-)
unnamed: C8.1, R9.2, R11.1, U4.1 (OUT)
unnamed: C8.2, R13.1, U4.5 (IN+)
unnamed: R11.2, R15.1, U4.6 (IN-)
unnamed: C10.1, R15.2, R17.1, U4.7 (OUT)
unnamed: C7.2, R8.1, U5.3 (IN+)
unnamed: R6.2, R10.1, U5.2 (IN-)
unnamed: C9.1, R10.2, R12.1, U5.1 (OUT)
unnamed: C9.2, R14.1, U5.5 (IN+)
unnamed: R12.2, R16.1, U5.6 (IN-)
unnamed: C11.1, R16.2, R18.1, U5.7 (OUT)
unnamed: C10.2, R19.1, U6.3 (IN+)
unnamed: R17.2, R21.1, U6.2 (IN-)
unnamed: C12.1, R21.2, R24.1, U6.1 (OUT)
unnamed: C12.2, R26.1, U6.5 (IN+)
unnamed: R24.2, R28.1, U6.6 (IN-)
unnamed: R28.2, U6.7 (OUT), U8.13 (X)
unnamed: C11.2, R20.1, U7.3 (IN+)
unnamed: R18.2, R22.1, U7.2 (IN-)
unnamed: C13.1, R22.2, R25.1, U7.1 (OUT)
unnamed: C13.2, R27.1, U7.5 (IN+)
unnamed: R25.2, R29.1, U7.6 (IN-)
unnamed: R29.2, U7.7 (OUT), U8.3 (Y)
