HB9GZE/PhasorRadio/Code/PhasorRadio1/Core/Src/main-DESKTOP-51J4P00.c

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
/* Includes ------------------------------------------------------------------*/
#include "main.h"
#include "cmsis_os.h"
#include "libjpeg.h"
#include "app_touchgfx.h"

/* USER CODE BEGIN Includes */
#include "stm32h735g_discovery_ospi.h"
#include "stm32h7xx_hal_ospi.h"
#include "si5351.h"

/* USER CODE END Includes */


CRC_HandleTypeDef hcrc;

DMA2D_HandleTypeDef hdma2d;

I2C_HandleTypeDef hi2c4;

LTDC_HandleTypeDef hltdc;

OSPI_HandleTypeDef hospi1;
OSPI_HandleTypeDef hospi2;

TIM_HandleTypeDef htim23;

/* Definitions for defaultTask */
osThreadId_t defaultTaskHandle;
const osThreadAttr_t defaultTask_attributes = {
  .name = "defaultTask",
  .stack_size = 128 * 4,
  .priority = (osPriority_t) osPriorityNormal,
};
/* Definitions for TouchGFXTask */
osThreadId_t TouchGFXTaskHandle;
const osThreadAttr_t TouchGFXTask_attributes = {
  .name = "TouchGFXTask",
  .stack_size = 1024 * 4,
  .priority = (osPriority_t) osPriorityNormal,
};
/* Definitions for videoTask */
osThreadId_t videoTaskHandle;
const osThreadAttr_t videoTask_attributes = {
  .name = "videoTask",
  .stack_size = 1024 * 4,
  .priority = (osPriority_t) osPriorityLow,
};
/* USER CODE BEGIN PV */
	uint8_t rotaryEncoderKey;
	int8_t rotaryEncoderStep;
	uint8_t rotaryEncoderEdgeCount;

	//defines
	#define INPUT_SAMPLES 2048
	#define BAND_80m 80
	#define BAND_40M 40
	#define BAND_20m 20

	//config SI5351
	uint8_t phaseOffset;
	const int32_t correction5351 = 116800;
	si5351PLLConfig_t pllConf;
	si5351OutputConfig_t outConf;

	//VFO settings
	float vfo_80m = 3573.0;
	float vfo_40m = 7074.0;
	float vfo_20m = 14074.0;
	float vfo_80m_dec = 0; //_dec for handling the fine tuning (with 1/10th decimal fraction)
	float vfo_40m_dec = 0; //_dec for handling the fine tuning (with 1/10th decimal fraction)
	float vfo_20m_dec = 0; //_dec for handling the fine tuning (with 1/10th decimal fraction)
	uint32_t vfo_80m_5351 = 3573000;
	uint32_t vfo_40m_5351 = 7074000;
	uint32_t vfo_20m_5351 = 14074000;
	uint8_t currentBand = BAND_40M;
	uint8_t VFOhasChanged = FALSE;

//	struct FreqBand
//	{
//		uint32_t frequencyValue;
//		uint8_t bandValue;
//	};
//	struct FreqBand queueUpdateValue;

	uint8_t swapIQ = 0;
	uint8_t swapIQhasChanged = 0;

	uint16_t rotaryEncoderStepSize = 1000;


/* USER CODE END PV */

void SystemClock_Config(void);
void PeriphCommonClock_Config(void);
static void MPU_Config(void);
static void MX_GPIO_Init(void);
static void MX_CRC_Init(void);
static void MX_DMA2D_Init(void);
static void MX_LTDC_Init(void);
static void MX_OCTOSPI1_Init(void);
static void MX_OCTOSPI2_Init(void);
static void MX_TIM23_Init(void);
static void MX_I2C4_Init(void);
void StartDefaultTask(void *argument);
extern void TouchGFX_Task(void *argument);
extern void videoTaskFunc(void *argument);

/* USER CODE BEGIN PFP */
void HAL_GPIO_EXTI_Callback(uint16_t GPIO_Pin);
void HAL_TIM_IC_CaptureCallback(TIM_HandleTypeDef *htim);
void newVFOFrequency();
/* USER CODE END PFP */

/* USER CODE BEGIN 0 */
void HAL_GPIO_EXTI_Callback(uint16_t GPIO_Pin)
{
  if(GPIO_Pin == GPIO_PIN_8)
  {
	if(rotaryEncoderStepSize == 1000)
		{
			rotaryEncoderStepSize = 100;
			vfo_80m_5351 = (vfo_80m_5351/100)*100;
			vfo_80m = (float)vfo_80m_5351/1000.0;
			vfo_40m_5351 = (vfo_40m_5351/100)*100;
			vfo_40m = (float)vfo_40m_5351/1000.0;
			vfo_20m_5351 = (vfo_20m_5351/100)*100;
			vfo_20m = (float)vfo_20m_5351/1000.0;
			VFOhasChanged = TRUE;
		}
	else if(rotaryEncoderStepSize == 100)
		{
			rotaryEncoderStepSize = 10;
			vfo_80m_5351 = (vfo_80m_5351/10)*10;
			vfo_80m = (float)vfo_80m_5351/1000.0;
			vfo_40m_5351 = (vfo_40m_5351/10)*10;
			vfo_40m = (float)vfo_40m_5351/1000.0;
			vfo_20m_5351 = (vfo_20m_5351/10)*10;
			vfo_20m = (float)vfo_20m_5351/1000.0;
			VFOhasChanged = TRUE;
		}
	else if(rotaryEncoderStepSize == 10)
		{
			rotaryEncoderStepSize = 1000;
			vfo_80m_5351 = (vfo_80m_5351/1000)*1000;
			vfo_80m = (float)vfo_80m_5351/1000.0;
			vfo_40m_5351 = (vfo_40m_5351/1000)*1000;
			vfo_40m = (float)vfo_40m_5351/1000.0;
			vfo_20m_5351 = (vfo_20m_5351/1000)*1000;
			vfo_20m = (float)vfo_20m_5351/1000.0;
			VFOhasChanged = TRUE;
		}
  }
}

void HAL_TIM_IC_CaptureCallback(TIM_HandleTypeDef *htim)
{
	if (__HAL_TIM_IS_TIM_COUNTING_DOWN(&htim23))
	{
		rotaryEncoderStep = -1;
		rotaryEncoderEdgeCount++;
	}
	else
	{
		rotaryEncoderStep = 1;
		rotaryEncoderEdgeCount++;
	}

	if(rotaryEncoderEdgeCount >= 2)
	{
		newVFOFrequency();
		rotaryEncoderEdgeCount = 0;
	}
}

void newVFOFrequency()
{
	if(currentBand == BAND_40M)
	{
		vfo_40m_5351 = vfo_40m_5351 + rotaryEncoderStepSize*rotaryEncoderStep;
		vfo_40m = (float)vfo_40m_5351/1000.0;
		VFOhasChanged = TRUE;
	}
}
/* USER CODE END 0 */

/**
  * @brief  The application entry point.
  * @retval int
  */
int main(void)
{

  /* MPU Configuration--------------------------------------------------------*/
  MPU_Config();

  /* Enable the CPU Cache */

  /* Enable I-Cache---------------------------------------------------------*/
  SCB_EnableICache();

  /* Enable D-Cache---------------------------------------------------------*/
  SCB_EnableDCache();

  /* MCU Configuration--------------------------------------------------------*/

  /* Reset of all peripherals, Initializes the Flash interface and the Systick. */
  HAL_Init();

  /* Configure the system clock */
  SystemClock_Config();

/* Configure the peripherals common clocks */
  PeriphCommonClock_Config();

  /* Initialize all configured peripherals */
  MX_GPIO_Init();
  MX_CRC_Init();
  MX_DMA2D_Init();
  MX_LTDC_Init();
  MX_OCTOSPI1_Init();
  MX_OCTOSPI2_Init();
  MX_LIBJPEG_Init();
  MX_TIM23_Init();
  MX_I2C4_Init();
  MX_TouchGFX_Init();
  /* Call PreOsInit function */
  MX_TouchGFX_PreOSInit();
  /* USER CODE BEGIN 2 */
  HAL_TIM_Encoder_Start_IT(&htim23, TIM_CHANNEL_ALL);

  //Start si5351
  vfo_40m_5351 = 7074000;
  //setup I/Q
  si5351_Init(correction5351);
  si5351_CalcIQ(vfo_40m_5351, &pllConf, &outConf);

  /*
   * `phaseOffset` is a 7bit value, calculated from Fpll, Fclk and desired phase shift.
   * To get N° phase shift the value should be round( (N/360)*(4*Fpll/Fclk) )
   * Two channels should use the same PLL to make it work. There are other restrictions.
   * Please see AN619 for more details.
   *
   * si5351_CalcIQ() chooses PLL and MS parameters so that:
   *   Fclk in [1.4..100] MHz
   *   out_conf.div in [9..127]
   *   out_conf.num = 0
   *   out_conf.denum = 1
   *   Fpll = out_conf.div * Fclk.
   * This automatically gives 90° phase shift between two channels if you pass
   *  0 and out_conf.div as a phaseOffset for these channels.
   */
  phaseOffset = (uint8_t) outConf.div;
  si5351_SetupOutput(0, SI5351_PLL_A, SI5351_DRIVE_STRENGTH_8MA, &outConf,0);
  si5351_SetupOutput(2, SI5351_PLL_A, SI5351_DRIVE_STRENGTH_8MA, &outConf,phaseOffset);
  /*
   * The order is important! Setup the channels first, then setup the PLL.
   * Alternatively you could reset the PLL after setting up PLL and channels.
   * However since _SetupPLL() always resets the PLL this would only cause
   * sending extra I2C commands.
   */
  	si5351_SetupPLL(SI5351_PLL_A, &pllConf);
  	si5351_EnableOutputs((1 << 0) | (1 << 2));


  /* USER CODE END 2 */

  /* Init scheduler */
  osKernelInitialize();

  /* USER CODE BEGIN RTOS_MUTEX */
  /* add mutexes, ... */
  /* USER CODE END RTOS_MUTEX */

  /* USER CODE BEGIN RTOS_SEMAPHORES */
  /* add semaphores, ... */
  /* USER CODE END RTOS_SEMAPHORES */

  /* USER CODE BEGIN RTOS_TIMERS */
  /* start timers, add new ones, ... */
  /* USER CODE END RTOS_TIMERS */

  /* USER CODE BEGIN RTOS_QUEUES */
  /* add queues, ... */
  /* USER CODE END RTOS_QUEUES */

  /* Create the thread(s) */
  /* creation of defaultTask */
  defaultTaskHandle = osThreadNew(StartDefaultTask, NULL, &defaultTask_attributes);

  /* creation of TouchGFXTask */
  TouchGFXTaskHandle = osThreadNew(TouchGFX_Task, NULL, &TouchGFXTask_attributes);

  /* creation of videoTask */
  videoTaskHandle = osThreadNew(videoTaskFunc, NULL, &videoTask_attributes);

  /* USER CODE BEGIN RTOS_THREADS */
  /* add threads, ... */
  /* USER CODE END RTOS_THREADS */

  /* USER CODE BEGIN RTOS_EVENTS */
  /* add events, ... */
  /* USER CODE END RTOS_EVENTS */

  /* Start scheduler */
  osKernelStart();

  /* We should never get here as control is now taken by the scheduler */

  /* Infinite loop */
  /* USER CODE BEGIN WHILE */
  while (1)
  {
    /* USER CODE END WHILE */

    /* USER CODE BEGIN 3 */
  }
  /* USER CODE END 3 */
}

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
/* USER CODE BEGIN Header_StartDefaultTask */
/**
  * @brief  Function implementing the defaultTask thread.
  * @param  argument: Not used
  * @retval None
  */
/* USER CODE END Header_StartDefaultTask */
void StartDefaultTask(void *argument)
{
  /* USER CODE BEGIN 5 */
  /* Infinite loop */
  for(;;)
  {
    osDelay(100);
  }
  /* USER CODE END 5 */
}

 /* MPU Configuration */

void MPU_Config(void)
{
  MPU_Region_InitTypeDef MPU_InitStruct = {0};

  /* Disables the MPU */
  HAL_MPU_Disable();

  /** Initializes and configures the Region and the memory to be protected
  */
  MPU_InitStruct.Enable = MPU_REGION_ENABLE;
  MPU_InitStruct.Number = MPU_REGION_NUMBER0;
  MPU_InitStruct.BaseAddress = 0x24000000;
  MPU_InitStruct.Size = MPU_REGION_SIZE_512KB;
  MPU_InitStruct.SubRegionDisable = 0x0;
  MPU_InitStruct.TypeExtField = MPU_TEX_LEVEL0;
  MPU_InitStruct.AccessPermission = MPU_REGION_FULL_ACCESS;
  MPU_InitStruct.DisableExec = MPU_INSTRUCTION_ACCESS_DISABLE;
  MPU_InitStruct.IsShareable = MPU_ACCESS_NOT_SHAREABLE;
  MPU_InitStruct.IsCacheable = MPU_ACCESS_CACHEABLE;
  MPU_InitStruct.IsBufferable = MPU_ACCESS_BUFFERABLE;

  HAL_MPU_ConfigRegion(&MPU_InitStruct);

  /** Initializes and configures the Region and the memory to be protected
  */
  MPU_InitStruct.Number = MPU_REGION_NUMBER1;
  MPU_InitStruct.BaseAddress = 0x70000000;
  MPU_InitStruct.Size = MPU_REGION_SIZE_512MB;
  MPU_InitStruct.AccessPermission = MPU_REGION_NO_ACCESS;
  MPU_InitStruct.IsCacheable = MPU_ACCESS_NOT_CACHEABLE;
  MPU_InitStruct.IsBufferable = MPU_ACCESS_NOT_BUFFERABLE;

  HAL_MPU_ConfigRegion(&MPU_InitStruct);

  /** Initializes and configures the Region and the memory to be protected
  */
  MPU_InitStruct.Number = MPU_REGION_NUMBER2;
  MPU_InitStruct.Size = MPU_REGION_SIZE_8MB;
  MPU_InitStruct.AccessPermission = MPU_REGION_FULL_ACCESS;
  MPU_InitStruct.IsCacheable = MPU_ACCESS_CACHEABLE;
  MPU_InitStruct.IsBufferable = MPU_ACCESS_BUFFERABLE;

  HAL_MPU_ConfigRegion(&MPU_InitStruct);

  /** Initializes and configures the Region and the memory to be protected
  */
  MPU_InitStruct.Number = MPU_REGION_NUMBER3;
  MPU_InitStruct.BaseAddress = 0x90000000;
  MPU_InitStruct.Size = MPU_REGION_SIZE_512MB;
  MPU_InitStruct.AccessPermission = MPU_REGION_NO_ACCESS;
  MPU_InitStruct.IsCacheable = MPU_ACCESS_NOT_CACHEABLE;
  MPU_InitStruct.IsBufferable = MPU_ACCESS_NOT_BUFFERABLE;

  HAL_MPU_ConfigRegion(&MPU_InitStruct);

  /** Initializes and configures the Region and the memory to be protected
  */
  MPU_InitStruct.Number = MPU_REGION_NUMBER4;
  MPU_InitStruct.Size = MPU_REGION_SIZE_64MB;
  MPU_InitStruct.AccessPermission = MPU_REGION_FULL_ACCESS;
  MPU_InitStruct.IsCacheable = MPU_ACCESS_CACHEABLE;

  HAL_MPU_ConfigRegion(&MPU_InitStruct);
  /* Enables the MPU */
  HAL_MPU_Enable(MPU_PRIVILEGED_DEFAULT);

}

/**
  * @brief  Period elapsed callback in non blocking mode
  * @note   This function is called  when TIM6 interrupt took place, inside
  * HAL_TIM_IRQHandler(). It makes a direct call to HAL_IncTick() to increment
  * a global variable "uwTick" used as application time base.
  * @param  htim : TIM handle
  * @retval None
  */
void HAL_TIM_PeriodElapsedCallback(TIM_HandleTypeDef *htim)
{
  if (htim->Instance == TIM6) {
    HAL_IncTick();
  }
}

/**
  * @brief  This function is executed in case of error occurrence.
  * @retval None
  */
void Error_Handler(void)
{
  /* USER CODE BEGIN Error_Handler_Debug */
  /* User can add his own implementation to report the HAL error return state */

  /* USER CODE END Error_Handler_Debug */
}

#ifdef  USE_FULL_ASSERT
/**
  * @brief  Reports the name of the source file and the source line number
  *         where the assert_param error has occurred.
  * @param  file: pointer to the source file name
  * @param  line: assert_param error line source number
  * @retval None
  */
void assert_failed(uint8_t *file, uint32_t line)
{
  /* USER CODE BEGIN 6 */
  /* User can add his own implementation to report the file name and line number,
     tex: printf("Wrong parameters value: file %s on line %d\r\n", file, line) */
  /* USER CODE END 6 */
}
#endif /* USE_FULL_ASSERT */
