HB9GZE/PhasorRadio/CustomSTM32H735Board/CustomSTM32H735_V2_BoardBringUp/CustomSTM32H735_V2_BoardBringUp.ioc

Mcu.UserName=STM32H735IGKx
PA0.GPIO_Label=VSYNC_FREQ
PA0.Signal=GPIO_Output
PA0_C.Signal=ADCx_INP0
PA12.GPIO_Label=LSBUSB
PA12.Signal=GPIO_Output
PA13(JTMS/SWDIO).Signal=DEBUG_JTMS-SWDIO
PA14(JTCK/SWCLK).Signal=DEBUG_JTCK-SWCLK
PA15(JTDI).Signal=S_TIM2_CH1_ETR
PA1_C.Signal=ADCx_INP1
PA3.Signal=LTDC_B5
PA4.Signal=LTDC_VSYNC
PA5.Signal=COMP_DAC12_group
PA6.Signal=LTDC_G2
PA8.Signal=LTDC_B3
PB0.Signal=LTDC_G1
PB1.Signal=LTDC_G0
PB10.Signal=I2C2_SCL
PB11.Signal=I2C2_SDA
PB12.GPIO_Label=S0
PB12.Signal=GPIO_Output
PB13.GPIO_Label=S1
PB13.Signal=GPIO_Output
PB14.GPIO_Label=FRAME_RATE
PB14.Signal=GPIO_Output
PB15.GPIO_Label=MCU_ACTIVE
PB15.Signal=GPIO_Output
PB2.Signal=OCTOSPIM_P1_DQS
PB3(JTDO/TRACESWO).Signal=S_TIM2_CH2
PB8.Signal=LTDC_B6
PB9.Signal=LTDC_B7
PC13.GPIO_Label=GPIO_PC13
PC13.Signal=GPIO_Output
PC2_C.Signal=ADC3_INP0
PC4.Signal=OPAMP1_VOUT
PC6.Signal=LTDC_HSYNC
PC7.Signal=LTDC_G6
PC9.Signal=I2C3_SDA
PD0.Signal=LTDC_B1
PD1.Signal=UART4_TX
PD10.GPIO_Label=LCD_DISP
PD10.Signal=GPIO_Output
PD11.Signal=OCTOSPIM_P1_IO0
PD12.Signal=OCTOSPIM_P1_IO1
PD13.Signal=OCTOSPIM_P1_IO3
PD3.Signal=LTDC_G7
PD4.Signal=OCTOSPIM_P1_IO4
PD5.Signal=OCTOSPIM_P1_IO5
PD6.Signal=LTDC_B2
PD7.Signal=OCTOSPIM_P1_IO7
PE0.Signal=LTDC_R0
PE1.Signal=LTDC_R6
PE11.Signal=LTDC_G3
PE12.Signal=LTDC_B4
PE13.Signal=LTDC_DE
PE15.Signal=LTDC_R7
PE2.Signal=OCTOSPIM_P1_IO2
PE4.GPIO_Label=GPIO_PE4
PE4.Signal=GPIO_Output
PF0.Signal=OCTOSPIM_P2_IO0
PF1.Signal=OCTOSPIM_P2_IO1
PF10.Signal=OCTOSPIM_P1_CLK
PF12.Signal=OCTOSPIM_P2_DQS
PF14.Signal=I2C4_SCL
PF15.Signal=I2C4_SDA
PF2.Signal=OCTOSPIM_P2_IO2
PF3.Signal=OCTOSPIM_P2_IO3
PF4.Signal=OCTOSPIM_P2_CLK
PF6.Signal=TIM23_CH1
PG0.Signal=OCTOSPIM_P2_IO4
PG1.Signal=OCTOSPIM_P2_IO5
PG10.Signal=OCTOSPIM_P2_IO6
PG11.Signal=OCTOSPIM_P2_IO7
PG12.Signal=OCTOSPIM_P2_NCS
PG13.Signal=S_TIM23_CH2
PG14.Signal=LTDC_B0
PG15.GPIO_Label=LCD_BL_CTRL
PG15.Signal=GPIO_Output
PG2.GPIO_Label=CTP_INT
PG2.Signal=GPXTI2
PG3.GPIO_Label=RENDER_TIME
PG3.Signal=GPIO_Output
PG5.GPIO_Label=RXTX
PG5.Signal=GPIO_Output
PG6.Signal=OCTOSPIM_P1_NCS
PG7.Signal=LTDC_CLK
PG9.Signal=OCTOSPIM_P1_IO6
PH0-OSC_IN.Signal=RCC_OSC_IN
PH1-OSC_OUT.Signal=RCC_OSC_OUT
PH10.Signal=LTDC_R4
PH11.Signal=LTDC_R5
PH12.GPIO_Label=NRXTX
PH12.Signal=GPIO_Output
PH14.Signal=UART4_RX
PH15.Signal=LTDC_G4
PH3.Signal=LTDC_R1
PH4.Signal=LTDC_G5
PH6.GPIO_Label=LCD_RST
PH6.Signal=GPIO_Output
PH7.Signal=I2C3_SCL
PH8.Signal=LTDC_R2
PH9.Signal=LTDC_R3
