HB9GZE/PhasorRadio/Code/PhasorRadio1/Core/Src/main.c

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
/* Includes ------------------------------------------------------------------*/
#include "main.h"
#include "cmsis_os.h"

/* USER CODE BEGIN Includes */
#include "stm32h735g_discovery_ospi.h"
#include "stm32h7xx_hal_ospi.h"
#include "si5351.h"
#include "semphr.h"
#include "stdio.h"
#include <math.h>
#include <string.h> //for memcpy
#include "arm_math.h"
#include  "arm_const_structs.h"
#include "string.h"
/* USER CODE END Includes */

/* USER CODE BEGIN PD */
#ifndef FALSE     /* in case these macros already exist */
#define FALSE 0   /* values of boolean */
#endif
#ifndef TRUE
#define TRUE  1
#endif
#define INPUT_SAMPLES 2048
#define BAND_80M 80
#define BAND_40M 40
#define BAND_20M 20
#define N 1024
#define halfN 512
/* USER CODE END PD */

ADC_HandleTypeDef hadc1;
ADC_HandleTypeDef hadc2;
ADC_HandleTypeDef hadc3;
DMA_HandleTypeDef hdma_adc1;
DMA_HandleTypeDef hdma_adc3;

CRC_HandleTypeDef hcrc;

DAC_HandleTypeDef hdac1;
DMA_HandleTypeDef hdma_dac1_ch2;
DMA_HandleTypeDef hdma_dac1_ch1;

DMA2D_HandleTypeDef hdma2d;

I2C_HandleTypeDef hi2c3;
I2C_HandleTypeDef hi2c4;

LTDC_HandleTypeDef hltdc;

OSPI_HandleTypeDef hospi1;
OSPI_HandleTypeDef hospi2;

OPAMP_HandleTypeDef hopamp1;

TIM_HandleTypeDef htim1;
TIM_HandleTypeDef htim8;
TIM_HandleTypeDef htim23;

UART_HandleTypeDef huart4;
DMA_HandleTypeDef hdma_uart4_tx;

/* Definitions for defaultTask */
osThreadId_t defaultTaskHandle;
const osThreadAttr_t defaultTask_attributes = {
  .name = "defaultTask",
  .stack_size = 128 * 4,
  .priority = (osPriority_t) osPriorityNormal,
};
/* Definitions for TouchGFXTask */
osThreadId_t TouchGFXTaskHandle;
const osThreadAttr_t TouchGFXTask_attributes = {
  .name = "TouchGFXTask",
  .stack_size = 4096 * 4,
  .priority = (osPriority_t) osPriorityAboveNormal,
};
/* Definitions for myTaskToGUI */
osThreadId_t myTaskToGUIHandle;
const osThreadAttr_t myTaskToGUI_attributes = {
  .name = "myTaskToGUI",
  .stack_size = 1024 * 4,
  .priority = (osPriority_t) osPriorityNormal,
};
/* Definitions for myTaskFromGui */
osThreadId_t myTaskFromGuiHandle;
const osThreadAttr_t myTaskFromGui_attributes = {
  .name = "myTaskFromGui",
  .stack_size = 1024 * 4,
  .priority = (osPriority_t) osPriorityNormal,
};
/* Definitions for myTaskFFT */
osThreadId_t myTaskFFTHandle;
const osThreadAttr_t myTaskFFT_attributes = {
  .name = "myTaskFFT",
  .stack_size = 1024 * 4,
  .priority = (osPriority_t) osPriorityNormal,
};
/* Definitions for sMeterQueue */
osMessageQueueId_t sMeterQueueHandle;
const osMessageQueueAttr_t sMeterQueue_attributes = {
  .name = "sMeterQueue"
};
/* Definitions for vfoQueue */
osMessageQueueId_t vfoQueueHandle;
const osMessageQueueAttr_t vfoQueue_attributes = {
  .name = "vfoQueue"
};
/* Definitions for dynGraphQueue */
osMessageQueueId_t dynGraphQueueHandle;
const osMessageQueueAttr_t dynGraphQueue_attributes = {
  .name = "dynGraphQueue"
};
/* USER CODE BEGIN PV */

//config SI5351
uint8_t phaseOffset;
const int32_t correction = 0; //the higher the correction, the lower the frequency
si5351PLLConfig_t pllConf;
si5351OutputConfig_t outConf;

//VFO settings
float vfo_80m = 3573.0;
float vfo_40m = 7074.0;
float vfo_20m = 14074.0;
uint32_t vfo_80m_5351 = 14292000; // 3573 * 4
uint32_t vfo_40m_5351 = 28296000; // 7074 * 4
uint32_t vfo_20m_5351 = 56296000; // 14074 * 4
uint8_t VFOhasChangedforDisplay;
uint8_t VFOhasChangedforSI5351;
uint8_t vfoDataHasChanged;
uint8_t sMeterDataHasChanged;
uint8_t stateRXTX = 0; //0 = RX
uint8_t stateBand = 40;
uint8_t oldStateBand = 80;
uint8_t stateLSBUSB = 0; // 0 = LSB
uint8_t lastStateLSBUSB;
uint8_t stateWFBW;
uint8_t graphHasBeenDisplayed = TRUE;
uint16_t stateStepSize = 1000;
uint16_t oldStateStepSize = 1000;
uint8_t rotaryEncoderCounter;
int8_t rotaryEncoderValue;
uint8_t readyToSendI2C;
uint8_t startTimerA;
//FFT
uint32_t adcDualInputBuffer[INPUT_SAMPLES];
uint16_t fftComplexIntBuffer[2 * INPUT_SAMPLES];
float32_t fftComplexFloatBuffer[2 * INPUT_SAMPLES], fftOutputComplexMagnitudeBuffer[INPUT_SAMPLES], fftAdjustedMagnitudeBuffer[INPUT_SAMPLES];
float32_t hanningWIN[INPUT_SAMPLES];
uint16_t sMeterAverageValue[10];
uint16_t sMeterValue;
uint16_t oldSMeterValue;
uint8_t adcBusy;
int dynamicGraphValue[341];
typedef struct
{
	int dynGraphData[341];
} QueueElement;
QueueElement data;
//FIR Filter
static __attribute__((section(".dma_d2_ram")))              uint32_t adc_buffer[N];
static __attribute__((section(".dma_d2_ram")))              uint32_t dac_buffer[N];
arm_fir_instance_f32 hfir1;
/*
 FIR filter designed with
 http://t-filter.appspot.com
 sampling frequency: 20000 Hz
 * 0 Hz - 100 Hz
 gain = 0
 desired attenuation = -40 dB
 actual attenuation = -40.270726051530076 dB
 * 300 Hz - 2700 Hz
 gain = 1
 desired ripple = 5 dB
 actual ripple = 4.043050053059676 dB
 * 3000 Hz - 10000 Hz
 gain = 0
 desired attenuation = -40 dB
 actual attenuation = -40.270726051530076 dB
 */
#define NUMTAPS 97
static float firCoeffs[NUMTAPS] =
{ 0.012769514333719499, 0.020973834882091962, 0.028874521637622972, 0.029991425180399253, 0.02213273885096896, 0.007458782068239298, -0.00803564611010692,
		-0.017533371313481125, -0.017314509945221098, -0.009076143258431202, 0.000980350030886717, 0.005947040085129794, 0.0025852942268030812,
		-0.006626585453575818, -0.015261552416455196, -0.017427494274900448, -0.011930674657531254, -0.003188889999436202, 0.0018712064266435623,
		-0.0011464849809721697, -0.010736489497829009, -0.020358508657039386, -0.023110156872070554, -0.016932634324272985, -0.006490208620054855,
		-0.00008547223103041866, -0.003570933310554045, -0.015639604444601156, -0.028195627715378323, -0.03196468029312489, -0.02354556395174,
		-0.008668172830036899, 0.0012147789741296178, -0.0028682231172246966, -0.020108962210129772, -0.039199259139890114, -0.045584622187188666,
		-0.0322779767186321, -0.006588926160231194, 0.01289283740133544, 0.008383431238342945, -0.02325547444547269, -0.06450979440519578, -0.0844827318658846,
		-0.05654782818513388, 0.023768124278818328, 0.1320661908087461, 0.2248605638281399, 0.26132186259945783, 0.2248605638281399, 0.1320661908087461,
		0.023768124278818328, -0.05654782818513388, -0.0844827318658846, -0.06450979440519578, -0.02325547444547269, 0.008383431238342945, 0.01289283740133544,
		-0.006588926160231194, -0.0322779767186321, -0.045584622187188666, -0.039199259139890114, -0.020108962210129772, -0.0028682231172246966,
		0.0012147789741296178, -0.008668172830036899, -0.02354556395174, -0.03196468029312489, -0.028195627715378323, -0.015639604444601156,
		-0.003570933310554045, -0.00008547223103041866, -0.006490208620054855, -0.016932634324272985, -0.023110156872070554, -0.020358508657039386,
		-0.010736489497829009, -0.0011464849809721697, 0.0018712064266435623, -0.003188889999436202, -0.011930674657531254, -0.017427494274900448,
		-0.015261552416455196, -0.006626585453575818, 0.0025852942268030812, 0.005947040085129794, 0.000980350030886717, -0.009076143258431202,
		-0.017314509945221098, -0.017533371313481125, -0.00803564611010692, 0.007458782068239298, 0.02213273885096896, 0.029991425180399253,
		0.028874521637622972, 0.020973834882091962, 0.012769514333719499 };
float firState[NUMTAPS + halfN - 1]; //size of number of taps + blockSize -1
static __attribute__((section(".dma_d2_ram"))) float fir_input_buffer[halfN];
static __attribute__((section(".dma_d2_ram"))) float fir_output_buffer[halfN];
uint16_t uart4Counter = 0;

/* USER CODE END PV */

void SystemClock_Config(void);
void PeriphCommonClock_Config(void);
static void MPU_Config(void);
static void MX_GPIO_Init(void);
static void MX_DMA_Init(void);
static void MX_DMA2D_Init(void);
static void MX_OCTOSPI1_Init(void);
static void MX_OCTOSPI2_Init(void);
static void MX_TIM23_Init(void);
static void MX_I2C4_Init(void);
static void MX_LTDC_Init(void);
static void MX_ADC1_Init(void);
static void MX_CRC_Init(void);
static void MX_TIM1_Init(void);
static void MX_I2C3_Init(void);
static void MX_ADC2_Init(void);
static void MX_ADC3_Init(void);
static void MX_TIM8_Init(void);
static void MX_DAC1_Init(void);
static void MX_OPAMP1_Init(void);
static void MX_UART4_Init(void);
void StartDefaultTask(void *argument);
extern void TouchGFX_Task(void *argument);
void StartTaskToGui(void *argument);
void StartTaskFromGui(void *argument);
void StartTaskFFT(void *argument);

/* USER CODE BEGIN PFP */
void HAL_TIM_IC_CaptureCallback(TIM_HandleTypeDef *htim);
void sendDatatoSI5351(void);
void HAL_ADC_ConvCpltCallback(ADC_HandleTypeDef *hadc);
void HAL_ADC_ConvHalfCpltCallback(ADC_HandleTypeDef *hadc);
/* USER CODE END PFP */

/* USER CODE BEGIN 0 */
void stepSizeChanged()
{
	if (stateStepSize == 1000)
	{
		switch (stateBand)
		{
		case BAND_80M:
			vfo_80m_5351 = (vfo_80m_5351 / 1000) * 1000;
			vfo_80m = (float) (vfo_80m_5351) / 4000.0;
			break;
		case BAND_40M:
			vfo_40m_5351 = (vfo_40m_5351 / 1000) * 1000;
			vfo_40m = (float) (vfo_40m_5351) / 4000.0;
			break;
		case BAND_20M:
			vfo_20m_5351 = (vfo_20m_5351 / 1000) * 1000;
			vfo_20m = (float) (vfo_20m_5351) / 4000.0;
			break;
		}
	}
	else if (stateStepSize == 100)
	{
		switch (stateBand)
		{
		case BAND_80M:
			vfo_80m_5351 = (vfo_80m_5351 / 100) * 100;
			vfo_80m = (float) (vfo_80m_5351) / 4000.0;
			break;
		case BAND_40M:
			vfo_40m_5351 = (vfo_40m_5351 / 100) * 100;
			vfo_40m = (float) (vfo_40m_5351) / 4000.0;
			break;
		case BAND_20M:
			vfo_20m_5351 = (vfo_20m_5351 / 100) * 100;
			vfo_20m = (float) (vfo_20m_5351) / 4000.0;
			break;
		}
	}
	else if (stateStepSize == 10)
	{
		switch (stateBand)
		{
		case BAND_80M:
			vfo_80m_5351 = (vfo_80m_5351 / 10) * 10;
			vfo_80m = (float) (vfo_80m_5351) / 4000.0;
			break;
		case BAND_40M:
			vfo_40m_5351 = (vfo_40m_5351 / 10) * 10;
			vfo_40m = (float) (vfo_40m_5351) / 4000.0;
			break;
		case BAND_20M:
			vfo_20m_5351 = (vfo_20m_5351 / 10) * 10;
			vfo_20m = (float) (vfo_20m_5351) / 4000.0;
			break;
		}
	}
}
void HAL_TIM_IC_CaptureCallback(TIM_HandleTypeDef *htim)
{
	if (htim == &htim23)
	{
		rotaryEncoderCounter++;
		if (rotaryEncoderCounter == 2)
		{
			vfoDataHasChanged = TRUE;

			if (__HAL_TIM_IS_TIM_COUNTING_DOWN(&htim23))
			{
				switch (stateBand)
				{
				case BAND_80M:
					vfo_80m_5351 = vfo_80m_5351 - (4 * stateStepSize);
					break;
				case BAND_40M:
					vfo_40m_5351 = vfo_40m_5351 - (4 * stateStepSize);
					break;
				case BAND_20M:
					vfo_20m_5351 = vfo_20m_5351 - (4 * stateStepSize);
					break;
				}
				VFOhasChangedforSI5351 = TRUE;
				VFOhasChangedforDisplay = TRUE;
				sendDatatoSI5351();
			}
			else
			{
				switch (stateBand)
				{
				case BAND_80M:
					vfo_80m_5351 = vfo_80m_5351 + (4 * stateStepSize);
					break;
				case BAND_40M:
					vfo_40m_5351 = vfo_40m_5351 + (4 * stateStepSize);
					break;
				case BAND_20M:
					vfo_20m_5351 = vfo_20m_5351 + (4 * stateStepSize);
					break;
				}
				VFOhasChangedforSI5351 = TRUE;
				VFOhasChangedforDisplay = TRUE;
				sendDatatoSI5351();
			}

			switch (stateBand)
			{
			case BAND_80M:
				vfo_80m = ((float) (vfo_80m_5351)) / 4000.0;
				break;
			case BAND_40M:
				vfo_40m = ((float) (vfo_40m_5351)) / 4000.0;
				break;
			case BAND_20M:
				vfo_20m = ((float) (vfo_20m_5351)) / 4000.0;
				break;
			}
			rotaryEncoderCounter = 0;
		}
	}
}

void sendDatatoSI5351(void)
{
	if (VFOhasChangedforSI5351 == TRUE)
	{
		switch (stateBand)
		{
		case BAND_80M:
			si5351_Calc(vfo_80m_5351, &pllConf, &outConf);
			break;
		case BAND_40M:
			si5351_Calc(vfo_40m_5351, &pllConf, &outConf);
			break;
		case BAND_20M:
			si5351_Calc(vfo_20m_5351, &pllConf, &outConf);
			break;
		}
		si5351_SetupOutput(0, SI5351_PLL_A, SI5351_DRIVE_STRENGTH_6MA, &outConf, 0);
		si5351_SetupPLL_No_Reset(SI5351_PLL_A, &pllConf);
		VFOhasChangedforSI5351 = FALSE;
	}
}

void HAL_ADC_ConvCpltCallback(ADC_HandleTypeDef *hadc)
{
	if (hadc == &hadc1)
	{
		uint16_t j = 0;
		for (uint16_t i = 0; i < 2 * INPUT_SAMPLES; i++)
		{
			if (i % 2 == 0)
			{
				fftComplexIntBuffer[i] = adcDualInputBuffer[j]; //real vector, I
			}
			else
			{
				fftComplexIntBuffer[i] = (adcDualInputBuffer[j] >> 16); //imaginary vector, Q
				j++;
			}
		}
		adcBusy = FALSE;
	}
	if (hadc == &hadc3)
	{
		for (int i = halfN; i < N; i++)
		{
			fir_input_buffer[i - halfN] = (float) adc_buffer[i];
		}

		arm_fir_f32(&hfir1, fir_input_buffer, fir_output_buffer, halfN);

		for (int i = halfN; i < N; i++)
		{
			dac_buffer[i] = (uint32_t) (fir_output_buffer[i - halfN] + 2048.0);
		}
	}
}
void HAL_ADC_ConvHalfCpltCallback(ADC_HandleTypeDef *hadc)
{
	if (hadc == &hadc3)
	{
		for (int i = 0; i < halfN; i++)
		{
			fir_input_buffer[i] = (float) adc_buffer[i];
		}

		arm_fir_f32(&hfir1, fir_input_buffer, fir_output_buffer, halfN);

		for (int i = 0; i < halfN; i++)
		{
			dac_buffer[i] = (uint32_t) (fir_output_buffer[i] + 2048.0);
		}
	}
}

void SendDatatoUART(float inputData[INPUT_SAMPLES])
{
	uart4Counter++;
	if (uart4Counter == 50)
	{
		uint8_t transmitData[(2 * INPUT_SAMPLES)];
		float maxValue = inputData[0];
		float scaler = 0;
		for (uint16_t i = 1; i < INPUT_SAMPLES; i++)
		{
			if (inputData[i] > maxValue)
			{
				maxValue = inputData[i];
			}
		}
		scaler = 255 / maxValue;
		for (uint16_t i = 0; i < (2 * INPUT_SAMPLES); i++)
		{
			if (i % 2 == 0)
			{
				transmitData[i] = (uint8_t) (inputData[i] * scaler);
			}
			else
			{
				transmitData[i] = 0x0d; //CR, \r
			}
		}
		//transmitData[4095] = 0x0d; //CR, \r

		HAL_UART_Transmit_DMA(&huart4, transmitData, 2 * INPUT_SAMPLES);
		uart4Counter = 0;
	}
}

/* USER CODE END 0 */

/**
  * @brief  The application entry point.
  * @retval int
  */
int main(void)
{

  /* MPU Configuration--------------------------------------------------------*/
  MPU_Config();

  /* Enable the CPU Cache */

  /* Enable I-Cache---------------------------------------------------------*/
  SCB_EnableICache();

  /* Enable D-Cache---------------------------------------------------------*/
  SCB_EnableDCache();

  /* MCU Configuration--------------------------------------------------------*/

  /* Reset of all peripherals, Initializes the Flash interface and the Systick. */
  HAL_Init();

  /* Configure the system clock */
  SystemClock_Config();

  /* Configure the peripherals common clocks */
  PeriphCommonClock_Config();

  /* Initialize all configured peripherals */
  MX_GPIO_Init();
  MX_DMA_Init();
  MX_DMA2D_Init();
  MX_OCTOSPI1_Init();
  MX_OCTOSPI2_Init();
  MX_TIM23_Init();
  MX_I2C4_Init();
  MX_LTDC_Init();
  MX_ADC1_Init();
  MX_CRC_Init();
  MX_TIM1_Init();
  MX_I2C3_Init();
  MX_ADC2_Init();
  MX_ADC3_Init();
  MX_TIM8_Init();
  MX_DAC1_Init();
  MX_OPAMP1_Init();
  MX_UART4_Init();
  /* USER CODE BEGIN 2 */
	HAL_TIM_Encoder_Start_IT(&htim23, TIM_CHANNEL_ALL);
	HAL_ADCEx_Calibration_Start(&hadc1, ADC_CALIB_OFFSET, ADC_SINGLE_ENDED);
	HAL_ADCEx_Calibration_Start(&hadc2, ADC_CALIB_OFFSET, ADC_SINGLE_ENDED);

	HAL_TIM_Base_Start(&htim1);
	HAL_ADCEx_MultiModeStart_DMA(&hadc1, adcDualInputBuffer, INPUT_SAMPLES);

	for (uint16_t i = 0; i < INPUT_SAMPLES; i++)
	{
		hanningWIN[i] = 0.5 - (0.5 * cos((2.0 * PI * i) / (INPUT_SAMPLES - 1)));
	}

	oldStateBand = stateBand = 40;
	vfo_40m_5351 = 28296000;
	HAL_GPIO_WritePin(GPIOB, GPIO_PIN_12, GPIO_PIN_SET); //set input bandpass to 40m
	HAL_GPIO_WritePin(GPIOB, GPIO_PIN_13, GPIO_PIN_RESET); //set input bandpass to 40m
	HAL_GPIO_WritePin(GPIOA, GPIO_PIN_12, GPIO_PIN_RESET); //LSB
	HAL_GPIO_WritePin(GPIOG, GPIO_PIN_5, GPIO_PIN_SET); //no TX
	HAL_GPIO_WritePin(GPIOH, GPIO_PIN_12, GPIO_PIN_RESET); //no Tx
	si5351_Init(correction);
	si5351_Calc(vfo_40m_5351, &pllConf, &outConf);
	si5351_SetupOutput(0, SI5351_PLL_A, SI5351_DRIVE_STRENGTH_6MA, &outConf, 0);
	si5351_SetupPLL(SI5351_PLL_A, &pllConf);
	si5351_EnableOutputs(1 << 0);

	HAL_TIM_Base_Start(&htim8);
	HAL_ADCEx_Calibration_Start(&hadc3, ADC_CALIB_OFFSET, ADC_SINGLE_ENDED);
	HAL_ADC_Start_DMA(&hadc3, adc_buffer, N);
	HAL_DAC_Start_DMA(&hdac1, DAC_CHANNEL_1, dac_buffer, N, DAC_ALIGN_12B_R);
	HAL_DAC_Start_DMA(&hdac1, DAC_CHANNEL_2, dac_buffer, N, DAC_ALIGN_12B_R);
	HAL_OPAMP_Start(&hopamp1);
//HAL_DAC_Start(&hdac1, DAC_CHANNEL_2);
//HAL_DAC_SetValue(&hdac1, DAC_CHANNEL_2, DAC_ALIGN_12B_R, 0x800);// 0x800 = 2048dec = 1/2 of 12bit
	arm_fir_init_f32(&hfir1, NUMTAPS, firCoeffs, firState, halfN);

  /* USER CODE END 2 */

  /* Init scheduler */
  osKernelInitialize();

  /* USER CODE BEGIN RTOS_MUTEX */
	/* add mutexes, ... */
  /* USER CODE END RTOS_MUTEX */

  /* USER CODE BEGIN RTOS_SEMAPHORES */
	/* add semaphores, ... */
  /* USER CODE END RTOS_SEMAPHORES */

  /* USER CODE BEGIN RTOS_TIMERS */
	/* start timers, add new ones, ... */
  /* USER CODE END RTOS_TIMERS */

  /* Create the queue(s) */
  /* creation of sMeterQueue */
  sMeterQueueHandle = osMessageQueueNew (1, sizeof(uint16_t), &sMeterQueue_attributes);

  /* creation of vfoQueue */
  vfoQueueHandle = osMessageQueueNew (1, sizeof(float), &vfoQueue_attributes);

  /* creation of dynGraphQueue */
  dynGraphQueueHandle = osMessageQueueNew (1, 1364, &dynGraphQueue_attributes);

  /* USER CODE BEGIN RTOS_QUEUES */
	/* add queues, ... */
  /* USER CODE END RTOS_QUEUES */

  /* Create the thread(s) */
  /* creation of defaultTask */
  defaultTaskHandle = osThreadNew(StartDefaultTask, NULL, &defaultTask_attributes);

  /* creation of TouchGFXTask */
  TouchGFXTaskHandle = osThreadNew(TouchGFX_Task, NULL, &TouchGFXTask_attributes);

  /* creation of myTaskToGUI */
  myTaskToGUIHandle = osThreadNew(StartTaskToGui, NULL, &myTaskToGUI_attributes);

  /* creation of myTaskFromGui */
  myTaskFromGuiHandle = osThreadNew(StartTaskFromGui, NULL, &myTaskFromGui_attributes);

  /* creation of myTaskFFT */
  myTaskFFTHandle = osThreadNew(StartTaskFFT, NULL, &myTaskFFT_attributes);

  /* USER CODE BEGIN RTOS_THREADS */
	/* add threads, ... */
  /* USER CODE END RTOS_THREADS */

  /* USER CODE BEGIN RTOS_EVENTS */
	/* add events, ... */
  /* USER CODE END RTOS_EVENTS */

  /* Start scheduler */
  osKernelStart();

  /* We should never get here as control is now taken by the scheduler */

  /* Infinite loop */
  /* USER CODE BEGIN WHILE */
	while (1)
	{
    /* USER CODE END WHILE */

    /* USER CODE BEGIN 3 */
	}
  /* USER CODE END 3 */
}

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
/* USER CODE BEGIN 4 */
int _write(int file, char *ptr, int len)
{
	int DataIdx;

	for (DataIdx = 0; DataIdx < len; DataIdx++)
	{
		ITM_SendChar(*ptr++);
	}
	return len;
}
/* USER CODE END 4 */

/* USER CODE BEGIN Header_StartDefaultTask */
/**
 * @brief  Function implementing the defaultTask thread.
 * @param  argument: Not used
 * @retval None
 */
/* USER CODE END Header_StartDefaultTask */
void StartDefaultTask(void *argument)
{
  /* USER CODE BEGIN 5 */
	/* Infinite loop */
	for (;;)
	{
		osDelay(50);
	}
  /* USER CODE END 5 */
}

/* USER CODE BEGIN Header_StartTaskToGui */
/**
 * @brief Function implementing the myTaskToGUI thread.
 * @param argument: Not used
 * @retval None
 */
/* USER CODE END Header_StartTaskToGui */
void StartTaskToGui(void *argument)
{
  /* USER CODE BEGIN StartTaskToGui */

	/* Infinite loop */
	for (;;)
	{
		sMeterValue = 0;
		if (stateLSBUSB == 0)
		{
			for (uint8_t i = 0; i < 15; i++)
			{
				sMeterValue = sMeterValue + dynamicGraphValue[168 - i];
			}
			sMeterValue = sMeterValue / 15;
			//printf("The S Meter Data: %d \n", sMeterValue);
		}
		else
		{
			for (uint8_t i = 0; i < 15; i++)
			{
				sMeterValue = sMeterValue + dynamicGraphValue[171 + i];
			}
			sMeterValue = sMeterValue / 15;
		}

		if (sMeterValue != oldSMeterValue)
		{
			if (osMessageQueueGetCount(sMeterQueueHandle) == 0)
				osMessageQueuePut(sMeterQueueHandle, &sMeterValue, 0U, 0);
			oldSMeterValue = sMeterValue;
		}

		if (vfoDataHasChanged == TRUE)
		{
			if (osMessageQueueGetCount(vfoQueueHandle) == 0)
			{
				if (stateBand == 80)
					osMessageQueuePut(vfoQueueHandle, &vfo_80m, 0U, 0);
				if (stateBand == 40)
					osMessageQueuePut(vfoQueueHandle, &vfo_40m, 0U, 0);
				if (stateBand == 20)
					osMessageQueuePut(vfoQueueHandle, &vfo_20m, 0U, 0);
			}
			vfoDataHasChanged = FALSE;
		}
		osDelay(100);
	}
  /* USER CODE END StartTaskToGui */
}

/* USER CODE BEGIN Header_StartTaskFromGui */
/**
 * @brief Function implementing the myTaskFromGui thread.
 * @param argument: Not used
 * @retval None
 */
/* USER CODE END Header_StartTaskFromGui */
void StartTaskFromGui(void *argument)
{
  /* USER CODE BEGIN StartTaskFromGui */
	/* Infinite loop */
	for (;;)
	{
		if (stateRXTX == FALSE)
		{
			HAL_GPIO_WritePin(GPIOG, GPIO_PIN_5, GPIO_PIN_SET);
			HAL_GPIO_WritePin(GPIOH, GPIO_PIN_12, GPIO_PIN_RESET);
		}
		else
		{
			HAL_GPIO_WritePin(GPIOG, GPIO_PIN_5, GPIO_PIN_RESET);
			HAL_GPIO_WritePin(GPIOH, GPIO_PIN_12, GPIO_PIN_SET);
		}

		if (stateLSBUSB != lastStateLSBUSB)
		{
			if (stateLSBUSB == 0)
			{
				HAL_GPIO_WritePin(GPIOA, GPIO_PIN_12, GPIO_PIN_RESET); //LSB
			}
			else
			{
				HAL_GPIO_WritePin(GPIOA, GPIO_PIN_12, GPIO_PIN_SET); //USB
			}
			lastStateLSBUSB = stateLSBUSB;
		}

		if ((oldStateBand != stateBand) && (stateBand == 20))
		{
			HAL_GPIO_WritePin(GPIOB, GPIO_PIN_12, GPIO_PIN_RESET);
			HAL_GPIO_WritePin(GPIOB, GPIO_PIN_13, GPIO_PIN_SET);
			vfoDataHasChanged = TRUE;
			VFOhasChangedforDisplay = TRUE;
			VFOhasChangedforSI5351 = TRUE;
			oldStateBand = stateBand;
			sendDatatoSI5351();
		}

		if ((oldStateBand != stateBand) && (stateBand == 40))
		{
			HAL_GPIO_WritePin(GPIOB, GPIO_PIN_12, GPIO_PIN_SET);
			HAL_GPIO_WritePin(GPIOB, GPIO_PIN_13, GPIO_PIN_RESET);
			vfoDataHasChanged = TRUE;
			VFOhasChangedforDisplay = TRUE;
			VFOhasChangedforSI5351 = TRUE;
			oldStateBand = stateBand;
			sendDatatoSI5351();
		}

		if ((oldStateBand != stateBand) && (stateBand == 80))
		{
			HAL_GPIO_WritePin(GPIOB, GPIO_PIN_12, GPIO_PIN_RESET);
			HAL_GPIO_WritePin(GPIOB, GPIO_PIN_13, GPIO_PIN_RESET);
			vfoDataHasChanged = TRUE;
			VFOhasChangedforDisplay = TRUE;
			VFOhasChangedforSI5351 = TRUE;
			oldStateBand = stateBand;
			sendDatatoSI5351();
		}

		if (oldStateStepSize != stateStepSize)
		{
			stepSizeChanged();
			vfoDataHasChanged = TRUE;
			VFOhasChangedforDisplay = TRUE;
			VFOhasChangedforSI5351 = TRUE;
			oldStateStepSize = stateStepSize;
		}
		osDelay(100);
	}
  /* USER CODE END StartTaskFromGui */
}

/* USER CODE BEGIN Header_StartTaskFFT */
/**
 * @brief Function implementing the myTaskFFT thread.
 * @param argument: Not used
 * @retval None
 */
/* USER CODE END Header_StartTaskFFT */
void StartTaskFFT(void *argument)
{
  /* USER CODE BEGIN StartTaskFFT */
	/* Infinite loop */
	for (;;)
	{
		if (adcBusy == FALSE && graphHasBeenDisplayed == TRUE)
		{

			uint16_t k = 0;
			for (uint16_t i = 0; i < 2 * INPUT_SAMPLES; i++)
			{
				if ((i % 2) == 0 && i != 0)
				{
					k++;
				}
				fftComplexFloatBuffer[i] = (fftComplexIntBuffer[i]) * 0.001 * hanningWIN[k]; //* Hanning Window and scaling
			}

			if (INPUT_SAMPLES == 2048)
			{
				arm_cfft_f32(&arm_cfft_sR_f32_len2048, fftComplexFloatBuffer, 0, 1);
			}

			arm_cmplx_mag_f32(fftComplexFloatBuffer, fftOutputComplexMagnitudeBuffer, INPUT_SAMPLES);
			SendDatatoUART(fftOutputComplexMagnitudeBuffer);
			//fftOutputComplexMagnitudeBuffer[0] = 0;
			fftOutputComplexMagnitudeBuffer[1] = 0;
			fftOutputComplexMagnitudeBuffer[2047] = 0;
			fftOutputComplexMagnitudeBuffer[2046] = 0;

			for (uint16_t i = 0; i < 1024; i++) //move the bins at the edges (upper and lower) to the middle of the array
			{
				fftAdjustedMagnitudeBuffer[i] = fftOutputComplexMagnitudeBuffer[1024 + i];
			}
			for (uint16_t i = 1024; i < 2048; i++)
			{
				fftAdjustedMagnitudeBuffer[i] = fftOutputComplexMagnitudeBuffer[i - 1024];
			}

			uint16_t j = 0;

			if (INPUT_SAMPLES == 2048 && stateWFBW == 0)
			{
				for (uint16_t i = 0; i < 2048; i += 6)
				{
					dynamicGraphValue[j] = (int) ((fftAdjustedMagnitudeBuffer[i] + fftAdjustedMagnitudeBuffer[i + 1] + fftAdjustedMagnitudeBuffer[i + 2]
							+ fftAdjustedMagnitudeBuffer[i + 3] + fftAdjustedMagnitudeBuffer[i + 4] + fftAdjustedMagnitudeBuffer[i + 5]) / 6);
					if (dynamicGraphValue[j] > 50)
						dynamicGraphValue[j] = 50;
					j++;
				}
			}

			if (INPUT_SAMPLES == 2048 && stateWFBW == 1) //16k BW
			{
				for (uint16_t i = 342; i < 1707; i += 4)
				{
					dynamicGraphValue[j] = (int) ((fftAdjustedMagnitudeBuffer[i] + fftAdjustedMagnitudeBuffer[i + 1] + fftAdjustedMagnitudeBuffer[i + 2]
							+ fftAdjustedMagnitudeBuffer[i + 3]) / 4);
					if (dynamicGraphValue[j] > 50)
						dynamicGraphValue[j] = 50;
					j++;
				}
			}

			if (INPUT_SAMPLES == 2048 && stateWFBW == 2)
			{
				for (uint16_t i = 683; i < 1366; i += 2)
				{
					dynamicGraphValue[j] = (int) ((fftAdjustedMagnitudeBuffer[i] + fftAdjustedMagnitudeBuffer[i + 1]) / 2);
					if (dynamicGraphValue[j] > 50)
						dynamicGraphValue[j] = 50;
					j++;
				}
			}

			if (INPUT_SAMPLES == 2048 && stateWFBW == 3) //16k BW
			{
				for (uint16_t i = 854; i < 1196; i++)
				{
					dynamicGraphValue[j] = (int) fftAdjustedMagnitudeBuffer[i];
					if (dynamicGraphValue[j] > 50)
						dynamicGraphValue[j] = 50;
					j++;
				}
			}

			memcpy(data.dynGraphData, dynamicGraphValue, sizeof(dynamicGraphValue));

			if (osMessageQueueGetCount(dynGraphQueueHandle) == 0)
				osMessageQueuePut(dynGraphQueueHandle, &data, 0U, 0);

			HAL_ADCEx_MultiModeStart_DMA(&hadc1, adcDualInputBuffer, INPUT_SAMPLES);
			adcBusy = TRUE;
			graphHasBeenDisplayed = FALSE;
		}

		osDelay(30);
	}
  /* USER CODE END StartTaskFFT */
}

 /* MPU Configuration */

void MPU_Config(void)
{
  MPU_Region_InitTypeDef MPU_InitStruct = {0};

  /* Disables the MPU */
  HAL_MPU_Disable();

  /** Initializes and configures the Region and the memory to be protected
  */
  MPU_InitStruct.Enable = MPU_REGION_ENABLE;
  MPU_InitStruct.Number = MPU_REGION_NUMBER0;
  MPU_InitStruct.BaseAddress = 0x24000000;
  MPU_InitStruct.Size = MPU_REGION_SIZE_512KB;
  MPU_InitStruct.SubRegionDisable = 0x0;
  MPU_InitStruct.TypeExtField = MPU_TEX_LEVEL0;
  MPU_InitStruct.AccessPermission = MPU_REGION_FULL_ACCESS;
  MPU_InitStruct.DisableExec = MPU_INSTRUCTION_ACCESS_DISABLE;
  MPU_InitStruct.IsShareable = MPU_ACCESS_NOT_SHAREABLE;
  MPU_InitStruct.IsCacheable = MPU_ACCESS_CACHEABLE;
  MPU_InitStruct.IsBufferable = MPU_ACCESS_BUFFERABLE;

  HAL_MPU_ConfigRegion(&MPU_InitStruct);

  /** Initializes and configures the Region and the memory to be protected
  */
  MPU_InitStruct.Number = MPU_REGION_NUMBER1;
  MPU_InitStruct.BaseAddress = 0x70000000;
  MPU_InitStruct.Size = MPU_REGION_SIZE_512MB;
  MPU_InitStruct.AccessPermission = MPU_REGION_NO_ACCESS;
  MPU_InitStruct.IsCacheable = MPU_ACCESS_NOT_CACHEABLE;
  MPU_InitStruct.IsBufferable = MPU_ACCESS_NOT_BUFFERABLE;

  HAL_MPU_ConfigRegion(&MPU_InitStruct);

  /** Initializes and configures the Region and the memory to be protected
  */
  MPU_InitStruct.Number = MPU_REGION_NUMBER2;
  MPU_InitStruct.Size = MPU_REGION_SIZE_8MB;
  MPU_InitStruct.AccessPermission = MPU_REGION_FULL_ACCESS;
  MPU_InitStruct.IsCacheable = MPU_ACCESS_CACHEABLE;
  MPU_InitStruct.IsBufferable = MPU_ACCESS_BUFFERABLE;

  HAL_MPU_ConfigRegion(&MPU_InitStruct);

  /** Initializes and configures the Region and the memory to be protected
  */
  MPU_InitStruct.Number = MPU_REGION_NUMBER3;
  MPU_InitStruct.BaseAddress = 0x90000000;
  MPU_InitStruct.Size = MPU_REGION_SIZE_512MB;
  MPU_InitStruct.AccessPermission = MPU_REGION_NO_ACCESS;
  MPU_InitStruct.IsCacheable = MPU_ACCESS_NOT_CACHEABLE;
  MPU_InitStruct.IsBufferable = MPU_ACCESS_NOT_BUFFERABLE;

  HAL_MPU_ConfigRegion(&MPU_InitStruct);

  /** Initializes and configures the Region and the memory to be protected
  */
  MPU_InitStruct.Number = MPU_REGION_NUMBER4;
  MPU_InitStruct.Size = MPU_REGION_SIZE_64MB;
  MPU_InitStruct.AccessPermission = MPU_REGION_FULL_ACCESS;
  MPU_InitStruct.IsCacheable = MPU_ACCESS_CACHEABLE;

  HAL_MPU_ConfigRegion(&MPU_InitStruct);
  /* Enables the MPU */
  HAL_MPU_Enable(MPU_PRIVILEGED_DEFAULT);

}

/**
  * @brief  Period elapsed callback in non blocking mode
  * @note   This function is called  when TIM6 interrupt took place, inside
  * HAL_TIM_IRQHandler(). It makes a direct call to HAL_IncTick() to increment
  * a global variable "uwTick" used as application time base.
  * @param  htim : TIM handle
  * @retval None
  */
void HAL_TIM_PeriodElapsedCallback(TIM_HandleTypeDef *htim)
{
  /* USER CODE BEGIN Callback 0 */
	if (htim->Instance == TIM6)
	{
		//readyToSendI2C = FALSE;
	}
  /* USER CODE END Callback 0 */
  if (htim->Instance == TIM6) {
    HAL_IncTick();
  }
}

/**
  * @brief  This function is executed in case of error occurrence.
  * @retval None
  */
void Error_Handler(void)
{
  /* USER CODE BEGIN Error_Handler_Debug */
	/* User can add his own implementation to report the HAL error return state */

  /* USER CODE END Error_Handler_Debug */
}

#ifdef  USE_FULL_ASSERT
/**
  * @brief  Reports the name of the source file and the source line number
  *         where the assert_param error has occurred.
  * @param  file: pointer to the source file name
  * @param  line: assert_param error line source number
  * @retval None
  */
void assert_failed(uint8_t *file, uint32_t line)
{
  /* USER CODE BEGIN 6 */
  /* User can add his own implementation to report the file name and line number,
     tex: printf("Wrong parameters value: file %s on line %d\r\n", file, line) */
  /* USER CODE END 6 */
}
#endif /* USE_FULL_ASSERT */
