HB9GZE/PhasorRadio/CustomSTM32H735Board/CustomSTM32H735_V2_BoardBringUp/Core/Inc/main.h

#define GPIO_PE4_Pin GPIO_PIN_4
#define GPIO_PE4_GPIO_Port GPIOE
#define LSBUSB_Pin GPIO_PIN_12
#define LSBUSB_GPIO_Port GPIOA
#define GPIO_PC13_Pin GPIO_PIN_13
#define GPIO_PC13_GPIO_Port GPIOC
#define LCD_BL_CTRL_Pin GPIO_PIN_15
#define LCD_BL_CTRL_GPIO_Port GPIOG
#define RXTX_Pin GPIO_PIN_5
#define RXTX_GPIO_Port GPIOG
#define CTP_INT_Pin GPIO_PIN_2
#define CTP_INT_GPIO_Port GPIOG
#define RENDER_TIME_Pin GPIO_PIN_3
#define RENDER_TIME_GPIO_Port GPIOG
#define MCU_ACTIVE_Pin GPIO_PIN_15
#define MCU_ACTIVE_GPIO_Port GPIOB
#define FRAME_RATE_Pin GPIO_PIN_14
#define FRAME_RATE_GPIO_Port GPIOB
#define LCD_DISP_Pin GPIO_PIN_10
#define LCD_DISP_GPIO_Port GPIOD
#define S1_Pin GPIO_PIN_13
#define S1_GPIO_Port GPIOB
#define S0_Pin GPIO_PIN_12
#define S0_GPIO_Port GPIOB
#define NRXTX_Pin GPIO_PIN_12
#define NRXTX_GPIO_Port GPIOH
#define VSYNC_FREQ_Pin GPIO_PIN_0
#define VSYNC_FREQ_GPIO_Port GPIOA
#define LCD_RST_Pin GPIO_PIN_6
#define LCD_RST_GPIO_Port GPIOH
