HB9GZE/PhasorRadio/Code/PhasorRadio1/Core/Src/stm32h7xx_hal_msp-Omen.c

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

/* Includes ------------------------------------------------------------------*/
#include "main.h"
extern DMA_HandleTypeDef hdma_adc1;

extern DMA_HandleTypeDef hdma_adc3;

extern DMA_HandleTypeDef hdma_dac1_ch1;

/* External functions --------------------------------------------------------*/
/**
  * Initializes the Global MSP.
  */
void HAL_MspInit(void)
{

  __HAL_RCC_SYSCFG_CLK_ENABLE();

  /* System interrupt init*/
  /* PendSV_IRQn interrupt configuration */
  HAL_NVIC_SetPriority(PendSV_IRQn, 15, 0);

  /** Enable the VREF clock
  */
  __HAL_RCC_VREF_CLK_ENABLE();

  /** Disable the Internal Voltage Reference buffer
  */
  HAL_SYSCFG_DisableVREFBUF();

  /** Configure the internal voltage reference buffer high impedance mode
  */
  HAL_SYSCFG_VREFBUF_HighImpedanceConfig(SYSCFG_VREFBUF_HIGH_IMPEDANCE_ENABLE);

}

static uint32_t HAL_RCC_ADC12_CLK_ENABLED=0;

/**
* @brief ADC MSP Initialization
* This function configures the hardware resources used in this example
* @param hadc: ADC handle pointer
* @retval None
*/
void HAL_ADC_MspInit(ADC_HandleTypeDef* hadc)
{
  RCC_PeriphCLKInitTypeDef PeriphClkInitStruct = {0};
  if(hadc->Instance==ADC1)
  {
  /** Initializes the peripherals clock
  */
    PeriphClkInitStruct.PeriphClockSelection = RCC_PERIPHCLK_ADC;
    PeriphClkInitStruct.AdcClockSelection = RCC_ADCCLKSOURCE_CLKP;
    if (HAL_RCCEx_PeriphCLKConfig(&PeriphClkInitStruct) != HAL_OK)
    {
      Error_Handler();
    }

    /* Peripheral clock enable */
    HAL_RCC_ADC12_CLK_ENABLED++;
    if(HAL_RCC_ADC12_CLK_ENABLED==1){
      __HAL_RCC_ADC12_CLK_ENABLE();
    }

    __HAL_RCC_GPIOA_CLK_ENABLE();
    /**ADC1 GPIO Configuration
    PA0_C     ------> ADC1_INP0
    */
    HAL_SYSCFG_AnalogSwitchConfig(SYSCFG_SWITCH_PA0, SYSCFG_SWITCH_PA0_OPEN);

    /* ADC1 DMA Init */
    /* ADC1 Init */
    hdma_adc1.Instance = DMA1_Stream0;
    hdma_adc1.Init.Request = DMA_REQUEST_ADC1;
    hdma_adc1.Init.Direction = DMA_PERIPH_TO_MEMORY;
    hdma_adc1.Init.PeriphInc = DMA_PINC_DISABLE;
    hdma_adc1.Init.MemInc = DMA_MINC_ENABLE;
    hdma_adc1.Init.PeriphDataAlignment = DMA_PDATAALIGN_WORD;
    hdma_adc1.Init.MemDataAlignment = DMA_MDATAALIGN_WORD;
    hdma_adc1.Init.Mode = DMA_NORMAL;
    hdma_adc1.Init.Priority = DMA_PRIORITY_LOW;
    hdma_adc1.Init.FIFOMode = DMA_FIFOMODE_DISABLE;
    if (HAL_DMA_Init(&hdma_adc1) != HAL_OK)
    {
      Error_Handler();
    }

    __HAL_LINKDMA(hadc,DMA_Handle,hdma_adc1);

    /* ADC1 interrupt Init */
    HAL_NVIC_SetPriority(ADC_IRQn, 5, 0);
    HAL_NVIC_EnableIRQ(ADC_IRQn);
  }
  else if(hadc->Instance==ADC2)
  {
  /** Initializes the peripherals clock
  */
    PeriphClkInitStruct.PeriphClockSelection = RCC_PERIPHCLK_ADC;
    PeriphClkInitStruct.AdcClockSelection = RCC_ADCCLKSOURCE_CLKP;
    if (HAL_RCCEx_PeriphCLKConfig(&PeriphClkInitStruct) != HAL_OK)
    {
      Error_Handler();
    }

    /* Peripheral clock enable */
    HAL_RCC_ADC12_CLK_ENABLED++;
    if(HAL_RCC_ADC12_CLK_ENABLED==1){
      __HAL_RCC_ADC12_CLK_ENABLE();
    }

    __HAL_RCC_GPIOA_CLK_ENABLE();
    /**ADC2 GPIO Configuration
    PA1_C     ------> ADC2_INP1
    */
    HAL_SYSCFG_AnalogSwitchConfig(SYSCFG_SWITCH_PA1, SYSCFG_SWITCH_PA1_OPEN);

    /* ADC2 interrupt Init */
    HAL_NVIC_SetPriority(ADC_IRQn, 5, 0);
    HAL_NVIC_EnableIRQ(ADC_IRQn);
  }
  else if(hadc->Instance==ADC3)
  {
  /** Initializes the peripherals clock
  */
    PeriphClkInitStruct.PeriphClockSelection = RCC_PERIPHCLK_ADC;
    PeriphClkInitStruct.AdcClockSelection = RCC_ADCCLKSOURCE_CLKP;
    if (HAL_RCCEx_PeriphCLKConfig(&PeriphClkInitStruct) != HAL_OK)
    {
      Error_Handler();
    }

    /* Peripheral clock enable */
    __HAL_RCC_ADC3_CLK_ENABLE();

    __HAL_RCC_GPIOC_CLK_ENABLE();
    /**ADC3 GPIO Configuration
    PC2_C     ------> ADC3_INP0
    */
    HAL_SYSCFG_AnalogSwitchConfig(SYSCFG_SWITCH_PC2, SYSCFG_SWITCH_PC2_OPEN);

    /* ADC3 DMA Init */
    /* ADC3 Init */
    hdma_adc3.Instance = BDMA_Channel0;
    hdma_adc3.Init.Request = BDMA_REQUEST_ADC3;
    hdma_adc3.Init.Direction = DMA_PERIPH_TO_MEMORY;
    hdma_adc3.Init.PeriphInc = DMA_PINC_DISABLE;
    hdma_adc3.Init.MemInc = DMA_MINC_ENABLE;
    hdma_adc3.Init.PeriphDataAlignment = DMA_PDATAALIGN_WORD;
    hdma_adc3.Init.MemDataAlignment = DMA_MDATAALIGN_WORD;
    hdma_adc3.Init.Mode = DMA_CIRCULAR;
    hdma_adc3.Init.Priority = DMA_PRIORITY_LOW;
    if (HAL_DMA_Init(&hdma_adc3) != HAL_OK)
    {
      Error_Handler();
    }

    __HAL_LINKDMA(hadc,DMA_Handle,hdma_adc3);

  }

}

/**
* @brief ADC MSP De-Initialization
* This function freeze the hardware resources used in this example
* @param hadc: ADC handle pointer
* @retval None
*/
void HAL_ADC_MspDeInit(ADC_HandleTypeDef* hadc)
{
  if(hadc->Instance==ADC1)
  {
    /* Peripheral clock disable */
    HAL_RCC_ADC12_CLK_ENABLED--;
    if(HAL_RCC_ADC12_CLK_ENABLED==0){
      __HAL_RCC_ADC12_CLK_DISABLE();
    }

    /* ADC1 DMA DeInit */
    HAL_DMA_DeInit(hadc->DMA_Handle);

    /* ADC1 interrupt DeInit */
  /* USER CODE BEGIN ADC1:ADC_IRQn disable */
    /**
    * Uncomment the line below to disable the "ADC_IRQn" interrupt
    * Be aware, disabling shared interrupt may affect other IPs
    */
    /* HAL_NVIC_DisableIRQ(ADC_IRQn); */
  /* USER CODE END ADC1:ADC_IRQn disable */

  }
  else if(hadc->Instance==ADC2)
  {
    /* Peripheral clock disable */
    HAL_RCC_ADC12_CLK_ENABLED--;
    if(HAL_RCC_ADC12_CLK_ENABLED==0){
      __HAL_RCC_ADC12_CLK_DISABLE();
    }

    /* ADC2 interrupt DeInit */
  /* USER CODE BEGIN ADC2:ADC_IRQn disable */
    /**
    * Uncomment the line below to disable the "ADC_IRQn" interrupt
    * Be aware, disabling shared interrupt may affect other IPs
    */
    /* HAL_NVIC_DisableIRQ(ADC_IRQn); */
  /* USER CODE END ADC2:ADC_IRQn disable */

  }
  else if(hadc->Instance==ADC3)
  {
    /* Peripheral clock disable */
    __HAL_RCC_ADC3_CLK_DISABLE();

    /* ADC3 DMA DeInit */
    HAL_DMA_DeInit(hadc->DMA_Handle);
  }

}

/**
* @brief CRC MSP Initialization
* This function configures the hardware resources used in this example
* @param hcrc: CRC handle pointer
* @retval None
*/
void HAL_CRC_MspInit(CRC_HandleTypeDef* hcrc)
{
  if(hcrc->Instance==CRC)
  {
    /* Peripheral clock enable */
    __HAL_RCC_CRC_CLK_ENABLE();
  }

}

/**
* @brief CRC MSP De-Initialization
* This function freeze the hardware resources used in this example
* @param hcrc: CRC handle pointer
* @retval None
*/
void HAL_CRC_MspDeInit(CRC_HandleTypeDef* hcrc)
{
  if(hcrc->Instance==CRC)
  {
    /* Peripheral clock disable */
    __HAL_RCC_CRC_CLK_DISABLE();
  }

}

/**
* @brief DAC MSP Initialization
* This function configures the hardware resources used in this example
* @param hdac: DAC handle pointer
* @retval None
*/
void HAL_DAC_MspInit(DAC_HandleTypeDef* hdac)
{
  GPIO_InitTypeDef GPIO_InitStruct = {0};
  if(hdac->Instance==DAC1)
  {
    /* Peripheral clock enable */
    __HAL_RCC_DAC12_CLK_ENABLE();

    __HAL_RCC_GPIOA_CLK_ENABLE();
    /**DAC1 GPIO Configuration
    PA5     ------> DAC1_OUT2
    */
    GPIO_InitStruct.Pin = GPIO_PIN_5;
    GPIO_InitStruct.Mode = GPIO_MODE_ANALOG;
    GPIO_InitStruct.Pull = GPIO_NOPULL;
    HAL_GPIO_Init(GPIOA, &GPIO_InitStruct);

    /* DAC1 DMA Init */
    /* DAC1_CH1 Init */
    hdma_dac1_ch1.Instance = DMA1_Stream1;
    hdma_dac1_ch1.Init.Request = DMA_REQUEST_DAC1;
    hdma_dac1_ch1.Init.Direction = DMA_MEMORY_TO_PERIPH;
    hdma_dac1_ch1.Init.PeriphInc = DMA_PINC_DISABLE;
    hdma_dac1_ch1.Init.MemInc = DMA_MINC_ENABLE;
    hdma_dac1_ch1.Init.PeriphDataAlignment = DMA_PDATAALIGN_WORD;
    hdma_dac1_ch1.Init.MemDataAlignment = DMA_MDATAALIGN_WORD;
    hdma_dac1_ch1.Init.Mode = DMA_CIRCULAR;
    hdma_dac1_ch1.Init.Priority = DMA_PRIORITY_LOW;
    hdma_dac1_ch1.Init.FIFOMode = DMA_FIFOMODE_DISABLE;
    if (HAL_DMA_Init(&hdma_dac1_ch1) != HAL_OK)
    {
      Error_Handler();
    }

    __HAL_LINKDMA(hdac,DMA_Handle1,hdma_dac1_ch1);

    /* DAC1 interrupt Init */
    HAL_NVIC_SetPriority(TIM6_DAC_IRQn, 5, 0);
    HAL_NVIC_EnableIRQ(TIM6_DAC_IRQn);
  }

}

/**
* @brief DAC MSP De-Initialization
* This function freeze the hardware resources used in this example
* @param hdac: DAC handle pointer
* @retval None
*/
void HAL_DAC_MspDeInit(DAC_HandleTypeDef* hdac)
{
  if(hdac->Instance==DAC1)
  {
    /* Peripheral clock disable */
    __HAL_RCC_DAC12_CLK_DISABLE();

    /**DAC1 GPIO Configuration
    PA5     ------> DAC1_OUT2
    */
    HAL_GPIO_DeInit(GPIOA, GPIO_PIN_5);

    /* DAC1 DMA DeInit */
    HAL_DMA_DeInit(hdac->DMA_Handle1);

    /* DAC1 interrupt DeInit */
    HAL_NVIC_DisableIRQ(TIM6_DAC_IRQn);
  }

}

/**
* @brief DMA2D MSP Initialization
* This function configures the hardware resources used in this example
* @param hdma2d: DMA2D handle pointer
* @retval None
*/
void HAL_DMA2D_MspInit(DMA2D_HandleTypeDef* hdma2d)
{
  if(hdma2d->Instance==DMA2D)
  {
    /* Peripheral clock enable */
    __HAL_RCC_DMA2D_CLK_ENABLE();
    /* DMA2D interrupt Init */
    HAL_NVIC_SetPriority(DMA2D_IRQn, 5, 0);
    HAL_NVIC_EnableIRQ(DMA2D_IRQn);
  }

}

/**
* @brief DMA2D MSP De-Initialization
* This function freeze the hardware resources used in this example
* @param hdma2d: DMA2D handle pointer
* @retval None
*/
void HAL_DMA2D_MspDeInit(DMA2D_HandleTypeDef* hdma2d)
{
  if(hdma2d->Instance==DMA2D)
  {
    /* Peripheral clock disable */
    __HAL_RCC_DMA2D_CLK_DISABLE();

    /* DMA2D interrupt DeInit */
    HAL_NVIC_DisableIRQ(DMA2D_IRQn);
  }

}

/**
* @brief I2C MSP Initialization
* This function configures the hardware resources used in this example
* @param hi2c: I2C handle pointer
* @retval None
*/
void HAL_I2C_MspInit(I2C_HandleTypeDef* hi2c)
{
  GPIO_InitTypeDef GPIO_InitStruct = {0};
  RCC_PeriphCLKInitTypeDef PeriphClkInitStruct = {0};
  if(hi2c->Instance==I2C3)
  {
  /** Initializes the peripherals clock
  */
    PeriphClkInitStruct.PeriphClockSelection = RCC_PERIPHCLK_I2C3;
    PeriphClkInitStruct.I2c123ClockSelection = RCC_I2C1235CLKSOURCE_D2PCLK1;
    if (HAL_RCCEx_PeriphCLKConfig(&PeriphClkInitStruct) != HAL_OK)
    {
      Error_Handler();
    }

    __HAL_RCC_GPIOC_CLK_ENABLE();
    __HAL_RCC_GPIOH_CLK_ENABLE();
    /**I2C3 GPIO Configuration
    PC9     ------> I2C3_SDA
    PH7     ------> I2C3_SCL
    */
    GPIO_InitStruct.Pin = GPIO_PIN_9;
    GPIO_InitStruct.Mode = GPIO_MODE_AF_OD;
    GPIO_InitStruct.Pull = GPIO_NOPULL;
    GPIO_InitStruct.Speed = GPIO_SPEED_FREQ_LOW;
    GPIO_InitStruct.Alternate = GPIO_AF4_I2C3;
    HAL_GPIO_Init(GPIOC, &GPIO_InitStruct);

    GPIO_InitStruct.Pin = GPIO_PIN_7;
    GPIO_InitStruct.Mode = GPIO_MODE_AF_OD;
    GPIO_InitStruct.Pull = GPIO_NOPULL;
    GPIO_InitStruct.Speed = GPIO_SPEED_FREQ_LOW;
    GPIO_InitStruct.Alternate = GPIO_AF4_I2C3;
    HAL_GPIO_Init(GPIOH, &GPIO_InitStruct);

    /* Peripheral clock enable */
    __HAL_RCC_I2C3_CLK_ENABLE();
  }
  else if(hi2c->Instance==I2C4)
  {
  /** Initializes the peripherals clock
  */
    PeriphClkInitStruct.PeriphClockSelection = RCC_PERIPHCLK_I2C4;
    PeriphClkInitStruct.I2c4ClockSelection = RCC_I2C4CLKSOURCE_D3PCLK1;
    if (HAL_RCCEx_PeriphCLKConfig(&PeriphClkInitStruct) != HAL_OK)
    {
      Error_Handler();
    }

    __HAL_RCC_GPIOF_CLK_ENABLE();
    /**I2C4 GPIO Configuration
    PF15     ------> I2C4_SDA
    PF14     ------> I2C4_SCL
    */
    GPIO_InitStruct.Pin = GPIO_PIN_15|GPIO_PIN_14;
    GPIO_InitStruct.Mode = GPIO_MODE_AF_OD;
    GPIO_InitStruct.Pull = GPIO_NOPULL;
    GPIO_InitStruct.Speed = GPIO_SPEED_FREQ_LOW;
    GPIO_InitStruct.Alternate = GPIO_AF4_I2C4;
    HAL_GPIO_Init(GPIOF, &GPIO_InitStruct);

    /* Peripheral clock enable */
    __HAL_RCC_I2C4_CLK_ENABLE();
  }

}

/**
* @brief I2C MSP De-Initialization
* This function freeze the hardware resources used in this example
* @param hi2c: I2C handle pointer
* @retval None
*/
void HAL_I2C_MspDeInit(I2C_HandleTypeDef* hi2c)
{
  if(hi2c->Instance==I2C3)
  {
    /* Peripheral clock disable */
    __HAL_RCC_I2C3_CLK_DISABLE();

    /**I2C3 GPIO Configuration
    PC9     ------> I2C3_SDA
    PH7     ------> I2C3_SCL
    */
    HAL_GPIO_DeInit(GPIOC, GPIO_PIN_9);

    HAL_GPIO_DeInit(GPIOH, GPIO_PIN_7);

  }
  else if(hi2c->Instance==I2C4)
  {
    /* Peripheral clock disable */
    __HAL_RCC_I2C4_CLK_DISABLE();

    /**I2C4 GPIO Configuration
    PF15     ------> I2C4_SDA
    PF14     ------> I2C4_SCL
    */
    HAL_GPIO_DeInit(GPIOF, GPIO_PIN_15);

    HAL_GPIO_DeInit(GPIOF, GPIO_PIN_14);

  }

}

/**
* @brief LTDC MSP Initialization
* This function configures the hardware resources used in this example
* @param hltdc: LTDC handle pointer
* @retval None
*/
void HAL_LTDC_MspInit(LTDC_HandleTypeDef* hltdc)
{
  GPIO_InitTypeDef GPIO_InitStruct = {0};
  RCC_PeriphCLKInitTypeDef PeriphClkInitStruct = {0};
  if(hltdc->Instance==LTDC)
  {
  /** Initializes the peripherals clock
  */
    PeriphClkInitStruct.PeriphClockSelection = RCC_PERIPHCLK_LTDC;
    PeriphClkInitStruct.PLL3.PLL3M = 25;
    PeriphClkInitStruct.PLL3.PLL3N = 288;
    PeriphClkInitStruct.PLL3.PLL3P = 2;
    PeriphClkInitStruct.PLL3.PLL3Q = 2;
    PeriphClkInitStruct.PLL3.PLL3R = 30;
    PeriphClkInitStruct.PLL3.PLL3RGE = RCC_PLL3VCIRANGE_0;
    PeriphClkInitStruct.PLL3.PLL3VCOSEL = RCC_PLL3VCOMEDIUM;
    PeriphClkInitStruct.PLL3.PLL3FRACN = 0;
    if (HAL_RCCEx_PeriphCLKConfig(&PeriphClkInitStruct) != HAL_OK)
    {
      Error_Handler();
    }

    /* Peripheral clock enable */
    __HAL_RCC_LTDC_CLK_ENABLE();

    __HAL_RCC_GPIOB_CLK_ENABLE();
    __HAL_RCC_GPIOD_CLK_ENABLE();
    __HAL_RCC_GPIOA_CLK_ENABLE();
    __HAL_RCC_GPIOE_CLK_ENABLE();
    __HAL_RCC_GPIOG_CLK_ENABLE();
    __HAL_RCC_GPIOH_CLK_ENABLE();
    __HAL_RCC_GPIOC_CLK_ENABLE();
    /**LTDC GPIO Configuration
    PB8     ------> LTDC_B6
    PD3     ------> LTDC_G7
    PB9     ------> LTDC_B7
    PA8     ------> LTDC_B3
    PE1     ------> LTDC_R6
    PG14     ------> LTDC_B0
    PD0     ------> LTDC_B1
    PD6     ------> LTDC_B2
    PH15     ------> LTDC_G4
    PC7     ------> LTDC_G6
    PC6     ------> LTDC_HSYNC
    PG7     ------> LTDC_CLK
    PB1     ------> LTDC_G0
    PH11     ------> LTDC_R5
    PH9     ------> LTDC_R3
    PH2     ------> LTDC_R0
    PA3     ------> LTDC_B5
    PH8     ------> LTDC_R2
    PH10     ------> LTDC_R4
    PH4     ------> LTDC_G5
    PA4     ------> LTDC_VSYNC
    PE12     ------> LTDC_B4
    PE13     ------> LTDC_DE
    PE15     ------> LTDC_R7
    PH3     ------> LTDC_R1
    PA6     ------> LTDC_G2
    PB0     ------> LTDC_G1
    PE11     ------> LTDC_G3
    */
    GPIO_InitStruct.Pin = GPIO_PIN_8;
    GPIO_InitStruct.Mode = GPIO_MODE_AF_PP;
    GPIO_InitStruct.Pull = GPIO_NOPULL;
    GPIO_InitStruct.Speed = GPIO_SPEED_FREQ_LOW;
    GPIO_InitStruct.Alternate = GPIO_AF14_LTDC;
    HAL_GPIO_Init(GPIOB, &GPIO_InitStruct);

    GPIO_InitStruct.Pin = GPIO_PIN_3|GPIO_PIN_0;
    GPIO_InitStruct.Mode = GPIO_MODE_AF_PP;
    GPIO_InitStruct.Pull = GPIO_NOPULL;
    GPIO_InitStruct.Speed = GPIO_SPEED_FREQ_LOW;
    GPIO_InitStruct.Alternate = GPIO_AF14_LTDC;
    HAL_GPIO_Init(GPIOD, &GPIO_InitStruct);

    GPIO_InitStruct.Pin = GPIO_PIN_9|GPIO_PIN_1|GPIO_PIN_0;
    GPIO_InitStruct.Mode = GPIO_MODE_AF_PP;
    GPIO_InitStruct.Pull = GPIO_NOPULL;
    GPIO_InitStruct.Speed = GPIO_SPEED_FREQ_VERY_HIGH;
    GPIO_InitStruct.Alternate = GPIO_AF14_LTDC;
    HAL_GPIO_Init(GPIOB, &GPIO_InitStruct);

    GPIO_InitStruct.Pin = GPIO_PIN_8;
    GPIO_InitStruct.Mode = GPIO_MODE_AF_PP;
    GPIO_InitStruct.Pull = GPIO_NOPULL;
    GPIO_InitStruct.Speed = GPIO_SPEED_FREQ_VERY_HIGH;
    GPIO_InitStruct.Alternate = GPIO_AF13_LTDC;
    HAL_GPIO_Init(GPIOA, &GPIO_InitStruct);

    GPIO_InitStruct.Pin = GPIO_PIN_1|GPIO_PIN_12|GPIO_PIN_13|GPIO_PIN_15
                          |GPIO_PIN_11;
    GPIO_InitStruct.Mode = GPIO_MODE_AF_PP;
    GPIO_InitStruct.Pull = GPIO_NOPULL;
    GPIO_InitStruct.Speed = GPIO_SPEED_FREQ_VERY_HIGH;
    GPIO_InitStruct.Alternate = GPIO_AF14_LTDC;
    HAL_GPIO_Init(GPIOE, &GPIO_InitStruct);

    GPIO_InitStruct.Pin = GPIO_PIN_14;
    GPIO_InitStruct.Mode = GPIO_MODE_AF_PP;
    GPIO_InitStruct.Pull = GPIO_NOPULL;
    GPIO_InitStruct.Speed = GPIO_SPEED_FREQ_VERY_HIGH;
    GPIO_InitStruct.Alternate = GPIO_AF14_LTDC;
    HAL_GPIO_Init(GPIOG, &GPIO_InitStruct);

    GPIO_InitStruct.Pin = GPIO_PIN_6;
    GPIO_InitStruct.Mode = GPIO_MODE_AF_PP;
    GPIO_InitStruct.Pull = GPIO_NOPULL;
    GPIO_InitStruct.Speed = GPIO_SPEED_FREQ_VERY_HIGH;
    GPIO_InitStruct.Alternate = GPIO_AF14_LTDC;
    HAL_GPIO_Init(GPIOD, &GPIO_InitStruct);

    GPIO_InitStruct.Pin = GPIO_PIN_15|GPIO_PIN_2;
    GPIO_InitStruct.Mode = GPIO_MODE_AF_PP;
    GPIO_InitStruct.Pull = GPIO_NOPULL;
    GPIO_InitStruct.Speed = GPIO_SPEED_FREQ_LOW;
    GPIO_InitStruct.Alternate = GPIO_AF14_LTDC;
    HAL_GPIO_Init(GPIOH, &GPIO_InitStruct);

    GPIO_InitStruct.Pin = GPIO_PIN_7|GPIO_PIN_6;
    GPIO_InitStruct.Mode = GPIO_MODE_AF_PP;
    GPIO_InitStruct.Pull = GPIO_NOPULL;
    GPIO_InitStruct.Speed = GPIO_SPEED_FREQ_LOW;
    GPIO_InitStruct.Alternate = GPIO_AF14_LTDC;
    HAL_GPIO_Init(GPIOC, &GPIO_InitStruct);

    GPIO_InitStruct.Pin = GPIO_PIN_7;
    GPIO_InitStruct.Mode = GPIO_MODE_AF_PP;
    GPIO_InitStruct.Pull = GPIO_NOPULL;
    GPIO_InitStruct.Speed = GPIO_SPEED_FREQ_LOW;
    GPIO_InitStruct.Alternate = GPIO_AF14_LTDC;
    HAL_GPIO_Init(GPIOG, &GPIO_InitStruct);

    GPIO_InitStruct.Pin = GPIO_PIN_11|GPIO_PIN_9|GPIO_PIN_8|GPIO_PIN_10
                          |GPIO_PIN_3;
    GPIO_InitStruct.Mode = GPIO_MODE_AF_PP;
    GPIO_InitStruct.Pull = GPIO_NOPULL;
    GPIO_InitStruct.Speed = GPIO_SPEED_FREQ_VERY_HIGH;
    GPIO_InitStruct.Alternate = GPIO_AF14_LTDC;
    HAL_GPIO_Init(GPIOH, &GPIO_InitStruct);

    GPIO_InitStruct.Pin = GPIO_PIN_3|GPIO_PIN_4|GPIO_PIN_6;
    GPIO_InitStruct.Mode = GPIO_MODE_AF_PP;
    GPIO_InitStruct.Pull = GPIO_NOPULL;
    GPIO_InitStruct.Speed = GPIO_SPEED_FREQ_VERY_HIGH;
    GPIO_InitStruct.Alternate = GPIO_AF14_LTDC;
    HAL_GPIO_Init(GPIOA, &GPIO_InitStruct);

    GPIO_InitStruct.Pin = GPIO_PIN_4;
    GPIO_InitStruct.Mode = GPIO_MODE_AF_PP;
    GPIO_InitStruct.Pull = GPIO_NOPULL;
    GPIO_InitStruct.Speed = GPIO_SPEED_FREQ_VERY_HIGH;
    GPIO_InitStruct.Alternate = GPIO_AF9_LTDC;
    HAL_GPIO_Init(GPIOH, &GPIO_InitStruct);

    /* LTDC interrupt Init */
    HAL_NVIC_SetPriority(LTDC_IRQn, 5, 0);
    HAL_NVIC_EnableIRQ(LTDC_IRQn);
  }

}

/**
* @brief LTDC MSP De-Initialization
* This function freeze the hardware resources used in this example
* @param hltdc: LTDC handle pointer
* @retval None
*/
void HAL_LTDC_MspDeInit(LTDC_HandleTypeDef* hltdc)
{
  if(hltdc->Instance==LTDC)
  {
    /* Peripheral clock disable */
    __HAL_RCC_LTDC_CLK_DISABLE();

    /**LTDC GPIO Configuration
    PB8     ------> LTDC_B6
    PD3     ------> LTDC_G7
    PB9     ------> LTDC_B7
    PA8     ------> LTDC_B3
    PE1     ------> LTDC_R6
    PG14     ------> LTDC_B0
    PD0     ------> LTDC_B1
    PD6     ------> LTDC_B2
    PH15     ------> LTDC_G4
    PC7     ------> LTDC_G6
    PC6     ------> LTDC_HSYNC
    PG7     ------> LTDC_CLK
    PB1     ------> LTDC_G0
    PH11     ------> LTDC_R5
    PH9     ------> LTDC_R3
    PH2     ------> LTDC_R0
    PA3     ------> LTDC_B5
    PH8     ------> LTDC_R2
    PH10     ------> LTDC_R4
    PH4     ------> LTDC_G5
    PA4     ------> LTDC_VSYNC
    PE12     ------> LTDC_B4
    PE13     ------> LTDC_DE
    PE15     ------> LTDC_R7
    PH3     ------> LTDC_R1
    PA6     ------> LTDC_G2
    PB0     ------> LTDC_G1
    PE11     ------> LTDC_G3
    */
    HAL_GPIO_DeInit(GPIOB, GPIO_PIN_8|GPIO_PIN_9|GPIO_PIN_1|GPIO_PIN_0);

    HAL_GPIO_DeInit(GPIOD, GPIO_PIN_3|GPIO_PIN_0|GPIO_PIN_6);

    HAL_GPIO_DeInit(GPIOA, GPIO_PIN_8|GPIO_PIN_3|GPIO_PIN_4|GPIO_PIN_6);

    HAL_GPIO_DeInit(GPIOE, GPIO_PIN_1|GPIO_PIN_12|GPIO_PIN_13|GPIO_PIN_15
                          |GPIO_PIN_11);

    HAL_GPIO_DeInit(GPIOG, GPIO_PIN_14|GPIO_PIN_7);

    HAL_GPIO_DeInit(GPIOH, GPIO_PIN_15|GPIO_PIN_11|GPIO_PIN_9|GPIO_PIN_2
                          |GPIO_PIN_8|GPIO_PIN_10|GPIO_PIN_4|GPIO_PIN_3);

    HAL_GPIO_DeInit(GPIOC, GPIO_PIN_7|GPIO_PIN_6);

    /* LTDC interrupt DeInit */
    HAL_NVIC_DisableIRQ(LTDC_IRQn);
  }

}

static uint32_t HAL_RCC_OCTOSPIM_CLK_ENABLED=0;

/**
* @brief OSPI MSP Initialization
* This function configures the hardware resources used in this example
* @param hospi: OSPI handle pointer
* @retval None
*/
void HAL_OSPI_MspInit(OSPI_HandleTypeDef* hospi)
{
  GPIO_InitTypeDef GPIO_InitStruct = {0};
  if(hospi->Instance==OCTOSPI1)
  {
    /* Peripheral clock enable */
    HAL_RCC_OCTOSPIM_CLK_ENABLED++;
    if(HAL_RCC_OCTOSPIM_CLK_ENABLED==1){
      __HAL_RCC_OCTOSPIM_CLK_ENABLE();
    }
    __HAL_RCC_OSPI1_CLK_ENABLE();

    __HAL_RCC_GPIOG_CLK_ENABLE();
    __HAL_RCC_GPIOD_CLK_ENABLE();
    __HAL_RCC_GPIOE_CLK_ENABLE();
    __HAL_RCC_GPIOF_CLK_ENABLE();
    __HAL_RCC_GPIOB_CLK_ENABLE();
    /**OCTOSPI1 GPIO Configuration
    PG9     ------> OCTOSPIM_P1_IO6
    PD7     ------> OCTOSPIM_P1_IO7
    PD5     ------> OCTOSPIM_P1_IO5
    PE2     ------> OCTOSPIM_P1_IO2
    PD4     ------> OCTOSPIM_P1_IO4
    PG6     ------> OCTOSPIM_P1_NCS
    PD13     ------> OCTOSPIM_P1_IO3
    PD11     ------> OCTOSPIM_P1_IO0
    PD12     ------> OCTOSPIM_P1_IO1
    PF10     ------> OCTOSPIM_P1_CLK
    PB2     ------> OCTOSPIM_P1_DQS
    */
    GPIO_InitStruct.Pin = GPIO_PIN_9;
    GPIO_InitStruct.Mode = GPIO_MODE_AF_PP;
    GPIO_InitStruct.Pull = GPIO_NOPULL;
    GPIO_InitStruct.Speed = GPIO_SPEED_FREQ_VERY_HIGH;
    GPIO_InitStruct.Alternate = GPIO_AF9_OCTOSPIM_P1;
    HAL_GPIO_Init(GPIOG, &GPIO_InitStruct);

    GPIO_InitStruct.Pin = GPIO_PIN_7|GPIO_PIN_5|GPIO_PIN_4;
    GPIO_InitStruct.Mode = GPIO_MODE_AF_PP;
    GPIO_InitStruct.Pull = GPIO_NOPULL;
    GPIO_InitStruct.Speed = GPIO_SPEED_FREQ_VERY_HIGH;
    GPIO_InitStruct.Alternate = GPIO_AF10_OCTOSPIM_P1;
    HAL_GPIO_Init(GPIOD, &GPIO_InitStruct);

    GPIO_InitStruct.Pin = GPIO_PIN_2;
    GPIO_InitStruct.Mode = GPIO_MODE_AF_PP;
    GPIO_InitStruct.Pull = GPIO_NOPULL;
    GPIO_InitStruct.Speed = GPIO_SPEED_FREQ_VERY_HIGH;
    GPIO_InitStruct.Alternate = GPIO_AF9_OCTOSPIM_P1;
    HAL_GPIO_Init(GPIOE, &GPIO_InitStruct);

    GPIO_InitStruct.Pin = GPIO_PIN_6;
    GPIO_InitStruct.Mode = GPIO_MODE_AF_PP;
    GPIO_InitStruct.Pull = GPIO_NOPULL;
    GPIO_InitStruct.Speed = GPIO_SPEED_FREQ_VERY_HIGH;
    GPIO_InitStruct.Alternate = GPIO_AF10_OCTOSPIM_P1;
    HAL_GPIO_Init(GPIOG, &GPIO_InitStruct);

    GPIO_InitStruct.Pin = GPIO_PIN_13|GPIO_PIN_11|GPIO_PIN_12;
    GPIO_InitStruct.Mode = GPIO_MODE_AF_PP;
    GPIO_InitStruct.Pull = GPIO_NOPULL;
    GPIO_InitStruct.Speed = GPIO_SPEED_FREQ_VERY_HIGH;
    GPIO_InitStruct.Alternate = GPIO_AF9_OCTOSPIM_P1;
    HAL_GPIO_Init(GPIOD, &GPIO_InitStruct);

    GPIO_InitStruct.Pin = GPIO_PIN_10;
    GPIO_InitStruct.Mode = GPIO_MODE_AF_PP;
    GPIO_InitStruct.Pull = GPIO_NOPULL;
    GPIO_InitStruct.Speed = GPIO_SPEED_FREQ_VERY_HIGH;
    GPIO_InitStruct.Alternate = GPIO_AF9_OCTOSPIM_P1;
    HAL_GPIO_Init(GPIOF, &GPIO_InitStruct);

    GPIO_InitStruct.Pin = GPIO_PIN_2;
    GPIO_InitStruct.Mode = GPIO_MODE_AF_PP;
    GPIO_InitStruct.Pull = GPIO_NOPULL;
    GPIO_InitStruct.Speed = GPIO_SPEED_FREQ_VERY_HIGH;
    GPIO_InitStruct.Alternate = GPIO_AF10_OCTOSPIM_P1;
    HAL_GPIO_Init(GPIOB, &GPIO_InitStruct);

  }
  else if(hospi->Instance==OCTOSPI2)
  {
    /* Peripheral clock enable */
    HAL_RCC_OCTOSPIM_CLK_ENABLED++;
    if(HAL_RCC_OCTOSPIM_CLK_ENABLED==1){
      __HAL_RCC_OCTOSPIM_CLK_ENABLE();
    }
    __HAL_RCC_OSPI2_CLK_ENABLE();

    __HAL_RCC_GPIOG_CLK_ENABLE();
    __HAL_RCC_GPIOF_CLK_ENABLE();
    /**OCTOSPI2 GPIO Configuration
    PG11     ------> OCTOSPIM_P2_IO7
    PG10     ------> OCTOSPIM_P2_IO6
    PG12     ------> OCTOSPIM_P2_NCS
    PF1     ------> OCTOSPIM_P2_IO1
    PF0     ------> OCTOSPIM_P2_IO0
    PF2     ------> OCTOSPIM_P2_IO2
    PF4     ------> OCTOSPIM_P2_CLK
    PF3     ------> OCTOSPIM_P2_IO3
    PG1     ------> OCTOSPIM_P2_IO5
    PG0     ------> OCTOSPIM_P2_IO4
    PF12     ------> OCTOSPIM_P2_DQS
    */
    GPIO_InitStruct.Pin = GPIO_PIN_11|GPIO_PIN_1|GPIO_PIN_0;
    GPIO_InitStruct.Mode = GPIO_MODE_AF_PP;
    GPIO_InitStruct.Pull = GPIO_NOPULL;
    GPIO_InitStruct.Speed = GPIO_SPEED_FREQ_VERY_HIGH;
    GPIO_InitStruct.Alternate = GPIO_AF9_OCTOSPIM_P2;
    HAL_GPIO_Init(GPIOG, &GPIO_InitStruct);

    GPIO_InitStruct.Pin = GPIO_PIN_10|GPIO_PIN_12;
    GPIO_InitStruct.Mode = GPIO_MODE_AF_PP;
    GPIO_InitStruct.Pull = GPIO_NOPULL;
    GPIO_InitStruct.Speed = GPIO_SPEED_FREQ_VERY_HIGH;
    GPIO_InitStruct.Alternate = GPIO_AF3_OCTOSPIM_P2;
    HAL_GPIO_Init(GPIOG, &GPIO_InitStruct);

    GPIO_InitStruct.Pin = GPIO_PIN_1|GPIO_PIN_0|GPIO_PIN_2|GPIO_PIN_4
                          |GPIO_PIN_3|GPIO_PIN_12;
    GPIO_InitStruct.Mode = GPIO_MODE_AF_PP;
    GPIO_InitStruct.Pull = GPIO_NOPULL;
    GPIO_InitStruct.Speed = GPIO_SPEED_FREQ_VERY_HIGH;
    GPIO_InitStruct.Alternate = GPIO_AF9_OCTOSPIM_P2;
    HAL_GPIO_Init(GPIOF, &GPIO_InitStruct);

  }

}

/**
* @brief OSPI MSP De-Initialization
* This function freeze the hardware resources used in this example
* @param hospi: OSPI handle pointer
* @retval None
*/
void HAL_OSPI_MspDeInit(OSPI_HandleTypeDef* hospi)
{
  if(hospi->Instance==OCTOSPI1)
  {
    /* Peripheral clock disable */
    HAL_RCC_OCTOSPIM_CLK_ENABLED--;
    if(HAL_RCC_OCTOSPIM_CLK_ENABLED==0){
      __HAL_RCC_OCTOSPIM_CLK_DISABLE();
    }
    __HAL_RCC_OSPI1_CLK_DISABLE();

    /**OCTOSPI1 GPIO Configuration
    PG9     ------> OCTOSPIM_P1_IO6
    PD7     ------> OCTOSPIM_P1_IO7
    PD5     ------> OCTOSPIM_P1_IO5
    PE2     ------> OCTOSPIM_P1_IO2
    PD4     ------> OCTOSPIM_P1_IO4
    PG6     ------> OCTOSPIM_P1_NCS
    PD13     ------> OCTOSPIM_P1_IO3
    PD11     ------> OCTOSPIM_P1_IO0
    PD12     ------> OCTOSPIM_P1_IO1
    PF10     ------> OCTOSPIM_P1_CLK
    PB2     ------> OCTOSPIM_P1_DQS
    */
    HAL_GPIO_DeInit(GPIOG, GPIO_PIN_9|GPIO_PIN_6);

    HAL_GPIO_DeInit(GPIOD, GPIO_PIN_7|GPIO_PIN_5|GPIO_PIN_4|GPIO_PIN_13
                          |GPIO_PIN_11|GPIO_PIN_12);

    HAL_GPIO_DeInit(GPIOE, GPIO_PIN_2);

    HAL_GPIO_DeInit(GPIOF, GPIO_PIN_10);

    HAL_GPIO_DeInit(GPIOB, GPIO_PIN_2);

  }
  else if(hospi->Instance==OCTOSPI2)
  {
    /* Peripheral clock disable */
    HAL_RCC_OCTOSPIM_CLK_ENABLED--;
    if(HAL_RCC_OCTOSPIM_CLK_ENABLED==0){
      __HAL_RCC_OCTOSPIM_CLK_DISABLE();
    }
    __HAL_RCC_OSPI2_CLK_DISABLE();

    /**OCTOSPI2 GPIO Configuration
    PG11     ------> OCTOSPIM_P2_IO7
    PG10     ------> OCTOSPIM_P2_IO6
    PG12     ------> OCTOSPIM_P2_NCS
    PF1     ------> OCTOSPIM_P2_IO1
    PF0     ------> OCTOSPIM_P2_IO0
    PF2     ------> OCTOSPIM_P2_IO2
    PF4     ------> OCTOSPIM_P2_CLK
    PF3     ------> OCTOSPIM_P2_IO3
    PG1     ------> OCTOSPIM_P2_IO5
    PG0     ------> OCTOSPIM_P2_IO4
    PF12     ------> OCTOSPIM_P2_DQS
    */
    HAL_GPIO_DeInit(GPIOG, GPIO_PIN_11|GPIO_PIN_10|GPIO_PIN_12|GPIO_PIN_1
                          |GPIO_PIN_0);

    HAL_GPIO_DeInit(GPIOF, GPIO_PIN_1|GPIO_PIN_0|GPIO_PIN_2|GPIO_PIN_4
                          |GPIO_PIN_3|GPIO_PIN_12);

  }

}

/**
* @brief OPAMP MSP Initialization
* This function configures the hardware resources used in this example
* @param hopamp: OPAMP handle pointer
* @retval None
*/
void HAL_OPAMP_MspInit(OPAMP_HandleTypeDef* hopamp)
{
  GPIO_InitTypeDef GPIO_InitStruct = {0};
  if(hopamp->Instance==OPAMP1)
  {
    /* Peripheral clock enable */
    __HAL_RCC_OPAMP_CLK_ENABLE();

    __HAL_RCC_GPIOC_CLK_ENABLE();
    /**OPAMP1 GPIO Configuration
    PC4     ------> OPAMP1_VOUT
    */
    GPIO_InitStruct.Pin = GPIO_PIN_4;
    GPIO_InitStruct.Mode = GPIO_MODE_ANALOG;
    GPIO_InitStruct.Pull = GPIO_NOPULL;
    HAL_GPIO_Init(GPIOC, &GPIO_InitStruct);

  }

}

/**
* @brief OPAMP MSP De-Initialization
* This function freeze the hardware resources used in this example
* @param hopamp: OPAMP handle pointer
* @retval None
*/
void HAL_OPAMP_MspDeInit(OPAMP_HandleTypeDef* hopamp)
{
  if(hopamp->Instance==OPAMP1)
  {
    /* Peripheral clock disable */
    __HAL_RCC_OPAMP_CLK_DISABLE();

    /**OPAMP1 GPIO Configuration
    PC4     ------> OPAMP1_VOUT
    */
    HAL_GPIO_DeInit(GPIOC, GPIO_PIN_4);

  }

}

/**
* @brief TIM_Base MSP Initialization
* This function configures the hardware resources used in this example
* @param htim_base: TIM_Base handle pointer
* @retval None
*/
void HAL_TIM_Base_MspInit(TIM_HandleTypeDef* htim_base)
{
  if(htim_base->Instance==TIM1)
  {
    /* Peripheral clock enable */
    __HAL_RCC_TIM1_CLK_ENABLE();
  }
  else if(htim_base->Instance==TIM8)
  {
    /* Peripheral clock enable */
    __HAL_RCC_TIM8_CLK_ENABLE();
  }

}

/**
* @brief TIM_Encoder MSP Initialization
* This function configures the hardware resources used in this example
* @param htim_encoder: TIM_Encoder handle pointer
* @retval None
*/
void HAL_TIM_Encoder_MspInit(TIM_HandleTypeDef* htim_encoder)
{
  GPIO_InitTypeDef GPIO_InitStruct = {0};
  if(htim_encoder->Instance==TIM23)
  {
    /* Peripheral clock enable */
    __HAL_RCC_TIM23_CLK_ENABLE();

    __HAL_RCC_GPIOG_CLK_ENABLE();
    __HAL_RCC_GPIOF_CLK_ENABLE();
    /**TIM23 GPIO Configuration
    PG13     ------> TIM23_CH2
    PF6     ------> TIM23_CH1
    */
    GPIO_InitStruct.Pin = GPIO_PIN_13;
    GPIO_InitStruct.Mode = GPIO_MODE_AF_PP;
    GPIO_InitStruct.Pull = GPIO_NOPULL;
    GPIO_InitStruct.Speed = GPIO_SPEED_FREQ_HIGH;
    GPIO_InitStruct.Alternate = GPIO_AF13_TIM23;
    HAL_GPIO_Init(GPIOG, &GPIO_InitStruct);

    GPIO_InitStruct.Pin = GPIO_PIN_6;
    GPIO_InitStruct.Mode = GPIO_MODE_AF_PP;
    GPIO_InitStruct.Pull = GPIO_NOPULL;
    GPIO_InitStruct.Speed = GPIO_SPEED_FREQ_LOW;
    GPIO_InitStruct.Alternate = GPIO_AF13_TIM23;
    HAL_GPIO_Init(GPIOF, &GPIO_InitStruct);

    /* TIM23 interrupt Init */
    HAL_NVIC_SetPriority(TIM23_IRQn, 5, 0);
    HAL_NVIC_EnableIRQ(TIM23_IRQn);
  }

}

/**
* @brief TIM_Base MSP De-Initialization
* This function freeze the hardware resources used in this example
* @param htim_base: TIM_Base handle pointer
* @retval None
*/
void HAL_TIM_Base_MspDeInit(TIM_HandleTypeDef* htim_base)
{
  if(htim_base->Instance==TIM1)
  {
    /* Peripheral clock disable */
    __HAL_RCC_TIM1_CLK_DISABLE();
  }
  else if(htim_base->Instance==TIM8)
  {
    /* Peripheral clock disable */
    __HAL_RCC_TIM8_CLK_DISABLE();
  }

}

/**
* @brief TIM_Encoder MSP De-Initialization
* This function freeze the hardware resources used in this example
* @param htim_encoder: TIM_Encoder handle pointer
* @retval None
*/
void HAL_TIM_Encoder_MspDeInit(TIM_HandleTypeDef* htim_encoder)
{
  if(htim_encoder->Instance==TIM23)
  {
    /* Peripheral clock disable */
    __HAL_RCC_TIM23_CLK_DISABLE();

    /**TIM23 GPIO Configuration
    PG13     ------> TIM23_CH2
    PF6     ------> TIM23_CH1
    */
    HAL_GPIO_DeInit(GPIOG, GPIO_PIN_13);

    HAL_GPIO_DeInit(GPIOF, GPIO_PIN_6);

    /* TIM23 interrupt DeInit */
    HAL_NVIC_DisableIRQ(TIM23_IRQn);
  }

}
