HB9GZE/PhasorRadio/CustomSTM32H735Board/CustomBoardSTM32H735TestHW/Core/Inc/mx25lm51245g_conf.h

/**
  ******************************************************************************
  * @file    mx25lm51245g_conf.h
  * @author  MCD Application Team
  * @brief   This file contains all the description of the MX25LM51245G OSPI memory.
  ******************************************************************************
  * @attention
  *
  * <h2><center>&copy; COPYRIGHT(c) 2019 STMicroelectronics</center></h2>
  *
  * This software component is licensed by ST under BSD 3-Clause license,
  * the "License"; You may not use this file except in compliance with the
  * License. You may obtain a copy of the License at:
  *                        opensource.org/licenses/BSD-3-Clause
  *
  ******************************************************************************
  */

/* Define to prevent recursive inclusion -------------------------------------*/
#ifndef MX25LM51245G_CONF_H
#define MX25LM51245G_CONF_H

#ifdef __cplusplus
 extern "C" {
#endif

/* Includes ------------------------------------------------------------------*/
#include "stm32h7xx.h"
#include "stm32h7xx_hal.h"

/** @addtogroup BSP
  * @{
  */
#define CONF_OSPI_ODS             MX25LM51245G_CR_ODS_24   /* MX25LM51245G Output Driver Strenght         */
#define CONF_OSPI_DUMMY_CYCLES    MX25LM51245G_CR2_DC_14_CYCLES

#define DUMMY_CYCLES_READ            8U
#define DUMMY_CYCLES_READ_OCTAL      6U
#define DUMMY_CYCLES_READ_OCTAL_DTR  6U
#define DUMMY_CYCLES_REG_OCTAL       5U
#define DUMMY_CYCLES_REG_OCTAL_DTR   5U

#ifdef __cplusplus
}
#endif

#endif /* MX25LM51245G_CONF_H */

/**
  * @}
  */

/**
  * @}
  */

/**
  * @}
  */

/************************ (C) COPYRIGHT STMicroelectronics *****END OF FILE****/
