HB9GZE/PhasorRadio/(commit log)

2024-05-30 Initial Commit
    This ist the initial commit from the coder PC
    [AntennaAmp.kicad_pcb, AntennaAmp.kicad_sch, AudioPower.kicad_pcb, AudioPower.kicad_sch, BandpassFilter.kicad_pcb, BandpassFilter.kicad_sch, FreqSynth5351.kicad_pcb, FreqSynth5351.kicad_sch]
2024-05-30 added PowerAmpDesign files
2024-05-30 tried to eliminate the PLL reset and the popping noise
    Seems not to work. To get a defined phase shift between the outputs, one need this PLL resets.
    Better way: just generate one output signal and generate the quadrature signal by HW.
    [main.c, si5351.c]
2024-05-31 experiments with Si5351 to prove, that one channel operation does not need a PLL reset for frequency update
    [main.c]
2024-05-31 added custom CPU board design to this resporitory
    [CustomSTM32H735Board.kicad_pcb, CustomSTM32H735Board.kicad_sch, freerouting.dsn]
2024-05-31 Added Cube MX configuration for custom board
    Also deleted the unused i2c4 mutex
2024-06-02 Spectrum display calibrated
2024-06-05 started to assign LCD connector to STM32H735. Added NRST and Boot0 switch.
    [CustomSTM32H735Board.kicad_pcb, CustomSTM32H735Board.kicad_sch, freerouting.dsn]
2024-06-06 added VSS and VDD on custom board layout
    [CustomSTM32H735Board.kicad_sch]
2024-06-06 Added SWD pinout to custom board
2024-06-08 cleaned up repo by eliminating double STM32-DK files
    [CustomSTM32H735Board.kicad_pcb, CustomSTM32H735Board.kicad_sch]
2024-06-09 Work on layout and PCB of custom board. All connectors added. PCB size first draft.
    [CustomSTM32H735Board.kicad_pcb, CustomSTM32H735Board.kicad_sch, KiCAD_Custom_DRC_Rules_for_PCBWay.kicad_pcb, KiCAD_Custom_DRC_Rules_for_PCBWay.kicad_sch]
2024-06-09 added in MX more periferals (ADC3 and made shure, that LCD uses same ports as in DK board)
2024-06-10 more work on schematics
    [CustomSTM32H735Board.kicad_sch]
2024-06-10 new STM32H7 symbol added for custom board
2024-06-10 some KiCAD meta data only, grrrr
2024-06-10 more schematic work done: DAC output
    [CustomSTM32H735Board.kicad_sch]
2024-06-10 more KiCAD work performed
    [CustomSTM32H735Board.kicad_pcb, CustomSTM32H735Board.kicad_sch]
2024-06-11 finished schematics, check with AS performed
    [CustomSTM32H735Board.kicad_pcb, CustomSTM32H735Board.kicad_sch]
2024-06-12 Layout finished. Started with board design of custom board.
    [CustomSTM32H735Board.kicad_pcb, CustomSTM32H735Board.kicad_sch]
2024-06-13 work on layout, first possible solution
    [CustomSTM32H735Board.kicad_pcb, CustomSTM32H735Board.kicad_sch]
2024-06-14 finished PCB and ordered at AISLER
    [CustomSTM32H735Board.kicad_pcb]
2024-08-13 lots of custom board bring up stuff
2024-08-13 V2 Board added
2024-08-14 custom board V2 start
2024-08-14 created new KiCAD files for V2 board (save as)
    [CustomSTM32H735_V2_Board.kicad_pcb, CustomSTM32H735_V2_Board.kicad_sch]
2024-08-14 KiCAD V2 board progress
    [CustomSTM32H735_V2_Board.kicad_sch]
2024-08-15 new CAD model
2024-08-16 board schematics V2 checked and final
    [CustomSTM32H735_V2_Board.kicad_pcb, CustomSTM32H735_V2_Board.kicad_sch]
2024-08-22 Final 6 Layer Board
    [BOM CustomSTM32H735_V2_1.xlsx, CustomSTM32H735_V2_1_Board.csv, CustomSTM32H735_V2_1_Board.kicad_pcb, CustomSTM32H735_V2_1_Board.kicad_sch, CustomSTM32H735_V2_Board.kicad_pcb, NetReport.csv, freerouting.dsn, temp-freerouting.dsn]
2024-08-26 finished v2.1 and send off to JLCPCB
    [CustomSTM32H735_V2_1_Board.kicad_pcb, bom.csv, designators.csv, positions.csv]
2024-09-21 update only
    [Mixer.kicad_pcb, Mixer.kicad_sch]
2024-11-06 old code updated for new custom hardware. Second I2C added just for Si5351.
2024-11-06 player arround with i2c3 speed. Stayed at 100kHz. But maybe a Si5151 Task would be nice to delay the Si5351 update a bit.
2024-11-07 added 74AC74 at mixer board
    [Mixer.kicad_pcb, Mixer.kicad_sch]
2024-11-08 tweeking the SDC conversion...
    [Mixer.kicad_pcb, Mixer.kicad_sch]
2024-11-09 minior KiCAD Mixer
2024-11-10 after ADC repair
2024-11-11 fixed bandswitch "snedDatoToSI5351" was missing
    [PowerAmp.kicad_sch]
2024-11-11 more work on new Mixer
    [Mixer.kicad_pcb, Mixer.kicad_sch]
2024-11-11 added ti mixer board
    [Mixer.kicad_pcb, Mixer.kicad_sch]
2024-11-20 started digital filter messed around with Si5351 together with 74AC74
    [DigiAudio.kicad_pcb, DigiAudio.kicad_sch]
2024-11-21 started design mixer2 with Si5351 on board
    [Mixer2.kicad_pcb, Mixer2.kicad_sch]
2024-11-22 final mixer2 board
    [Mixer2.kicad_pcb, Mixer2.kicad_sch, bom.csv, designators.csv, positions.csv]
2024-12-01 Very fianl Version 1.0 working well
    [Mixer2.kicad_sch]
2024-12-02 ready to implement FIR filter
2024-12-03 FIR filter implemented
    [CustomSTM32H735_V2_1_Board.kicad_sch]
2024-12-06 implemented UART for scope debug
2024-12-08 more UART debugging
