HB9GZE/PhasorRadio/(notices)

Notices in the files:
CustomSTM32H735Board/GT911RockTechDriver/GT911/gt9xx_v2.8.0.2/reference driver/gt9xx.h:
This program is free software; you can redistribute it and/or modify
it under the terms of the GNU General Public License as published by
the Free Software Foundation; either version 2 of the License, or
(at your option) any later version.
CustomSTM32H735Board/CustomSTM32H735_V2_BoardBringUp/Core/Inc/main.h:
Copyright (c) 2024 STMicroelectronics.
All rights reserved.
This software is licensed under terms that can be found in the LICENSE file
Code/PhasorRadio1/Core/Src/main-DESKTOP-51J4P00.c:
© Copyright (c) 2020 STMicroelectronics.
This software component is licensed by ST under Ultimate Liberty license
